azonenberg/latentpacket/README.md

# latentpacket
The LATENTPACKET network infrastructure platform
