azonenberg/latentpacket/latentpink/pcb/qdr-matching.ods

Sheet: Traces
Signal | Loc | Grp | Pkg Avg | Len Inner | Len Outer | V1-3 | V1-6 | V1-8 | Trace | Via | Total | Target | Skew | Tolerance | OK? | Target Inner | Target Outer
A0 | M20 | CA | 74.81 |  | 47.18 |  |  | 2 | 290.16 | 23.40 | 388.36 | 388.38 | -0.02 | 50.00 | Y | 47.18 | 47.18 | Max CA/D | 402.91
A1 | N20 | CA | 76.03 |  | 46.98 |  |  | 2 | 288.93 | 23.40 | 388.36 | 388.38 | -0.02 | 50.00 | Y | 46.98 | 46.98 | Max Q | 435.49
A10 | G20 | CA | 92.63 |  | 44.28 |  |  | 2 | 272.32 | 23.40 | 388.35 | 388.38 | -0.03 | 50.00 | Y | 44.28 | 44.28
A11 | H22 | CA | 96.02 |  | 47.54 |  |  |  | 292.37 | 0.00 | 388.39 | 388.38 | 0.01 | 50.00 | Y | 47.54 | 47.54 | Min CA/D | 379.97
A12 | G21 | CA | 98.68 |  | 43.37 |  |  | 2 | 266.73 | 23.40 | 388.81 | 388.38 | 0.43 | 50.00 | Y | 43.31 | 43.30 | Min Q | 411.64
A13 | E21 | CA | 103.40 |  | 42.55 |  |  | 2 | 261.68 | 23.40 | 388.48 | 388.38 | 0.10 | 50.00 | Y | 42.53 | 42.53
A14 | F20 | CA | 104.35 |  | 41.66 |  |  | 2 | 256.21 | 23.40 | 383.95 | 388.38 | -4.43 | 50.00 | Y | 42.33 | 42.38 | Mid CA/D | 391.44
A15 | E22 | CA | 109.89 |  | 41.36 |  |  | 2 | 254.36 | 23.40 | 387.66 | 388.38 | -0.72 | 50.00 | Y | 41.47 | 41.48 | Mid Q | 409.03
A16 | F21 | CA | 98.40 |  | 43.38 |  |  | 2 | 266.79 | 23.40 | 388.59 | 388.38 | 0.21 | 50.00 | Y | 43.35 | 43.35
A17 | G22 | CA | 102.04 |  | 46.56 |  |  |  | 286.34 | 0.00 | 388.39 | 388.38 | 0.01 | 50.00 | Y | 46.56 | 46.56 | Target CA | 388.38
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
Q7 | Y21 | Q | 108.06 |  | 50.82 |  |  |  | 312.54 | 0.00 | 420.60 | 420.61 | -0.01 | 15.00 | Y | 50.82 | 50.82
Q8 | AA20 | Q | 115.01 |  | 49.69 |  |  |  | 305.59 | 0.00 | 420.60 | 420.61 | -0.01 | 15.00 | Y | 49.69 | 49.69
Q9 | A19 | Q | 116.06 | 43.87 |  | 2 |  |  | 289.54 | 15.00 | 420.60 | 420.61 | -0.01 | 15.00 | Y | 43.87 | 43.87
QVLD | H20 | Q | 83.67 |  | 50.97 |  |  | 2 | 313.47 | 23.40 | 420.53 | 420.61 | -0.08 | 15.00 | Y | 50.98 | 50.98

Sheet: Constants
Outer ps/mm | 6.15
Inner ps/mm | 6.60
V1-3 ps | 7.50
V1-6 ps | 11.10
V1-8 ps | 11.70
V3-6 ps
V3-8 ps | 11.10
V6-8 ps | 7.50
CA tolerance | 50.00
DQ tolerance | 15.00
