azonenberg/latentpacket/latentred/doc/area-budgeting.ods

Block | Count | LUT | FF | BRAM | Total LUT | Total FF | Total BRAM | Notes | Resource | Used | Avail | Utilization
MACAddressTable | 1 | 1751 | 1186 | 32 | 1751 | 1186 | 32 |  | LUT | 87132 | 101400 | 85.93%
Ethernet2TypeDecoder | 28 | 94 | 461 | 0 | 2632 | 12908 | 0 |  | FF | 61559 | 202800 | 30.35%
SGMIIToGMIIBridge | 24 | 373 | 381 | 0 | 8952 | 9144 | 0 | No CDR logic included, assumes RX clock | BRAM | 256 | 325 | 78.77%
TriSpeedEthernetMAC | 24 | 761 | 505 | 0 | 18264 | 12120 | 0 | Lots of LUTs used in tx_fifo, can this be fixed?
XGEthernetMAC | 4 | 713 | 334 | 0 | 2852 | 1336 | 0 | Might need updating
XGEthernetPCS | 4 | 446 | 503 | 0 | 1784 | 2012 | 0 | Might need updating
RxFifo (1G BRAM based) | 24 | 232 | 637 | 6 | 5568 | 15288 | 144 | Will be converted to use QDR-II+ in the future
RxFIFO (1G QDR based) | 1 |  |  |  | 0 | 0 | 0
RxFifo (10G) | 4 | 241 | 665 | 20 | 964 | 2660 | 80
SwitchFabric | 1 | 44352 | 4675 | 0 | 44352 | 4675 | 0
QDR2PController | 1 | 13 | 230 | 0 | 13 | 230 | 0
