azonenberg/latentpacket/(threads)

Thread 2 (2019-08-18):

Add LEDs to the line card

mjgerm, 2019-08-18:
LEDs could be used for activity/link lights, vlan indicators, service/patch panel indicators, and more.  Adding a row of 8x RGB LEDs to the bottom of the line card

The SX1509 chip has LED drivers, as discussed, and supports blinking/breathing effects.

The Wurth Electronics 155124M173200 is a good side-mounted LED, which could be placed right on the edge of the board, mitigating the need for light-pipes.

mjgerm, 2019-08-18:
For 8x RGB LEDs, we need 24 pins, which means at least 2 16x GPIO expanders.
Therefore, there's 8 spares - might want to attach these to the PHYs RESET pins.

Note that not all IO pins on the SX1509 are created equal, only half support the "breathing" effect.
