azonenberg/latentpacket/latentpink/pcb/latentpink.kicad_pcb

## KiCad design latentpink/pcb/latentpink.kicad_pcb (2023-06-05)

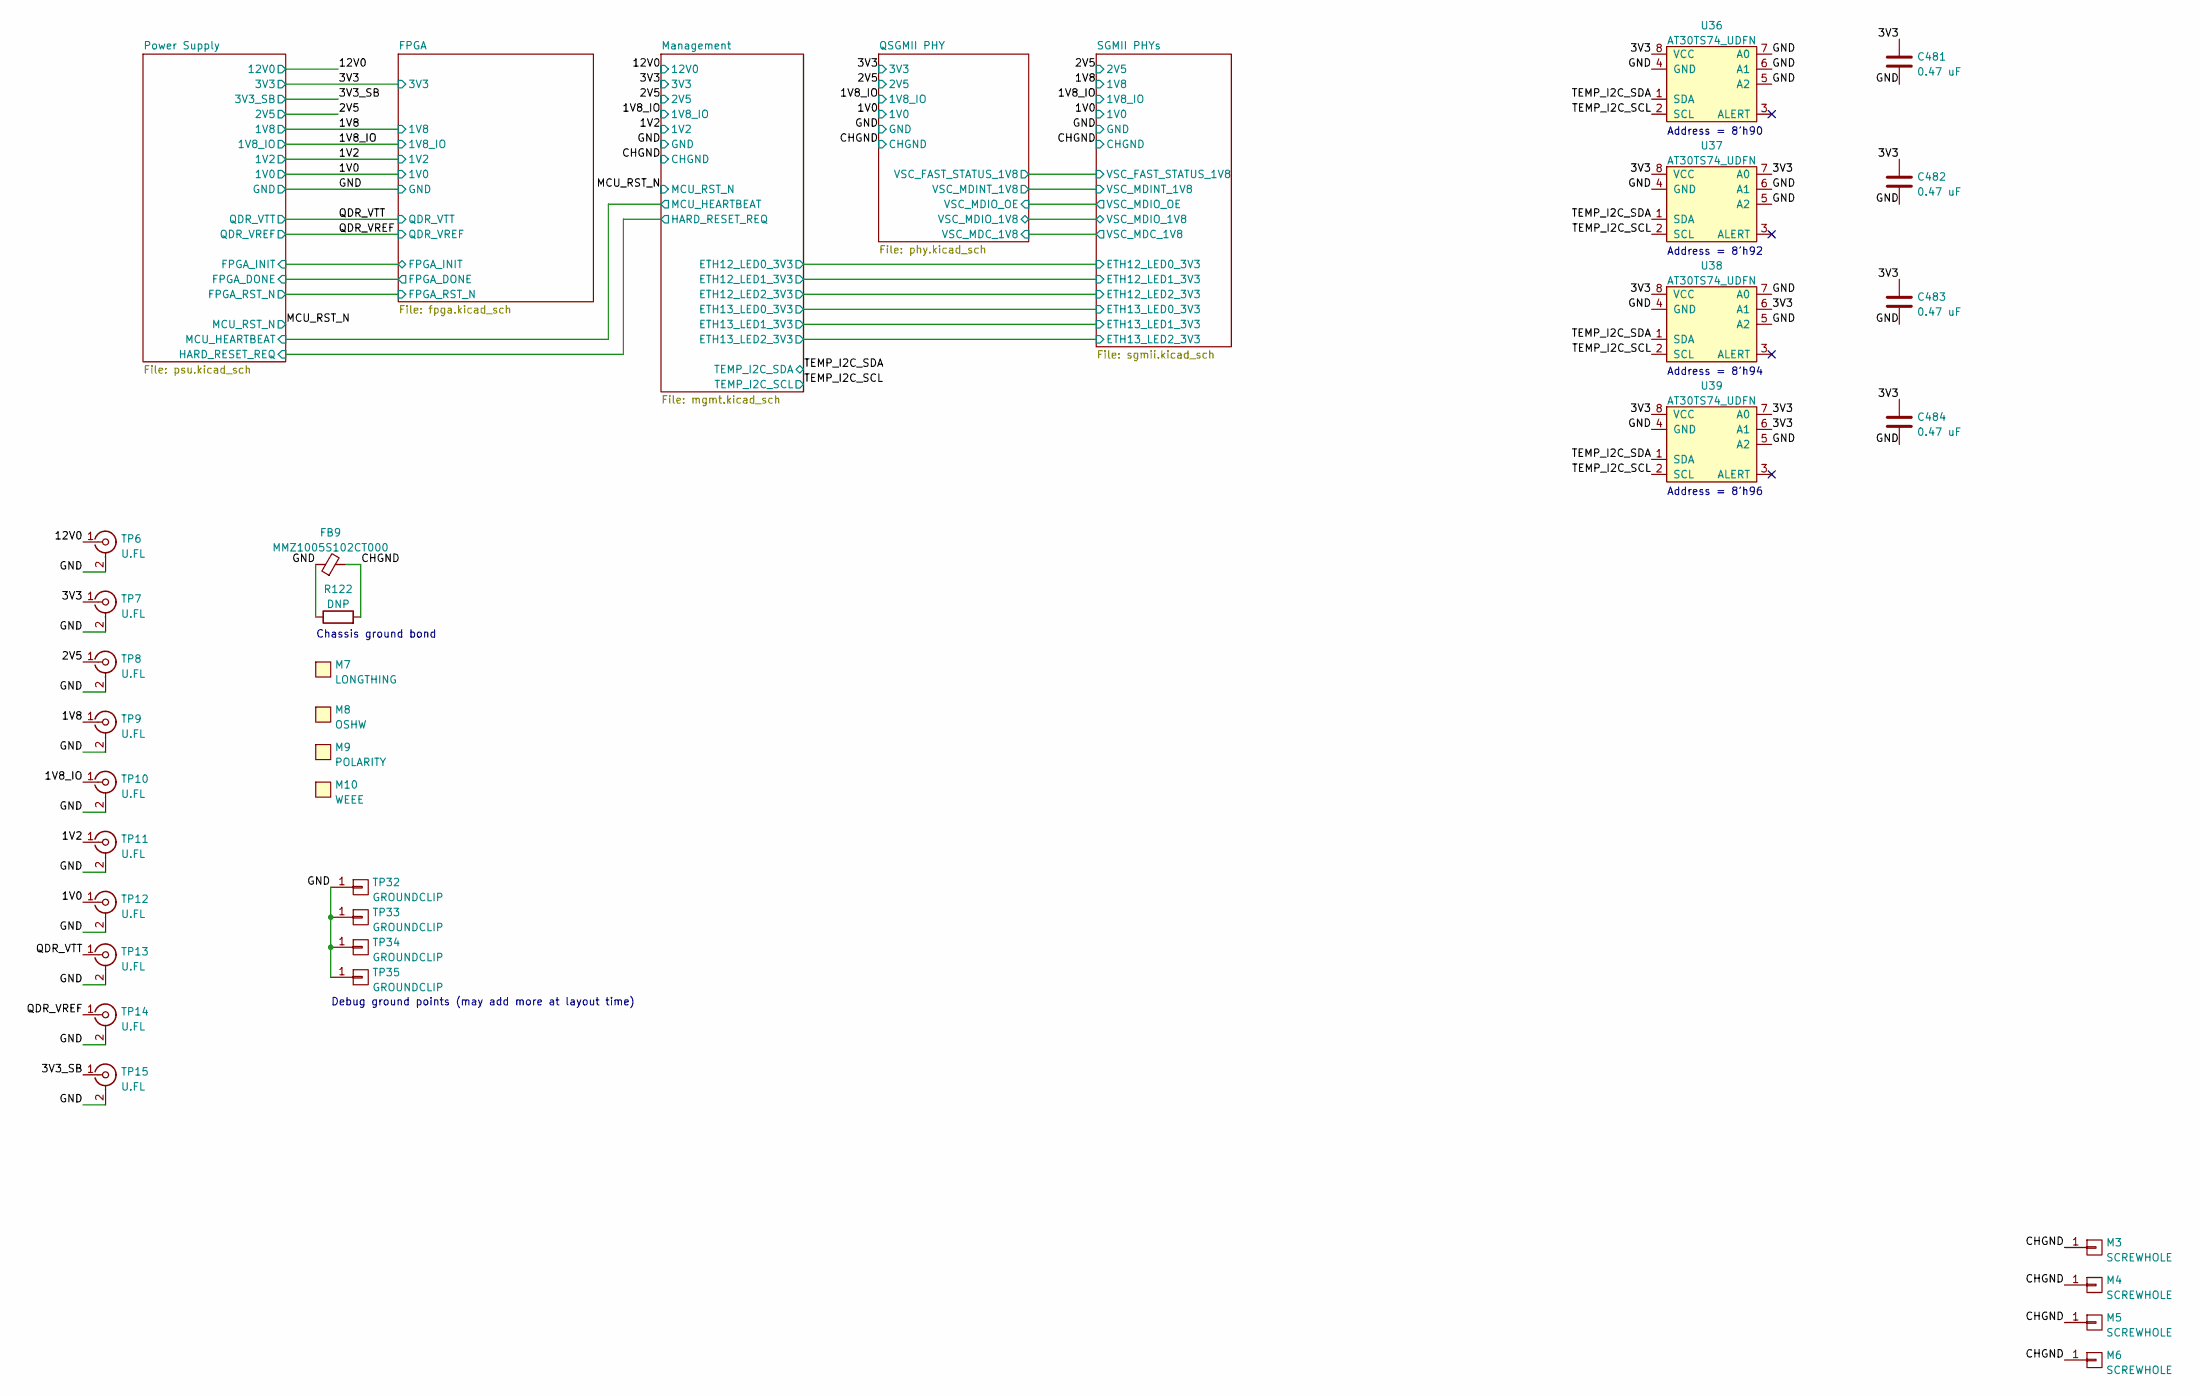
[picture p1: schematic latentpink.kicad_sch, LATENTPINK - Top Level]

Parts:
C481, C482, C483, C484: 0.47 uF; EIA_0402_CAP_NOSILK
FB9: MMZ1005S102CT000; EIA_0402_CAP_NOSILK
M3, M4, M5, M6: SCREWHOLE; MECHANICAL_CLEARANCEHOLE_4_40
M7: LONGTHING; LONGTHING-1200DPI
M8: OSHW; Logo_silk_OSHW_6x6mm
M9: POLARITY; Logo_silk_polarity_center_5x1.4mm
M10: WEEE; Logo_silk_WEEE_3.4x5mm
R122: DNP; EIA_1206_CAP_NOSILK
TP6, TP7, TP8, TP9, TP10, TP11, TP12, TP13, TP14, TP15: U.FL; CONN_U.FL_TE_1909763-1
TP32, TP33, TP34, TP35: GROUNDCLIP; TESTPOINT_SMT_KEYSTONE_5016
U36, U37, U38, U39: AT30TS74_UDFN; DFN_8_0.5MM_2x3MM_TALL

Connections:
/1V0: TP12.1 (In); also elsewhere on the board
/1V2: TP11.1 (In); also elsewhere on the board
/1V8: TP9.1 (In); also elsewhere on the board
/1V8_IO: TP10.1 (In); also elsewhere on the board
/2V5: TP8.1 (In); also elsewhere on the board
/3V3: C481.1, C482.1, C483.1, C484.1, TP7.1 (In), U36.8 (VCC), U37.7 (A0), U37.8 (VCC), U38.6 (A1), U38.8 (VCC), U39.6 (A1), U39.7 (A0), U39.8 (VCC); also elsewhere on the board
/3V3_SB: TP15.1 (In); also elsewhere on the board
/12V0: TP6.1 (In); also elsewhere on the board
/CHGND: FB9.2, M3.1, M4.1, M5.1, M6.1, R122.2; also elsewhere on the board
/GND: C481.2, C482.2, C483.2, C484.2, FB9.1, R122.1, TP6.2 (Ext), TP7.2 (Ext), TP8.2 (Ext), TP9.2 (Ext), TP10.2 (Ext), TP11.2 (Ext), TP12.2 (Ext), TP13.2 (Ext), TP14.2 (Ext), TP15.2 (Ext), TP32.1, TP33.1, TP34.1, TP35.1, U36.4 (GND), U36.5 (A2), U36.6 (A1), U36.7 (A0), U37.4 (GND), U37.5 (A2), U37.6 (A1), U38.4 (GND), U38.5 (A2), U38.7 (A0), U39.4 (GND), U39.5 (A2); also elsewhere on the board
/QDR_VREF: TP14.1 (In); also elsewhere on the board
/QDR_VTT: TP13.1 (In); also elsewhere on the board
/TEMP_I2C_SCL: U36.2 (SCL), U37.2 (SCL), U38.2 (SCL), U39.2 (SCL); also elsewhere on the board
/TEMP_I2C_SDA: U36.1 (SDA), U37.1 (SDA), U38.1 (SDA), U39.1 (SDA); also elsewhere on the board

Notes on the sheet:
Address = 8'h90
Chassis ground bond
Address = 8'h94
Address = 8'h92
Address = 8'h96
Debug ground points (may add more at layout time)

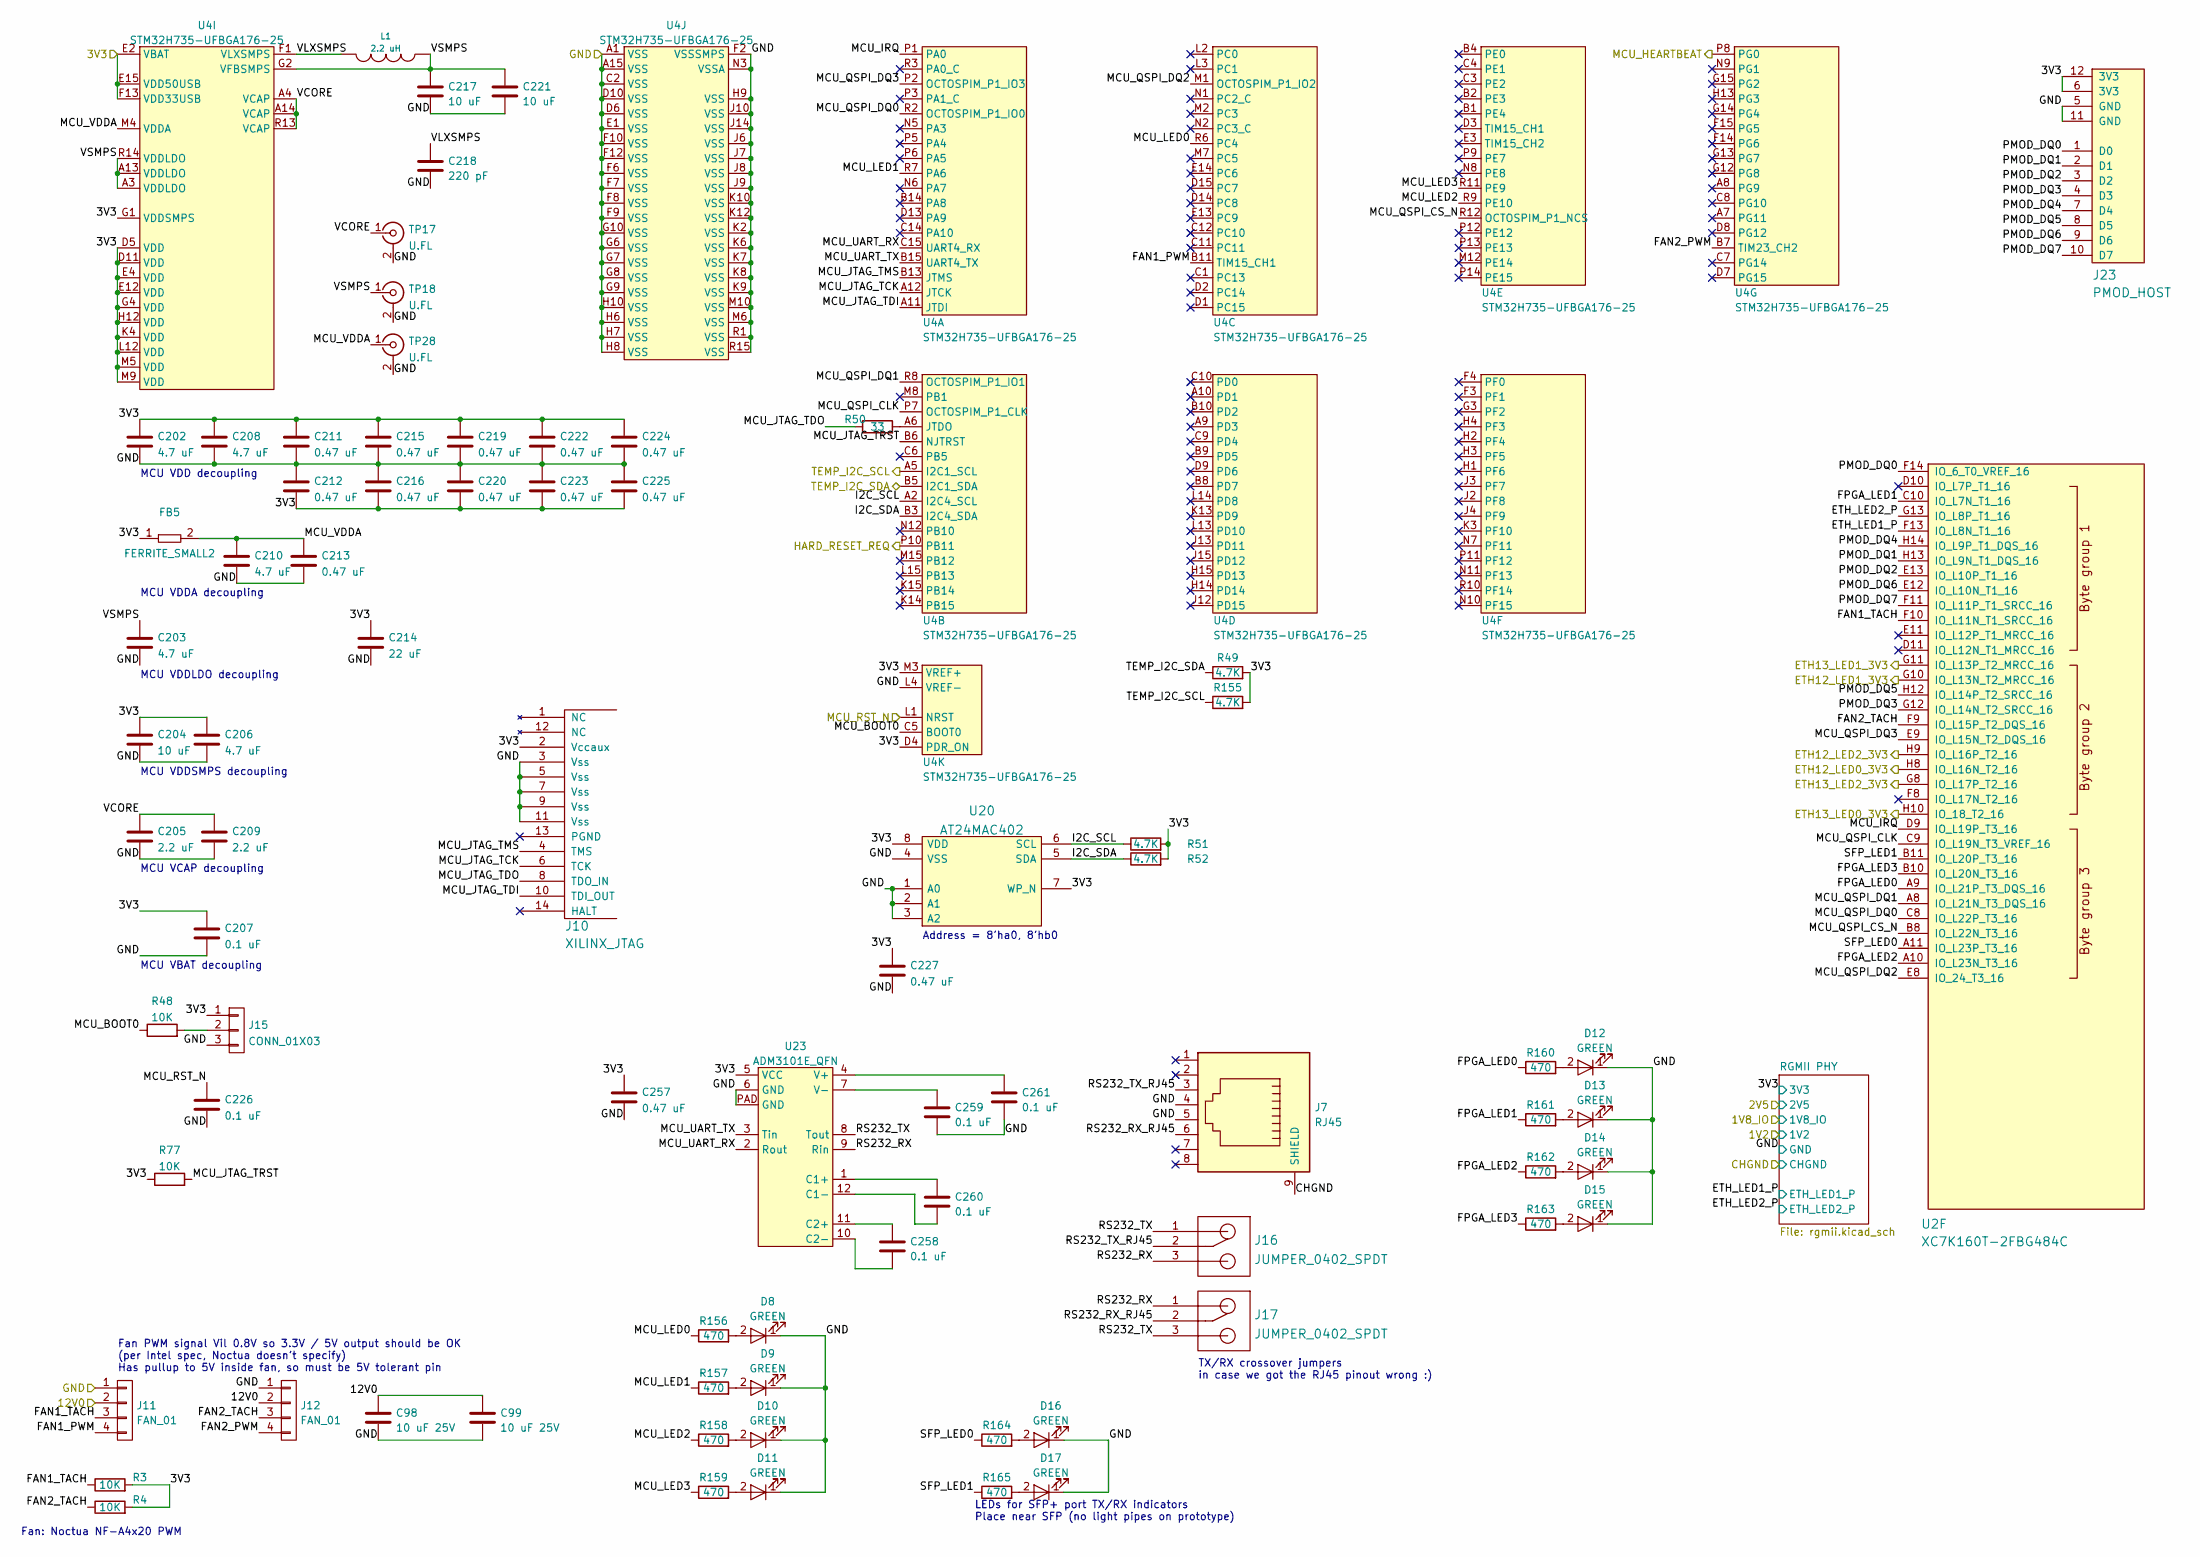
[picture p2: schematic mgmt.kicad_sch]

Parts:
C98, C99: 10 uF 25V; EIA_1210_CAP_NOSILK
C202, C203, C206, C208, C210: 4.7 uF; EIA_0603_CAP_NOSILK
C204, C217, C221: 10 uF; EIA_0805_CAP_NOSILK
C205, C209: 2.2 uF; EIA_0603_CAP_NOSILK
C207, C226, C258, C259, C260, C261: 0.1 uF; EIA_0402_CAP_NOSILK
C211, C212, C213, C215, C216, C219, C220, C222, C223, C224, C225, C227, C257: 0.47 uF; EIA_0402_CAP_NOSILK
C214: 22 uF; EIA_1206_CAP_NOSILK
C218: 220 pF; EIA_0402_CAP_NOSILK
D8, D9, D10, D11, D12, D13, D14, D15, D16, D17: GREEN; EIA_0603_LED
FB5: FERRITE_SMALL2; EIA_0603_INDUCTOR_NOSILK
J7: RJ45; CONN_RJ45_BELSTEWART_SS-7188S-A-PG4-1-BA-xx
J10: XILINX_JTAG; XILINX_JTAG_PTH_MOLEX_0878311420
J11, J12: FAN_01; CONN_MOLEX_KK_0470531000
J15: CONN_01X03; CONN_HEADER_2.54MM_1x3
J16, J17: JUMPER_0402_SPDT; EIA_0402_JUMPER
J23: PMOD_HOST; CONN_HEADER_2.54MM_2x6_RA_PMOD_HOST
L1: 2.2 uH; EIA_1210_CAP_NOSILK
R3, R4, R48, R77: 10K; EIA_0402_RES_NOSILK
R49, R51, R52, R155: 4.7K; EIA_0402_RES_NOSILK
R50: 33; EIA_0402_RES_NOSILK
R156, R157, R158, R159, R160, R161, R162, R163, R164, R165: 470; EIA_0402_RES_NOSILK
TP17, TP18, TP28: U.FL; CONN_U.FL_TE_1909763-1
U2: XC7K160T-2FBG484C; BGA_484_22x22_FULLARRAY_1MM
U4: STM32H735-UFBGA176-25; BGA_201_10x10_DEPOP_0.65MM_OSHPARK
U20: AT24MAC402; DFN_8_0.5MM_2x3MM_TALL
U23: ADM3101E_QFN; QFN_12_0.5MM_3x3MM

Connections:
/3V3: C202.1, C204.1, C206.1, C207.1, C208.1, C211.1, C212.2, C214.1, C215.1, C216.2, C219.1, C220.2, C222.1, C223.2, C224.1, C225.2, C227.1, C257.1, FB5.1, J10.2 (Vccaux), J15.1, J23.6 (3V3), J23.12 (3V3), R3.2, R4.2, R49.2, R51.2, R52.2, R77.1, R155.2, U4.D4 (PDR_ON), U4.D5 (VDD), U4.D11 (VDD), U4.E2 (VBAT), U4.E4 (VDD), U4.E12 (VDD), U4.E15 (VDD50USB), U4.F13 (VDD33USB), U4.G1 (VDDSMPS), U4.G4 (VDD), U4.H12 (VDD), U4.K4 (VDD), U4.L12 (VDD), U4.M3 (VREF+), U4.M5 (VDD), U4.M9 (VDD), U20.7 (WP_N), U20.8 (VDD), U23.5 (VCC); also elsewhere on the board
/12V0: C98.1, C99.1, J11.2, J12.2; also elsewhere on the board
/CHGND: J7.9 (SHIELD); also elsewhere on the board
/GND: C98.2, C99.2, C202.2, C203.2, C204.2, C205.2, C206.2, C207.2, C208.2, C209.2, C210.2, C211.2, C212.1, C213.2, C214.2, C215.2, C216.1, C217.2, C218.2, C219.2, C220.1, C221.2, C222.2, C223.1, C224.2, C225.1, C226.2, C227.2, C257.2, C259.2, C261.2, D8.1 (K), D9.1 (K), D10.1 (K), D11.1 (K), D12.1 (K), D13.1 (K), D14.1 (K), D15.1 (K), D16.1 (K), D17.1 (K), J7.4, J7.5, J10.3 (Vss), J10.5 (Vss), J10.7 (Vss), J10.9 (Vss), J10.11 (Vss), J11.1, J12.1, J15.3, J23.5 (GND), J23.11 (GND), TP17.2 (Ext), TP18.2 (Ext), TP28.2 (Ext), U4.A1 (VSS), U4.A15 (VSS), U4.C2 (VSS), U4.D6 (VSS), U4.D10 (VSS), U4.E1 (VSS), U4.F2 (VSSSMPS), U4.F6 (VSS), U4.F7 (VSS), U4.F8 (VSS), U4.F9 (VSS), U4.F10 (VSS), U4.F12 (VSS), U4.G6 (VSS), U4.G7 (VSS), U4.G8 (VSS), U4.G9 (VSS), U4.G10 (VSS), U4.H6 (VSS), U4.H7 (VSS), U4.H8 (VSS), U4.H9 (VSS), U4.H10 (VSS), U4.J6 (VSS), U4.J7 (VSS), U4.J8 (VSS), U4.J9 (VSS), U4.J10 (VSS), U4.J14 (VSS), U4.K2 (VSS), U4.K6 (VSS), U4.K7 (VSS), U4.K8 (VSS), U4.K9 (VSS), U4.K10 (VSS), U4.K12 (VSS), U4.L4 (VREF-), U4.M6 (VSS), U4.M10 (VSS), U4.N3 (VSSA), U4.R1 (VSS), U4.R15 (VSS), U20.1 (A0), U20.2 (A1), U20.3 (A2), U20.4 (VSS), U23.6 (GND), U23.PAD (GND); also elsewhere on the board
/MCU_RST_N: C226.1, U4.L1 (NRST); also elsewhere on the board
/Management/ETH12_LED0_3V3: U2.H8 (IO_L16N_T2_16); also elsewhere on the board
/Management/ETH12_LED1_3V3: U2.G10 (IO_L13N_T2_MRCC_16); also elsewhere on the board
/Management/ETH12_LED2_3V3: U2.H9 (IO_L16P_T2_16); also elsewhere on the board
/Management/ETH13_LED0_3V3: U2.H10 (IO_18_T2_16); also elsewhere on the board
/Management/ETH13_LED1_3V3: U2.G11 (IO_L13P_T2_MRCC_16); also elsewhere on the board
/Management/ETH13_LED2_3V3: U2.G8 (IO_L17P_T2_16); also elsewhere on the board
/Management/ETH_LED1_P: U2.F13 (IO_L8N_T1_16); also elsewhere on the board
/Management/ETH_LED2_P: U2.G13 (IO_L8P_T1_16); also elsewhere on the board
/Management/FAN1_PWM: J11.4, U4.B11 (TIM15_CH1)
/Management/FAN1_TACH: J11.3, R3.1, U2.F10 (IO_L11N_T1_SRCC_16)
/Management/FAN2_PWM: J12.4, U4.B7 (TIM23_CH2)
/Management/FAN2_TACH: J12.3, R4.1, U2.F9 (IO_L15P_T2_DQS_16)
/Management/FPGA_LED0: R160.1, U2.A9 (IO_L21P_T3_DQS_16)
/Management/FPGA_LED1: R161.1, U2.C10 (IO_L7N_T1_16)
/Management/FPGA_LED2: R162.1, U2.A10 (IO_L23N_T3_16)
/Management/FPGA_LED3: R163.1, U2.B10 (IO_L20N_T3_16)
/Management/HARD_RESET_REQ: U4.P10 (PB11); also elsewhere on the board
/Management/I2C_SCL: R51.1, U4.A2 (I2C4_SCL), U20.6 (SCL)
/Management/I2C_SDA: R52.1, U4.B3 (I2C4_SDA), U20.5 (SDA)
/Management/MCU_BOOT0: R48.1, U4.C5 (BOOT0)
/Management/MCU_HEARTBEAT: U4.P8 (PG0); also elsewhere on the board
/Management/MCU_IRQ: U2.D9 (IO_L19P_T3_16), U4.P1 (PA0)
/Management/MCU_JTAG_TCK: J10.6 (TCK), U4.A12 (JTCK)
/Management/MCU_JTAG_TDI: J10.10 (TDI_OUT), U4.A11 (JTDI)
/Management/MCU_JTAG_TDO: J10.8 (TDO_IN), R50.1
/Management/MCU_JTAG_TMS: J10.4 (TMS), U4.B13 (JTMS)
/Management/MCU_JTAG_TRST: R77.2, U4.B6 (NJTRST)
/Management/MCU_LED0: R156.1, U4.R6 (PC4)
/Management/MCU_LED1: R157.1, U4.R7 (PA6)
/Management/MCU_LED2: R158.1, U4.R9 (PE10)
/Management/MCU_LED3: R159.1, U4.R11 (PE9)
/Management/MCU_QSPI_CLK: U2.C9 (IO_L19N_T3_VREF_16), U4.P7 (OCTOSPIM_P1_CLK)
/Management/MCU_QSPI_CS_N: U2.B8 (IO_L22N_T3_16), U4.R12 (OCTOSPIM_P1_NCS)
/Management/MCU_QSPI_DQ0: U2.C8 (IO_L22P_T3_16), U4.R2 (OCTOSPIM_P1_IO0)
/Management/MCU_QSPI_DQ1: U2.A8 (IO_L21N_T3_DQS_16), U4.R8 (OCTOSPIM_P1_IO1)
/Management/MCU_QSPI_DQ2: U2.E8 (IO_24_T3_16), U4.M1 (OCTOSPIM_P1_IO2)
/Management/MCU_QSPI_DQ3: U2.E9 (IO_L15N_T2_DQS_16), U4.P2 (OCTOSPIM_P1_IO3)
/Management/MCU_UART_RX: U4.C15 (UART4_RX), U23.2 (Rout)
/Management/MCU_UART_TX: U4.B15 (UART4_TX), U23.3 (Tin)
/Management/MCU_VDDA: C210.1, C213.1, FB5.2, TP28.1 (In), U4.M4 (VDDA)
/Management/PMOD_DQ0: J23.1 (D0), U2.F14 (IO_6_T0_VREF_16)
/Management/PMOD_DQ1: J23.2 (D1), U2.H13 (IO_L9N_T1_DQS_16)
/Management/PMOD_DQ2: J23.3 (D2), U2.E13 (IO_L10P_T1_16)
/Management/PMOD_DQ3: J23.4 (D3), U2.G12 (IO_L14N_T2_SRCC_16)
/Management/PMOD_DQ4: J23.7 (D4), U2.H14 (IO_L9P_T1_DQS_16)
/Management/PMOD_DQ5: J23.8 (D5), U2.H12 (IO_L14P_T2_SRCC_16)
/Management/PMOD_DQ6: J23.9 (D6), U2.E12 (IO_L10N_T1_16)
/Management/PMOD_DQ7: J23.10 (D7), U2.F11 (IO_L11P_T1_SRCC_16)
/Management/RS232_RX: J16.3, J17.1, U23.9 (Rin)
/Management/RS232_RX_RJ45: J7.6, J17.2
/Management/RS232_TX: J16.1, J17.3, U23.8 (Tout)
/Management/RS232_TX_RJ45: J7.3, J16.2
/Management/SFP_LED0: R164.1, U2.A11 (IO_L23P_T3_16)
/Management/SFP_LED1: R165.1, U2.B11 (IO_L20P_T3_16)
/Management/VCORE: C205.1, C209.1, TP17.1 (In), U4.A4 (VCAP), U4.A14 (VCAP), U4.R13 (VCAP)
/Management/VLXSMPS: C218.1, L1.2, U4.F1 (VLXSMPS)
/Management/VSMPS: C203.1, C217.1, C221.1, L1.1, TP18.1 (In), U4.A3 (VDDLDO), U4.A13 (VDDLDO), U4.G2 (VFBSMPS), U4.R14 (VDDLDO)
/TEMP_I2C_SCL: R155.1, U4.A5 (I2C1_SCL); also elsewhere on the board
/TEMP_I2C_SDA: R49.1, U4.B5 (I2C1_SDA); also elsewhere on the board
unnamed: C258.1, U23.11 (C2+)
unnamed: C258.2, U23.10 (C2-)
unnamed: C259.1, U23.7 (V-)
unnamed: C260.1, U23.1 (C1+)
unnamed: C260.2, U23.12 (C1-)
unnamed: C261.1, U23.4 (V+)
unnamed: D8.2 (A), R156.2
unnamed: D9.2 (A), R157.2
unnamed: D10.2 (A), R158.2
unnamed: D11.2 (A), R159.2
unnamed: D12.2 (A), R160.2
unnamed: D13.2 (A), R161.2
unnamed: D14.2 (A), R162.2
unnamed: D15.2 (A), R163.2
unnamed: D16.2 (A), R164.2
unnamed: D17.2 (A), R165.2
unnamed: J15.2, R48.2
unnamed: R50.2, U4.A6 (JTDO)

Notes on the sheet:
Address = 8'ha0, 8'hb0
MCU VDD decoupling
MCU VDDA decoupling
Fan: Noctua NF-A4x20 PWM
MCU VDDLDO decoupling
TX/RX crossover jumpers in case we got the RJ45 pinout wrong :)
Fan PWM signal Vil 0.8V so 3.3V / 5V output should be OK (per Intel spec, Noctua doesn't specify) Has pullup to 5V inside fan, so must be 5V tolerant pin
LEDs for SFP+ port TX/RX indicators Place near SFP (no light pipes on prototype)
MCU VCAP decoupling
MCU VBAT decoupling
MCU VDDSMPS decoupling

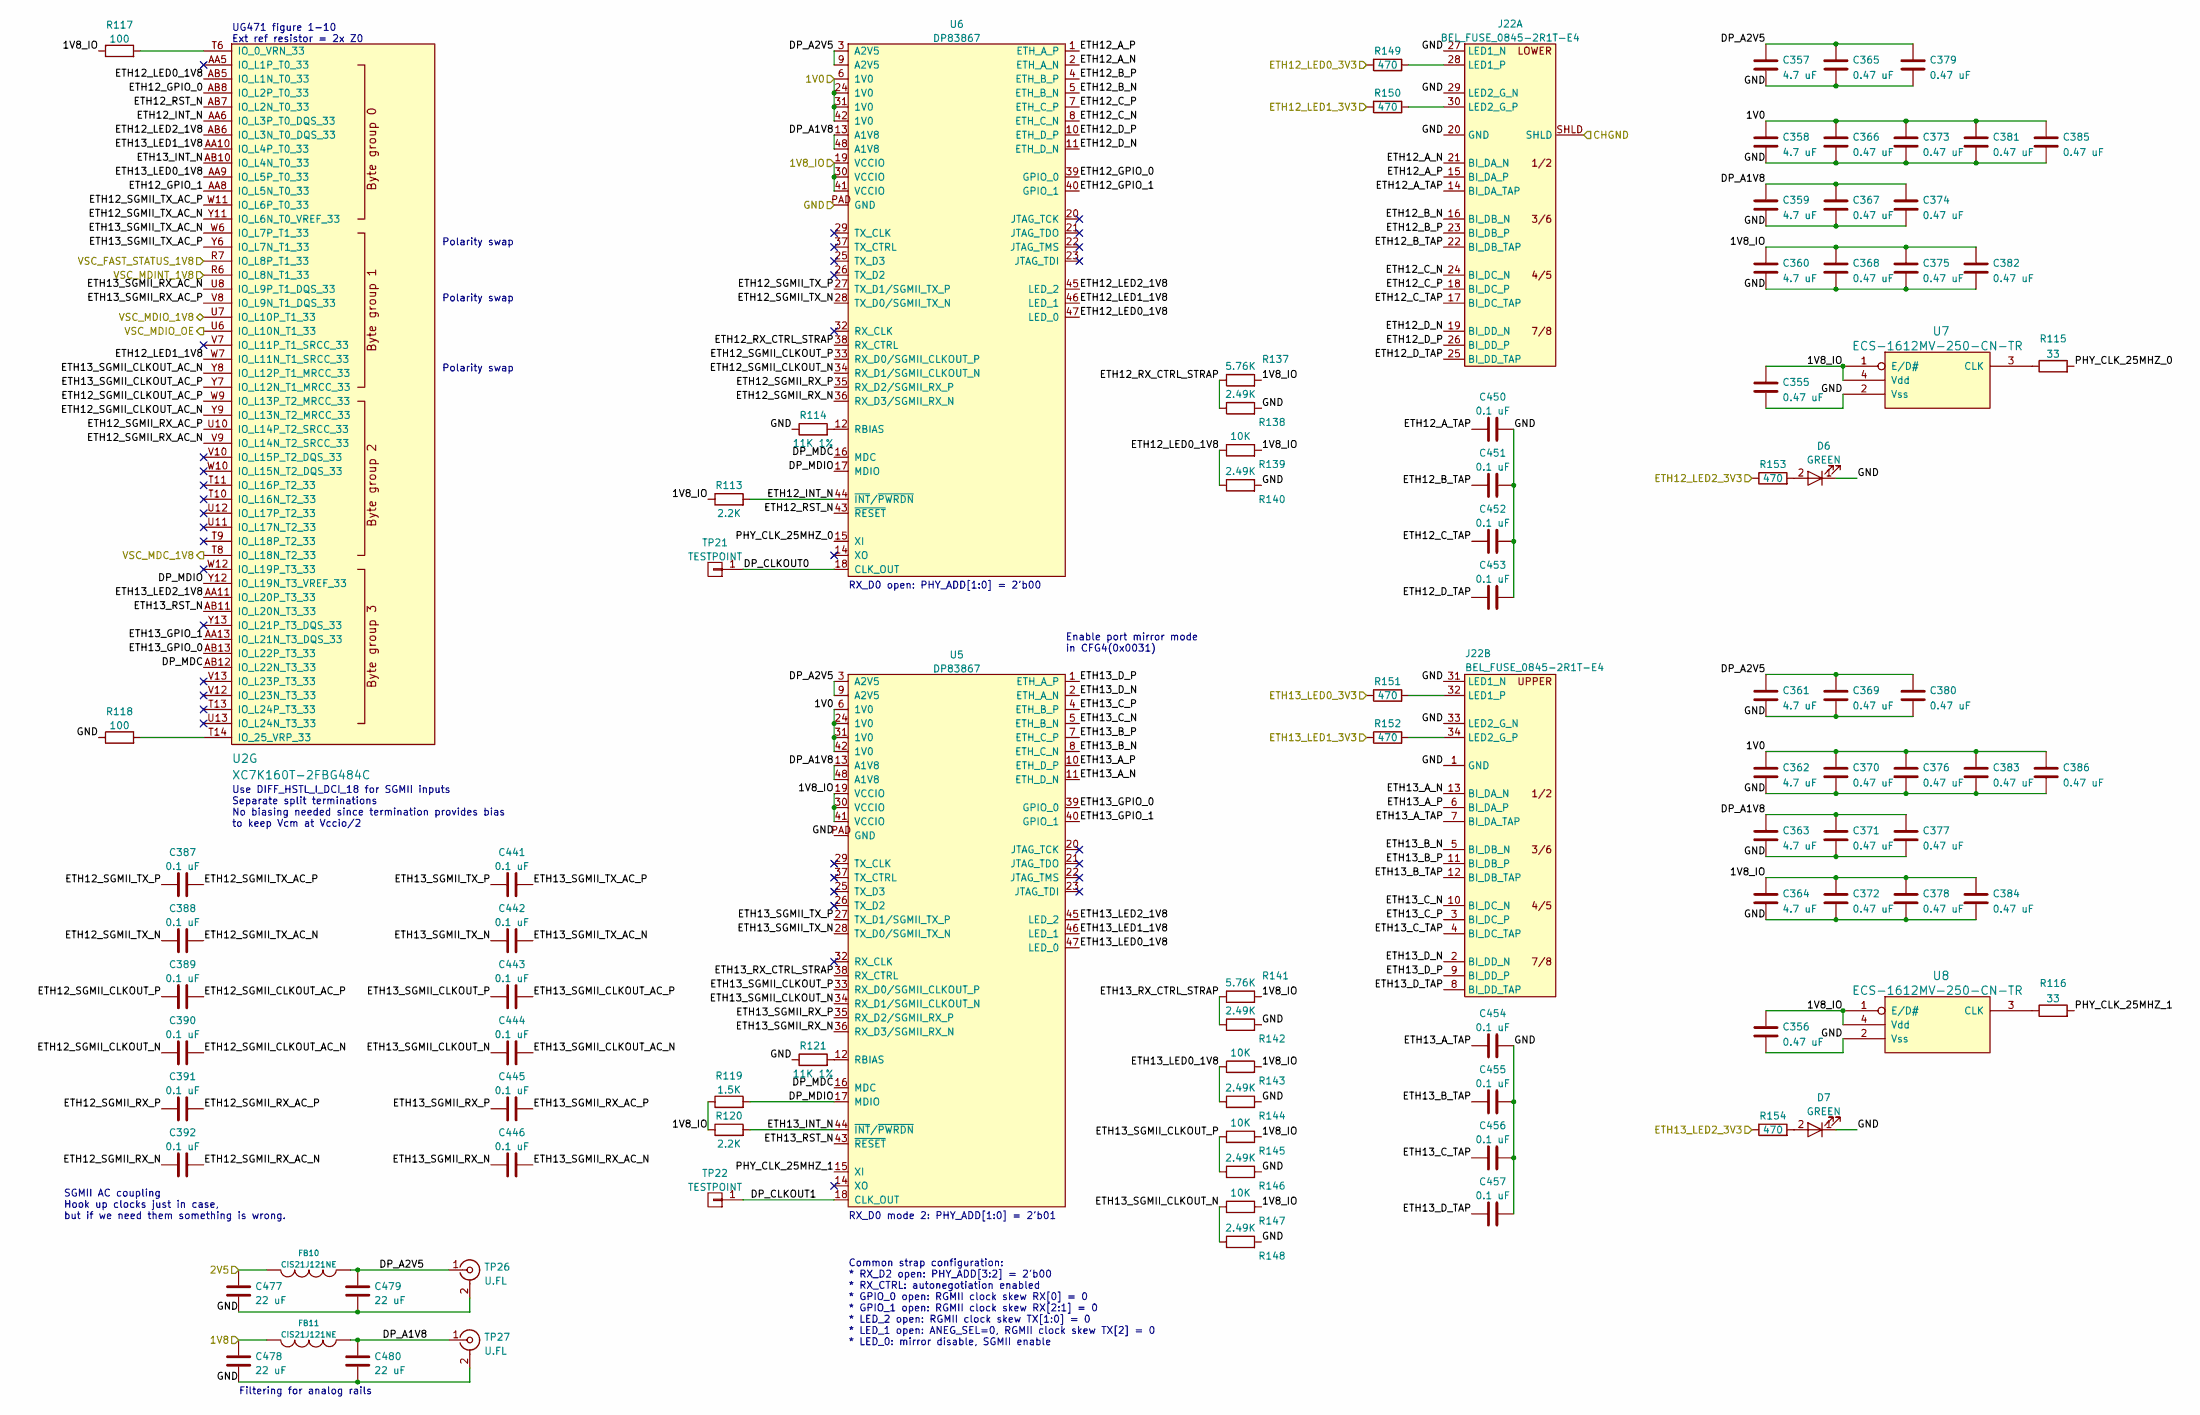
[picture p3: schematic sgmii.kicad_sch]

Parts:
C355, C356, C365, C366, C367, C368, C369, C370, C371, C372, C373, C374, C375, C376, C377, C378, C379, C380, C381, C382, C383, C384, C385, C386: 0.47 uF; EIA_0402_CAP_NOSILK
C357, C358, C359, C360, C361, C362, C363, C364: 4.7 uF; EIA_0603_CAP_NOSILK
C387, C388, C389, C390, C391, C392, C441, C442, C443, C444, C445, C446, C450, C451, C452, C453, C454, C455, C456, C457: 0.1 uF; EIA_0402_CAP_NOSILK
C477, C478, C479, C480: 22 uF; EIA_1206_CAP_NOSILK
D6, D7: GREEN; EIA_0603_LED
FB10, FB11: CIS21J121NE; EIA_0805_INDUCTOR_NOSILK
J22: BEL_FUSE_0845-2R1T-E4; CONN_RJ45_BELFUSE_0845-2R1T-E4
R113, R120: 2.2K; EIA_0402_RES_NOSILK
R114, R121: 11K 1%; EIA_0402_RES_NOSILK
R115, R116: 33; EIA_0402_RES_NOSILK
R117, R118: 100; EIA_0402_RES_NOSILK
R119: 1.5K; EIA_0402_RES_NOSILK
R137, R141: 5.76K; EIA_0402_RES_NOSILK
R138, R140, R142, R144, R146, R148: 2.49K; EIA_0402_RES_NOSILK
R139, R143, R145, R147: 10K; EIA_0402_RES_NOSILK
R149, R150, R151, R152, R153, R154: 470; EIA_0402_RES_NOSILK
TP21, TP22: TESTPOINT; TESTPOINT_SMT_0.5MM
TP26, TP27: U.FL; CONN_U.FL_TE_1909763-1
U2: XC7K160T-2FBG484C; BGA_484_22x22_FULLARRAY_1MM
U5, U6: DP83867; QFN_48_0.5MM_7x7MM
U7, U8: ECS-1612MV-250-CN-TR; OSCILLATOR_1.6x1.2

Connections:
/1V0: C358.1, C362.1, C366.1, C370.1, C373.1, C376.1, C381.1, C383.1, C385.1, C386.1, U5.6 (1V0), U5.24 (1V0), U5.31 (1V0), U5.42 (1V0), U6.6 (1V0), U6.24 (1V0), U6.31 (1V0), U6.42 (1V0); also elsewhere on the board
/1V8: C478.1, FB11.2; also elsewhere on the board
/1V8_IO: C355.1, C356.1, C360.1, C364.1, C368.1, C372.1, C375.1, C378.1, C382.1, C384.1, R113.1, R117.1, R119.1, R120.1, R137.2, R139.2, R141.2, R143.2, R145.2, R147.2, U5.19 (VCCIO), U5.30 (VCCIO), U5.41 (VCCIO), U6.19 (VCCIO), U6.30 (VCCIO), U6.41 (VCCIO), U7.1 (E/D#), U7.4 (Vdd), U8.1 (E/D#), U8.4 (Vdd); also elsewhere on the board
/2V5: C477.1, FB10.2; also elsewhere on the board
/CHGND: J22.SHLD; also elsewhere on the board
/GND: C355.2, C356.2, C357.2, C358.2, C359.2, C360.2, C361.2, C362.2, C363.2, C364.2, C365.2, C366.2, C367.2, C368.2, C369.2, C370.2, C371.2, C372.2, C373.2, C374.2, C375.2, C376.2, C377.2, C378.2, C379.2, C380.2, C381.2, C382.2, C383.2, C384.2, C385.2, C386.2, C450.2, C451.2, C452.2, C453.2, C454.2, C455.2, C456.2, C457.2, C477.2, C478.2, C479.2, C480.2, D6.1 (K), D7.1 (K), J22.1 (GND), J22.20 (GND), J22.27 (LED1_N), J22.29 (LED2_G_N), J22.31 (LED1_N), J22.33 (LED2_G_N), R114.1, R118.1, R121.1, R138.2, R140.2, R142.2, R144.2, R146.2, R148.2, TP26.2 (Ext), TP27.2 (Ext), U5.PAD (GND), U6.PAD (GND), U7.2 (Vss), U8.2 (Vss); also elsewhere on the board
/Management/ETH12_LED0_3V3: R149.1; also elsewhere on the board
/Management/ETH12_LED1_3V3: R150.1; also elsewhere on the board
/Management/ETH12_LED2_3V3: R153.1; also elsewhere on the board
/Management/ETH13_LED0_3V3: R151.1; also elsewhere on the board
/Management/ETH13_LED1_3V3: R152.1; also elsewhere on the board
/Management/ETH13_LED2_3V3: R154.1; also elsewhere on the board
/QSGMII PHY/VSC_FAST_STATUS_1V8: U2.R7 (IO_L8P_T1_33); also elsewhere on the board
/QSGMII PHY/VSC_MDC_1V8: U2.T8 (IO_L18N_T2_33); also elsewhere on the board
/QSGMII PHY/VSC_MDINT_1V8: U2.R6 (IO_L8N_T1_33); also elsewhere on the board
/QSGMII PHY/VSC_MDIO_1V8: U2.U7 (IO_L10P_T1_33); also elsewhere on the board
/QSGMII PHY/VSC_MDIO_OE: U2.U6 (IO_L10N_T1_33); also elsewhere on the board
/SGMII PHYs/DP_A1V8: C359.1, C363.1, C367.1, C371.1, C374.1, C377.1, C480.1, FB11.1, TP27.1 (In), U5.13 (A1V8), U5.48 (A1V8), U6.13 (A1V8), U6.48 (A1V8)
/SGMII PHYs/DP_A2V5: C357.1, C361.1, C365.1, C369.1, C379.1, C380.1, C479.1, FB10.1, TP26.1 (In), U5.3 (A2V5), U5.9 (A2V5), U6.3 (A2V5), U6.9 (A2V5)
/SGMII PHYs/DP_CLKOUT0: TP21.1, U6.18 (CLK_OUT)
/SGMII PHYs/DP_CLKOUT1: TP22.1, U5.18 (CLK_OUT)
/SGMII PHYs/DP_MDC: U2.AB12 (IO_L22N_T3_33), U5.16 (MDC), U6.16 (MDC)
/SGMII PHYs/DP_MDIO: R119.2, U2.Y12 (IO_L19N_T3_VREF_33), U5.17 (MDIO), U6.17 (MDIO)
/SGMII PHYs/ETH12_A_N: J22.21 (BI_DA_N), U6.2 (ETH_A_N)
/SGMII PHYs/ETH12_A_P: J22.15 (BI_DA_P), U6.1 (ETH_A_P)
/SGMII PHYs/ETH12_A_TAP: C450.1, J22.14 (BI_DA_TAP)
/SGMII PHYs/ETH12_B_N: J22.16 (BI_DB_N), U6.5 (ETH_B_N)
/SGMII PHYs/ETH12_B_P: J22.23 (BI_DB_P), U6.4 (ETH_B_P)
/SGMII PHYs/ETH12_B_TAP: C451.1, J22.22 (BI_DB_TAP)
/SGMII PHYs/ETH12_C_N: J22.24 (BI_DC_N), U6.8 (ETH_C_N)
/SGMII PHYs/ETH12_C_P: J22.18 (BI_DC_P), U6.7 (ETH_C_P)
/SGMII PHYs/ETH12_C_TAP: C452.1, J22.17 (BI_DC_TAP)
/SGMII PHYs/ETH12_D_N: J22.19 (BI_DD_N), U6.11 (ETH_D_N)
/SGMII PHYs/ETH12_D_P: J22.26 (BI_DD_P), U6.10 (ETH_D_P)
/SGMII PHYs/ETH12_D_TAP: C453.1, J22.25 (BI_DD_TAP)
/SGMII PHYs/ETH12_GPIO_0: U2.AB8 (IO_L2P_T0_33), U6.39 (GPIO_0)
/SGMII PHYs/ETH12_GPIO_1: U2.AA8 (IO_L5N_T0_33), U6.40 (GPIO_1)
/SGMII PHYs/ETH12_INT_N: R113.2, U2.AA6 (IO_L3P_T0_DQS_33), U6.44 (~INT/~PWRDN)
/SGMII PHYs/ETH12_LED0_1V8: R139.1, R140.1, U2.AB5 (IO_L1N_T0_33), U6.47 (LED_0)
/SGMII PHYs/ETH12_LED1_1V8: U2.W7 (IO_L11N_T1_SRCC_33), U6.46 (LED_1)
/SGMII PHYs/ETH12_LED2_1V8: U2.AB6 (IO_L3N_T0_DQS_33), U6.45 (LED_2)
/SGMII PHYs/ETH12_RST_N: U2.AB7 (IO_L2N_T0_33), U6.43 (~RESET)
/SGMII PHYs/ETH12_RX_CTRL_STRAP: R137.1, R138.1, U6.38 (RX_CTRL)
/SGMII PHYs/ETH12_SGMII_CLKOUT_AC_N: C390.2, U2.Y9 (IO_L13N_T2_MRCC_33)
/SGMII PHYs/ETH12_SGMII_CLKOUT_AC_P: C389.2, U2.W9 (IO_L13P_T2_MRCC_33)
/SGMII PHYs/ETH12_SGMII_CLKOUT_N: C390.1, U6.34 (RX_D1/SGMII_CLKOUT_N)
/SGMII PHYs/ETH12_SGMII_CLKOUT_P: C389.1, U6.33 (RX_D0/SGMII_CLKOUT_P)
/SGMII PHYs/ETH12_SGMII_RX_AC_N: C392.2, U2.V9 (IO_L14N_T2_SRCC_33)
/SGMII PHYs/ETH12_SGMII_RX_AC_P: C391.2, U2.U10 (IO_L14P_T2_SRCC_33)
/SGMII PHYs/ETH12_SGMII_RX_N: C392.1, U6.36 (RX_D3/SGMII_RX_N)
/SGMII PHYs/ETH12_SGMII_RX_P: C391.1, U6.35 (RX_D2/SGMII_RX_P)
/SGMII PHYs/ETH12_SGMII_TX_AC_N: C388.2, U2.Y11 (IO_L6N_T0_VREF_33)
/SGMII PHYs/ETH12_SGMII_TX_AC_P: C387.2, U2.W11 (IO_L6P_T0_33)
/SGMII PHYs/ETH12_SGMII_TX_N: C388.1, U6.28 (TX_D0/SGMII_TX_N)
/SGMII PHYs/ETH12_SGMII_TX_P: C387.1, U6.27 (TX_D1/SGMII_TX_P)
/SGMII PHYs/ETH13_A_N: J22.13 (BI_DA_N), U5.11 (ETH_D_N)
/SGMII PHYs/ETH13_A_P: J22.6 (BI_DA_P), U5.10 (ETH_D_P)
/SGMII PHYs/ETH13_A_TAP: C454.1, J22.7 (BI_DA_TAP)
/SGMII PHYs/ETH13_B_N: J22.5 (BI_DB_N), U5.8 (ETH_C_N)
/SGMII PHYs/ETH13_B_P: J22.11 (BI_DB_P), U5.7 (ETH_C_P)
/SGMII PHYs/ETH13_B_TAP: C455.1, J22.12 (BI_DB_TAP)
/SGMII PHYs/ETH13_C_N: J22.10 (BI_DC_N), U5.5 (ETH_B_N)
/SGMII PHYs/ETH13_C_P: J22.3 (BI_DC_P), U5.4 (ETH_B_P)
/SGMII PHYs/ETH13_C_TAP: C456.1, J22.4 (BI_DC_TAP)
/SGMII PHYs/ETH13_D_N: J22.2 (BI_DD_N), U5.2 (ETH_A_N)
/SGMII PHYs/ETH13_D_P: J22.9 (BI_DD_P), U5.1 (ETH_A_P)
/SGMII PHYs/ETH13_D_TAP: C457.1, J22.8 (BI_DD_TAP)
/SGMII PHYs/ETH13_GPIO_0: U2.AB13 (IO_L22P_T3_33), U5.39 (GPIO_0)
/SGMII PHYs/ETH13_GPIO_1: U2.AA13 (IO_L21N_T3_DQS_33), U5.40 (GPIO_1)
/SGMII PHYs/ETH13_INT_N: R120.2, U2.AB10 (IO_L4N_T0_33), U5.44 (~INT/~PWRDN)
/SGMII PHYs/ETH13_LED0_1V8: R143.1, R144.1, U2.AA9 (IO_L5P_T0_33), U5.47 (LED_0)
/SGMII PHYs/ETH13_LED1_1V8: U2.AA10 (IO_L4P_T0_33), U5.46 (LED_1)
/SGMII PHYs/ETH13_LED2_1V8: U2.AA11 (IO_L20P_T3_33), U5.45 (LED_2)
/SGMII PHYs/ETH13_RST_N: U2.AB11 (IO_L20N_T3_33), U5.43 (~RESET)
/SGMII PHYs/ETH13_RX_CTRL_STRAP: R141.1, R142.1, U5.38 (RX_CTRL)
/SGMII PHYs/ETH13_SGMII_CLKOUT_AC_N: C444.2, U2.Y8 (IO_L12P_T1_MRCC_33)
/SGMII PHYs/ETH13_SGMII_CLKOUT_AC_P: C443.2, U2.Y7 (IO_L12N_T1_MRCC_33)
/SGMII PHYs/ETH13_SGMII_CLKOUT_N: C444.1, R147.1, R148.1, U5.34 (RX_D1/SGMII_CLKOUT_N)
/SGMII PHYs/ETH13_SGMII_CLKOUT_P: C443.1, R145.1, R146.1, U5.33 (RX_D0/SGMII_CLKOUT_P)
/SGMII PHYs/ETH13_SGMII_RX_AC_N: C446.2, U2.U8 (IO_L9P_T1_DQS_33)
/SGMII PHYs/ETH13_SGMII_RX_AC_P: C445.2, U2.V8 (IO_L9N_T1_DQS_33)
/SGMII PHYs/ETH13_SGMII_RX_N: C446.1, U5.36 (RX_D3/SGMII_RX_N)
/SGMII PHYs/ETH13_SGMII_RX_P: C445.1, U5.35 (RX_D2/SGMII_RX_P)
/SGMII PHYs/ETH13_SGMII_TX_AC_N: C442.2, U2.W6 (IO_L7P_T1_33)
/SGMII PHYs/ETH13_SGMII_TX_AC_P: C441.2, U2.Y6 (IO_L7N_T1_33)
/SGMII PHYs/ETH13_SGMII_TX_N: C442.1, U5.28 (TX_D0/SGMII_TX_N)
/SGMII PHYs/ETH13_SGMII_TX_P: C441.1, U5.27 (TX_D1/SGMII_TX_P)
/SGMII PHYs/PHY_CLK_25MHZ_0: R115.2, U6.15 (XI)
/SGMII PHYs/PHY_CLK_25MHZ_1: R116.2, U5.15 (XI)
unnamed: D6.2 (A), R153.2
unnamed: D7.2 (A), R154.2
unnamed: J22.28 (LED1_P), R149.2
unnamed: J22.30 (LED2_G_P), R150.2
unnamed: J22.32 (LED1_P), R151.2
unnamed: J22.34 (LED2_G_P), R152.2
unnamed: R115.1, U7.3 (CLK)
unnamed: R116.1, U8.3 (CLK)
unnamed: R117.2, U2.T6 (IO_0_VRN_33)
unnamed: R118.2, U2.T14 (IO_25_VRP_33)
unnamed: R121.2, U5.12 (RBIAS)
unnamed: R114.2, U6.12 (RBIAS)

Notes on the sheet:
Polarity swap
RX_D0 open: PHY_ADD[1:0] = 2'b00
Common strap configuration: * RX_D2 open: PHY_ADD[3:2] = 2'b00 * RX_CTRL: autonegotiation enabled * GPIO_0 open: RGMII clock skew RX[0] = 0 * GPIO_1 open: RGMII clock skew RX[2:1] = 0 * LED_2 open: RGMII clock skew TX[1:0] = 0 * LED_1 open: ANEG_SEL=0, RGMII clock skew TX[2] = 0 * LED_0: mirror dis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
Filtering for analog rails
SGMII AC coupling Hook up clocks just in case, but if we need them something is wrong.
Use DIFF_HSTL_I_DCI_18 for SGMII inputs Separate split terminations No biasing needed since termination provides bias to keep Vcm at Vccio/2
UG471 figure 1-10 Ext ref resistor = 2x Z0
Enable port mirror mode in CFG4(0x0031)
RX_D0 mode 2: PHY_ADD[1:0] = 2'b01
