azonenberg/latentpacket/latentpink/pcb/latentpink.kicad_pcb

## KiCad design latentpink/pcb/latentpink.kicad_pcb (continued)

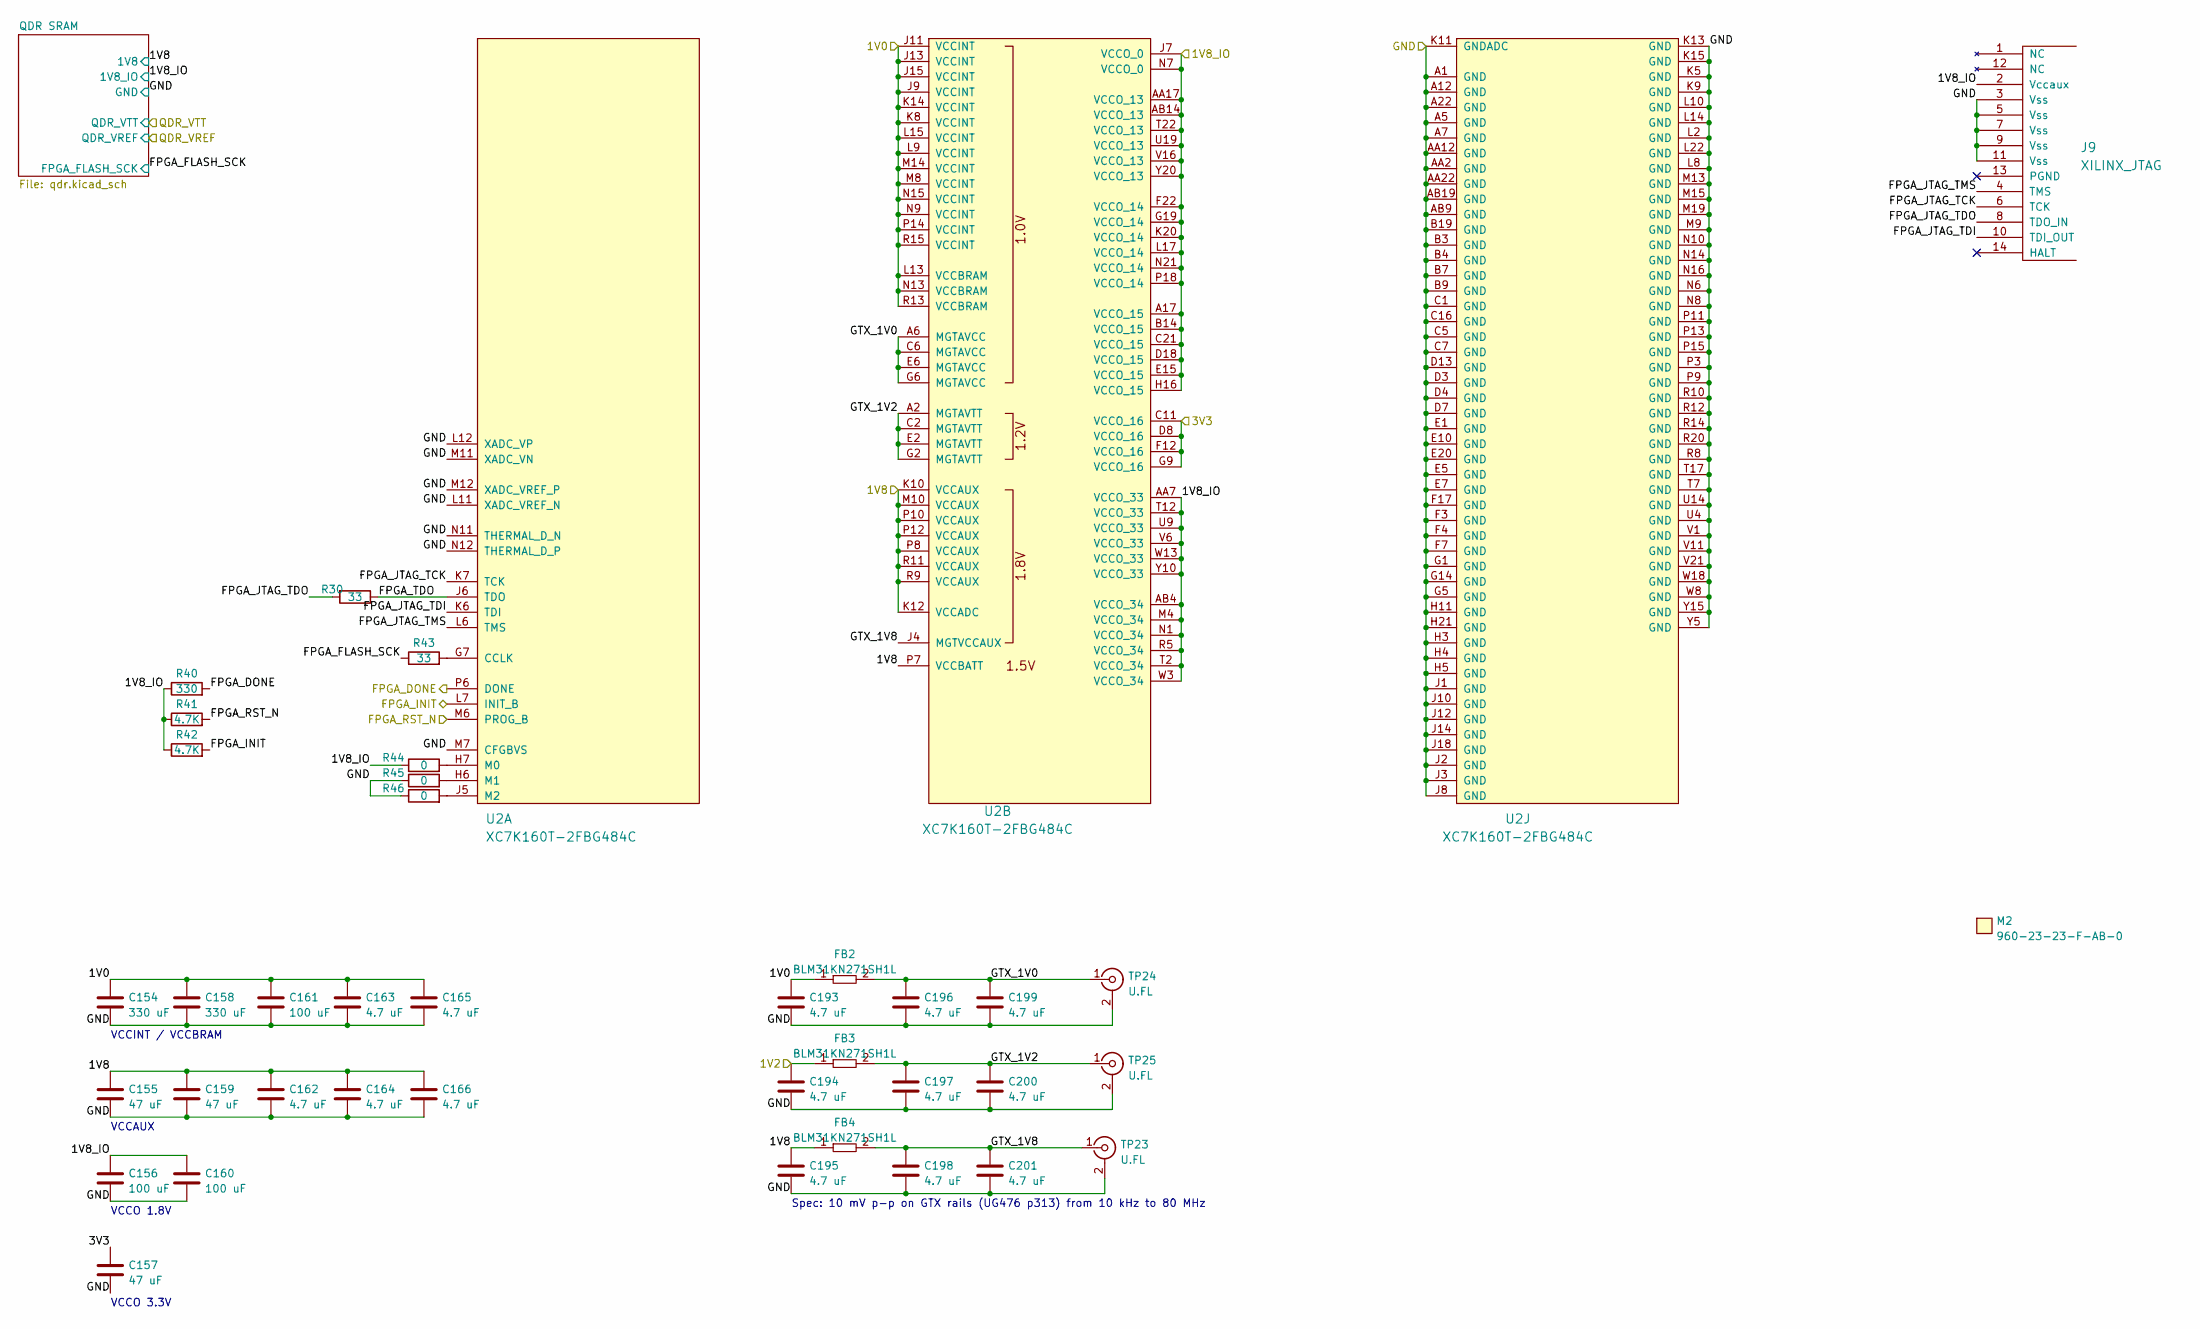
[picture p4: schematic fpga.kicad_sch]

Parts:
C154, C158: 330 uF; EIA_1210_CAP_NOSILK
C155, C157, C159: 47 uF; EIA_1210_CAP_NOSILK
C156, C160, C161: 100 uF; EIA_1206_CAP_NOSILK
C162, C163, C164, C165, C166, C193, C194, C195, C196, C197, C198, C199, C200, C201: 4.7 uF; EIA_0603_CAP_NOSILK
FB2, FB3, FB4: BLM31KN271SH1L; EIA_1206_CAP_NOSILK
J9: XILINX_JTAG; XILINX_JTAG_PTH_MOLEX_0878311420
M2: 960-23-23-F-AB-0; HEATSINK_WAKEFIELDVETTE_960-23-23-F-AB-0
R30, R43: 33; EIA_0402_RES_NOSILK
R40: 330; EIA_0402_RES_NOSILK
R41, R42: 4.7K; EIA_0402_RES_NOSILK
R44, R45, R46: 0; EIA_0402_RES_NOSILK
TP23, TP24, TP25: U.FL; CONN_U.FL_TE_1909763-1
U2: XC7K160T-2FBG484C; BGA_484_22x22_FULLARRAY_1MM

Connections:
/1V0: C154.1, C158.1, C161.1, C163.1, C165.1, C193.1, FB2.1, U2.J9 (VCCINT), U2.J11 (VCCINT), U2.J13 (VCCINT), U2.J15 (VCCINT), U2.K8 (VCCINT), U2.K14 (VCCINT), U2.L9 (VCCINT), U2.L13 (VCCBRAM), U2.L15 (VCCINT), U2.M8 (VCCINT), U2.M14 (VCCINT), U2.N9 (VCCINT), U2.N13 (VCCBRAM), U2.N15 (VCCINT), U2.P14 (VCCINT), U2.R13 (VCCBRAM), U2.R15 (VCCINT); also elsewhere on the board
/1V2: C194.1, FB3.1; also elsewhere on the board
/1V8: C155.1, C159.1, C162.1, C164.1, C166.1, C195.1, FB4.1, U2.K10 (VCCAUX), U2.K12 (VCCADC), U2.M10 (VCCAUX), U2.P7 (VCCBATT), U2.P8 (VCCAUX), U2.P10 (VCCAUX), U2.P12 (VCCAUX), U2.R9 (VCCAUX), U2.R11 (VCCAUX); also elsewhere on the board
/1V8_IO: C156.1, C160.1, J9.2 (Vccaux), R40.1, R41.1, R42.1, R44.1, U2.A17 (VCCO_15), U2.AA7 (VCCO_33), U2.AA17 (VCCO_13), U2.AB4 (VCCO_34), U2.AB14 (VCCO_13), U2.B14 (VCCO_15), U2.C21 (VCCO_15), U2.D18 (VCCO_15), U2.E15 (VCCO_15), U2.F22 (VCCO_14), U2.G19 (VCCO_14), U2.H16 (VCCO_15), U2.J7 (VCCO_0), U2.K20 (VCCO_14), U2.L17 (VCCO_14), U2.M4 (VCCO_34), U2.N1 (VCCO_34), U2.N7 (VCCO_0), U2.N21 (VCCO_14), U2.P18 (VCCO_14), U2.R5 (VCCO_34), U2.T2 (VCCO_34), U2.T12 (VCCO_33), U2.T22 (VCCO_13), U2.U9 (VCCO_33), U2.U19 (VCCO_13), U2.V6 (VCCO_33), U2.V16 (VCCO_13), U2.W3 (VCCO_34), U2.W13 (VCCO_33), U2.Y10 (VCCO_33), U2.Y20 (VCCO_13); also elsewhere on the board
/3V3: C157.1, U2.C11 (VCCO_16), U2.D8 (VCCO_16), U2.F12 (VCCO_16), U2.G9 (VCCO_16); also elsewhere on the board
/FPGA/FPGA_DONE: R40.2, U2.P6 (DONE); also elsewhere on the board
/FPGA/FPGA_FLASH_SCK: R43.1; also elsewhere on the board
/FPGA/FPGA_INIT: R42.2, U2.L7 (INIT_B); also elsewhere on the board
/FPGA/FPGA_JTAG_TCK: J9.6 (TCK), U2.K7 (TCK)
/FPGA/FPGA_JTAG_TDI: J9.10 (TDI_OUT), U2.K6 (TDI)
/FPGA/FPGA_JTAG_TDO: J9.8 (TDO_IN), R30.2
/FPGA/FPGA_JTAG_TMS: J9.4 (TMS), U2.L6 (TMS)
/FPGA/FPGA_RST_N: R41.2, U2.M6 (PROG_B); also elsewhere on the board
/FPGA/FPGA_TDO: R30.1, U2.J6 (TDO)
/FPGA/GTX_1V0: C196.1, C199.1, FB2.2, TP24.1 (In), U2.A6 (MGTAVCC), U2.C6 (MGTAVCC), U2.E6 (MGTAVCC), U2.G6 (MGTAVCC)
/FPGA/GTX_1V2: C197.1, C200.1, FB3.2, TP25.1 (In), U2.A2 (MGTAVTT), U2.C2 (MGTAVTT), U2.E2 (MGTAVTT), U2.G2 (MGTAVTT)
/FPGA/GTX_1V8: C198.1, C201.1, FB4.2, TP23.1 (In), U2.J4 (MGTVCCAUX)
/GND: C154.2, C155.2, C156.2, C157.2, C158.2, C159.2, C160.2, C161.2, C162.2, C163.2, C164.2, C165.2, C166.2, C193.2, C194.2, C195.2, C196.2, C197.2, C198.2, C199.2, C200.2, C201.2, J9.3 (Vss), J9.5 (Vss), J9.7 (Vss), J9.9 (Vss), J9.11 (Vss), R45.1, R46.1, TP23.2 (Ext), TP24.2 (Ext), TP25.2 (Ext), U2.A1 (GND), U2.A5 (GND), U2.A7 (GND), U2.A12 (GND), U2.A22 (GND), U2.AA2 (GND), U2.AA12 (GND), U2.AA22 (GND), U2.AB9 (GND), U2.AB19 (GND), U2.B3 (GND), U2.B4 (GND), U2.B7 (GND), U2.B9 (GND), U2.B19 (GND), U2.C1 (GND), U2.C5 (GND), U2.C7 (GND), U2.C16 (GND), U2.D3 (GND), U2.D4 (GND), U2.D7 (GND), U2.D13 (GND), U2.E1 (GND), U2.E5 (GND), U2.E7 (GND), U2.E10 (GND), U2.E20 (GND), U2.F3 (GND), U2.F4 (GND), U2.F7 (GND), U2.F17 (GND), U2.G1 (GND), U2.G5 (GND), U2.G14 (GND), U2.H3 (GND), U2.H4 (GND), U2.H5 (GND), U2.H11 (GND), U2.H21 (GND), U2.J1 (GND), U2.J2 (GND), U2.J3 (GND), U2.J8 (GND), U2.J10 (GND), U2.J12 (GND), U2.J14 (GND), U2.J18 (GND), U2.K5 (GND), U2.K9 (GND), U2.K11 (GNDADC), U2.K13 (GND), U2.K15 (GND), U2.L2 (GND), U2.L8 (GND), U2.L10 (GND), U2.L11 (XADC_VREF_N), U2.L12 (XADC_VP), U2.L14 (GND), U2.L22 (GND), U2.M7 (CFGBVS), U2.M9 (GND), U2.M11 (XADC_VN), U2.M12 (XADC_VREF_P), U2.M13 (GND), U2.M15 (GND), U2.M19 (GND), U2.N6 (GND), U2.N8 (GND), U2.N10 (GND), U2.N11 (THERMAL_D_N), U2.N12 (THERMAL_D_P), U2.N14 (GND), U2.N16 (GND), U2.P3 (GND), U2.P9 (GND), U2.P11 (GND), U2.P13 (GND), U2.P15 (GND), U2.R8 (GND), U2.R10 (GND), U2.R12 (GND), U2.R14 (GND), U2.R20 (GND), U2.T7 (GND), U2.T17 (GND), U2.U4 (GND), U2.U14 (GND), U2.V1 (GND), U2.V11 (GND), U2.V21 (GND), U2.W8 (GND), U2.W18 (GND), U2.Y5 (GND), U2.Y15 (GND); also elsewhere on the board
unnamed: R43.2, U2.G7 (CCLK)
unnamed: R44.2, U2.H7 (M0)
unnamed: R45.2, U2.H6 (M1)
unnamed: R46.2, U2.J5 (M2)

Notes on the sheet:
VCCO 1.8V
VCCO 3.3V
Spec: 10 mV p-p on GTX rails (UG476 p313) from 10 kHz to 80 MHz
VCCAUX
VCCINT / VCCBRAM

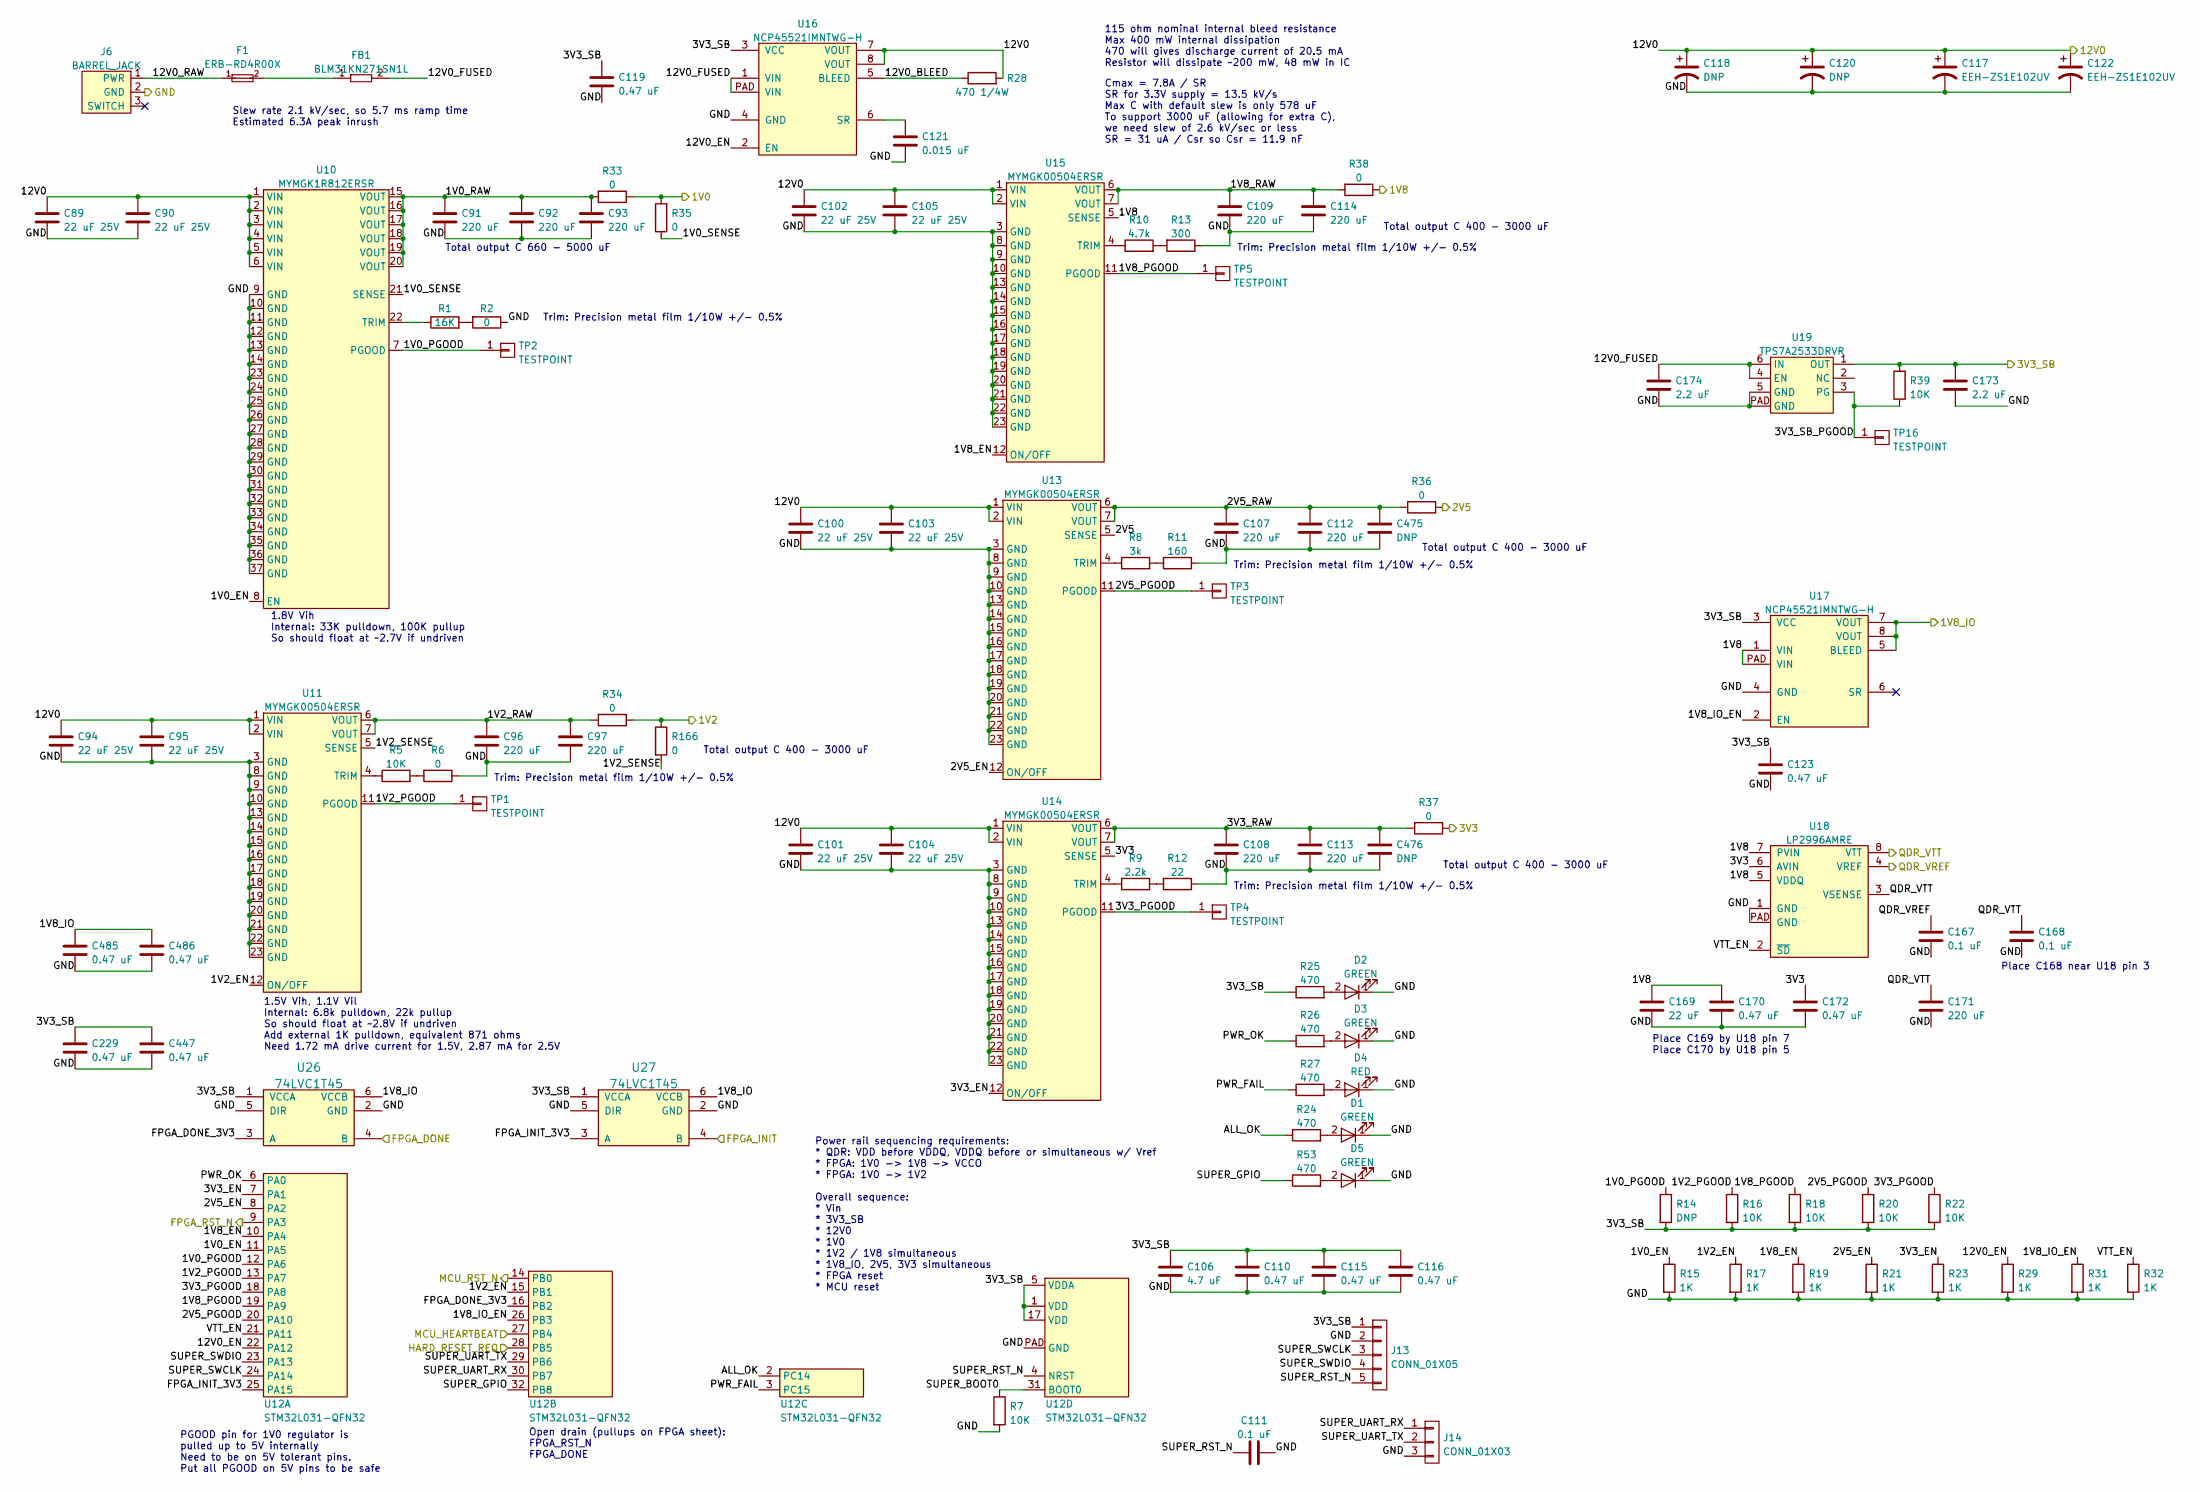
[picture p5: schematic psu.kicad_sch]

Parts:
C89, C90, C94, C95, C100, C101, C102, C103, C104, C105: 22 uF 25V; EIA_1812_CAP_NOSILK
C91, C92, C93, C96, C97, C107, C108, C109, C112, C113, C114, C171: 220 uF; EIA_1210_CAP_NOSILK
C106: 4.7 uF; EIA_0603_CAP_NOSILK
C110, C115, C116, C119, C123, C170, C172, C229, C447, C485, C486: 0.47 uF; EIA_0402_CAP_NOSILK
C111, C167, C168: 0.1 uF; EIA_0402_CAP_NOSILK
C117, C122: EEH-ZS1E102UV; CAP_AL_10MM_SMT
C118, C120: DNP; CAP_AL_10MM_SMT
C121: 0.015 uF; EIA_0603_CAP_NOSILK
C169: 22 uF; EIA_1206_CAP_NOSILK
C173, C174: 2.2 uF; EIA_0805_CAP_NOSILK
C475, C476: DNP; EIA_1210_CAP_NOSILK
D1, D2, D3, D5: GREEN; EIA_0603_LED
D4: RED; EIA_0603_LED
F1: ERB-RD4R00X; EIA_0402_CAP_NOSILK
FB1: BLM31KN271SN1L; EIA_1206_CAP_NOSILK
J6: BARREL_JACK; CONN_CUI_PJ-058BH_HIPWR_BARREL_NOSLOT
J13: CONN_01X05; CONN_HEADER_2.54MM_1x5
J14: CONN_01X03; CONN_HEADER_2.54MM_1x3
R1: 16K; EIA_0402_RES_NOSILK
R2, R6, R33, R34, R35, R36, R37, R38, R166: 0; EIA_0402_RES_NOSILK
R5, R7, R16, R18, R20, R22, R39: 10K; EIA_0402_RES_NOSILK
R8: 3k; EIA_0402_RES_NOSILK
R9: 2.2k; EIA_0402_RES_NOSILK
R10: 4.7k; EIA_0402_RES_NOSILK
R11: 160; EIA_0402_RES_NOSILK
R12: 22; EIA_0402_RES_NOSILK
R13: 300; EIA_0402_RES_NOSILK
R14: DNP; EIA_0402_RES_NOSILK
R15, R17, R19, R21, R23, R29, R31, R32: 1K; EIA_0402_RES_NOSILK
R24, R25, R26, R27, R53: 470; EIA_0402_RES_NOSILK
R28: 470 1/4W; EIA_0603_RES_NOSILK
TP1, TP2, TP3, TP4, TP5, TP16: TESTPOINT; TESTPOINT_SMT_0.5MM
U10: MYMGK1R812ERSR; MODULE_MURATA_MYMGK1R812
U11, U13, U14, U15: MYMGK00504ERSR; MODULE_MURATA_MYMGK00504ERSR
U12: STM32L031-QFN32; QFN_32_0.5MM_5x5MM
U16, U17: NCP45521IMNTWG-H; DFN_8_0.5MM_2x2MM
U18: LP2996AMRE; SOIC_8_3.9MM_EPAD
U19: TPS7A2533DRVR; DFN_6_0.65MM_2x2MM
U26, U27: 74LVC1T45; DFN_6_0.5MM_1.45x1.00MM

Connections:
/1V0: R33.1, R35.2; also elsewhere on the board
/1V2: R34.1, R166.1; also elsewhere on the board
/1V8: C169.1, C170.1, R38.1, U15.5 (SENSE), U17.1 (VIN), U17.PAD (VIN), U18.5 (VDDQ), U18.7 (PVIN); also elsewhere on the board
/1V8_IO: C485.1, C486.1, U17.5 (BLEED), U17.7 (VOUT), U17.8 (VOUT), U26.6 (VCCB), U27.6 (VCCB); also elsewhere on the board
/2V5: R36.1, U13.5 (SENSE); also elsewhere on the board
/3V3: C172.1, R37.1, U14.5 (SENSE), U18.6 (AVIN); also elsewhere on the board
/3V3_SB: C106.1, C110.1, C115.1, C116.1, C119.1, C123.1, C173.1, C229.1, C447.1, J13.1, R14.2, R16.2, R18.2, R20.2, R22.2, R25.1, R39.2, U12.1 (VDD), U12.5 (VDDA), U12.17 (VDD), U16.3 (VCC), U17.3 (VCC), U19.1 (OUT), U26.1 (VCCA), U27.1 (VCCA); also elsewhere on the board
/12V0: C89.1, C90.1, C94.1, C95.1, C100.1, C101.1, C102.1, C103.1, C104.1, C105.1, C117.1, C118.1, C120.1, C122.1, R28.2, U10.1 (VIN), U10.2 (VIN), U10.3 (VIN), U10.4 (VIN), U10.5 (VIN), U10.6 (VIN), U11.1 (VIN), U11.2 (VIN), U13.1 (VIN), U13.2 (VIN), U14.1 (VIN), U14.2 (VIN), U15.1 (VIN), U15.2 (VIN), U16.7 (VOUT), U16.8 (VOUT); also elsewhere on the board
/FPGA/FPGA_DONE: U26.4 (B); also elsewhere on the board
/FPGA/FPGA_INIT: U27.4 (B); also elsewhere on the board
/FPGA/FPGA_RST_N: U12.9 (PA3); also elsewhere on the board
/GND: C89.2, C90.2, C91.2, C92.2, C93.2, C94.2, C95.2, C96.2, C97.2, C100.2, C101.2, C102.2, C103.2, C104.2, C105.2, C106.2, C107.2, C108.2, C109.2, C110.2, C111.2, C112.2, C113.2, C114.2, C115.2, C116.2, C117.2, C118.2, C119.2, C120.2, C121.2, C122.2, C123.2, C167.2, C168.2, C169.2, C170.2, C171.2, C172.2, C173.2, C174.2, C229.2, C447.2, C475.2, C476.2, C485.2, C486.2, D1.1 (K), D2.1 (K), D3.1 (K), D4.1 (K), D5.1 (K), J6.2 (GND), J13.2, J14.3, R2.1, R6.1, R7.2, R11.1, R12.1, R13.1, R15.2, R17.2, R19.2, R21.2, R23.2, R29.2, R31.2, R32.2, U10.9 (GND), U10.10 (GND), U10.11 (GND), U10.12 (GND), U10.13 (GND), U10.14 (GND), U10.23 (GND), U10.24 (GND), U10.25 (GND), U10.26 (GND), U10.27 (GND), U10.28 (GND), U10.29 (GND), U10.30 (GND), U10.31 (GND), U10.32 (GND), U10.33 (GND), U10.34 (GND), U10.35 (GND), U10.36 (GND), U10.37 (GND), U11.3 (GND), U11.8 (GND), U11.9 (GND), U11.10 (GND), U11.13 (GND), U11.14 (GND), U11.15 (GND), U11.16 (GND), U11.17 (GND), U11.18 (GND), U11.19 (GND), U11.20 (GND), U11.21 (GND), U11.22 (GND), U11.23 (GND), U12.PAD (GND), U13.3 (GND), U13.8 (GND), U13.9 (GND), U13.10 (GND), U13.13 (GND), U13.14 (GND), U13.15 (GND), U13.16 (GND), U13.17 (GND), U13.18 (GND), U13.19 (GND), U13.20 (GND), U13.21 (GND), U13.22 (GND), U13.23 (GND), U14.3 (GND), U14.8 (GND), U14.9 (GND), U14.10 (GND), U14.13 (GND), U14.14 (GND), U14.15 (GND), U14.16 (GND), U14.17 (GND), U14.18 (GND), U14.19 (GND), U14.20 (GND), U14.21 (GND), U14.22 (GND), U14.23 (GND), U15.3 (GND), U15.8 (GND), U15.9 (GND), U15.10 (GND), U15.13 (GND), U15.14 (GND), U15.15 (GND), U15.16 (GND), U15.17 (GND), U15.18 (GND), U15.19 (GND), U15.20 (GND), U15.21 (GND), U15.22 (GND), U15.23 (GND), U16.4 (GND), U17.4 (GND), U18.1 (GND), U18.PAD (GND), U19.5 (GND), U19.PAD (GND), U26.2 (GND), U26.5 (DIR), U27.2 (GND), U27.5 (DIR); also elsewhere on the board
/MCU_RST_N: U12.14 (PB0); also elsewhere on the board
/Management/HARD_RESET_REQ: U12.28 (PB5); also elsewhere on the board
/Management/MCU_HEARTBEAT: U12.27 (PB4); also elsewhere on the board
/Power Supply/1V0_EN: R15.1, U10.8 (EN), U12.11 (PA5)
/Power Supply/1V0_PGOOD: R14.1, TP2.1, U10.7 (PGOOD), U12.12 (PA6)
/Power Supply/1V0_RAW: C91.1, C92.1, C93.1, R33.2, U10.15 (VOUT), U10.16 (VOUT), U10.17 (VOUT), U10.18 (VOUT), U10.19 (VOUT), U10.20 (VOUT)
/Power Supply/1V0_SENSE: R35.1, U10.21 (SENSE)
/Power Supply/1V2_EN: R17.1, U11.12 (ON/OFF), U12.15 (PB1)
/Power Supply/1V2_PGOOD: R16.1, TP1.1, U11.11 (PGOOD), U12.13 (PA7)
/Power Supply/1V2_RAW: C96.1, C97.1, R34.2, U11.6 (VOUT), U11.7 (VOUT)
/Power Supply/1V2_SENSE: R166.2, U11.5 (SENSE)
/Power Supply/1V8_EN: R19.1, U12.10 (PA4), U15.12 (ON/OFF)
/Power Supply/1V8_IO_EN: R31.1, U12.26 (PB3), U17.2 (EN)
/Power Supply/1V8_PGOOD: R18.1, TP5.1, U12.19 (PA9), U15.11 (PGOOD)
/Power Supply/1V8_RAW: C109.1, C114.1, R38.2, U15.6 (VOUT), U15.7 (VOUT)
/Power Supply/2V5_EN: R21.1, U12.8 (PA2), U13.12 (ON/OFF)
/Power Supply/2V5_PGOOD: R20.1, TP3.1, U12.20 (PA10), U13.11 (PGOOD)
/Power Supply/2V5_RAW: C107.1, C112.1, C475.1, R36.2, U13.6 (VOUT), U13.7 (VOUT)
/Power Supply/3V3_EN: R23.1, U12.7 (PA1), U14.12 (ON/OFF)
/Power Supply/3V3_PGOOD: R22.1, TP4.1, U12.18 (PA8), U14.11 (PGOOD)
/Power Supply/3V3_RAW: C108.1, C113.1, C476.1, R37.2, U14.6 (VOUT), U14.7 (VOUT)
/Power Supply/3V3_SB_PGOOD: R39.1, TP16.1, U19.3 (PG)
/Power Supply/12V0_BLEED: R28.1, U16.5 (BLEED)
/Power Supply/12V0_EN: R29.1, U12.22 (PA12), U16.2 (EN)
/Power Supply/12V0_FUSED: C174.1, FB1.2, U16.1 (VIN), U16.PAD (VIN), U19.4 (EN), U19.6 (IN)
/Power Supply/12V0_RAW: F1.1, J6.1 (PWR)
/Power Supply/ALL_OK: R24.1, U12.2 (PC14)
/Power Supply/FPGA_DONE_3V3: U12.16 (PB2), U26.3 (A)
/Power Supply/FPGA_INIT_3V3: U12.25 (PA15), U27.3 (A)
/Power Supply/PWR_FAIL: R27.1, U12.3 (PC15)
/Power Supply/PWR_OK: R26.1, U12.6 (PA0)
/Power Supply/SUPER_BOOT0: R7.1, U12.31 (BOOT0)
/Power Supply/SUPER_GPIO: R53.1, U12.32 (PB8)
/Power Supply/SUPER_RST_N: C111.1, J13.5, U12.4 (NRST)
/Power Supply/SUPER_SWCLK: J13.3, U12.24 (PA14)
/Power Supply/SUPER_SWDIO: J13.4, U12.23 (PA13)
/Power Supply/SUPER_UART_RX: J14.1, U12.30 (PB7)
/Power Supply/SUPER_UART_TX: J14.2, U12.29 (PB6)
/Power Supply/VTT_EN: R32.1, U12.21 (PA11), U18.2 (~SD)
/QDR_VREF: C167.1, U18.4 (VREF); also elsewhere on the board
/QDR_VTT: C168.1, C171.1, U18.3 (VSENSE), U18.8 (VTT); also elsewhere on the board
unnamed: C121.1, U16.6 (SR)
unnamed: D1.2 (A), R24.2
unnamed: D2.2 (A), R25.2
unnamed: D3.2 (A), R26.2
unnamed: D4.2 (A), R27.2
unnamed: D5.2 (A), R53.2
unnamed: F1.2, FB1.1
unnamed: R1.1, U10.22 (TRIM)
unnamed: R1.2, R2.2
unnamed: R5.1, U11.4 (TRIM)
unnamed: R5.2, R6.2
unnamed: R8.1, U13.4 (TRIM)
unnamed: R9.1, U14.4 (TRIM)
unnamed: R10.1, U15.4 (TRIM)
unnamed: R10.2, R13.2
unnamed: R8.2, R11.2
unnamed: R9.2, R12.2

Notes on the sheet:
Total output C 400 - 3000 uF
Place C168 near U18 pin 3
Power rail sequencing requirements: * QDR: VDD before VDDQ, VDDQ before or simultaneous w/ Vref * FPGA: 1V0 -> 1V8 -> VCCO * FPGA: 1V0 -> 1V2 Overall sequence: * Vin * 3V3_SB * 12V0 * 1V0 * 1V2 / 1V8 simultaneous * 1V8_IO, 2V5, 3V3 simultaneous * FPGA reset * MCU reset
Cmax = 7.8A / SR SR for 3.3V supply = 13.5 kV/s Max C with default slew is only 578 uF To support 3000 uF (allowing for extra C), we need slew of 2.6 kV/sec or less SR = 31 uA / Csr so Csr = 11.9 nF
Trim: Precision metal film 1/10W +/- 0.5%
Total output C 660 - 5000 uF
115 ohm nominal internal bleed resistance Max 400 mW internal dissipation 470 will gives discharge current of 20.5 mA Resistor will dissipate ~200 mW, 48 mW in IC
1.5V Vih, 1.1V Vil Internal: 6.8k pulldown, 22k pullup So should float at ~2.8V if undriven Add external 1K pulldown, equivalent 871 ohms Need 1.72 mA drive current for 1.5V, 2.87 mA for 2.5V
Open drain (pullups on FPGA sheet): FPGA_RST_N FPGA_DONE
1.8V Vih Internal: 33K pulldown, 100K pullup So should float at ~2.7V if undriven
PGOOD pin for 1V0 regulator is pulled up to 5V internally Need to be on 5V tolerant pins. Put all PGOOD on 5V pins to be safe
Place C169 by U18 pin 7 Place C170 by U18 pin 5
Slew rate 2.1 kV/sec, so 5.7 ms ramp time Estimated 6.3A peak inrush
