azonenberg/latentpacket/latentpink/pcb/latentpink.kicad_pcb

## KiCad design latentpink/pcb/latentpink.kicad_pcb (continued)

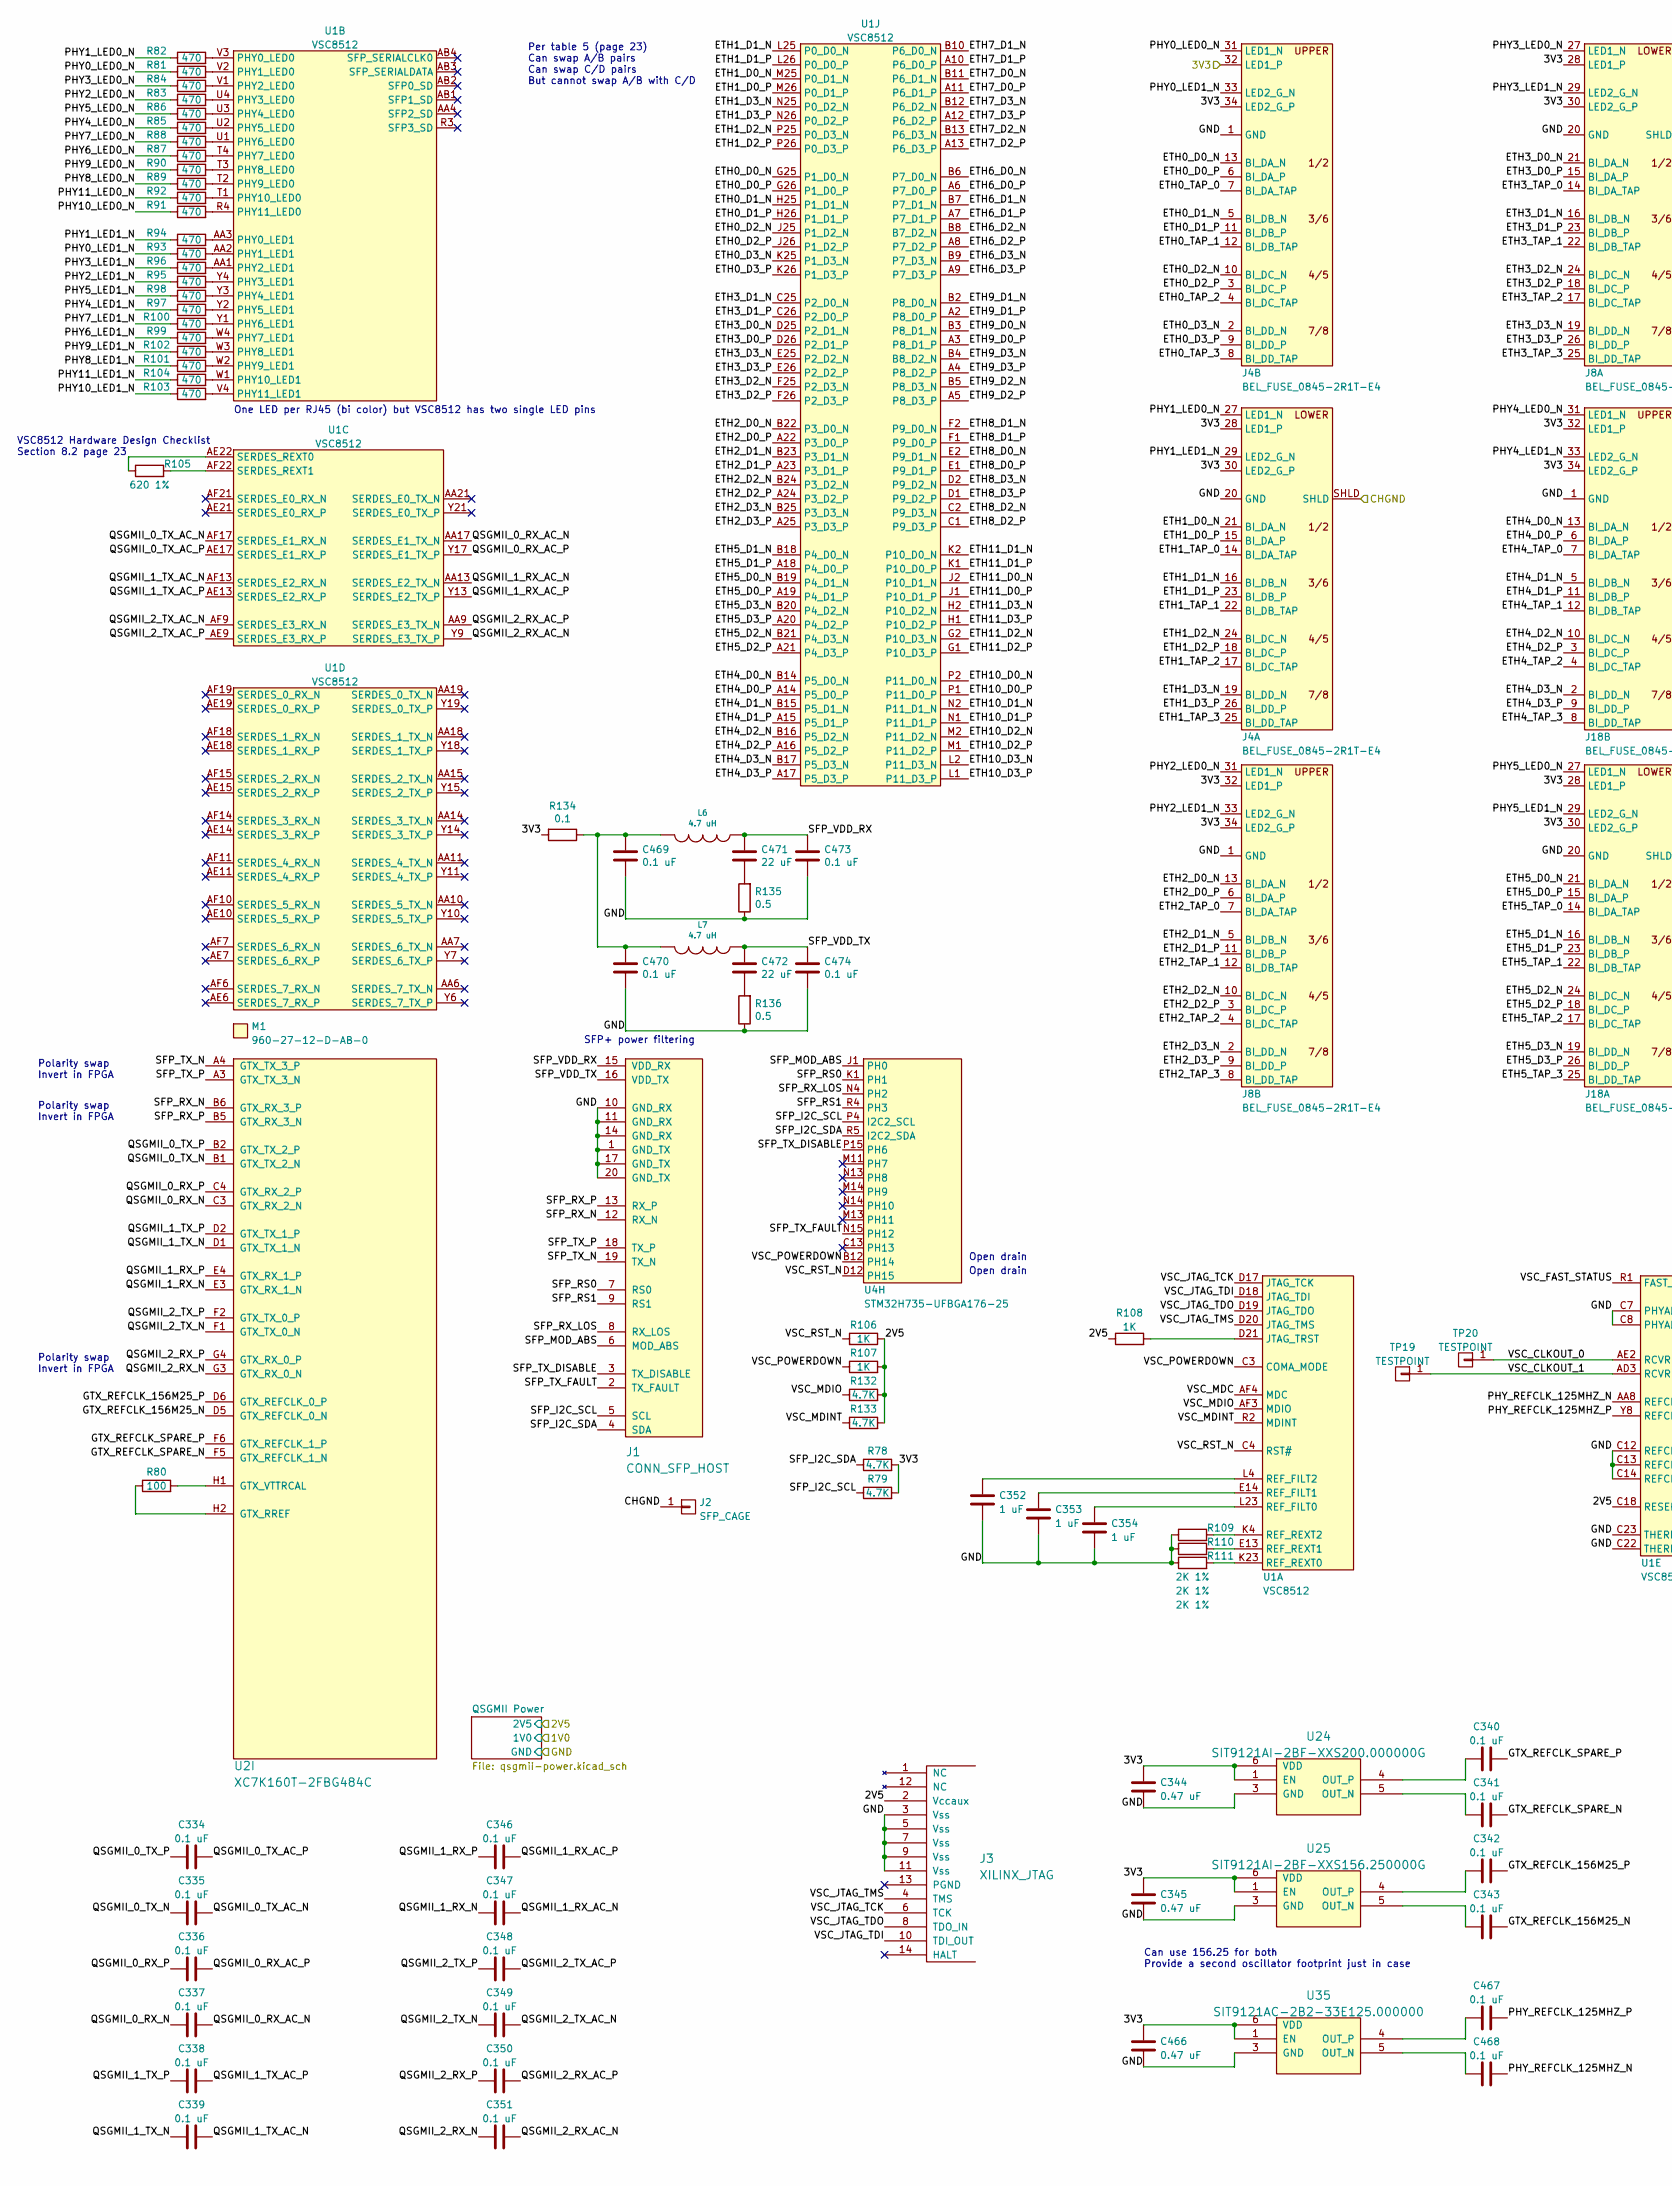
[picture p6: schematic phy.kicad_sch, part in row 1, column 1]

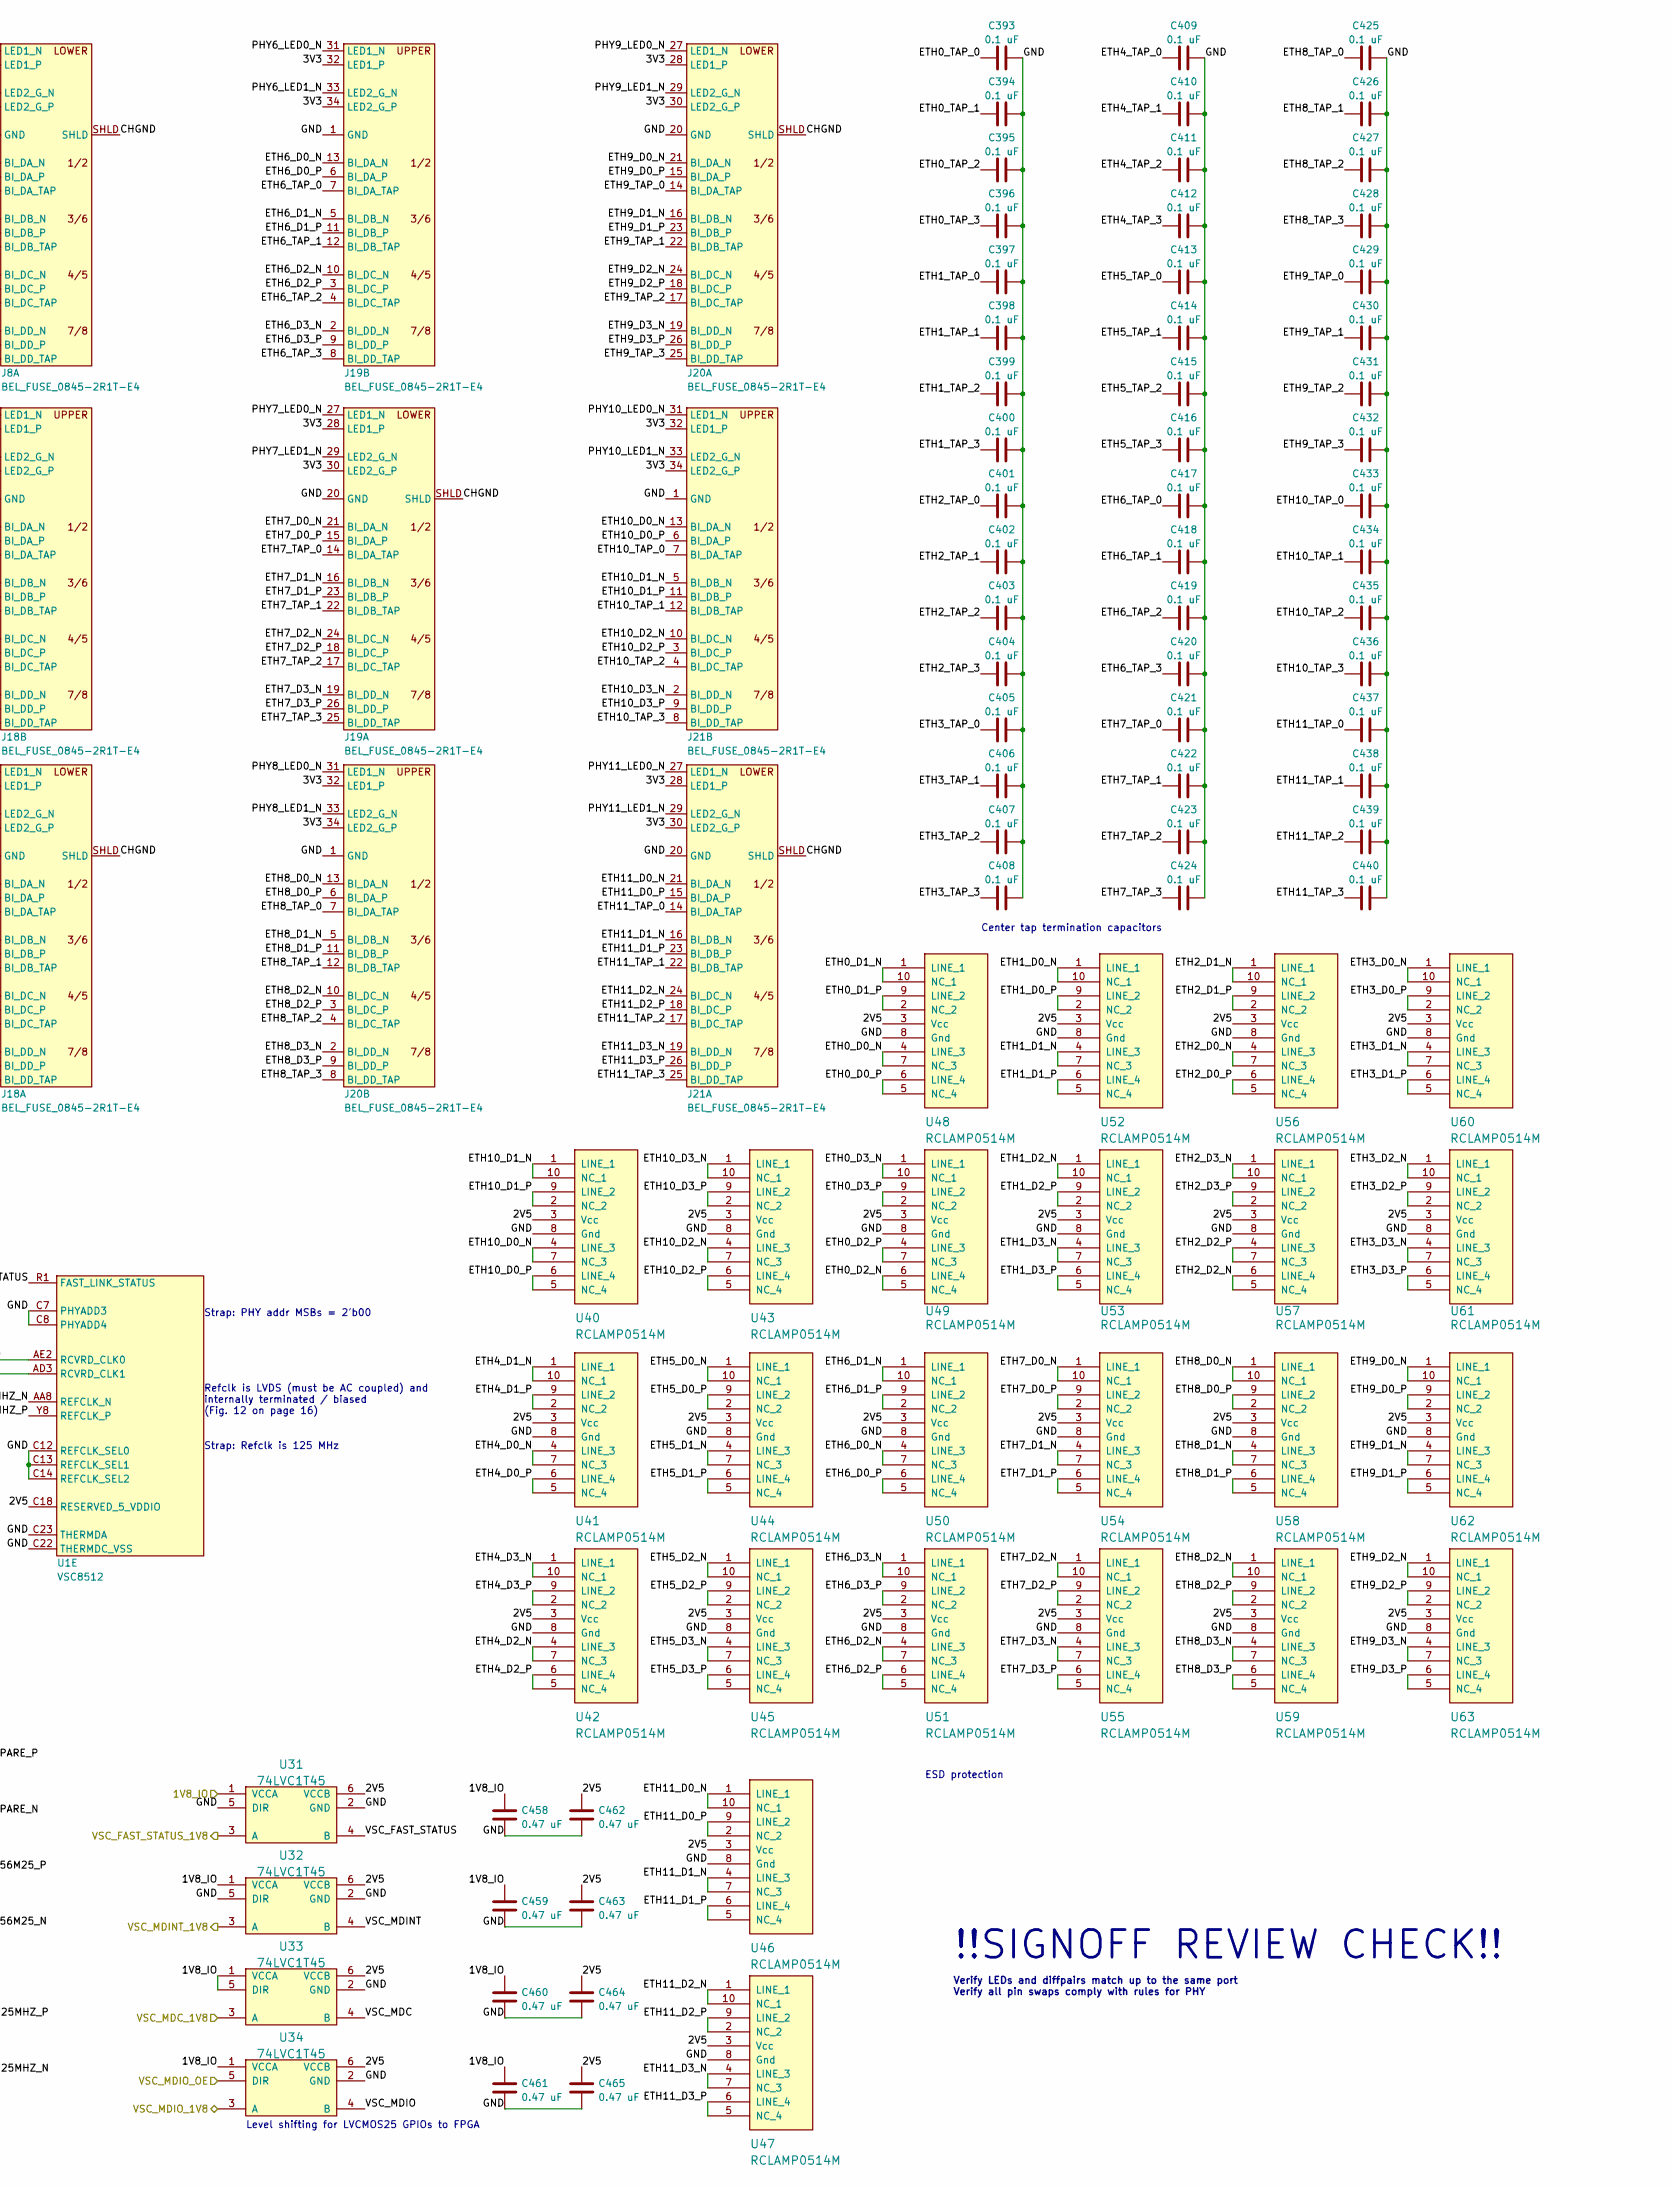
[picture p7: schematic phy.kicad_sch, part in row 1, column 2]

Parts:
C334, C335, C336, C337, C338, C339, C340, C341, C342, C343, C346, C347, C348, C349, C350, C351, C393, C394, C395, C396, C397, C398, C399, C400, C401, C402, C403, C404, C405, C406, C407, C408, C409, C410, C411, C412, C413, C414, C415, C416, C417, C418, C419, C420, C421, C422, C423, C424, C425, C426, C427, C428, C429, C430, C431, C432, C433, C434, C435, C436, C437, C438, C439, C440, C467, C468, C469, C470, C473, C474: 0.1 uF; EIA_0402_CAP_NOSILK
C344, C345, C458, C459, C460, C461, C462, C463, C464, C465, C466: 0.47 uF; EIA_0402_CAP_NOSILK
C352, C353, C354: 1 uF; EIA_0402_CAP_NOSILK
C471, C472: 22 uF; EIA_1206_CAP_NOSILK
J1: CONN_SFP_HOST; CONN_SFP+_AMPHENOL_UE76_A10_2000T
J2: SFP_CAGE; CONN_SFP_CAGE_TE_2007194-1
J3: XILINX_JTAG; XILINX_JTAG_PTH_MOLEX_0878311420
J4, J8, J18, J19, J20, J21: BEL_FUSE_0845-2R1T-E4; CONN_RJ45_BELFUSE_0845-2R1T-E4
L6, L7: 4.7 uH; EIA_0805_INDUCTOR_NOSILK
M1: 960-27-12-D-AB-0; HEATSINK_WAKEFIELDVETTE_960-27-12-D-AB-0
R78, R79, R132, R133: 4.7K; EIA_0402_RES_NOSILK
R80: 100; EIA_0402_RES_NOSILK
R81, R82, R83, R84, R85, R86, R87, R88, R89, R90, R91, R92, R93, R94, R95, R96, R97, R98, R99, R100, R101, R102, R103, R104: 470; EIA_0402_RES_NOSILK
R105: 620 1%; EIA_0402_RES_NOSILK
R106, R107, R108: 1K; EIA_0402_RES_NOSILK
R109, R110, R111: 2K 1%; EIA_0402_RES_NOSILK
R134: 0.1; EIA_0402_RES_NOSILK
R135, R136: 0.5; EIA_0402_RES_NOSILK
TP19, TP20: TESTPOINT; TESTPOINT_SMT_0.5MM
U1: VSC8512; BGA_672_27x27_DEPOPCORNER_1MM
U2: XC7K160T-2FBG484C; BGA_484_22x22_FULLARRAY_1MM
U4: STM32H735-UFBGA176-25; BGA_201_10x10_DEPOP_0.65MM_OSHPARK
U24: SIT9121AI-2BF-XXS200.000000G; OSCILLATOR_LVDS_3.2x2.5
U25: SIT9121AI-2BF-XXS156.250000G; OSCILLATOR_LVDS_3.2x2.5
U31, U32, U33, U34: 74LVC1T45; DFN_6_0.5MM_1.45x1.00MM
U35: SIT9121AC-2B2-33E125.000000; OSCILLATOR_LVDS_3.2x2.5
U40, U41, U42, U43, U44, U45, U46, U47, U48, U49, U50, U51, U52, U53, U54, U55, U56, U57, U58, U59, U60, U61, U62, U63: RCLAMP0514M; SOP_10_0.5MM_3MM

Connections:
/1V8_IO: C458.1, C459.1, C460.1, C461.1, U31.1 (VCCA), U32.1 (VCCA), U33.1 (VCCA), U33.5 (DIR), U34.1 (VCCA); also elsewhere on the board
/2V5: C462.1, C463.1, C464.1, C465.1, J3.2 (Vccaux), R106.1, R107.2, R108.1, R132.2, R133.2, U1.C18 (RESERVED_5_VDDIO), U31.6 (VCCB), U32.6 (VCCB), U33.6 (VCCB), U34.6 (VCCB), U40.3 (Vcc), U41.3 (Vcc), U42.3 (Vcc), U43.3 (Vcc), U44.3 (Vcc), U45.3 (Vcc), U46.3 (Vcc), U47.3 (Vcc), U48.3 (Vcc), U49.3 (Vcc), U50.3 (Vcc), U51.3 (Vcc), U52.3 (Vcc), U53.3 (Vcc), U54.3 (Vcc), U55.3 (Vcc), U56.3 (Vcc), U57.3 (Vcc), U58.3 (Vcc), U59.3 (Vcc), U60.3 (Vcc), U61.3 (Vcc), U62.3 (Vcc), U63.3 (Vcc); also elsewhere on the board
/3V3: C344.1, C345.1, C466.1, J4.28 (LED1_P), J4.30 (LED2_G_P), J4.32 (LED1_P), J4.34 (LED2_G_P), J8.28 (LED1_P), J8.30 (LED2_G_P), J8.32 (LED1_P), J8.34 (LED2_G_P), J18.28 (LED1_P), J18.30 (LED2_G_P), J18.32 (LED1_P), J18.34 (LED2_G_P), J19.28 (LED1_P), J19.30 (LED2_G_P), J19.32 (LED1_P), J19.34 (LED2_G_P), J20.28 (LED1_P), J20.30 (LED2_G_P), J20.32 (LED1_P), J20.34 (LED2_G_P), J21.28 (LED1_P), J21.30 (LED2_G_P), J21.32 (LED1_P), J21.34 (LED2_G_P), R78.2, R79.2, R134.2, U24.1 (EN), U24.6 (VDD), U25.1 (EN), U25.6 (VDD), U35.1 (EN), U35.6 (VDD); also elsewhere on the board
/CHGND: J2.1, J4.SHLD, J8.SHLD, J18.SHLD, J19.SHLD, J20.SHLD, J21.SHLD; also elsewhere on the board
/GND: C344.2, C345.2, C352.2, C353.2, C354.2, C393.1, C394.1, C395.1, C396.1, C397.1, C398.1, C399.1, C400.1, C401.1, C402.1, C403.1, C404.1, C405.1, C406.1, C407.1, C408.1, C409.1, C410.1, C411.1, C412.1, C413.1, C414.1, C415.1, C416.1, C417.1, C418.1, C419.1, C420.1, C421.1, C422.1, C423.1, C424.1, C425.1, C426.1, C427.1, C428.1, C429.1, C430.1, C431.1, C432.1, C433.1, C434.1, C435.1, C436.1, C437.1, C438.1, C439.1, C440.1, C458.2, C459.2, C460.2, C461.2, C462.2, C463.2, C464.2, C465.2, C466.2, C469.2, C470.2, C473.2, C474.2, J1.1 (GND_TX), J1.10 (GND_RX), J1.11 (GND_RX), J1.14 (GND_RX), J1.17 (GND_TX), J1.20 (GND_TX), J3.3 (Vss), J3.5 (Vss), J3.7 (Vss), J3.9 (Vss), J3.11 (Vss), J4.1 (GND), J4.20 (GND), J8.1 (GND), J8.20 (GND), J18.1 (GND), J18.20 (GND), J19.1 (GND), J19.20 (GND), J20.1 (GND), J20.20 (GND), J21.1 (GND), J21.20 (GND), R109.1, R110.1, R111.1, R135.1, R136.1, U1.C7 (PHYADD3), U1.C8 (PHYADD4), U1.C12 (REFCLK_SEL0), U1.C13 (REFCLK_SEL1), U1.C14 (REFCLK_SEL2), U1.C22 (THERMDC_VSS), U1.C23 (THERMDA), U24.3 (GND), U25.3 (GND), U31.2 (GND), U31.5 (DIR), U32.2 (GND), U32.5 (DIR), U33.2 (GND), U34.2 (GND), U35.3 (GND), U40.8 (Gnd), U41.8 (Gnd), U42.8 (Gnd), U43.8 (Gnd), U44.8 (Gnd), U45.8 (Gnd), U46.8 (Gnd), U47.8 (Gnd), U48.8 (Gnd), U49.8 (Gnd), U50.8 (Gnd), U51.8 (Gnd), U52.8 (Gnd), U53.8 (Gnd), U54.8 (Gnd), U55.8 (Gnd), U56.8 (Gnd), U57.8 (Gnd), U58.8 (Gnd), U59.8 (Gnd), U60.8 (Gnd), U61.8 (Gnd), U62.8 (Gnd), U63.8 (Gnd); also elsewhere on the board
/QSGMII PHY/ETH0_D0_N: J4.13 (BI_DA_N), U1.G25 (P1_D0_N), U48.4 (LINE_3), U48.7 (NC_3)
/QSGMII PHY/ETH0_D0_P: J4.6 (BI_DA_P), U1.G26 (P1_D0_P), U48.5 (NC_4), U48.6 (LINE_4)
/QSGMII PHY/ETH0_D1_N: J4.5 (BI_DB_N), U1.H25 (P1_D1_N), U48.1 (LINE_1), U48.10 (NC_1)
/QSGMII PHY/ETH0_D1_P: J4.11 (BI_DB_P), U1.H26 (P1_D1_P), U48.2 (NC_2), U48.9 (LINE_2)
/QSGMII PHY/ETH0_D2_N: J4.10 (BI_DC_N), U1.J25 (P1_D2_N), U49.5 (NC_4), U49.6 (LINE_4)
/QSGMII PHY/ETH0_D2_P: J4.3 (BI_DC_P), U1.J26 (P1_D2_P), U49.4 (LINE_3), U49.7 (NC_3)
/QSGMII PHY/ETH0_D3_N: J4.2 (BI_DD_N), U1.K25 (P1_D3_N), U49.1 (LINE_1), U49.10 (NC_1)
/QSGMII PHY/ETH0_D3_P: J4.9 (BI_DD_P), U1.K26 (P1_D3_P), U49.2 (NC_2), U49.9 (LINE_2)
/QSGMII PHY/ETH0_TAP_0: C393.2, J4.7 (BI_DA_TAP)
/QSGMII PHY/ETH0_TAP_1: C394.2, J4.12 (BI_DB_TAP)
/QSGMII PHY/ETH0_TAP_2: C395.2, J4.4 (BI_DC_TAP)
/QSGMII PHY/ETH0_TAP_3: C396.2, J4.8 (BI_DD_TAP)
/QSGMII PHY/ETH1_D0_N: J4.21 (BI_DA_N), U1.M25 (P0_D1_N), U52.1 (LINE_1), U52.10 (NC_1)
/QSGMII PHY/ETH1_D0_P: J4.15 (BI_DA_P), U1.M26 (P0_D1_P), U52.2 (NC_2), U52.9 (LINE_2)
/QSGMII PHY/ETH1_D1_N: J4.16 (BI_DB_N), U1.L25 (P0_D0_N), U52.4 (LINE_3), U52.7 (NC_3)
/QSGMII PHY/ETH1_D1_P: J4.23 (BI_DB_P), U1.L26 (P0_D0_P), U52.5 (NC_4), U52.6 (LINE_4)
/QSGMII PHY/ETH1_D2_N: J4.24 (BI_DC_N), U1.P25 (P0_D3_N), U53.1 (LINE_1), U53.10 (NC_1)
/QSGMII PHY/ETH1_D2_P: J4.18 (BI_DC_P), U1.P26 (P0_D3_P), U53.2 (NC_2), U53.9 (LINE_2)
/QSGMII PHY/ETH1_D3_N: J4.19 (BI_DD_N), U1.N25 (P0_D2_N), U53.4 (LINE_3), U53.7 (NC_3)
/QSGMII PHY/ETH1_D3_P: J4.26 (BI_DD_P), U1.N26 (P0_D2_P), U53.5 (NC_4), U53.6 (LINE_4)
/QSGMII PHY/ETH1_TAP_0: C397.2, J4.14 (BI_DA_TAP)
/QSGMII PHY/ETH1_TAP_1: C398.2, J4.22 (BI_DB_TAP)
/QSGMII PHY/ETH1_TAP_2: C399.2, J4.17 (BI_DC_TAP)
/QSGMII PHY/ETH1_TAP_3: C400.2, J4.25 (BI_DD_TAP)
/QSGMII PHY/ETH2_D0_N: J8.13 (BI_DA_N), U1.B22 (P3_D0_N), U56.4 (LINE_3), U56.7 (NC_3)
/QSGMII PHY/ETH2_D0_P: J8.6 (BI_DA_P), U1.A22 (P3_D0_P), U56.5 (NC_4), U56.6 (LINE_4)
/QSGMII PHY/ETH2_D1_N: J8.5 (BI_DB_N), U1.B23 (P3_D1_N), U56.1 (LINE_1), U56.10 (NC_1)
/QSGMII PHY/ETH2_D1_P: J8.11 (BI_DB_P), U1.A23 (P3_D1_P), U56.2 (NC_2), U56.9 (LINE_2)
/QSGMII PHY/ETH2_D2_N: J8.10 (BI_DC_N), U1.B24 (P3_D2_N), U57.5 (NC_4), U57.6 (LINE_4)
/QSGMII PHY/ETH2_D2_P: J8.3 (BI_DC_P), U1.A24 (P3_D2_P), U57.4 (LINE_3), U57.7 (NC_3)
/QSGMII PHY/ETH2_D3_N: J8.2 (BI_DD_N), U1.B25 (P3_D3_N), U57.1 (LINE_1), U57.10 (NC_1)
/QSGMII PHY/ETH2_D3_P: J8.9 (BI_DD_P), U1.A25 (P3_D3_P), U57.2 (NC_2), U57.9 (LINE_2)
/QSGMII PHY/ETH2_TAP_0: C401.2, J8.7 (BI_DA_TAP)
/QSGMII PHY/ETH2_TAP_1: C402.2, J8.12 (BI_DB_TAP)
/QSGMII PHY/ETH2_TAP_2: C403.2, J8.4 (BI_DC_TAP)
/QSGMII PHY/ETH2_TAP_3: C404.2, J8.8 (BI_DD_TAP)
/QSGMII PHY/ETH3_D0_N: J8.21 (BI_DA_N), U1.D25 (P2_D1_N), U60.1 (LINE_1), U60.10 (NC_1)
/QSGMII PHY/ETH3_D0_P: J8.15 (BI_DA_P), U1.D26 (P2_D1_P), U60.2 (NC_2), U60.9 (LINE_2)
/QSGMII PHY/ETH3_D1_N: J8.16 (BI_DB_N), U1.C25 (P2_D0_N), U60.4 (LINE_3), U60.7 (NC_3)
/QSGMII PHY/ETH3_D1_P: J8.23 (BI_DB_P), U1.C26 (P2_D0_P), U60.5 (NC_4), U60.6 (LINE_4)
/QSGMII PHY/ETH3_D2_N: J8.24 (BI_DC_N), U1.F25 (P2_D3_N), U61.1 (LINE_1), U61.10 (NC_1)
/QSGMII PHY/ETH3_D2_P: J8.18 (BI_DC_P), U1.F26 (P2_D3_P), U61.2 (NC_2), U61.9 (LINE_2)
/QSGMII PHY/ETH3_D3_N: J8.19 (BI_DD_N), U1.E25 (P2_D2_N), U61.4 (LINE_3), U61.7 (NC_3)
/QSGMII PHY/ETH3_D3_P: J8.26 (BI_DD_P), U1.E26 (P2_D2_P), U61.5 (NC_4), U61.6 (LINE_4)
/QSGMII PHY/ETH3_TAP_0: C405.2, J8.14 (BI_DA_TAP)
/QSGMII PHY/ETH3_TAP_1: C406.2, J8.22 (BI_DB_TAP)
/QSGMII PHY/ETH3_TAP_2: C407.2, J8.17 (BI_DC_TAP)
/QSGMII PHY/ETH3_TAP_3: C408.2, J8.25 (BI_DD_TAP)
/QSGMII PHY/ETH4_D0_N: J18.13 (BI_DA_N), U1.B14 (P5_D0_N), U41.4 (LINE_3), U41.7 (NC_3)
/QSGMII PHY/ETH4_D0_P: J18.6 (BI_DA_P), U1.A14 (P5_D0_P), U41.5 (NC_4), U41.6 (LINE_4)
/QSGMII PHY/ETH4_D1_N: J18.5 (BI_DB_N), U1.B15 (P5_D1_N), U41.1 (LINE_1), U41.10 (NC_1)
/QSGMII PHY/ETH4_D1_P: J18.11 (BI_DB_P), U1.A15 (P5_D1_P), U41.2 (NC_2), U41.9 (LINE_2)
/QSGMII PHY/ETH4_D2_N: J18.10 (BI_DC_N), U1.B16 (P5_D2_N), U42.4 (LINE_3), U42.7 (NC_3)
/QSGMII PHY/ETH4_D2_P: J18.3 (BI_DC_P), U1.A16 (P5_D2_P), U42.5 (NC_4), U42.6 (LINE_4)
/QSGMII PHY/ETH4_D3_N: J18.2 (BI_DD_N), U1.B17 (P5_D3_N), U42.1 (LINE_1), U42.10 (NC_1)
/QSGMII PHY/ETH4_D3_P: J18.9 (BI_DD_P), U1.A17 (P5_D3_P), U42.2 (NC_2), U42.9 (LINE_2)
/QSGMII PHY/ETH4_TAP_0: C409.2, J18.7 (BI_DA_TAP)
/QSGMII PHY/ETH4_TAP_1: C410.2, J18.12 (BI_DB_TAP)
/QSGMII PHY/ETH4_TAP_2: C411.2, J18.4 (BI_DC_TAP)
/QSGMII PHY/ETH4_TAP_3: C412.2, J18.8 (BI_DD_TAP)
/QSGMII PHY/ETH5_D0_N: J18.21 (BI_DA_N), U1.B19 (P4_D1_N), U44.1 (LINE_1), U44.10 (NC_1)
/QSGMII PHY/ETH5_D0_P: J18.15 (BI_DA_P), U1.A19 (P4_D1_P), U44.2 (NC_2), U44.9 (LINE_2)
/QSGMII PHY/ETH5_D1_N: J18.16 (BI_DB_N), U1.B18 (P4_D0_N), U44.4 (LINE_3), U44.7 (NC_3)
/QSGMII PHY/ETH5_D1_P: J18.23 (BI_DB_P), U1.A18 (P4_D0_P), U44.5 (NC_4), U44.6 (LINE_4)
/QSGMII PHY/ETH5_D2_N: J18.24 (BI_DC_N), U1.B21 (P4_D3_N), U45.1 (LINE_1), U45.10 (NC_1)
/QSGMII PHY/ETH5_D2_P: J18.18 (BI_DC_P), U1.A21 (P4_D3_P), U45.2 (NC_2), U45.9 (LINE_2)
/QSGMII PHY/ETH5_D3_N: J18.19 (BI_DD_N), U1.B20 (P4_D2_N), U45.4 (LINE_3), U45.7 (NC_3)
/QSGMII PHY/ETH5_D3_P: J18.26 (BI_DD_P), U1.A20 (P4_D2_P), U45.5 (NC_4), U45.6 (LINE_4)
/QSGMII PHY/ETH5_TAP_0: C413.2, J18.14 (BI_DA_TAP)
/QSGMII PHY/ETH5_TAP_1: C414.2, J18.22 (BI_DB_TAP)
/QSGMII PHY/ETH5_TAP_2: C415.2, J18.17 (BI_DC_TAP)
/QSGMII PHY/ETH5_TAP_3: C416.2, J18.25 (BI_DD_TAP)
/QSGMII PHY/ETH6_D0_N: J19.13 (BI_DA_N), U1.B6 (P7_D0_N), U50.4 (LINE_3), U50.7 (NC_3)
/QSGMII PHY/ETH6_D0_P: J19.6 (BI_DA_P), U1.A6 (P7_D0_P), U50.5 (NC_4), U50.6 (LINE_4)
/QSGMII PHY/ETH6_D1_N: J19.5 (BI_DB_N), U1.B7 (P7_D1_N), U50.1 (LINE_1), U50.10 (NC_1)
/QSGMII PHY/ETH6_D1_P: J19.11 (BI_DB_P), U1.A7 (P7_D1_P), U50.2 (NC_2), U50.9 (LINE_2)
/QSGMII PHY/ETH6_D2_N: J19.10 (BI_DC_N), U1.B8 (B7_D2_N), U51.4 (LINE_3), U51.7 (NC_3)
/QSGMII PHY/ETH6_D2_P: J19.3 (BI_DC_P), U1.A8 (P7_D2_P), U51.5 (NC_4), U51.6 (LINE_4)
/QSGMII PHY/ETH6_D3_N: J19.2 (BI_DD_N), U1.B9 (P7_D3_N), U51.1 (LINE_1), U51.10 (NC_1)
/QSGMII PHY/ETH6_D3_P: J19.9 (BI_DD_P), U1.A9 (P7_D3_P), U51.2 (NC_2), U51.9 (LINE_2)
/QSGMII PHY/ETH6_TAP_0: C417.2, J19.7 (BI_DA_TAP)
/QSGMII PHY/ETH6_TAP_1: C418.2, J19.12 (BI_DB_TAP)
/QSGMII PHY/ETH6_TAP_2: C419.2, J19.4 (BI_DC_TAP)
/QSGMII PHY/ETH6_TAP_3: C420.2, J19.8 (BI_DD_TAP)
/QSGMII PHY/ETH7_D0_N: J19.21 (BI_DA_N), U1.B11 (P6_D1_N), U54.1 (LINE_1), U54.10 (NC_1)
/QSGMII PHY/ETH7_D0_P: J19.15 (BI_DA_P), U1.A11 (P6_D1_P), U54.2 (NC_2), U54.9 (LINE_2)
/QSGMII PHY/ETH7_D1_N: J19.16 (BI_DB_N), U1.B10 (P6_D0_N), U54.4 (LINE_3), U54.7 (NC_3)
/QSGMII PHY/ETH7_D1_P: J19.23 (BI_DB_P), U1.A10 (P6_D0_P), U54.5 (NC_4), U54.6 (LINE_4)
/QSGMII PHY/ETH7_D2_N: J19.24 (BI_DC_N), U1.B13 (P6_D3_N), U55.1 (LINE_1), U55.10 (NC_1)
/QSGMII PHY/ETH7_D2_P: J19.18 (BI_DC_P), U1.A13 (P6_D3_P), U55.2 (NC_2), U55.9 (LINE_2)
/QSGMII PHY/ETH7_D3_N: J19.19 (BI_DD_N), U1.B12 (P6_D2_N), U55.4 (LINE_3), U55.7 (NC_3)
/QSGMII PHY/ETH7_D3_P: J19.26 (BI_DD_P), U1.A12 (P6_D2_P), U55.5 (NC_4), U55.6 (LINE_4)
/QSGMII PHY/ETH7_TAP_0: C421.2, J19.14 (BI_DA_TAP)
/QSGMII PHY/ETH7_TAP_1: C422.2, J19.22 (BI_DB_TAP)
/QSGMII PHY/ETH7_TAP_2: C423.2, J19.17 (BI_DC_TAP)
/QSGMII PHY/ETH7_TAP_3: C424.2, J19.25 (BI_DD_TAP)
/QSGMII PHY/ETH8_D0_N: J20.13 (BI_DA_N), U1.E2 (P9_D1_N), U58.1 (LINE_1), U58.10 (NC_1)
/QSGMII PHY/ETH8_D0_P: J20.6 (BI_DA_P), U1.E1 (P9_D1_P), U58.2 (NC_2), U58.9 (LINE_2)
/QSGMII PHY/ETH8_D1_N: J20.5 (BI_DB_N), U1.F2 (P9_D0_N), U58.4 (LINE_3), U58.7 (NC_3)
/QSGMII PHY/ETH8_D1_P: J20.11 (BI_DB_P), U1.F1 (P9_D0_P), U58.5 (NC_4), U58.6 (LINE_4)
/QSGMII PHY/ETH8_D2_N: J20.10 (BI_DC_N), U1.C2 (P9_D3_N), U59.1 (LINE_1), U59.10 (NC_1)
/QSGMII PHY/ETH8_D2_P: J20.3 (BI_DC_P), U1.C1 (P9_D3_P), U59.2 (NC_2), U59.9 (LINE_2)
/QSGMII PHY/ETH8_D3_N: J20.2 (BI_DD_N), U1.D2 (P9_D2_N), U59.4 (LINE_3), U59.7 (NC_3)
/QSGMII PHY/ETH8_D3_P: J20.9 (BI_DD_P), U1.D1 (P9_D2_P), U59.5 (NC_4), U59.6 (LINE_4)
/QSGMII PHY/ETH8_TAP_0: C425.2, J20.7 (BI_DA_TAP)
/QSGMII PHY/ETH8_TAP_1: C426.2, J20.12 (BI_DB_TAP)
/QSGMII PHY/ETH8_TAP_2: C427.2, J20.4 (BI_DC_TAP)
/QSGMII PHY/ETH8_TAP_3: C428.2, J20.8 (BI_DD_TAP)
/QSGMII PHY/ETH9_D0_N: J20.21 (BI_DA_N), U1.B3 (P8_D1_N), U62.1 (LINE_1), U62.10 (NC_1)
/QSGMII PHY/ETH9_D0_P: J20.15 (BI_DA_P), U1.A3 (P8_D1_P), U62.2 (NC_2), U62.9 (LINE_2)
/QSGMII PHY/ETH9_D1_N: J20.16 (BI_DB_N), U1.B2 (P8_D0_N), U62.4 (LINE_3), U62.7 (NC_3)
/QSGMII PHY/ETH9_D1_P: J20.23 (BI_DB_P), U1.A2 (P8_D0_P), U62.5 (NC_4), U62.6 (LINE_4)
/QSGMII PHY/ETH9_D2_N: J20.24 (BI_DC_N), U1.B5 (P8_D3_N), U63.1 (LINE_1), U63.10 (NC_1)
/QSGMII PHY/ETH9_D2_P: J20.18 (BI_DC_P), U1.A5 (P8_D3_P), U63.2 (NC_2), U63.9 (LINE_2)
/QSGMII PHY/ETH9_D3_N: J20.19 (BI_DD_N), U1.B4 (B8_D2_N), U63.4 (LINE_3), U63.7 (NC_3)
/QSGMII PHY/ETH9_D3_P: J20.26 (BI_DD_P), U1.A4 (P8_D2_P), U63.5 (NC_4), U63.6 (LINE_4)
/QSGMII PHY/ETH9_TAP_0: C429.2, J20.14 (BI_DA_TAP)
/QSGMII PHY/ETH9_TAP_1: C430.2, J20.22 (BI_DB_TAP)
/QSGMII PHY/ETH9_TAP_2: C431.2, J20.17 (BI_DC_TAP)
/QSGMII PHY/ETH9_TAP_3: C432.2, J20.25 (BI_DD_TAP)
/QSGMII PHY/ETH10_D0_N: J21.13 (BI_DA_N), U1.P2 (P11_D0_N), U40.4 (LINE_3), U40.7 (NC_3)
/QSGMII PHY/ETH10_D0_P: J21.6 (BI_DA_P), U1.P1 (P11_D0_P), U40.5 (NC_4), U40.6 (LINE_4)
/QSGMII PHY/ETH10_D1_N: J21.5 (BI_DB_N), U1.N2 (P11_D1_N), U40.1 (LINE_1), U40.10 (NC_1)
/QSGMII PHY/ETH10_D1_P: J21.11 (BI_DB_P), U1.N1 (P11_D1_P), U40.2 (NC_2), U40.9 (LINE_2)
/QSGMII PHY/ETH10_D2_N: J21.10 (BI_DC_N), U1.M2 (P11_D2_N), U43.4 (LINE_3), U43.7 (NC_3)
/QSGMII PHY/ETH10_D2_P: J21.3 (BI_DC_P), U1.M1 (P11_D2_P), U43.5 (NC_4), U43.6 (LINE_4)
/QSGMII PHY/ETH10_D3_N: J21.2 (BI_DD_N), U1.L2 (P11_D3_N), U43.1 (LINE_1), U43.10 (NC_1)
/QSGMII PHY/ETH10_D3_P: J21.9 (BI_DD_P), U1.L1 (P11_D3_P), U43.2 (NC_2), U43.9 (LINE_2)
/QSGMII PHY/ETH10_TAP_0: C433.2, J21.7 (BI_DA_TAP)
/QSGMII PHY/ETH10_TAP_1: C434.2, J21.12 (BI_DB_TAP)
/QSGMII PHY/ETH10_TAP_2: C435.2, J21.4 (BI_DC_TAP)
/QSGMII PHY/ETH10_TAP_3: C436.2, J21.8 (BI_DD_TAP)
/QSGMII PHY/ETH11_D0_N: J21.21 (BI_DA_N), U1.J2 (P10_D1_N), U46.1 (LINE_1), U46.10 (NC_1)
/QSGMII PHY/ETH11_D0_P: J21.15 (BI_DA_P), U1.J1 (P10_D1_P), U46.2 (NC_2), U46.9 (LINE_2)
/QSGMII PHY/ETH11_D1_N: J21.16 (BI_DB_N), U1.K2 (P10_D0_N), U46.4 (LINE_3), U46.7 (NC_3)
/QSGMII PHY/ETH11_D1_P: J21.23 (BI_DB_P), U1.K1 (P10_D0_P), U46.5 (NC_4), U46.6 (LINE_4)
/QSGMII PHY/ETH11_D2_N: J21.24 (BI_DC_N), U1.G2 (P10_D3_N), U47.1 (LINE_1), U47.10 (NC_1)
/QSGMII PHY/ETH11_D2_P: J21.18 (BI_DC_P), U1.G1 (P10_D3_P), U47.2 (NC_2), U47.9 (LINE_2)
/QSGMII PHY/ETH11_D3_N: J21.19 (BI_DD_N), U1.H2 (P10_D2_N), U47.4 (LINE_3), U47.7 (NC_3)
/QSGMII PHY/ETH11_D3_P: J21.26 (BI_DD_P), U1.H1 (P10_D2_P), U47.5 (NC_4), U47.6 (LINE_4)
/QSGMII PHY/ETH11_TAP_0: C437.2, J21.14 (BI_DA_TAP)
/QSGMII PHY/ETH11_TAP_1: C438.2, J21.22 (BI_DB_TAP)
/QSGMII PHY/ETH11_TAP_2: C439.2, J21.17 (BI_DC_TAP)
/QSGMII PHY/ETH11_TAP_3: C440.2, J21.25 (BI_DD_TAP)
/QSGMII PHY/GTX_REFCLK_156M25_N: C343.2, U2.D5 (GTX_REFCLK_0_N)
/QSGMII PHY/GTX_REFCLK_156M25_P: C342.2, U2.D6 (GTX_REFCLK_0_P)
/QSGMII PHY/GTX_REFCLK_SPARE_N: C341.2, U2.F5 (GTX_REFCLK_1_N)
/QSGMII PHY/GTX_REFCLK_SPARE_P: C340.2, U2.F6 (GTX_REFCLK_1_P)
/QSGMII PHY/PHY0_LED0_N: J4.31 (LED1_N), R81.1
/QSGMII PHY/PHY0_LED1_N: J4.33 (LED2_G_N), R93.1
/QSGMII PHY/PHY1_LED0_N: J4.27 (LED1_N), R82.1
/QSGMII PHY/PHY1_LED1_N: J4.29 (LED2_G_N), R94.1
/QSGMII PHY/PHY2_LED0_N: J8.31 (LED1_N), R83.1
/QSGMII PHY/PHY2_LED1_N: J8.33 (LED2_G_N), R95.1
/QSGMII PHY/PHY3_LED0_N: J8.27 (LED1_N), R84.1
/QSGMII PHY/PHY3_LED1_N: J8.29 (LED2_G_N), R96.1
/QSGMII PHY/PHY4_LED0_N: J18.31 (LED1_N), R85.1
/QSGMII PHY/PHY4_LED1_N: J18.33 (LED2_G_N), R97.1
/QSGMII PHY/PHY5_LED0_N: J18.27 (LED1_N), R86.1
/QSGMII PHY/PHY5_LED1_N: J18.29 (LED2_G_N), R98.1
/QSGMII PHY/PHY6_LED0_N: J19.31 (LED1_N), R87.1
/QSGMII PHY/PHY6_LED1_N: J19.33 (LED2_G_N), R99.1
/QSGMII PHY/PHY7_LED0_N: J19.27 (LED1_N), R88.1
/QSGMII PHY/PHY7_LED1_N: J19.29 (LED2_G_N), R100.1
/QSGMII PHY/PHY8_LED0_N: J20.31 (LED1_N), R89.1
/QSGMII PHY/PHY8_LED1_N: J20.33 (LED2_G_N), R101.1
/QSGMII PHY/PHY9_LED0_N: J20.27 (LED1_N), R90.1
/QSGMII PHY/PHY9_LED1_N: J20.29 (LED2_G_N), R102.1
/QSGMII PHY/PHY10_LED0_N: J21.31 (LED1_N), R91.1
/QSGMII PHY/PHY10_LED1_N: J21.33 (LED2_G_N), R103.1
/QSGMII PHY/PHY11_LED0_N: J21.27 (LED1_N), R92.1
/QSGMII PHY/PHY11_LED1_N: J21.29 (LED2_G_N), R104.1
/QSGMII PHY/PHY_REFCLK_125MHZ_N: C468.2, U1.AA8 (REFCLK_N)
/QSGMII PHY/PHY_REFCLK_125MHZ_P: C467.2, U1.Y8 (REFCLK_P)
/QSGMII PHY/QSGMII_0_RX_AC_N: C337.2, U1.AA17 (SERDES_E1_TX_N)
/QSGMII PHY/QSGMII_0_RX_AC_P: C336.2, U1.Y17 (SERDES_E1_TX_P)
/QSGMII PHY/QSGMII_0_RX_N: C337.1, U2.C3 (GTX_RX_2_N)
/QSGMII PHY/QSGMII_0_RX_P: C336.1, U2.C4 (GTX_RX_2_P)
/QSGMII PHY/QSGMII_0_TX_AC_N: C335.2, U1.AF17 (SERDES_E1_RX_N)
/QSGMII PHY/QSGMII_0_TX_AC_P: C334.2, U1.AE17 (SERDES_E1_RX_P)
/QSGMII PHY/QSGMII_0_TX_N: C335.1, U2.B1 (GTX_TX_2_N)
/QSGMII PHY/QSGMII_0_TX_P: C334.1, U2.B2 (GTX_TX_2_P)
/QSGMII PHY/QSGMII_1_RX_AC_N: C347.2, U1.AA13 (SERDES_E2_TX_N)
/QSGMII PHY/QSGMII_1_RX_AC_P: C346.2, U1.Y13 (SERDES_E2_TX_P)
/QSGMII PHY/QSGMII_1_RX_N: C347.1, U2.E3 (GTX_RX_1_N)
/QSGMII PHY/QSGMII_1_RX_P: C346.1, U2.E4 (GTX_RX_1_P)
/QSGMII PHY/QSGMII_1_TX_AC_N: C339.2, U1.AF13 (SERDES_E2_RX_N)
/QSGMII PHY/QSGMII_1_TX_AC_P: C338.2, U1.AE13 (SERDES_E2_RX_P)
/QSGMII PHY/QSGMII_1_TX_N: C339.1, U2.D1 (GTX_TX_1_N)
/QSGMII PHY/QSGMII_1_TX_P: C338.1, U2.D2 (GTX_TX_1_P)
/QSGMII PHY/QSGMII_2_RX_AC_N: C351.2, U1.Y9 (SERDES_E3_TX_P)
/QSGMII PHY/QSGMII_2_RX_AC_P: C350.2, U1.AA9 (SERDES_E3_TX_N)
/QSGMII PHY/QSGMII_2_RX_N: C351.1, U2.G3 (GTX_RX_0_N)
/QSGMII PHY/QSGMII_2_RX_P: C350.1, U2.G4 (GTX_RX_0_P)
/QSGMII PHY/QSGMII_2_TX_AC_N: C349.2, U1.AF9 (SERDES_E3_RX_N)
/QSGMII PHY/QSGMII_2_TX_AC_P: C348.2, U1.AE9 (SERDES_E3_RX_P)
/QSGMII PHY/QSGMII_2_TX_N: C349.1, U2.F1 (GTX_TX_0_N)
/QSGMII PHY/QSGMII_2_TX_P: C348.1, U2.F2 (GTX_TX_0_P)
/QSGMII PHY/SFP_I2C_SCL: J1.5 (SCL), R79.1, U4.P4 (I2C2_SCL)
/QSGMII PHY/SFP_I2C_SDA: J1.4 (SDA), R78.1, U4.R5 (I2C2_SDA)
/QSGMII PHY/SFP_MOD_ABS: J1.6 (MOD_ABS), U4.J1 (PH0)
/QSGMII PHY/SFP_RS0: J1.7 (RS0), U4.K1 (PH1)
/QSGMII PHY/SFP_RS1: J1.9 (RS1), U4.R4 (PH3)
/QSGMII PHY/SFP_RX_LOS: J1.8 (RX_LOS), U4.N4 (PH2)
/QSGMII PHY/SFP_RX_N: J1.12 (RX_N), U2.B6 (GTX_RX_3_P)
/QSGMII PHY/SFP_RX_P: J1.13 (RX_P), U2.B5 (GTX_RX_3_N)
/QSGMII PHY/SFP_TX_DISABLE: J1.3 (TX_DISABLE), U4.P15 (PH6)
/QSGMII PHY/SFP_TX_FAULT: J1.2 (TX_FAULT), U4.N15 (PH12)
/QSGMII PHY/SFP_TX_N: J1.19 (TX_N), U2.A4 (GTX_TX_3_P)
/QSGMII PHY/SFP_TX_P: J1.18 (TX_P), U2.A3 (GTX_TX_3_N)
/QSGMII PHY/SFP_VDD_RX: C471.1, C473.1, J1.15 (VDD_RX), L6.1
/QSGMII PHY/SFP_VDD_TX: C472.1, C474.1, J1.16 (VDD_TX), L7.1
/QSGMII PHY/VSC_CLKOUT_0: TP20.1, U1.AE2 (RCVRD_CLK0)
/QSGMII PHY/VSC_CLKOUT_1: TP19.1, U1.AD3 (RCVRD_CLK1)
/QSGMII PHY/VSC_FAST_STATUS: U1.R1 (FAST_LINK_STATUS), U31.4 (B)
/QSGMII PHY/VSC_FAST_STATUS_1V8: U31.3 (A); also elsewhere on the board
/QSGMII PHY/VSC_JTAG_TCK: J3.6 (TCK), U1.D17 (JTAG_TCK)
/QSGMII PHY/VSC_JTAG_TDI: J3.10 (TDI_OUT), U1.D18 (JTAG_TDI)
/QSGMII PHY/VSC_JTAG_TDO: J3.8 (TDO_IN), U1.D19 (JTAG_TDO)
/QSGMII PHY/VSC_JTAG_TMS: J3.4 (TMS), U1.D20 (JTAG_TMS)
/QSGMII PHY/VSC_MDC: U1.AF4 (MDC), U33.4 (B)
/QSGMII PHY/VSC_MDC_1V8: U33.3 (A); also elsewhere on the board
/QSGMII PHY/VSC_MDINT: R133.1, U1.R2 (MDINT), U32.4 (B)
/QSGMII PHY/VSC_MDINT_1V8: U32.3 (A); also elsewhere on the board
/QSGMII PHY/VSC_MDIO: R132.1, U1.AF3 (MDIO), U34.4 (B)
/QSGMII PHY/VSC_MDIO_1V8: U34.3 (A); also elsewhere on the board
/QSGMII PHY/VSC_MDIO_OE: U34.5 (DIR); also elsewhere on the board
/QSGMII PHY/VSC_POWERDOWN: R107.1, U1.C3 (COMA_MODE), U4.B12 (PH14)
/QSGMII PHY/VSC_RST_N: R106.2, U1.C4 (RST#), U4.D12 (PH15)
unnamed: C340.1, U24.4 (OUT_P)
unnamed: C341.1, U24.5 (OUT_N)
unnamed: C342.1, U25.4 (OUT_P)
unnamed: C343.1, U25.5 (OUT_N)
unnamed: C467.1, U35.4 (OUT_P)
unnamed: C468.1, U35.5 (OUT_N)
unnamed: C469.1, C470.1, L6.2, L7.2, R134.1
unnamed: C471.2, R135.2
unnamed: C472.2, R136.2
unnamed: R80.1, U2.H2 (GTX_RREF)
unnamed: R80.2, U2.H1 (GTX_VTTRCAL)
unnamed: R83.2, U1.U4 (PHY3_LED0)
unnamed: R84.2, U1.V1 (PHY2_LED0)
unnamed: R85.2, U1.U2 (PHY5_LED0)
unnamed: R86.2, U1.U3 (PHY4_LED0)
unnamed: R87.2, U1.T4 (PHY7_LED0)
unnamed: R88.2, U1.U1 (PHY6_LED0)
unnamed: R89.2, U1.T2 (PHY9_LED0)
unnamed: R90.2, U1.T3 (PHY8_LED0)
unnamed: R91.2, U1.R4 (PHY11_LED0)
unnamed: R92.2, U1.T1 (PHY10_LED0)
unnamed: R93.2, U1.AA2 (PHY1_LED1)
unnamed: R94.2, U1.AA3 (PHY0_LED1)
unnamed: R95.2, U1.Y4 (PHY3_LED1)
unnamed: R96.2, U1.AA1 (PHY2_LED1)
unnamed: R97.2, U1.Y2 (PHY5_LED1)
unnamed: R98.2, U1.Y3 (PHY4_LED1)
unnamed: R99.2, U1.W4 (PHY7_LED1)
unnamed: R100.2, U1.Y1 (PHY6_LED1)
unnamed: R101.2, U1.W2 (PHY9_LED1)
unnamed: R102.2, U1.W3 (PHY8_LED1)
unnamed: R103.2, U1.V4 (PHY11_LED1)
unnamed: R104.2, U1.W1 (PHY10_LED1)
unnamed: R105.1, U1.AE22 (SERDES_REXT0)
unnamed: R105.2, U1.AF22 (SERDES_REXT1)
unnamed: R108.2, U1.D21 (JTAG_TRST)
unnamed: R110.2, U1.E13 (REF_REXT1)
unnamed: C353.1, U1.E14 (REF_FILT1)
unnamed: R109.2, U1.K4 (REF_REXT2)
unnamed: R111.2, U1.K23 (REF_REXT0)
unnamed: C352.1, U1.L4 (REF_FILT2)
unnamed: C354.1, U1.L23 (REF_FILT0)
unnamed: R81.2, U1.V2 (PHY1_LED0)
unnamed: R82.2, U1.V3 (PHY0_LED0)

Notes on the sheet:
Polarity swap Invert in FPGA
Refclk is LVDS (must be AC coupled) and internally terminated / biased (Fig. 12 on page 16)
Verify LEDs and diffpairs match up to the same port Verify all pin swaps comply with rules for PHY
ESD protection
Center tap termination capacitors
Can use 156.25 for both Provide a second oscillator footprint just in case
Strap: Refclk is 125 MHz
VSC8512 Hardware Design Checklist Section 8.2 page 23
Open drain
Level shifting for LVCMOS25 GPIOs to FPGA
Per table 5 (page 23) Can swap A/B pairs Can swap C/D pairs But cannot swap A/B with C/D
!!SIGNOFF REVIEW CHECK!!
One LED per RJ45 (bi color) but VSC8512 has two single LED pins
SFP+ power filtering
Strap: PHY addr MSBs = 2'b00
