azonenberg/latentpacket/latentpink/pcb/latentpink.kicad_pcb

## KiCad design latentpink/pcb/latentpink.kicad_pcb (continued)

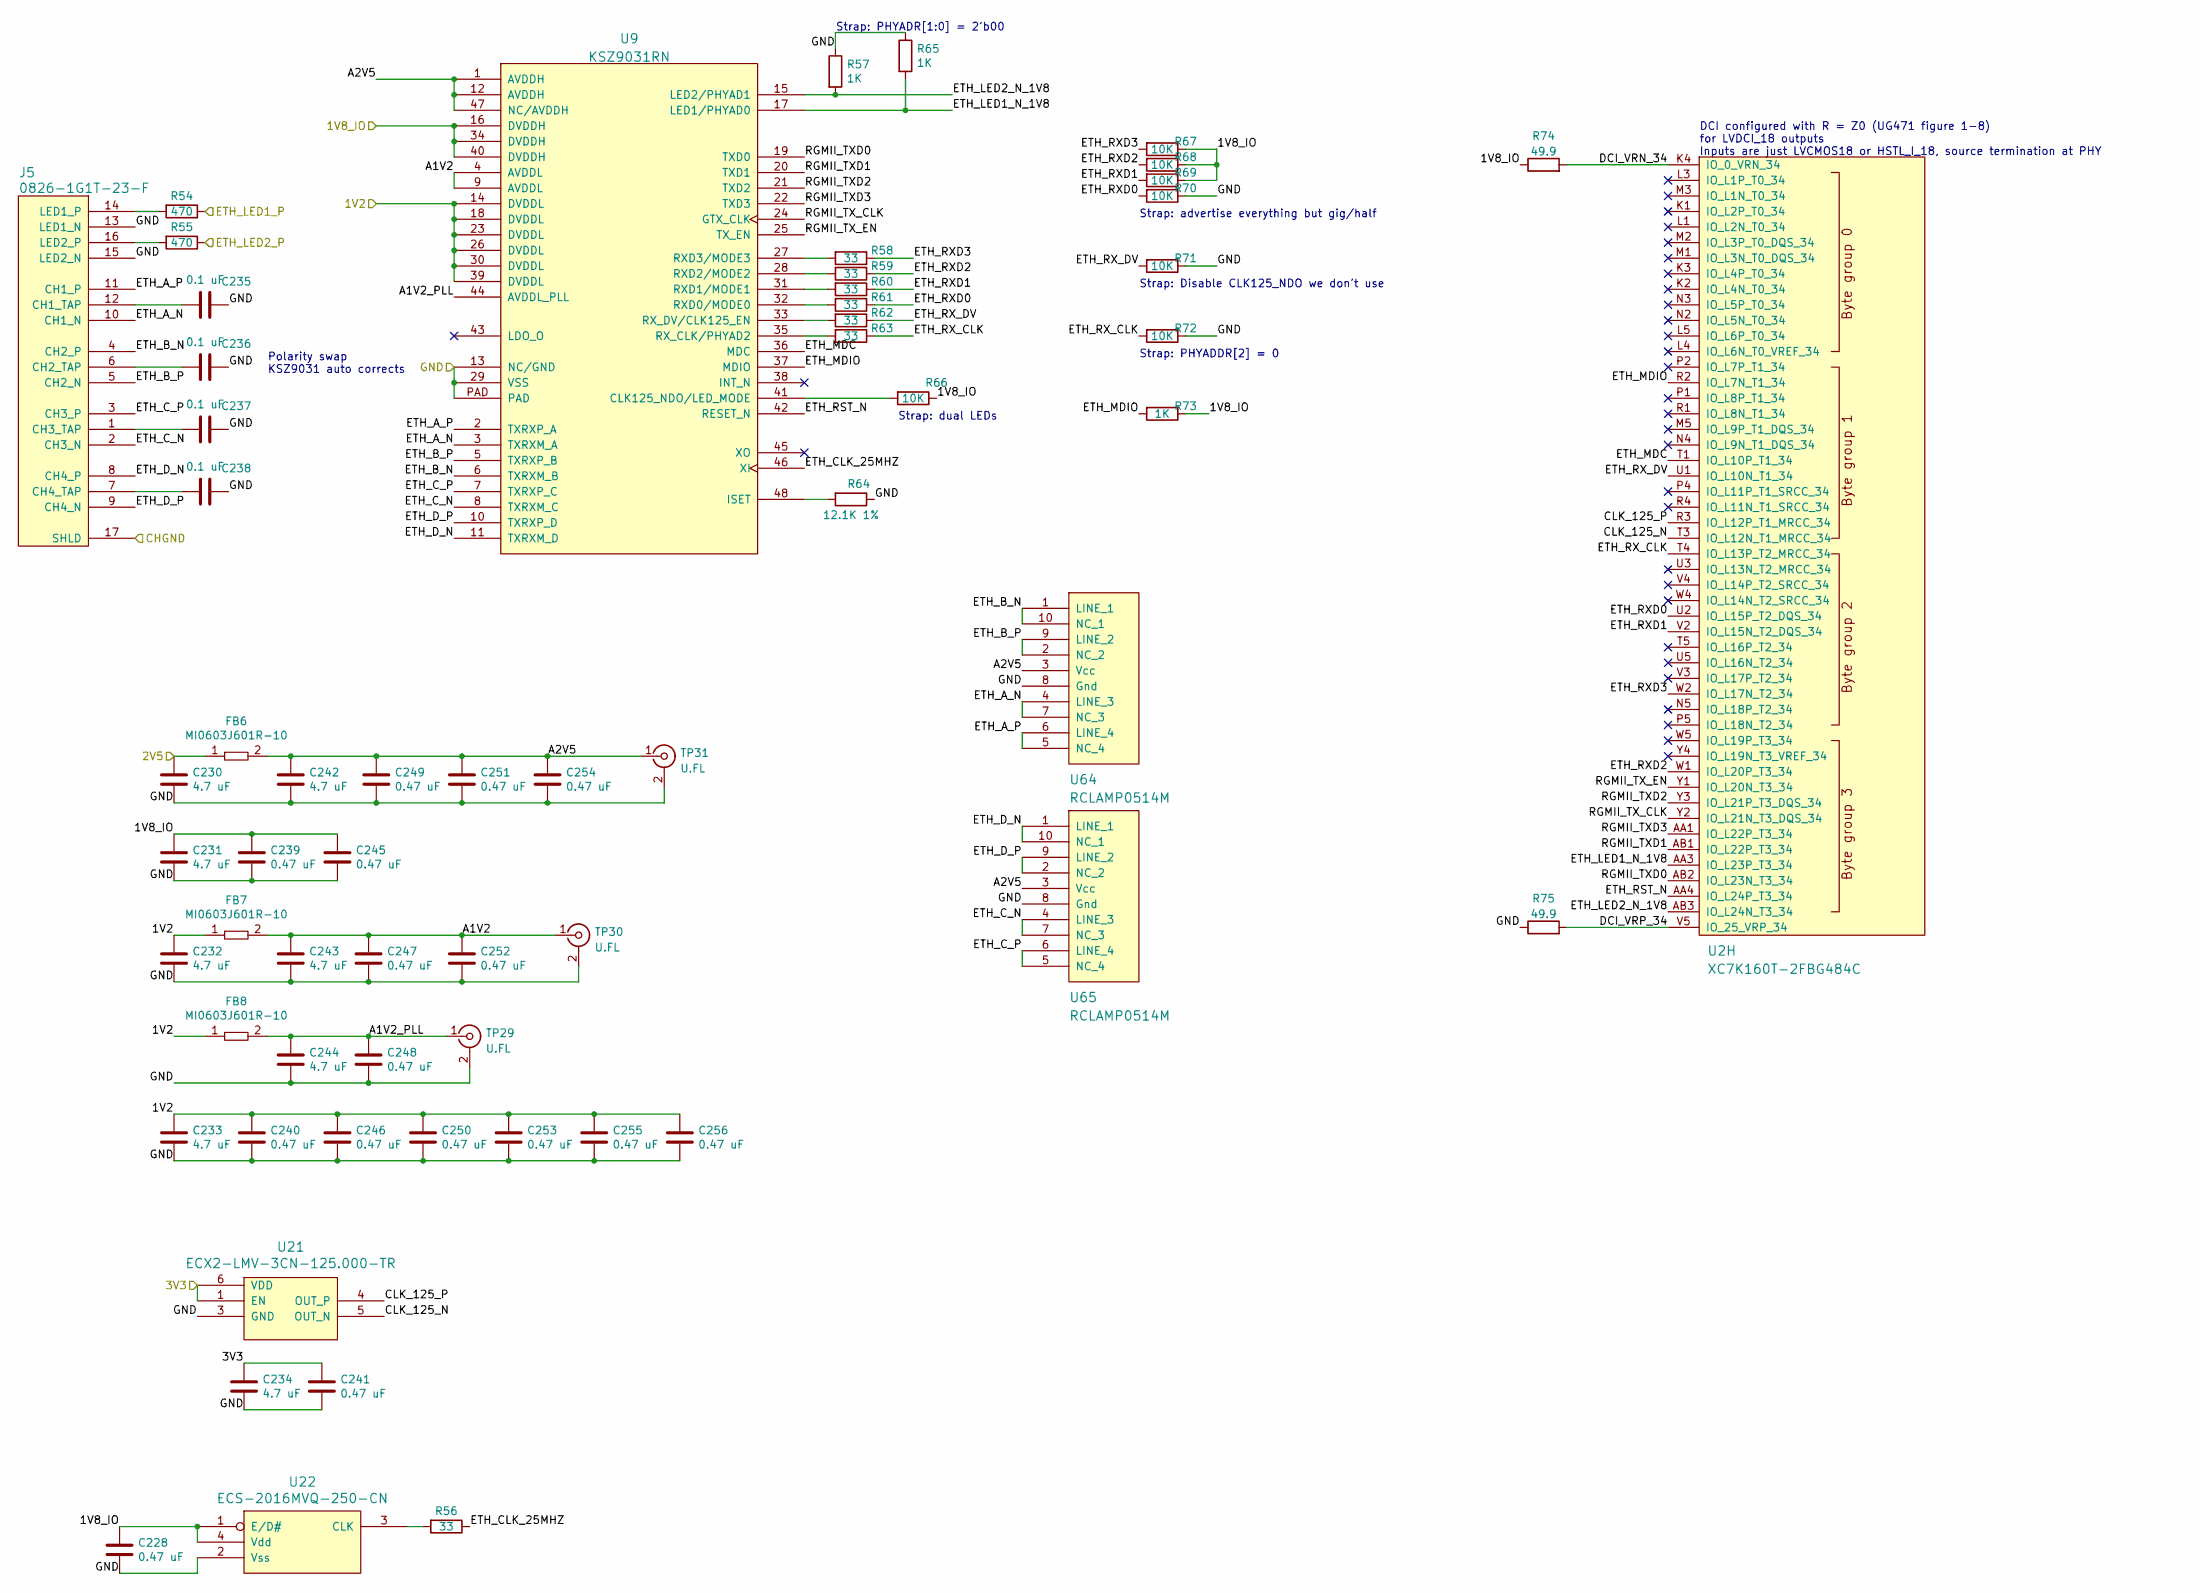
[picture p8: schematic rgmii.kicad_sch]

Parts:
C228, C239, C240, C241, C245, C246, C247, C248, C249, C250, C251, C252, C253, C254, C255, C256: 0.47 uF; EIA_0402_CAP_NOSILK
C230, C231, C232, C233, C234, C242, C243, C244: 4.7 uF; EIA_0603_CAP_NOSILK
C235, C236, C237, C238: 0.1 uF; EIA_0402_CAP_NOSILK
FB6, FB7, FB8: MI0603J601R-10; EIA_0603_INDUCTOR_NOSILK
J5: 0826-1G1T-23-F; CONN_BELFUSE_0826_1G1T_23_F
R54, R55: 470; EIA_0402_RES_NOSILK
R56, R58, R59, R60, R61, R62, R63: 33; EIA_0402_RES_NOSILK
R57, R65, R73: 1K; EIA_0402_RES_NOSILK
R64: 12.1K 1%; EIA_0402_RES_NOSILK
R66, R67, R68, R69, R70, R71, R72: 10K; EIA_0402_RES_NOSILK
R74, R75: 49.9; EIA_0402_RES_NOSILK
TP29, TP30, TP31: U.FL; CONN_U.FL_TE_1909763-1
U2: XC7K160T-2FBG484C; BGA_484_22x22_FULLARRAY_1MM
U9: KSZ9031RN; QFN_48_0.5MM_7x7MM
U21: ECX2-LMV-3CN-125.000-TR; OSCILLATOR_LVDS_3.2x2.5
U22: ECS-2016MVQ-250-CN; OSCILLATOR_2.0x1.6
U64, U65: RCLAMP0514M; SOP_10_0.5MM_3MM

Connections:
/1V2: C232.1, C233.1, C240.1, C246.1, C250.1, C253.1, C255.1, C256.1, FB7.1, FB8.1, U9.14 (DVDDL), U9.18 (DVDDL), U9.23 (DVDDL), U9.26 (DVDDL), U9.30 (DVDDL), U9.39 (DVDDL); also elsewhere on the board
/1V8_IO: C228.1, C231.1, C239.1, C245.1, R66.1, R67.1, R68.1, R69.1, R73.1, R74.1, U9.16 (DVDDH), U9.34 (DVDDH), U9.40 (DVDDH), U22.1 (E/D#), U22.4 (Vdd); also elsewhere on the board
/2V5: C230.1, FB6.1; also elsewhere on the board
/3V3: C234.1, C241.1, U21.1 (EN), U21.6 (VDD); also elsewhere on the board
/CHGND: J5.17 (SHLD); also elsewhere on the board
/GND: C228.2, C230.2, C231.2, C232.2, C233.2, C234.2, C235.1, C236.1, C237.1, C238.1, C239.2, C240.2, C241.2, C242.2, C243.2, C244.2, C245.2, C246.2, C247.2, C248.2, C249.2, C250.2, C251.2, C252.2, C253.2, C254.2, C255.2, C256.2, J5.13 (LED1_N), J5.15 (LED2_N), R57.1, R64.1, R65.1, R70.1, R71.1, R72.1, R75.1, TP29.2 (Ext), TP30.2 (Ext), TP31.2 (Ext), U9.13 (NC/GND), U9.29 (VSS), U9.PAD, U21.3 (GND), U22.2 (Vss), U64.8 (Gnd), U65.8 (Gnd); also elsewhere on the board
/Management/ETH_LED1_P: R54.1; also elsewhere on the board
/Management/ETH_LED2_P: R55.1; also elsewhere on the board
/Management/RGMII PHY/A1V2: C243.1, C247.1, C252.1, FB7.2, TP30.1 (In), U9.4 (AVDDL), U9.9 (AVDDL)
/Management/RGMII PHY/A1V2_PLL: C244.1, C248.1, FB8.2, TP29.1 (In), U9.44 (AVDDL_PLL)
/Management/RGMII PHY/A2V5: C242.1, C249.1, C251.1, C254.1, FB6.2, TP31.1 (In), U9.1 (AVDDH), U9.12 (AVDDH), U9.47 (NC/AVDDH), U64.3 (Vcc), U65.3 (Vcc)
/Management/RGMII PHY/CLK_125_N: U2.T3 (IO_L12N_T1_MRCC_34), U21.5 (OUT_N)
/Management/RGMII PHY/CLK_125_P: U2.R3 (IO_L12P_T1_MRCC_34), U21.4 (OUT_P)
/Management/RGMII PHY/DCI_VRN_34: R74.2, U2.K4 (IO_0_VRN_34)
/Management/RGMII PHY/DCI_VRP_34: R75.2, U2.V5 (IO_25_VRP_34)
/Management/RGMII PHY/ETH_A_N: J5.10 (CH1_N), U9.3 (TXRXM_A), U64.4 (LINE_3), U64.7 (NC_3)
/Management/RGMII PHY/ETH_A_P: J5.11 (CH1_P), U9.2 (TXRXP_A), U64.5 (NC_4), U64.6 (LINE_4)
/Management/RGMII PHY/ETH_B_N: J5.4 (CH2_P), U9.6 (TXRXM_B), U64.1 (LINE_1), U64.10 (NC_1)
/Management/RGMII PHY/ETH_B_P: J5.5 (CH2_N), U9.5 (TXRXP_B), U64.2 (NC_2), U64.9 (LINE_2)
/Management/RGMII PHY/ETH_CLK_25MHZ: R56.1, U9.46 (XI)
/Management/RGMII PHY/ETH_C_N: J5.2 (CH3_N), U9.8 (TXRXM_C), U65.4 (LINE_3), U65.7 (NC_3)
/Management/RGMII PHY/ETH_C_P: J5.3 (CH3_P), U9.7 (TXRXP_C), U65.5 (NC_4), U65.6 (LINE_4)
/Management/RGMII PHY/ETH_D_N: J5.8 (CH4_P), U9.11 (TXRXM_D), U65.1 (LINE_1), U65.10 (NC_1)
/Management/RGMII PHY/ETH_D_P: J5.9 (CH4_N), U9.10 (TXRXP_D), U65.2 (NC_2), U65.9 (LINE_2)
/Management/RGMII PHY/ETH_LED1_N_1V8: R65.2, U2.AA3 (IO_L23P_T3_34), U9.17 (LED1/PHYAD0)
/Management/RGMII PHY/ETH_LED2_N_1V8: R57.2, U2.AB3 (IO_L24N_T3_34), U9.15 (LED2/PHYAD1)
/Management/RGMII PHY/ETH_MDC: U2.T1 (IO_L10P_T1_34), U9.36 (MDC)
/Management/RGMII PHY/ETH_MDIO: R73.2, U2.R2 (IO_L7N_T1_34), U9.37 (MDIO)
/Management/RGMII PHY/ETH_RST_N: U2.AA4 (IO_L24P_T3_34), U9.42 (RESET_N)
/Management/RGMII PHY/ETH_RXD0: R61.1, R70.2, U2.U2 (IO_L15P_T2_DQS_34)
/Management/RGMII PHY/ETH_RXD1: R60.1, R69.2, U2.V2 (IO_L15N_T2_DQS_34)
/Management/RGMII PHY/ETH_RXD2: R59.1, R68.2, U2.W1 (IO_L20P_T3_34)
/Management/RGMII PHY/ETH_RXD3: R58.1, R67.2, U2.W2 (IO_L17N_T2_34)
/Management/RGMII PHY/ETH_RX_CLK: R63.1, R72.2, U2.T4 (IO_L13P_T2_MRCC_34)
/Management/RGMII PHY/ETH_RX_DV: R62.1, R71.2, U2.U1 (IO_L10N_T1_34)
/Management/RGMII PHY/RGMII_TXD0: U2.AB2 (IO_L23N_T3_34), U9.19 (TXD0)
/Management/RGMII PHY/RGMII_TXD1: U2.AB1 (IO_L22P_T3_34), U9.20 (TXD1)
/Management/RGMII PHY/RGMII_TXD2: U2.Y3 (IO_L21P_T3_DQS_34), U9.21 (TXD2)
/Management/RGMII PHY/RGMII_TXD3: U2.AA1 (IO_L22P_T3_34), U9.22 (TXD3)
/Management/RGMII PHY/RGMII_TX_CLK: U2.Y2 (IO_L21N_T3_DQS_34), U9.24 (GTX_CLK)
/Management/RGMII PHY/RGMII_TX_EN: U2.Y1 (IO_L20N_T3_34), U9.25 (TX_EN)
unnamed: C235.2, J5.12 (CH1_TAP)
unnamed: C236.2, J5.6 (CH2_TAP)
unnamed: C237.2, J5.1 (CH3_TAP)
unnamed: C238.2, J5.7 (CH4_TAP)
unnamed: J5.14 (LED1_P), R54.2
unnamed: J5.16 (LED2_P), R55.2
unnamed: R56.2, U22.3 (CLK)
unnamed: R58.2, U9.27 (RXD3/MODE3)
unnamed: R59.2, U9.28 (RXD2/MODE2)
unnamed: R60.2, U9.31 (RXD1/MODE1)
unnamed: R61.2, U9.32 (RXD0/MODE0)
unnamed: R62.2, U9.33 (RX_DV/CLK125_EN)
unnamed: R63.2, U9.35 (RX_CLK/PHYAD2)
unnamed: R66.2, U9.41 (CLK125_NDO/LED_MODE)
unnamed: R64.2, U9.48 (ISET)

Notes on the sheet:
Strap: Disable CLK125_NDO we don't use
Polarity swap KSZ9031 auto corrects
Strap: PHYADR[1:0] = 2'b00
Strap: advertise everything but gig/half
Strap: PHYADDR[2] = 0
Strap: dual LEDs
DCI configured with R = Z0 (UG471 figure 1-8) for LVDCI_18 outputs Inputs are just LVCMOS18 or HSTL_I_18, source termination at PHY

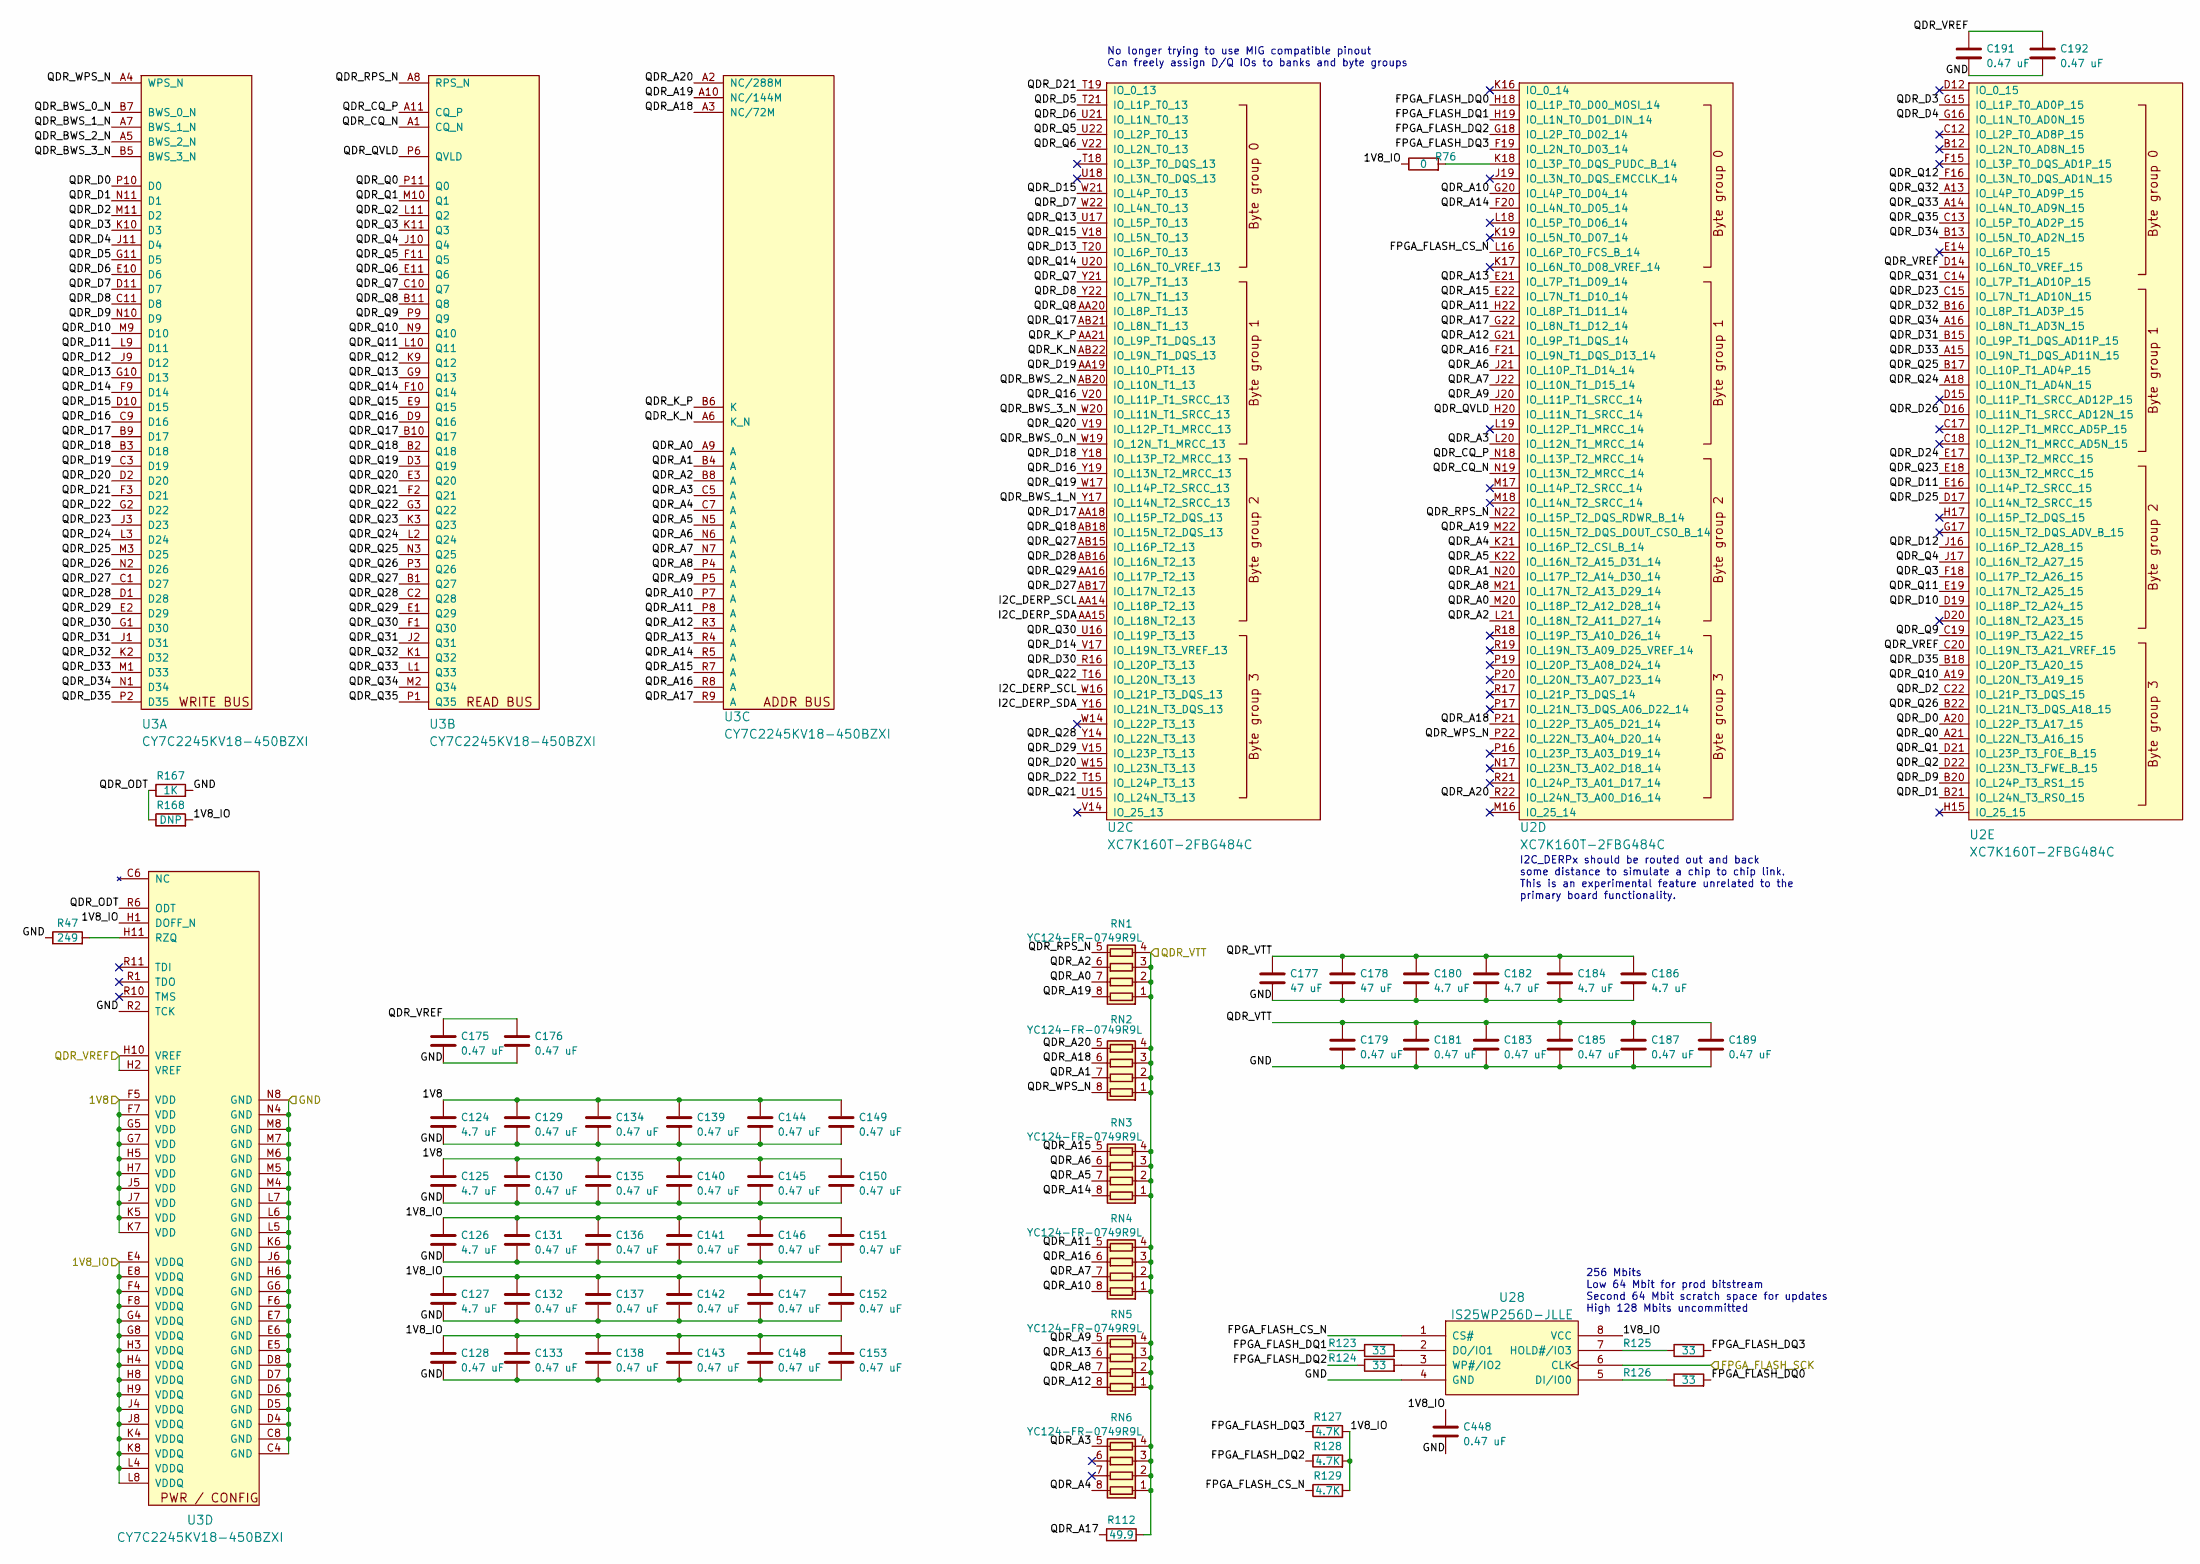
[picture p9: schematic qdr.kicad_sch]

Parts:
C124, C125, C126, C127, C180, C182, C184, C186: 4.7 uF; EIA_0603_CAP_NOSILK
C128, C129, C130, C131, C132, C133, C134, C135, C136, C137, C138, C139, C140, C141, C142, C143, C144, C145, C146, C147, C148, C149, C150, C151, C152, C153, C175, C176, C179, C181, C183, C185, C187, C189, C191, C192, C448: 0.47 uF; EIA_0402_CAP_NOSILK
C177, C178: 47 uF; EIA_1206_CAP_NOSILK
R47: 249; EIA_0402_RES_NOSILK
R76: 0; EIA_0402_RES_NOSILK
R112: 49.9; EIA_0402_RES_NOSILK
R123, R124, R125, R126: 33; EIA_0402_RES_NOSILK
R127, R128, R129: 4.7K; EIA_0402_RES_NOSILK
R167: 1K; EIA_0402_RES_NOSILK
R168: DNP; EIA_0402_RES_NOSILK
RN1, RN2, RN3, RN4, RN5, RN6: YC124-FR-0749R9L; YAGEO_YC124-FR
U2: XC7K160T-2FBG484C; BGA_484_22x22_FULLARRAY_1MM
U3: CY7C2245KV18-450BZXI; BGA_165_11x15_FULLARRAY_1MM
U28: IS25WP256D-JLLE; DFN_8_1.27MM_8x6MM

Connections:
/1V8: C124.1, C125.1, C129.1, C130.1, C134.1, C135.1, C139.1, C140.1, C144.1, C145.1, C149.1, C150.1, U3.F5 (VDD), U3.F7 (VDD), U3.G5 (VDD), U3.G7 (VDD), U3.H5 (VDD), U3.H7 (VDD), U3.J5 (VDD), U3.J7 (VDD), U3.K5 (VDD), U3.K7 (VDD); also elsewhere on the board
/1V8_IO: C126.1, C127.1, C128.1, C131.1, C132.1, C133.1, C136.1, C137.1, C138.1, C141.1, C142.1, C143.1, C146.1, C147.1, C148.1, C151.1, C152.1, C153.1, C448.1, R76.1, R127.2, R128.2, R129.2, R168.2, U3.E4 (VDDQ), U3.E8 (VDDQ), U3.F4 (VDDQ), U3.F8 (VDDQ), U3.G4 (VDDQ), U3.G8 (VDDQ), U3.H1 (DOFF_N), U3.H3 (VDDQ), U3.H4 (VDDQ), U3.H8 (VDDQ), U3.H9 (VDDQ), U3.J4 (VDDQ), U3.J8 (VDDQ), U3.K4 (VDDQ), U3.K8 (VDDQ), U3.L4 (VDDQ), U3.L8 (VDDQ), U28.8 (VCC); also elsewhere on the board
/FPGA/FPGA_FLASH_SCK: U28.6 (CLK); also elsewhere on the board
/FPGA/QDR SRAM/FPGA_FLASH_CS_N: R129.1, U2.L16 (IO_L6P_T0_FCS_B_14), U28.1 (CS#)
/FPGA/QDR SRAM/FPGA_FLASH_DQ0: R126.2, U2.H18 (IO_L1P_T0_D00_MOSI_14)
/FPGA/QDR SRAM/FPGA_FLASH_DQ1: R123.1, U2.H19 (IO_L1N_T0_D01_DIN_14)
/FPGA/QDR SRAM/FPGA_FLASH_DQ2: R124.1, R128.1, U2.G18 (IO_L2P_T0_D02_14)
/FPGA/QDR SRAM/FPGA_FLASH_DQ3: R125.2, R127.1, U2.F19 (IO_L2N_T0_D03_14)
/FPGA/QDR SRAM/I2C_DERP_SCL: U2.AA14 (IO_L18P_T2_13), U2.W16 (IO_L21P_T3_DQS_13)
/FPGA/QDR SRAM/I2C_DERP_SDA: U2.AA15 (IO_L18N_T2_13), U2.Y16 (IO_L21N_T3_DQS_13)
/FPGA/QDR SRAM/QDR_A0: RN1.7 (R2.2), U2.M20 (IO_L18P_T2_A12_D28_14), U3.A9 (A)
/FPGA/QDR SRAM/QDR_A1: RN2.7 (R2.2), U2.N20 (IO_L17P_T2_A14_D30_14), U3.B4 (A)
/FPGA/QDR SRAM/QDR_A2: RN1.6 (R3.2), U2.L21 (IO_L18N_T2_A11_D27_14), U3.B8 (A)
/FPGA/QDR SRAM/QDR_A3: RN6.5 (R4.2), U2.L20 (IO_L12N_T1_MRCC_14), U3.C5 (A)
/FPGA/QDR SRAM/QDR_A4: RN6.8 (R1.2), U2.K21 (IO_L16P_T2_CSI_B_14), U3.C7 (A)
/FPGA/QDR SRAM/QDR_A5: RN3.7 (R2.2), U2.K22 (IO_L16N_T2_A15_D31_14), U3.N5 (A)
/FPGA/QDR SRAM/QDR_A6: RN3.6 (R3.2), U2.J21 (IO_L10P_T1_D14_14), U3.N6 (A)
/FPGA/QDR SRAM/QDR_A7: RN4.7 (R2.2), U2.J22 (IO_L10N_T1_D15_14), U3.N7 (A)
/FPGA/QDR SRAM/QDR_A8: RN5.7 (R2.2), U2.M21 (IO_L17N_T2_A13_D29_14), U3.P4 (A)
/FPGA/QDR SRAM/QDR_A9: RN5.5 (R4.2), U2.J20 (IO_L11P_T1_SRCC_14), U3.P5 (A)
/FPGA/QDR SRAM/QDR_A10: RN4.8 (R1.2), U2.G20 (IO_L4P_T0_D04_14), U3.P7 (A)
/FPGA/QDR SRAM/QDR_A11: RN4.5 (R4.2), U2.H22 (IO_L8P_T1_D11_14), U3.P8 (A)
/FPGA/QDR SRAM/QDR_A12: RN5.8 (R1.2), U2.G21 (IO_L9P_T1_DQS_14), U3.R3 (A)
/FPGA/QDR SRAM/QDR_A13: RN5.6 (R3.2), U2.E21 (IO_L7P_T1_D09_14), U3.R4 (A)
/FPGA/QDR SRAM/QDR_A14: RN3.8 (R1.2), U2.F20 (IO_L4N_T0_D05_14), U3.R5 (A)
/FPGA/QDR SRAM/QDR_A15: RN3.5 (R4.2), U2.E22 (IO_L7N_T1_D10_14), U3.R7 (A)
/FPGA/QDR SRAM/QDR_A16: RN4.6 (R3.2), U2.F21 (IO_L9N_T1_DQS_D13_14), U3.R8 (A)
/FPGA/QDR SRAM/QDR_A17: R112.1, U2.G22 (IO_L8N_T1_D12_14), U3.R9 (A)
/FPGA/QDR SRAM/QDR_A18: RN2.6 (R3.2), U2.P21 (IO_L22P_T3_A05_D21_14), U3.A3 (NC/72M)
/FPGA/QDR SRAM/QDR_A19: RN1.8 (R1.2), U2.M22 (IO_L15N_T2_DQS_DOUT_CSO_B_14), U3.A10 (NC/144M)
/FPGA/QDR SRAM/QDR_A20: RN2.5 (R4.2), U2.R22 (IO_L24N_T3_A00_D16_14), U3.A2 (NC/288M)
/FPGA/QDR SRAM/QDR_BWS_0_N: U2.W19 (IO_12N_T1_MRCC_13), U3.B7 (BWS_0_N)
/FPGA/QDR SRAM/QDR_BWS_1_N: U2.Y17 (IO_L14N_T2_SRCC_13), U3.A7 (BWS_1_N)
/FPGA/QDR SRAM/QDR_BWS_2_N: U2.AB20 (IO_L10N_T1_13), U3.A5 (BWS_2_N)
/FPGA/QDR SRAM/QDR_BWS_3_N: U2.W20 (IO_L11N_T1_SRCC_13), U3.B5 (BWS_3_N)
/FPGA/QDR SRAM/QDR_CQ_N: U2.N19 (IO_L13N_T2_MRCC_14), U3.A1 (CQ_N)
/FPGA/QDR SRAM/QDR_CQ_P: U2.N18 (IO_L13P_T2_MRCC_14), U3.A11 (CQ_P)
/FPGA/QDR SRAM/QDR_D0: U2.A20 (IO_L22P_T3_A17_15), U3.P10 (D0)
/FPGA/QDR SRAM/QDR_D1: U2.B21 (IO_L24N_T3_RS0_15), U3.N11 (D1)
/FPGA/QDR SRAM/QDR_D2: U2.C22 (IO_L21P_T3_DQS_15), U3.M11 (D2)
/FPGA/QDR SRAM/QDR_D3: U2.G15 (IO_L1P_T0_AD0P_15), U3.K10 (D3)
/FPGA/QDR SRAM/QDR_D4: U2.G16 (IO_L1N_T0_AD0N_15), U3.J11 (D4)
/FPGA/QDR SRAM/QDR_D5: U2.T21 (IO_L1P_T0_13), U3.G11 (D5)
/FPGA/QDR SRAM/QDR_D6: U2.U21 (IO_L1N_T0_13), U3.E10 (D6)
/FPGA/QDR SRAM/QDR_D7: U2.W22 (IO_L4N_T0_13), U3.D11 (D7)
/FPGA/QDR SRAM/QDR_D8: U2.Y22 (IO_L7N_T1_13), U3.C11 (D8)
/FPGA/QDR SRAM/QDR_D9: U2.B20 (IO_L24P_T3_RS1_15), U3.N10 (D9)
/FPGA/QDR SRAM/QDR_D10: U2.D19 (IO_L18P_T2_A24_15), U3.M9 (D10)
/FPGA/QDR SRAM/QDR_D11: U2.E16 (IO_L14P_T2_SRCC_15), U3.L9 (D11)
/FPGA/QDR SRAM/QDR_D12: U2.J16 (IO_L16P_T2_A28_15), U3.J9 (D12)
/FPGA/QDR SRAM/QDR_D13: U2.T20 (IO_L6P_T0_13), U3.G10 (D13)
/FPGA/QDR SRAM/QDR_D14: U2.V17 (IO_L19N_T3_VREF_13), U3.F9 (D14)
/FPGA/QDR SRAM/QDR_D15: U2.W21 (IO_L4P_T0_13), U3.D10 (D15)
/FPGA/QDR SRAM/QDR_D16: U2.Y19 (IO_L13N_T2_MRCC_13), U3.C9 (D16)
/FPGA/QDR SRAM/QDR_D17: U2.AA18 (IO_L15P_T2_DQS_13), U3.B9 (D17)
/FPGA/QDR SRAM/QDR_D18: U2.Y18 (IO_L13P_T2_MRCC_13), U3.B3 (D18)
/FPGA/QDR SRAM/QDR_D19: U2.AA19 (IO_L10_PT1_13), U3.C3 (D19)
/FPGA/QDR SRAM/QDR_D20: U2.W15 (IO_L23N_T3_13), U3.D2 (D20)
/FPGA/QDR SRAM/QDR_D21: U2.T19 (IO_0_13), U3.F3 (D21)
/FPGA/QDR SRAM/QDR_D22: U2.T15 (IO_L24P_T3_13), U3.G2 (D22)
/FPGA/QDR SRAM/QDR_D23: U2.C15 (IO_L7N_T1_AD10N_15), U3.J3 (D23)
/FPGA/QDR SRAM/QDR_D24: U2.E17 (IO_L13P_T2_MRCC_15), U3.L3 (D24)
/FPGA/QDR SRAM/QDR_D25: U2.D17 (IO_L14N_T2_SRCC_15), U3.M3 (D25)
/FPGA/QDR SRAM/QDR_D26: U2.D16 (IO_L11N_T1_SRCC_AD12N_15), U3.N2 (D26)
/FPGA/QDR SRAM/QDR_D27: U2.AB17 (IO_L17N_T2_13), U3.C1 (D27)
/FPGA/QDR SRAM/QDR_D28: U2.AB16 (IO_L16N_T2_13), U3.D1 (D28)
/FPGA/QDR SRAM/QDR_D29: U2.V15 (IO_L23P_T3_13), U3.E2 (D29)
/FPGA/QDR SRAM/QDR_D30: U2.R16 (IO_L20P_T3_13), U3.G1 (D30)
/FPGA/QDR SRAM/QDR_D31: U2.B15 (IO_L9P_T1_DQS_AD11P_15), U3.J1 (D31)
/FPGA/QDR SRAM/QDR_D32: U2.B16 (IO_L8P_T1_AD3P_15), U3.K2 (D32)
/FPGA/QDR SRAM/QDR_D33: U2.A15 (IO_L9N_T1_DQS_AD11N_15), U3.M1 (D33)
/FPGA/QDR SRAM/QDR_D34: U2.B13 (IO_L5N_T0_AD2N_15), U3.N1 (D34)
/FPGA/QDR SRAM/QDR_D35: U2.B18 (IO_L20P_T3_A20_15), U3.P2 (D35)
/FPGA/QDR SRAM/QDR_K_N: U2.AB22 (IO_L9N_T1_DQS_13), U3.A6 (K_N)
/FPGA/QDR SRAM/QDR_K_P: U2.AA21 (IO_L9P_T1_DQS_13), U3.B6 (K)
/FPGA/QDR SRAM/QDR_ODT: R167.1, R168.1, U3.R6 (ODT)
/FPGA/QDR SRAM/QDR_Q0: U2.A21 (IO_L22N_T3_A16_15), U3.P11 (Q0)
/FPGA/QDR SRAM/QDR_Q1: U2.D21 (IO_L23P_T3_FOE_B_15), U3.M10 (Q1)
/FPGA/QDR SRAM/QDR_Q2: U2.D22 (IO_L23N_T3_FWE_B_15), U3.L11 (Q2)
/FPGA/QDR SRAM/QDR_Q3: U2.F18 (IO_L17P_T2_A26_15), U3.K11 (Q3)
/FPGA/QDR SRAM/QDR_Q4: U2.J17 (IO_L16N_T2_A27_15), U3.J10 (Q4)
/FPGA/QDR SRAM/QDR_Q5: U2.U22 (IO_L2P_T0_13), U3.F11 (Q5)
/FPGA/QDR SRAM/QDR_Q6: U2.V22 (IO_L2N_T0_13), U3.E11 (Q6)
/FPGA/QDR SRAM/QDR_Q7: U2.Y21 (IO_L7P_T1_13), U3.C10 (Q7)
/FPGA/QDR SRAM/QDR_Q8: U2.AA20 (IO_L8P_T1_13), U3.B11 (Q8)
/FPGA/QDR SRAM/QDR_Q9: U2.C19 (IO_L19P_T3_A22_15), U3.P9 (Q9)
/FPGA/QDR SRAM/QDR_Q10: U2.A19 (IO_L20N_T3_A19_15), U3.N9 (Q10)
/FPGA/QDR SRAM/QDR_Q11: U2.E19 (IO_L17N_T2_A25_15), U3.L10 (Q11)
/FPGA/QDR SRAM/QDR_Q12: U2.F16 (IO_L3N_T0_DQS_AD1N_15), U3.K9 (Q12)
/FPGA/QDR SRAM/QDR_Q13: U2.U17 (IO_L5P_T0_13), U3.G9 (Q13)
/FPGA/QDR SRAM/QDR_Q14: U2.U20 (IO_L6N_T0_VREF_13), U3.F10 (Q14)
/FPGA/QDR SRAM/QDR_Q15: U2.V18 (IO_L5N_T0_13), U3.E9 (Q15)
/FPGA/QDR SRAM/QDR_Q16: U2.V20 (IO_L11P_T1_SRCC_13), U3.D9 (Q16)
/FPGA/QDR SRAM/QDR_Q17: U2.AB21 (IO_L8N_T1_13), U3.B10 (Q17)
/FPGA/QDR SRAM/QDR_Q18: U2.AB18 (IO_L15N_T2_DQS_13), U3.B2 (Q18)
/FPGA/QDR SRAM/QDR_Q19: U2.W17 (IO_L14P_T2_SRCC_13), U3.D3 (Q19)
/FPGA/QDR SRAM/QDR_Q20: U2.V19 (IO_L12P_T1_MRCC_13), U3.E3 (Q20)
/FPGA/QDR SRAM/QDR_Q21: U2.U15 (IO_L24N_T3_13), U3.F2 (Q21)
/FPGA/QDR SRAM/QDR_Q22: U2.T16 (IO_L20N_T3_13), U3.G3 (Q22)
/FPGA/QDR SRAM/QDR_Q23: U2.E18 (IO_L13N_T2_MRCC_15), U3.K3 (Q23)
/FPGA/QDR SRAM/QDR_Q24: U2.A18 (IO_L10N_T1_AD4N_15), U3.L2 (Q24)
/FPGA/QDR SRAM/QDR_Q25: U2.B17 (IO_L10P_T1_AD4P_15), U3.N3 (Q25)
/FPGA/QDR SRAM/QDR_Q26: U2.B22 (IO_L21N_T3_DQS_A18_15), U3.P3 (Q26)
/FPGA/QDR SRAM/QDR_Q27: U2.AB15 (IO_L16P_T2_13), U3.B1 (Q27)
/FPGA/QDR SRAM/QDR_Q28: U2.Y14 (IO_L22N_T3_13), U3.C2 (Q28)
/FPGA/QDR SRAM/QDR_Q29: U2.AA16 (IO_L17P_T2_13), U3.E1 (Q29)
/FPGA/QDR SRAM/QDR_Q30: U2.U16 (IO_L19P_T3_13), U3.F1 (Q30)
/FPGA/QDR SRAM/QDR_Q31: U2.C14 (IO_L7P_T1_AD10P_15), U3.J2 (Q31)
/FPGA/QDR SRAM/QDR_Q32: U2.A13 (IO_L4P_T0_AD9P_15), U3.K1 (Q32)
/FPGA/QDR SRAM/QDR_Q33: U2.A14 (IO_L4N_T0_AD9N_15), U3.L1 (Q33)
/FPGA/QDR SRAM/QDR_Q34: U2.A16 (IO_L8N_T1_AD3N_15), U3.M2 (Q34)
/FPGA/QDR SRAM/QDR_Q35: U2.C13 (IO_L5P_T0_AD2P_15), U3.P1 (Q35)
/FPGA/QDR SRAM/QDR_QVLD: U2.H20 (IO_L11N_T1_SRCC_14), U3.P6 (QVLD)
/FPGA/QDR SRAM/QDR_RPS_N: RN1.5 (R4.2), U2.N22 (IO_L15P_T2_DQS_RDWR_B_14), U3.A8 (RPS_N)
/FPGA/QDR SRAM/QDR_WPS_N: RN2.8 (R1.2), U2.P22 (IO_L22N_T3_A04_D20_14), U3.A4 (WPS_N)
/GND: C124.2, C125.2, C126.2, C127.2, C128.2, C129.2, C130.2, C131.2, C132.2, C133.2, C134.2, C135.2, C136.2, C137.2, C138.2, C139.2, C140.2, C141.2, C142.2, C143.2, C144.2, C145.2, C146.2, C147.2, C148.2, C149.2, C150.2, C151.2, C152.2, C153.2, C175.2, C176.2, C177.2, C178.2, C179.2, C180.2, C181.2, C182.2, C183.2, C184.2, C185.2, C186.2, C187.2, C189.2, C191.2, C192.2, C448.2, R47.1, R167.2, U3.C4 (GND), U3.C8 (GND), U3.D4 (GND), U3.D5 (GND), U3.D6 (GND), U3.D7 (GND), U3.D8 (GND), U3.E5 (GND), U3.E6 (GND), U3.E7 (GND), U3.F6 (GND), U3.G6 (GND), U3.H6 (GND), U3.J6 (GND), U3.K6 (GND), U3.L5 (GND), U3.L6 (GND), U3.L7 (GND), U3.M4 (GND), U3.M5 (GND), U3.M6 (GND), U3.M7 (GND), U3.M8 (GND), U3.N4 (GND), U3.N8 (GND), U3.R2 (TCK), U28.4 (GND); also elsewhere on the board
/QDR_VREF: C175.1, C176.1, C191.1, C192.1, U2.C20 (IO_L19N_T3_A21_VREF_15), U2.D14 (IO_L6N_T0_VREF_15), U3.H2 (VREF), U3.H10 (VREF); also elsewhere on the board
/QDR_VTT: C177.1, C178.1, C179.1, C180.1, C181.1, C182.1, C183.1, C184.1, C185.1, C186.1, C187.1, C189.1, R112.2, RN1.1 (R1.1), RN1.2 (R2.1), RN1.3 (R3.1), RN1.4 (R4.1), RN2.1 (R1.1), RN2.2 (R2.1), RN2.3 (R3.1), RN2.4 (R4.1), RN3.1 (R1.1), RN3.2 (R2.1), RN3.3 (R3.1), RN3.4 (R4.1), RN4.1 (R1.1), RN4.2 (R2.1), RN4.3 (R3.1), RN4.4 (R4.1), RN5.1 (R1.1), RN5.2 (R2.1), RN5.3 (R3.1), RN5.4 (R4.1), RN6.1 (R1.1), RN6.2 (R2.1), RN6.3 (R3.1), RN6.4 (R4.1); also elsewhere on the board
unnamed: R47.2, U3.H11 (RZQ)
unnamed: R76.2, U2.K18 (IO_L3P_T0_DQS_PUDC_B_14)
unnamed: R123.2, U28.2 (DO/IO1)
unnamed: R124.2, U28.3 (WP#/IO2)
unnamed: R125.1, U28.7 (HOLD#/IO3)
unnamed: R126.1, U28.5 (DI/IO0)

Notes on the sheet:
No longer trying to use MIG compatible pinout Can freely assign D/Q IOs to banks and byte groups
I2C_DERPx should be routed out and back some distance to simulate a chip to chip link. This is an experimental feature unrelated to the primary board functionality.
256 Mbits Low 64 Mbit for prod bitstream Second 64 Mbit scratch space for updates High 128 Mbits uncommitted
