azonenberg/latentpacket/latentpink/pcb/latentpink.kicad_pcb

## KiCad design latentpink/pcb/latentpink.kicad_pcb (continued)

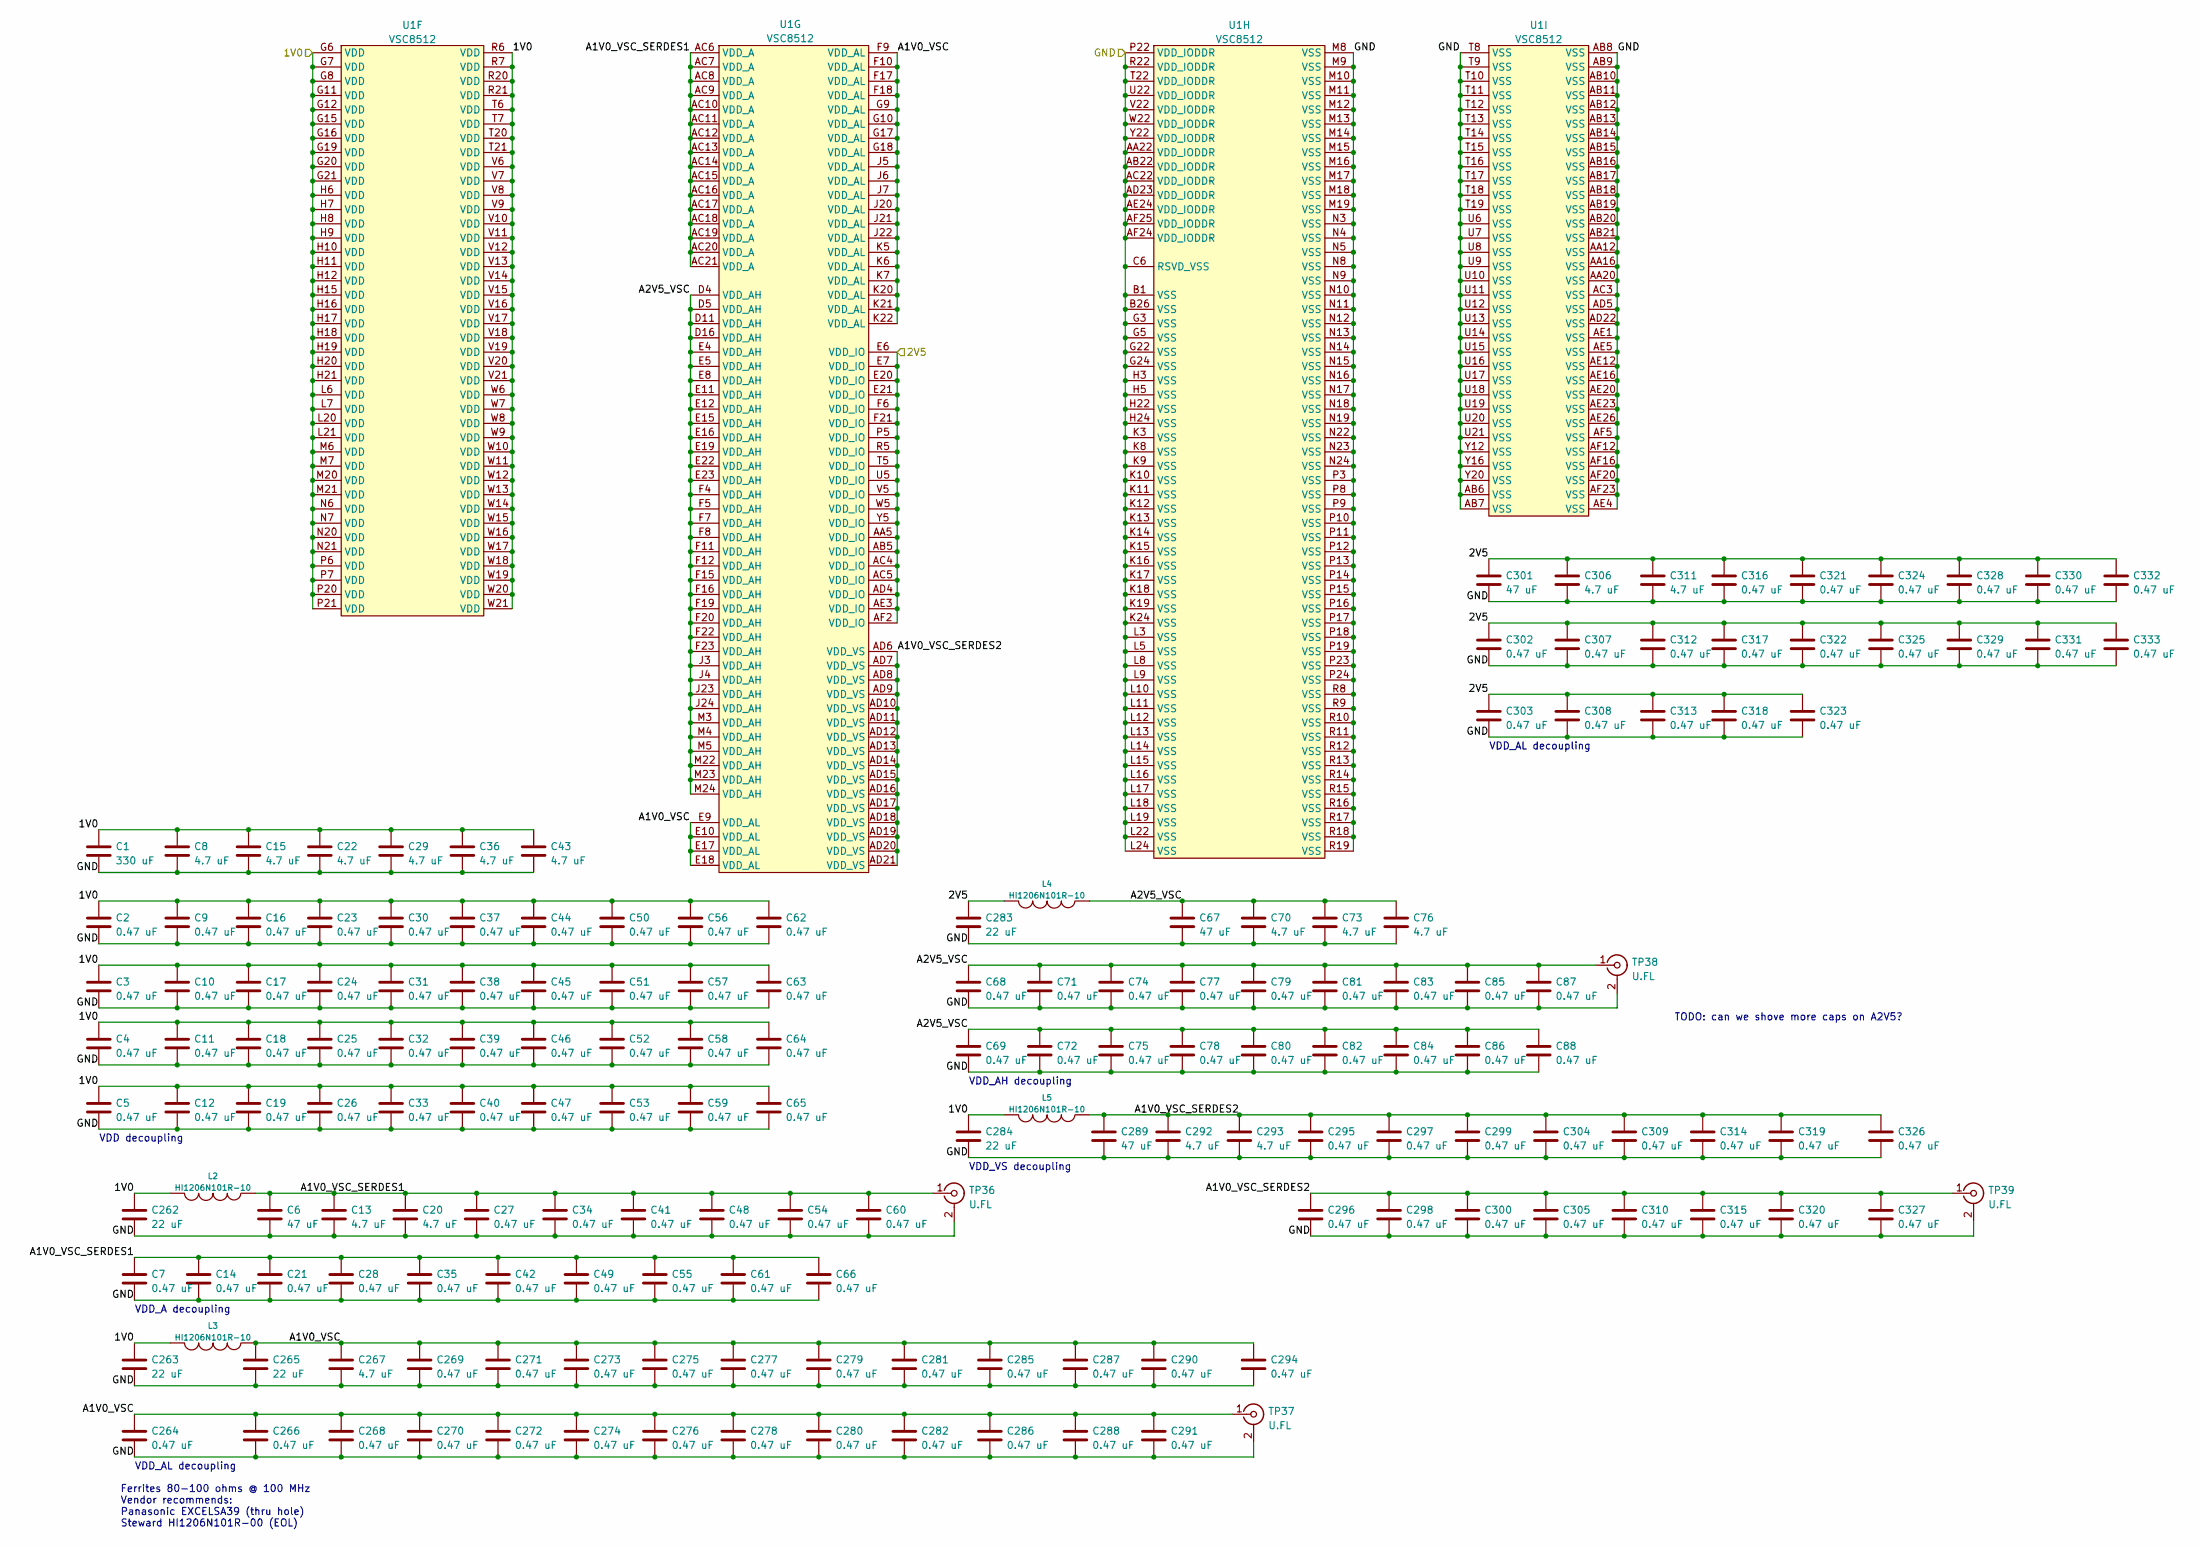
[picture p10: schematic qsgmii-power.kicad_sch]

Parts:
C1: 330 uF; EIA_1210_CAP_NOSILK
C2, C3, C4, C5, C7, C9, C10, C11, C12, C14, C16, C17, C18, C19, C21, C23, C24, C25, C26, C27, C28, C30, C31, C32, C33, C34, C35, C37, C38, C39, C40, C41, C42, C44, C45, C46, C47, C48, C49, C50, C51, C52, C53, C54, C55, C56, C57, C58, C59, C60, C61, C62, C63, C64, C65, C66, C68, C69, C71, C72, C74, C75, C77, C78, C79, C80, C81, C82, C83, C84, C85, C86, C87, C88, C264, C266, C268, C269, C270, C271, C272, C273, C274, C275, C276, C277, C278, C279, C280, C281, C282, C285, C286, C287, C288, C290, C291, C294, C295, C296, C297, C298, C299, C300, C302, C303, C304, C305, C307, C308, C309, C310, C312, C313, C314, C315, C316, C317, C318, C319, C320, C321, C322, C323, C324, C325, C326, C327, C328, C329, C330, C331, C332, C333: 0.47 uF; EIA_0402_CAP_NOSILK
C6: 47 uF; EIA_1206_CAP_NOSILK
C8, C13, C15, C20, C22, C29, C36, C43, C70, C73, C76, C267, C292, C293, C306, C311: 4.7 uF; EIA_0603_CAP_NOSILK
C67, C289, C301: 47 uF; EIA_1210_CAP_NOSILK
C262, C263, C265, C284: 22 uF; EIA_0805_CAP_NOSILK
C283: 22 uF; EIA_1206_CAP_NOSILK
L2, L3, L4, L5: HI1206N101R-10; EIA_1206_CAP_NOSILK
TP36, TP37, TP38, TP39: U.FL; CONN_U.FL_TE_1909763-1
U1: VSC8512; BGA_672_27x27_DEPOPCORNER_1MM

Connections:
/1V0: C1.1, C2.1, C3.1, C4.1, C5.1, C8.1, C9.1, C10.1, C11.1, C12.1, C15.1, C16.1, C17.1, C18.1, C19.1, C22.1, C23.1, C24.1, C25.1, C26.1, C29.1, C30.1, C31.1, C32.1, C33.1, C36.1, C37.1, C38.1, C39.1, C40.1, C43.1, C44.1, C45.1, C46.1, C47.1, C50.1, C51.1, C52.1, C53.1, C56.1, C57.1, C58.1, C59.1, C62.1, C63.1, C64.1, C65.1, C262.1, C263.1, C284.1, L2.2, L3.2, L5.2, U1.G6 (VDD), U1.G7 (VDD), U1.G8 (VDD), U1.G11 (VDD), U1.G12 (VDD), U1.G15 (VDD), U1.G16 (VDD), U1.G19 (VDD), U1.G20 (VDD), U1.G21 (VDD), U1.H6 (VDD), U1.H7 (VDD), U1.H8 (VDD), U1.H9 (VDD), U1.H10 (VDD), U1.H11 (VDD), U1.H12 (VDD), U1.H15 (VDD), U1.H16 (VDD), U1.H17 (VDD), U1.H18 (VDD), U1.H19 (VDD), U1.H20 (VDD), U1.H21 (VDD), U1.L6 (VDD), U1.L7 (VDD), U1.L20 (VDD), U1.L21 (VDD), U1.M6 (VDD), U1.M7 (VDD), U1.M20 (VDD), U1.M21 (VDD), U1.N6 (VDD), U1.N7 (VDD), U1.N20 (VDD), U1.N21 (VDD), U1.P6 (VDD), U1.P7 (VDD), U1.P20 (VDD), U1.P21 (VDD), U1.R6 (VDD), U1.R7 (VDD), U1.R20 (VDD), U1.R21 (VDD), U1.T6 (VDD), U1.T7 (VDD), U1.T20 (VDD), U1.T21 (VDD), U1.V6 (VDD), U1.V7 (VDD), U1.V8 (VDD), U1.V9 (VDD), U1.V10 (VDD), U1.V11 (VDD), U1.V12 (VDD), U1.V13 (VDD), U1.V14 (VDD), U1.V15 (VDD), U1.V16 (VDD), U1.V17 (VDD), U1.V18 (VDD), U1.V19 (VDD), U1.V20 (VDD), U1.V21 (VDD), U1.W6 (VDD), U1.W7 (VDD), U1.W8 (VDD), U1.W9 (VDD), U1.W10 (VDD), U1.W11 (VDD), U1.W12 (VDD), U1.W13 (VDD), U1.W14 (VDD), U1.W15 (VDD), U1.W16 (VDD), U1.W17 (VDD), U1.W18 (VDD), U1.W19 (VDD), U1.W20 (VDD), U1.W21 (VDD); also elsewhere on the board
/2V5: C283.1, C301.1, C302.1, C303.1, C306.1, C307.1, C308.1, C311.1, C312.1, C313.1, C316.1, C317.1, C318.1, C321.1, C322.1, C323.1, C324.1, C325.1, C328.1, C329.1, C330.1, C331.1, C332.1, C333.1, L4.2, U1.AA5 (VDD_IO), U1.AB5 (VDD_IO), U1.AC4 (VDD_IO), U1.AC5 (VDD_IO), U1.AD4 (VDD_IO), U1.AE3 (VDD_IO), U1.AF2 (VDD_IO), U1.E6 (VDD_IO), U1.E7 (VDD_IO), U1.E20 (VDD_IO), U1.E21 (VDD_IO), U1.F6 (VDD_IO), U1.F21 (VDD_IO), U1.P5 (VDD_IO), U1.R5 (VDD_IO), U1.T5 (VDD_IO), U1.U5 (VDD_IO), U1.V5 (VDD_IO), U1.W5 (VDD_IO), U1.Y5 (VDD_IO); also elsewhere on the board
/GND: C1.2, C2.2, C3.2, C4.2, C5.2, C6.2, C7.2, C8.2, C9.2, C10.2, C11.2, C12.2, C13.2, C14.2, C15.2, C16.2, C17.2, C18.2, C19.2, C20.2, C21.2, C22.2, C23.2, C24.2, C25.2, C26.2, C27.2, C28.2, C29.2, C30.2, C31.2, C32.2, C33.2, C34.2, C35.2, C36.2, C37.2, C38.2, C39.2, C40.2, C41.2, C42.2, C43.2, C44.2, C45.2, C46.2, C47.2, C48.2, C49.2, C50.2, C51.2, C52.2, C53.2, C54.2, C55.2, C56.2, C57.2, C58.2, C59.2, C60.2, C61.2, C62.2, C63.2, C64.2, C65.2, C66.2, C67.2, C68.2, C69.2, C70.2, C71.2, C72.2, C73.2, C74.2, C75.2, C76.2, C77.2, C78.2, C79.2, C80.2, C81.2, C82.2, C83.2, C84.2, C85.2, C86.2, C87.2, C88.2, C262.2, C263.2, C264.2, C265.2, C266.2, C267.2, C268.2, C269.2, C270.2, C271.2, C272.2, C273.2, C274.2, C275.2, C276.2, C277.2, C278.2, C279.2, C280.2, C281.2, C282.2, C283.2, C284.2, C285.2, C286.2, C287.2, C288.2, C289.2, C290.2, C291.2, C292.2, C293.2, C294.2, C295.2, C296.2, C297.2, C298.2, C299.2, C300.2, C301.2, C302.2, C303.2, C304.2, C305.2, C306.2, C307.2, C308.2, C309.2, C310.2, C311.2, C312.2, C313.2, C314.2, C315.2, C316.2, C317.2, C318.2, C319.2, C320.2, C321.2, C322.2, C323.2, C324.2, C325.2, C326.2, C327.2, C328.2, C329.2, C330.2, C331.2, C332.2, C333.2, TP36.2 (Ext), TP37.2 (Ext), TP38.2 (Ext), TP39.2 (Ext), U1.AA12 (VSS), U1.AA16 (VSS), U1.AA20 (VSS), U1.AA22 (VDD_IODDR), U1.AB6 (VSS), U1.AB7 (VSS), U1.AB8 (VSS), U1.AB9 (VSS), U1.AB10 (VSS), U1.AB11 (VSS), U1.AB12 (VSS), U1.AB13 (VSS), U1.AB14 (VSS), U1.AB15 (VSS), U1.AB16 (VSS), U1.AB17 (VSS), U1.AB18 (VSS), U1.AB19 (VSS), U1.AB20 (VSS), U1.AB21 (VSS), U1.AB22 (VDD_IODDR), U1.AC3 (VSS), U1.AC22 (VDD_IODDR), U1.AD5 (VSS), U1.AD22 (VSS), U1.AD23 (VDD_IODDR), U1.AE1 (VSS), U1.AE4 (VSS), U1.AE5 (VSS), U1.AE12 (VSS), U1.AE16 (VSS), U1.AE20 (VSS), U1.AE23 (VSS), U1.AE24 (VDD_IODDR), U1.AE26 (VSS), U1.AF5 (VSS), U1.AF12 (VSS), U1.AF16 (VSS), U1.AF20 (VSS), U1.AF23 (VSS), U1.AF24 (VDD_IODDR), U1.AF25 (VDD_IODDR), U1.B1 (VSS), U1.B26 (VSS), U1.C6 (RSVD_VSS), U1.G3 (VSS), U1.G5 (VSS), U1.G22 (VSS), U1.G24 (VSS), U1.H3 (VSS), U1.H5 (VSS), U1.H22 (VSS), U1.H24 (VSS), U1.K3 (VSS), U1.K8 (VSS), U1.K9 (VSS), U1.K10 (VSS), U1.K11 (VSS), U1.K12 (VSS), U1.K13 (VSS), U1.K14 (VSS), U1.K15 (VSS), U1.K16 (VSS), U1.K17 (VSS), U1.K18 (VSS), U1.K19 (VSS), U1.K24 (VSS), U1.L3 (VSS), U1.L5 (VSS), U1.L8 (VSS), U1.L9 (VSS), U1.L10 (VSS), U1.L11 (VSS), U1.L12 (VSS), U1.L13 (VSS), U1.L14 (VSS), U1.L15 (VSS), U1.L16 (VSS), U1.L17 (VSS), U1.L18 (VSS), U1.L19 (VSS), U1.L22 (VSS), U1.L24 (VSS), U1.M8 (VSS), U1.M9 (VSS), U1.M10 (VSS), U1.M11 (VSS), U1.M12 (VSS), U1.M13 (VSS), U1.M14 (VSS), U1.M15 (VSS), U1.M16 (VSS), U1.M17 (VSS), U1.M18 (VSS), U1.M19 (VSS), U1.N3 (VSS), U1.N4 (VSS), U1.N5 (VSS), U1.N8 (VSS), U1.N9 (VSS), U1.N10 (VSS), U1.N11 (VSS), U1.N12 (VSS), U1.N13 (VSS), U1.N14 (VSS), U1.N15 (VSS), U1.N16 (VSS), U1.N17 (VSS), U1.N18 (VSS), U1.N19 (VSS), U1.N22 (VSS), U1.N23 (VSS), U1.N24 (VSS), U1.P3 (VSS), U1.P8 (VSS), U1.P9 (VSS), U1.P10 (VSS), U1.P11 (VSS), U1.P12 (VSS), U1.P13 (VSS), U1.P14 (VSS), U1.P15 (VSS), U1.P16 (VSS), U1.P17 (VSS), U1.P18 (VSS), U1.P19 (VSS), U1.P22 (VDD_IODDR), U1.P23 (VSS), U1.P24 (VSS), U1.R8 (VSS), U1.R9 (VSS), U1.R10 (VSS), U1.R11 (VSS), U1.R12 (VSS), U1.R13 (VSS), U1.R14 (VSS), U1.R15 (VSS), U1.R16 (VSS), U1.R17 (VSS), U1.R18 (VSS), U1.R19 (VSS), U1.R22 (VDD_IODDR), U1.T8 (VSS), U1.T9 (VSS), U1.T10 (VSS), U1.T11 (VSS), U1.T12 (VSS), U1.T13 (VSS), U1.T14 (VSS), U1.T15 (VSS), U1.T16 (VSS), U1.T17 (VSS), U1.T18 (VSS), U1.T19 (VSS), U1.T22 (VDD_IODDR), U1.U6 (VSS), U1.U7 (VSS), U1.U8 (VSS), U1.U9 (VSS), U1.U10 (VSS), U1.U11 (VSS), U1.U12 (VSS), U1.U13 (VSS), U1.U14 (VSS), U1.U15 (VSS), U1.U16 (VSS), U1.U17 (VSS), U1.U18 (VSS), U1.U19 (VSS), U1.U20 (VSS), U1.U21 (VSS), U1.U22 (VDD_IODDR), U1.V22 (VDD_IODDR), U1.W22 (VDD_IODDR), U1.Y12 (VSS), U1.Y16 (VSS), U1.Y20 (VSS), U1.Y22 (VDD_IODDR); also elsewhere on the board
/QSGMII PHY/QSGMII Power/A1V0_VSC: C264.1, C265.1, C266.1, C267.1, C268.1, C269.1, C270.1, C271.1, C272.1, C273.1, C274.1, C275.1, C276.1, C277.1, C278.1, C279.1, C280.1, C281.1, C282.1, C285.1, C286.1, C287.1, C288.1, C290.1, C291.1, C294.1, L3.1, TP37.1 (In), U1.E9 (VDD_AL), U1.E10 (VDD_AL), U1.E17 (VDD_AL), U1.E18 (VDD_AL), U1.F9 (VDD_AL), U1.F10 (VDD_AL), U1.F17 (VDD_AL), U1.F18 (VDD_AL), U1.G9 (VDD_AL), U1.G10 (VDD_AL), U1.G17 (VDD_AL), U1.G18 (VDD_AL), U1.J5 (VDD_AL), U1.J6 (VDD_AL), U1.J7 (VDD_AL), U1.J20 (VDD_AL), U1.J21 (VDD_AL), U1.J22 (VDD_AL), U1.K5 (VDD_AL), U1.K6 (VDD_AL), U1.K7 (VDD_AL), U1.K20 (VDD_AL), U1.K21 (VDD_AL), U1.K22 (VDD_AL)
/QSGMII PHY/QSGMII Power/A1V0_VSC_SERDES1: C6.1, C7.1, C13.1, C14.1, C20.1, C21.1, C27.1, C28.1, C34.1, C35.1, C41.1, C42.1, C48.1, C49.1, C54.1, C55.1, C60.1, C61.1, C66.1, L2.1, TP36.1 (In), U1.AC6 (VDD_A), U1.AC7 (VDD_A), U1.AC8 (VDD_A), U1.AC9 (VDD_A), U1.AC10 (VDD_A), U1.AC11 (VDD_A), U1.AC12 (VDD_A), U1.AC13 (VDD_A), U1.AC14 (VDD_A), U1.AC15 (VDD_A), U1.AC16 (VDD_A), U1.AC17 (VDD_A), U1.AC18 (VDD_A), U1.AC19 (VDD_A), U1.AC20 (VDD_A), U1.AC21 (VDD_A)
/QSGMII PHY/QSGMII Power/A1V0_VSC_SERDES2: C289.1, C292.1, C293.1, C295.1, C296.1, C297.1, C298.1, C299.1, C300.1, C304.1, C305.1, C309.1, C310.1, C314.1, C315.1, C319.1, C320.1, C326.1, C327.1, L5.1, TP39.1 (In), U1.AD6 (VDD_VS), U1.AD7 (VDD_VS), U1.AD8 (VDD_VS), U1.AD9 (VDD_VS), U1.AD10 (VDD_VS), U1.AD11 (VDD_VS), U1.AD12 (VDD_VS), U1.AD13 (VDD_VS), U1.AD14 (VDD_VS), U1.AD15 (VDD_VS), U1.AD16 (VDD_VS), U1.AD17 (VDD_VS), U1.AD18 (VDD_VS), U1.AD19 (VDD_VS), U1.AD20 (VDD_VS), U1.AD21 (VDD_VS)
/QSGMII PHY/QSGMII Power/A2V5_VSC: C67.1, C68.1, C69.1, C70.1, C71.1, C72.1, C73.1, C74.1, C75.1, C76.1, C77.1, C78.1, C79.1, C80.1, C81.1, C82.1, C83.1, C84.1, C85.1, C86.1, C87.1, C88.1, L4.1, TP38.1 (In), U1.D4 (VDD_AH), U1.D5 (VDD_AH), U1.D11 (VDD_AH), U1.D16 (VDD_AH), U1.E4 (VDD_AH), U1.E5 (VDD_AH), U1.E8 (VDD_AH), U1.E11 (VDD_AH), U1.E12 (VDD_AH), U1.E15 (VDD_AH), U1.E16 (VDD_AH), U1.E19 (VDD_AH), U1.E22 (VDD_AH), U1.E23 (VDD_AH), U1.F4 (VDD_AH), U1.F5 (VDD_AH), U1.F7 (VDD_AH), U1.F8 (VDD_AH), U1.F11 (VDD_AH), U1.F12 (VDD_AH), U1.F15 (VDD_AH), U1.F16 (VDD_AH), U1.F19 (VDD_AH), U1.F20 (VDD_AH), U1.F22 (VDD_AH), U1.F23 (VDD_AH), U1.J3 (VDD_AH), U1.J4 (VDD_AH), U1.J23 (VDD_AH), U1.J24 (VDD_AH), U1.M3 (VDD_AH), U1.M4 (VDD_AH), U1.M5 (VDD_AH), U1.M22 (VDD_AH), U1.M23 (VDD_AH), U1.M24 (VDD_AH)

Notes on the sheet:
VDD_AL decoupling
Ferrites 80-100 ohms @ 100 MHz Vendor recommends: Panasonic EXCELSA39 (thru hole) Steward HI1206N101R-00 (EOL)
VDD_A decoupling
VDD_VS decoupling
VDD_AH decoupling
VDD decoupling
TODO: can we shove more caps on A2V5?

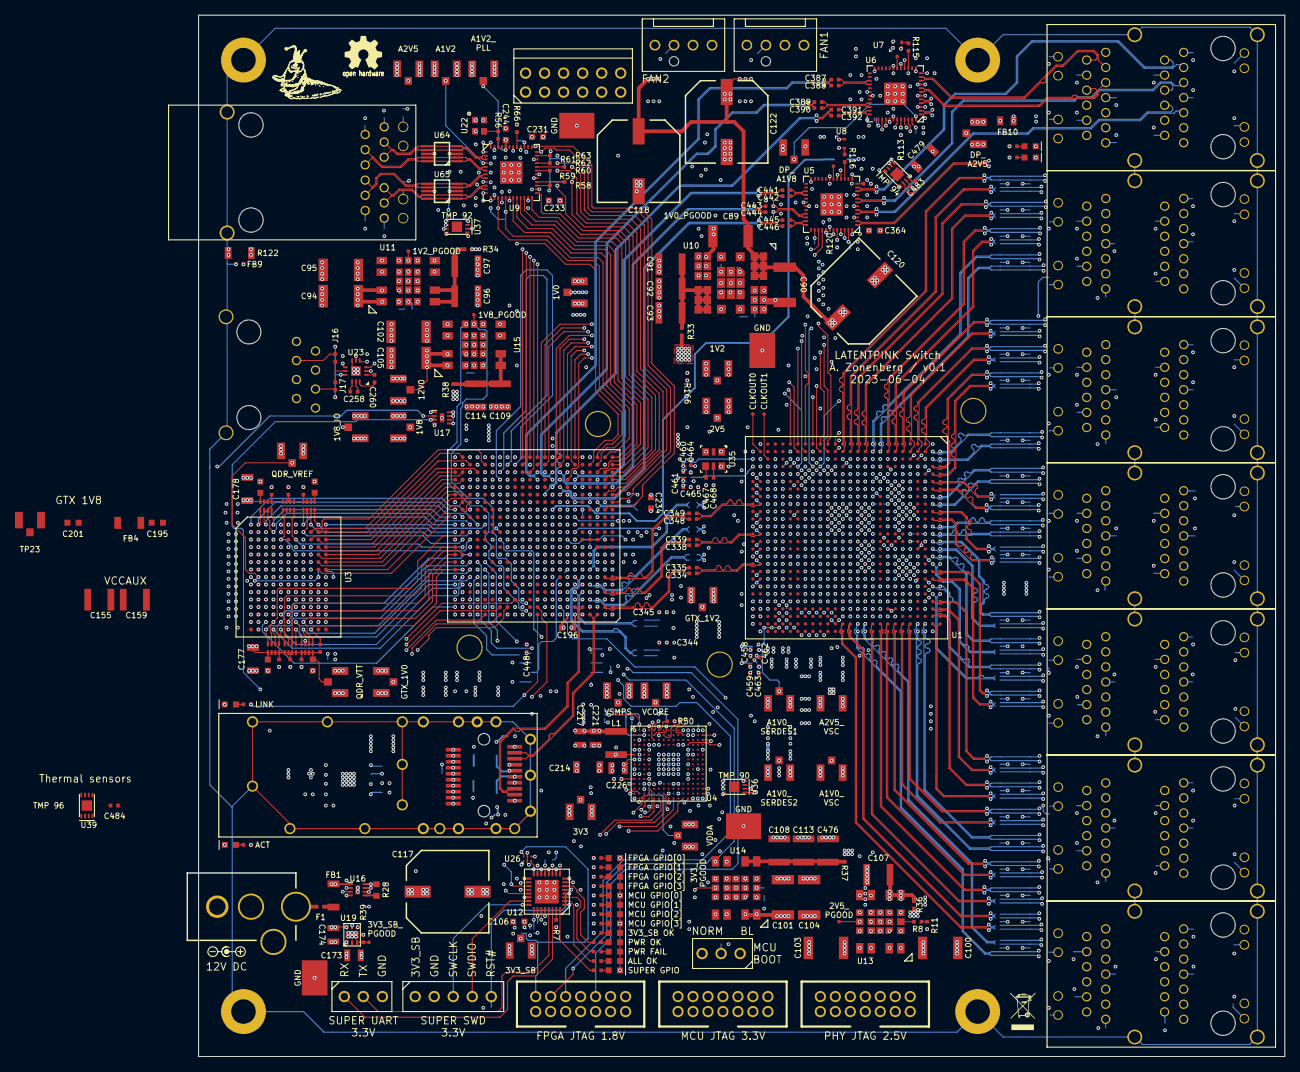
[picture p11: board latentpink.kicad_pcb from above]

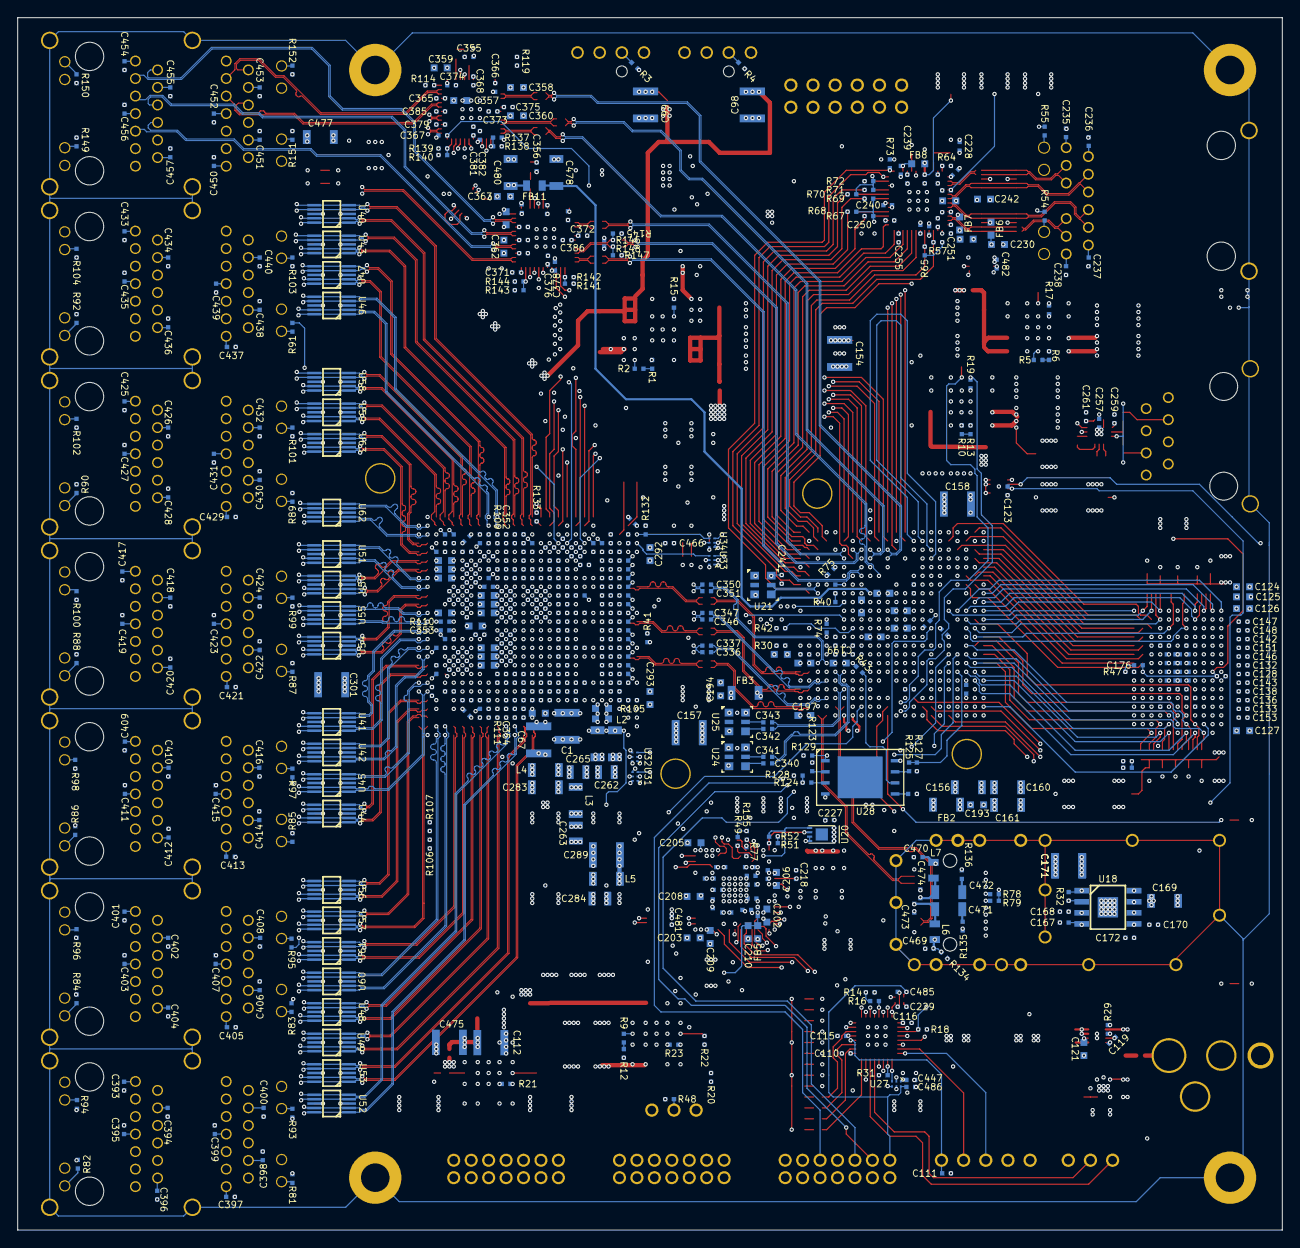
[picture p12: board latentpink.kicad_pcb from below]

Board: 8 copper layers, 145.0 x 139.0 mm, 827 parts (563 on the bottom side), 686 nets.

Other parts of the board:
C171#2: 220 uF; EIA_1210_CAP_NOSILK

Their connections:
/GND: C171#2.2; also elsewhere on the board
/QDR_VTT: C171#2.1; also elsewhere on the board
