azonenberg/latentpacket/latentred/boards/testing/single-phy/single-phy.kicad_pcb

## KiCad design latentred/boards/testing/single-phy/single-phy.kicad_pcb (2023-01-29)

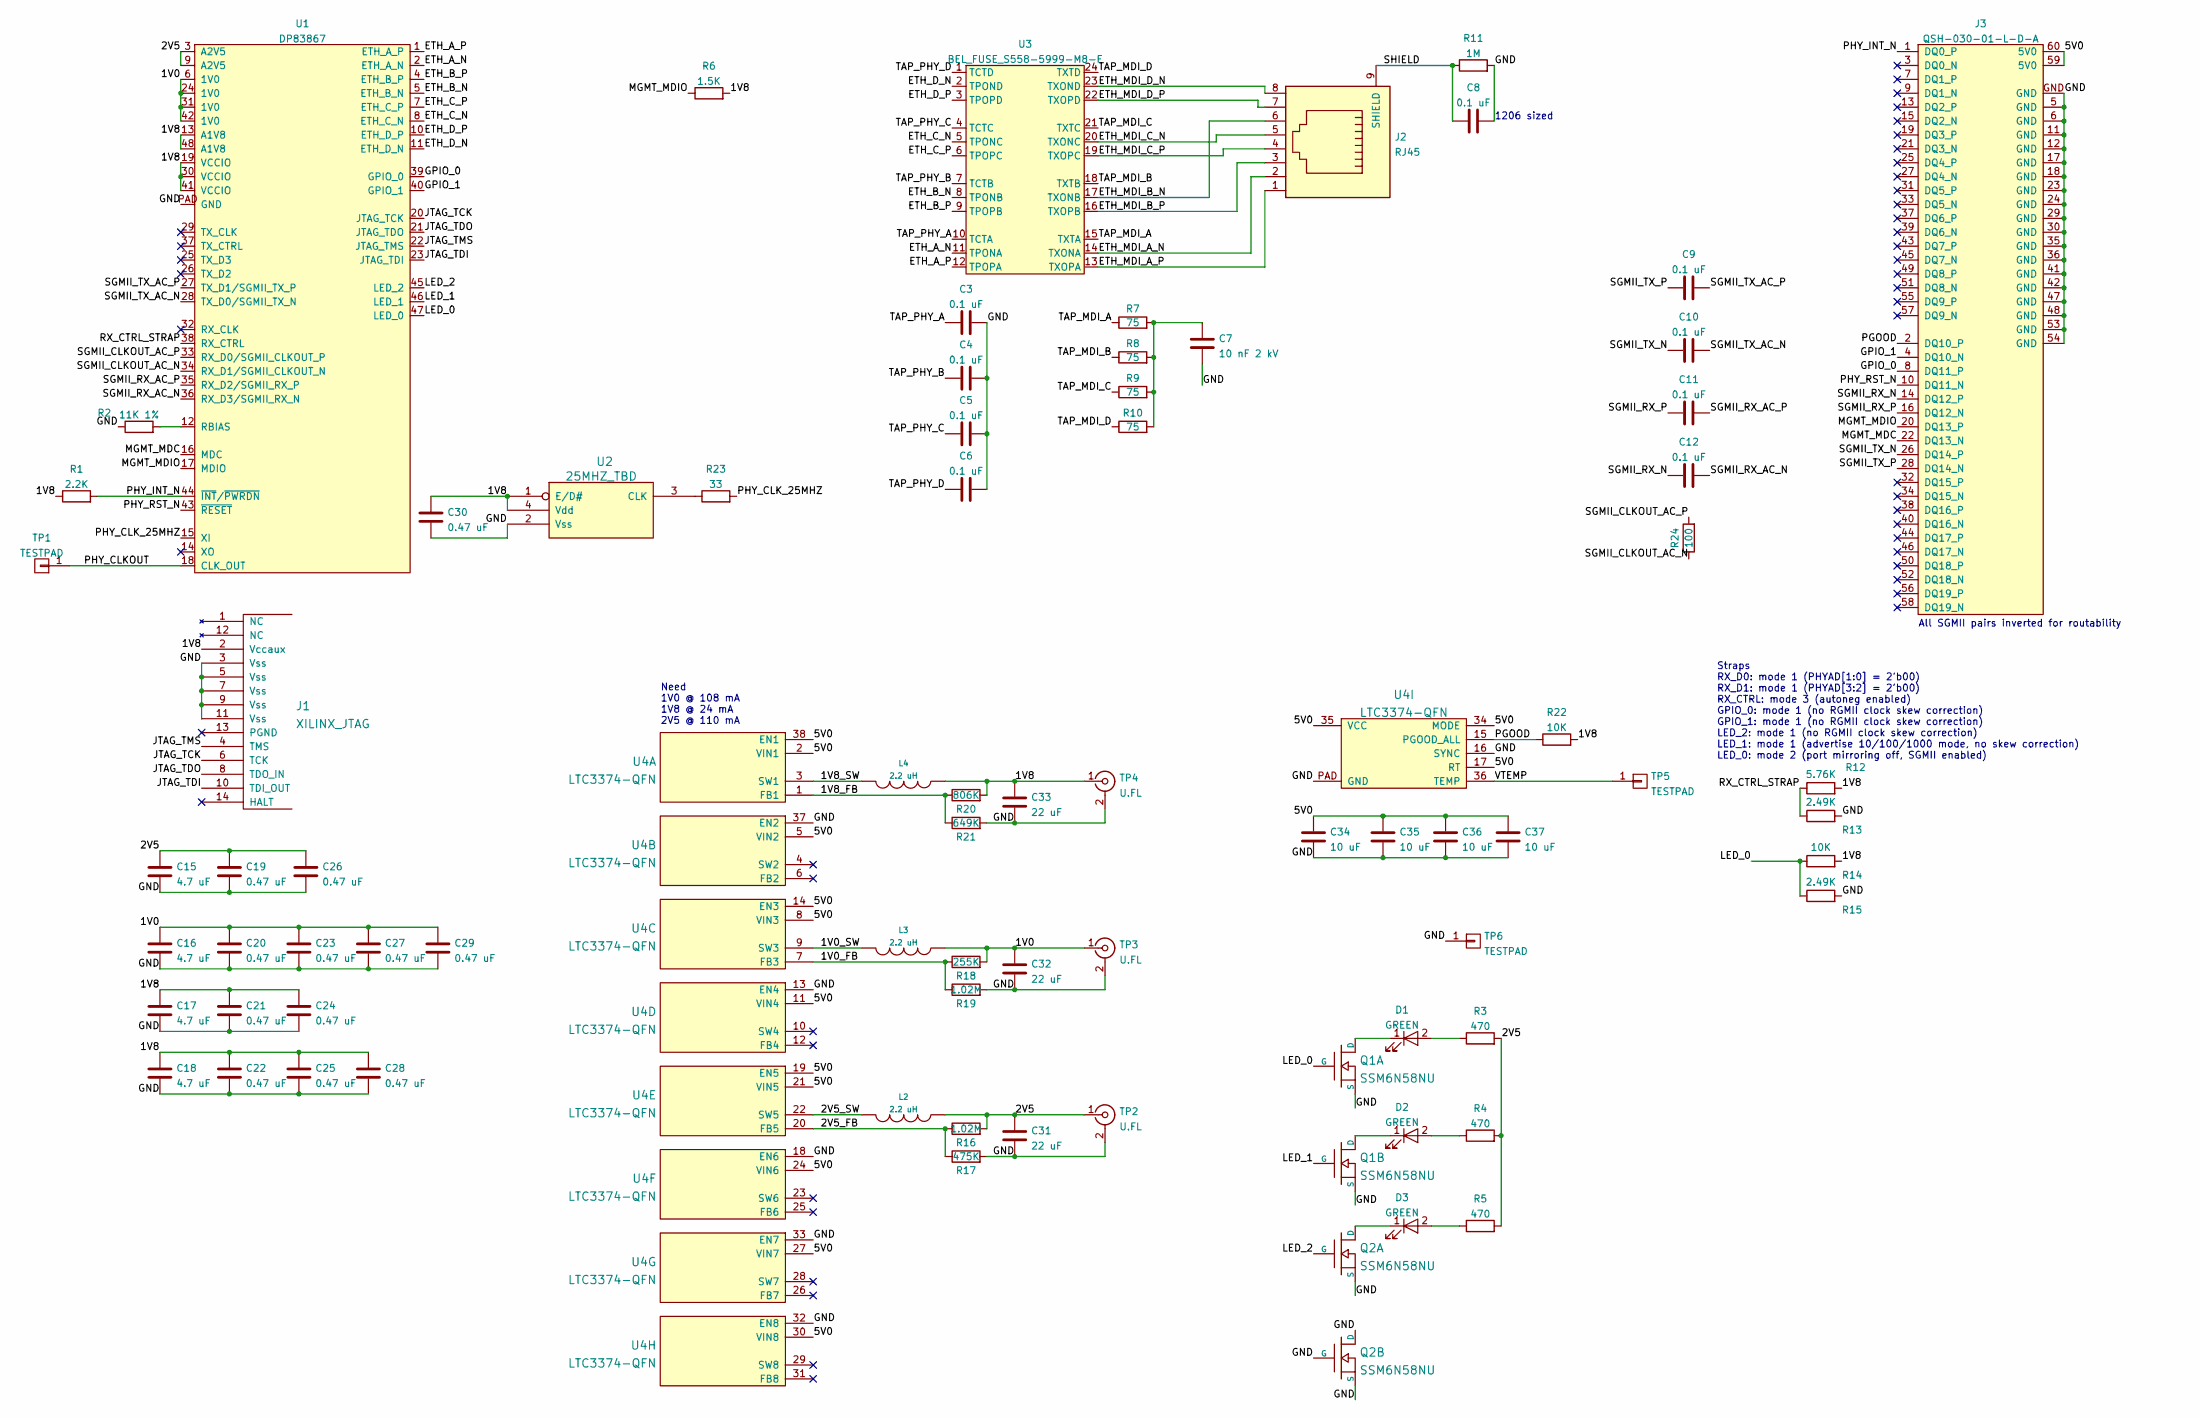
[picture p13: schematic single-phy.kicad_sch, Single DP83867 Test]

Parts:
C3, C4, C5, C6, C9, C10, C11, C12: 0.1 uF; EIA_0402_CAP_NOSILK
C7: 10 nF 2 kV; EIA_1812_CAP_NOSILK
C8: 0.1 uF; EIA_1206_CAP_NOSILK
C15, C16, C17, C18: 4.7 uF; EIA_0603_CAP_NOSILK
C19, C20, C21, C22, C23, C24, C25, C26, C27, C28, C29, C30: 0.47 uF; EIA_0402_CAP_NOSILK
C31, C32, C33: 22 uF; EIA_1206_CAP_NOSILK
C34, C35, C36, C37: 10 uF; EIA_0805_CAP_NOSILK
D1, D2, D3: GREEN; EIA_0603_LED
J1: XILINX_JTAG; XILINX_JTAG_PTH_MOLEX_0878311420
J2: RJ45; CONN_RJ45_BELSTEWART_SS-7188S-A-PG4-1-BA-xx
J3: QSH-030-01-L-D-A; CONN_SAMTEC_QSH-030-01-L-D-A
L2, L3, L4: 2.2 uH; EIA_1210_CAP_NOSILK
Q1, Q2: SSM6N58NU; DFN_6_0.65MM_2x2MM_GDS
R1: 2.2K; EIA_0402_RES_NOSILK
R2: 11K 1%; EIA_0402_RES_NOSILK
R3, R4, R5: 470; EIA_0402_RES_NOSILK
R6: 1.5K; EIA_0402_RES_NOSILK
R7, R8, R9, R10: 75; EIA_0402_RES_NOSILK
R11: 1M; EIA_1206_CAP_NOSILK
R12: 5.76K; EIA_0402_RES_NOSILK
R13, R15: 2.49K; EIA_0402_RES_NOSILK
R14, R22: 10K; EIA_0402_RES_NOSILK
R16, R19: 1.02M; EIA_0402_RES_NOSILK
R17: 475K; EIA_0402_RES_NOSILK
R18: 255K; EIA_0402_RES_NOSILK
R20: 806K; EIA_0402_RES_NOSILK
R21: 649K; EIA_0402_RES_NOSILK
R23: 33; EIA_0402_RES_NOSILK
R24: 100; EIA_0402_RES_NOSILK
TP1, TP5: TESTPAD; TESTPOINT_SMT_0.5MM
TP2, TP3, TP4: U.FL; CONN_U.FL_TE_1909763-1
TP6: TESTPAD; TESTPOINT_SMT_KEYSTONE_5016
U1: DP83867; QFN_48_0.5MM_7x7MM
U2: 25MHZ_TBD; OSCILLATOR_2.0x1.6
U3: BEL_FUSE_S558-5999-M8-F; BELFUSE_S558-5999-M8-F
U4: LTC3374-QFN; QFN_38_0.5MM_5x7MM

Connections:
/1V0: C16.1, C20.1, C23.1, C27.1, C29.1, C32.1, L3.1, R18.2, TP3.1 (In), U1.6 (1V0), U1.24 (1V0), U1.31 (1V0), U1.42 (1V0)
/1V0_FB: R18.1, R19.1, U4.7 (FB3)
/1V0_SW: L3.2, U4.9 (SW3)
/1V8: C17.1, C18.1, C21.1, C22.1, C24.1, C25.1, C28.1, C30.1, C33.1, J1.2 (Vccaux), L4.1, R1.1, R6.2, R12.2, R14.2, R20.2, R22.2, TP4.1 (In), U1.13 (A1V8), U1.19 (VCCIO), U1.30 (VCCIO), U1.41 (VCCIO), U1.48 (A1V8), U2.1 (E/D#), U2.4 (Vdd)
/1V8_FB: R20.1, R21.1, U4.1 (FB1)
/1V8_SW: L4.2, U4.3 (SW1)
/2V5: C15.1, C19.1, C26.1, C31.1, L2.1, R3.2, R4.2, R5.2, R16.2, TP2.1 (In), U1.3 (A2V5), U1.9 (A2V5)
/2V5_FB: R16.1, R17.1, U4.20 (FB5)
/2V5_SW: L2.2, U4.22 (SW5)
/5V0: C34.1, C35.1, C36.1, C37.1, J3.59 (5V0), J3.60 (5V0), U4.2 (VIN1), U4.5 (VIN2), U4.8 (VIN3), U4.11 (VIN4), U4.14 (EN3), U4.17 (RT), U4.19 (EN5), U4.21 (VIN5), U4.24 (VIN6), U4.27 (VIN7), U4.30 (VIN8), U4.34 (MODE), U4.35 (VCC), U4.38 (EN1)
/ETH_A_N: U1.2 (ETH_A_N), U3.11 (TPONA)
/ETH_A_P: U1.1 (ETH_A_P), U3.12 (TPOPA)
/ETH_B_N: U1.5 (ETH_B_N), U3.8 (TPONB)
/ETH_B_P: U1.4 (ETH_B_P), U3.9 (TPOPB)
/ETH_C_N: U1.8 (ETH_C_N), U3.5 (TPONC)
/ETH_C_P: U1.7 (ETH_C_P), U3.6 (TPOPC)
/ETH_D_N: U1.11 (ETH_D_N), U3.2 (TPOND)
/ETH_D_P: U1.10 (ETH_D_P), U3.3 (TPOPD)
/ETH_MDI_A_N: J2.2, U3.14 (TXONA)
/ETH_MDI_A_P: J2.1, U3.13 (TXOPA)
/ETH_MDI_B_N: J2.6, U3.17 (TXONB)
/ETH_MDI_B_P: J2.3, U3.16 (TXOPB)
/ETH_MDI_C_N: J2.5, U3.20 (TXONC)
/ETH_MDI_C_P: J2.4, U3.19 (TXOPC)
/ETH_MDI_D_N: J2.8, U3.23 (TXOND)
/ETH_MDI_D_P: J2.7, U3.22 (TXOPD)
/GND: C3.2, C4.2, C5.2, C6.2, C7.2, C8.2, C15.2, C16.2, C17.2, C18.2, C19.2, C20.2, C21.2, C22.2, C23.2, C24.2, C25.2, C26.2, C27.2, C28.2, C29.2, C30.2, C31.2, C32.2, C33.2, C34.2, C35.2, C36.2, C37.2, J1.3 (Vss), J1.5 (Vss), J1.7 (Vss), J1.9 (Vss), J1.11 (Vss), J3.5 (GND), J3.6 (GND), J3.11 (GND), J3.12 (GND), J3.17 (GND), J3.18 (GND), J3.23 (GND), J3.24 (GND), J3.29 (GND), J3.30 (GND), J3.35 (GND), J3.36 (GND), J3.41 (GND), J3.42 (GND), J3.47 (GND), J3.48 (GND), J3.53 (GND), J3.54 (GND), J3.GND, Q1.S1 (S), Q1.S2 (S), Q2.D2 (D), Q2.G2 (G), Q2.S1 (S), Q2.S2 (S), R2.1, R11.2, R13.2, R15.2, R17.2, R19.2, R21.2, TP2.2 (Ext), TP3.2 (Ext), TP4.2 (Ext), TP6.1, U1.PAD (GND), U2.2 (Vss), U4.13 (EN4), U4.16 (SYNC), U4.18 (EN6), U4.32 (EN8), U4.33 (EN7), U4.37 (EN2), U4.PAD (GND)
/GPIO_0: J3.8 (DQ11_P), U1.39 (GPIO_0)
/GPIO_1: J3.4 (DQ10_N), U1.40 (GPIO_1)
/JTAG_TCK: J1.6 (TCK), U1.20 (JTAG_TCK)
/JTAG_TDI: J1.10 (TDI_OUT), U1.23 (JTAG_TDI)
/JTAG_TDO: J1.8 (TDO_IN), U1.21 (JTAG_TDO)
/JTAG_TMS: J1.4 (TMS), U1.22 (JTAG_TMS)
/LED_0: Q1.G1 (G), R14.1, R15.1, U1.47 (LED_0)
/LED_1: Q1.G2 (G), U1.46 (LED_1)
/LED_2: Q2.G1 (G), U1.45 (LED_2)
/MGMT_MDC: J3.22 (DQ13_N), U1.16 (MDC)
/MGMT_MDIO: J3.20 (DQ13_P), R6.1, U1.17 (MDIO)
/PGOOD: J3.2 (DQ10_P), R22.1, U4.15 (PGOOD_ALL)
/PHY_CLKOUT: TP1.1, U1.18 (CLK_OUT)
/PHY_CLK_25MHZ: R23.2, U1.15 (XI)
/PHY_INT_N: J3.1 (DQ0_P), R1.2, U1.44 (~INT/~PWRDN)
/PHY_RST_N: J3.10 (DQ11_N), U1.43 (~RESET)
/RX_CTRL_STRAP: R12.1, R13.1, U1.38 (RX_CTRL)
/SGMII_CLKOUT_AC_N: R24.1, U1.34 (RX_D1/SGMII_CLKOUT_N)
/SGMII_CLKOUT_AC_P: R24.2, U1.33 (RX_D0/SGMII_CLKOUT_P)
/SGMII_RX_AC_N: C12.2, U1.36 (RX_D3/SGMII_RX_N)
/SGMII_RX_AC_P: C11.2, U1.35 (RX_D2/SGMII_RX_P)
/SGMII_RX_N: C12.1, J3.14 (DQ12_P)
/SGMII_RX_P: C11.1, J3.16 (DQ12_N)
/SGMII_TX_AC_N: C10.2, U1.28 (TX_D0/SGMII_TX_N)
/SGMII_TX_AC_P: C9.2, U1.27 (TX_D1/SGMII_TX_P)
/SGMII_TX_N: C10.1, J3.26 (DQ14_P)
/SGMII_TX_P: C9.1, J3.28 (DQ14_N)
/SHIELD: C8.1, J2.9 (SHIELD), R11.1
/TAP_MDI_A: R7.1, U3.15 (TXTA)
/TAP_MDI_B: R8.1, U3.18 (TXTB)
/TAP_MDI_C: R9.1, U3.21 (TXTC)
/TAP_MDI_D: R10.1, U3.24 (TXTD)
/TAP_PHY_A: C3.1, U3.10 (TCTA)
/TAP_PHY_B: C4.1, U3.7 (TCTB)
/TAP_PHY_C: C5.1, U3.4 (TCTC)
/TAP_PHY_D: C6.1, U3.1 (TCTD)
/VTEMP: TP5.1, U4.36 (TEMP)
unnamed: C7.1, R7.2, R8.2, R9.2, R10.2
unnamed: D1.2 (A), R3.1
unnamed: D3.2 (A), R5.1
unnamed: D1.1 (K), Q1.D1 (D)
unnamed: D2.1 (K), Q1.D2 (D)
unnamed: D3.1 (K), Q2.D1 (D)
unnamed: R2.2, U1.12 (RBIAS)
unnamed: D2.2 (A), R4.1
unnamed: R23.1, U2.3 (CLK)

Notes on the sheet:
All SGMII pairs inverted for routability
Straps RX_D0: mode 1 (PHYAD[1:0] = 2'b00) RX_D1: mode 1 (PHYAD[3:2] = 2'b00) RX_CTRL: mode 3 (autoneg enabled) GPIO_0: mode 1 (no RGMII clock skew correction) GPIO_1: mode 1 (no RGMII clock skew correction) LED_2: mode 1 (no RGMII clock skew correction) LED_1: mode 1 (advertise 10/100/1000 mode, no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
1206 sized
Need 1V0 @ 108 mA 1V8 @ 24 mA 2V5 @ 110 mA

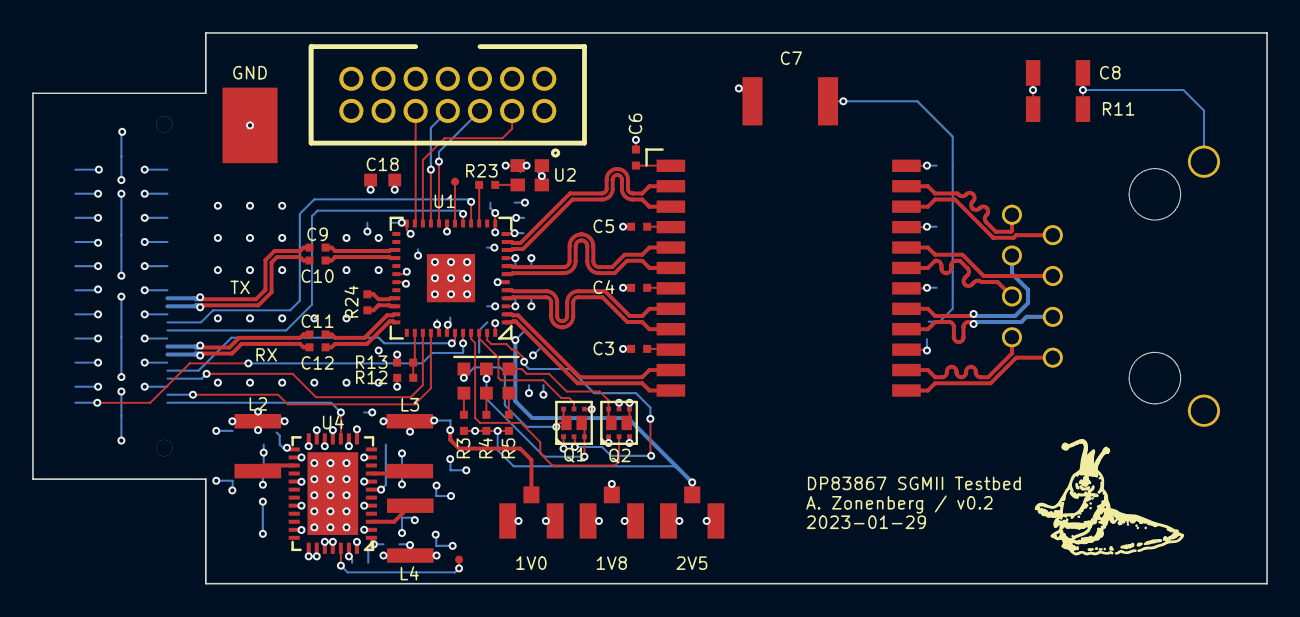
[picture p14: board single-phy.kicad_pcb from above]

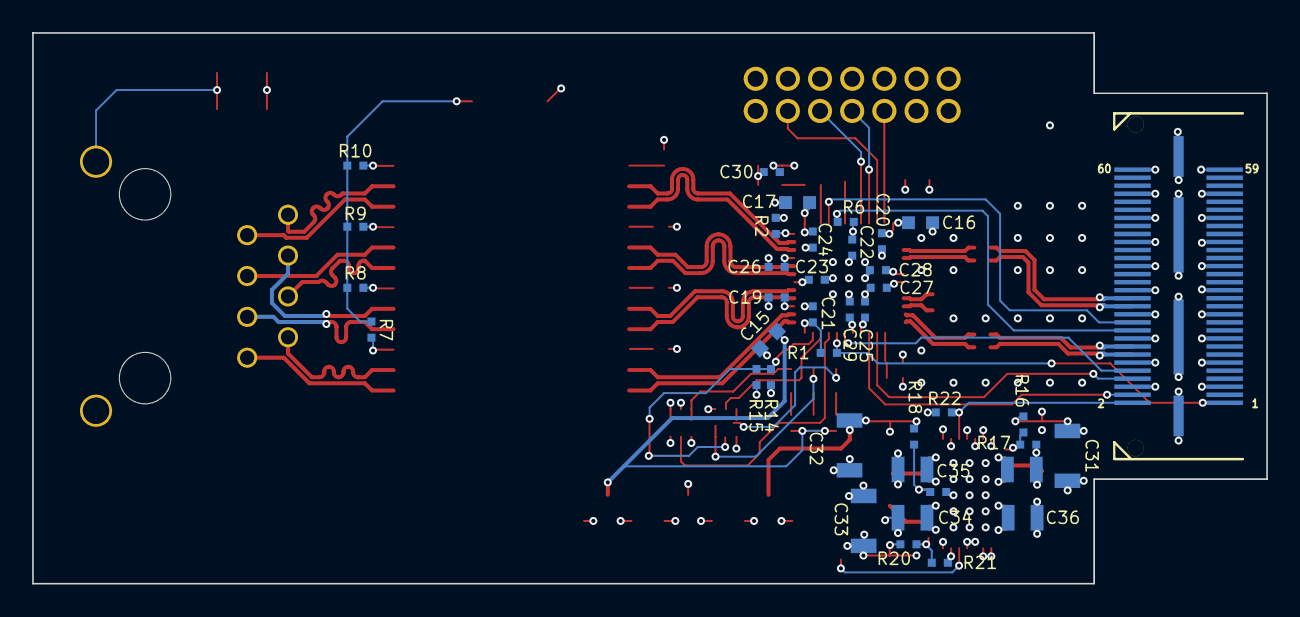
[picture p15: board single-phy.kicad_pcb from below]

Board: 4 copper layers, 76.8 x 34.2 mm, 78 parts (39 on the bottom side), 73 nets.
