azonenberg/latentpacket/latentred/boards/testing/single-phy-sma-device/single-phy-sma-device.kicad_pcb

## KiCad design latentred/boards/testing/single-phy-sma-device/single-phy-sma-device.kicad_pcb (2022-12-19)

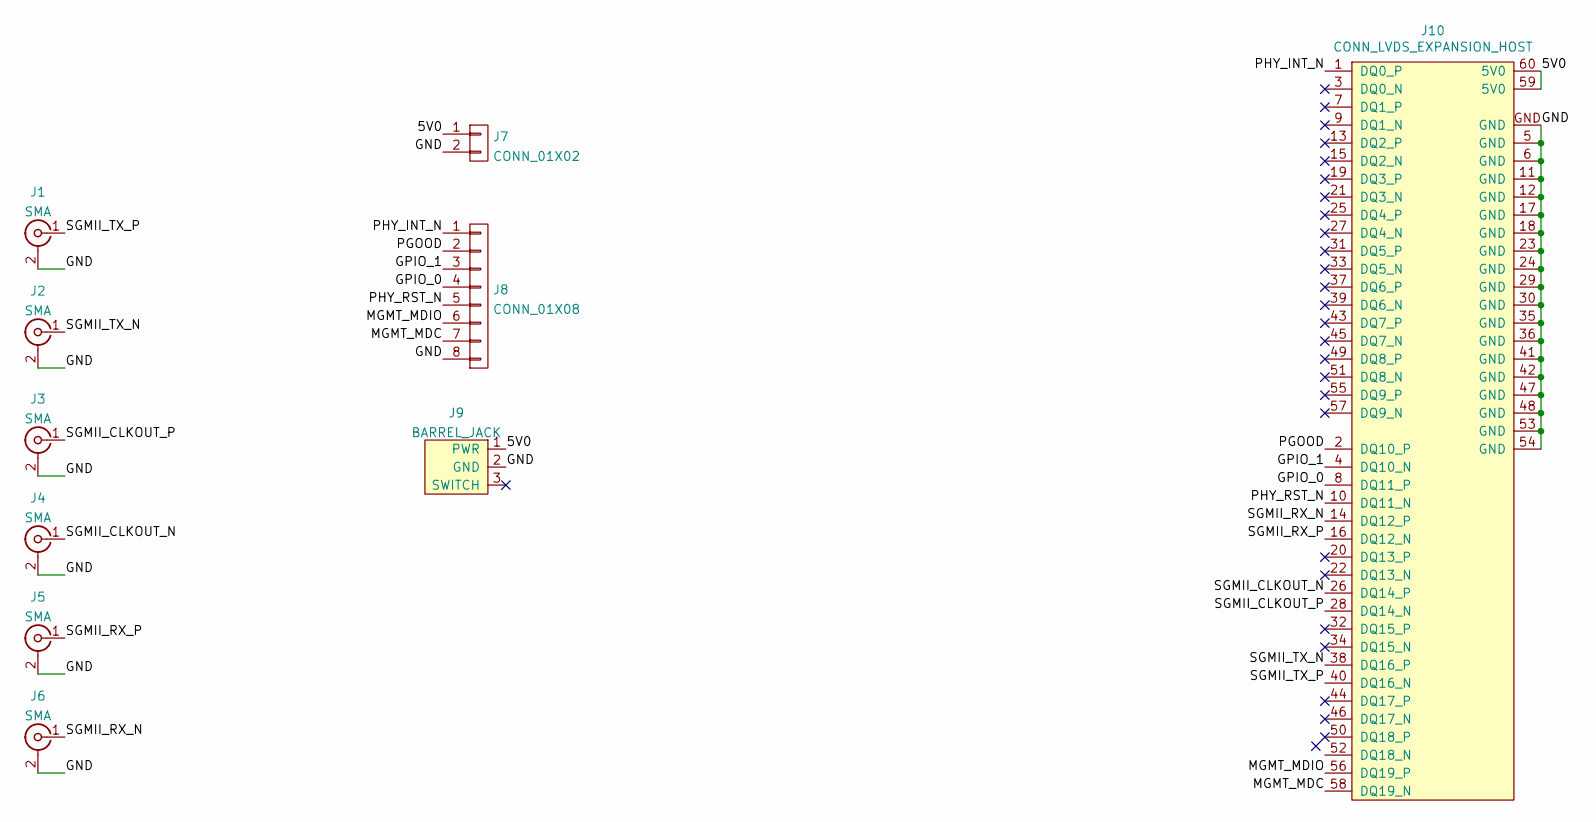
[picture p16: schematic single-phy-sma-device.kicad_sch, Single DP83867 device-side SMA adapter]

Parts:
J1, J2, J3, J4, J5, J6: SMA; CONN_SMA_EDGE_SAMTEC_SMA_J_P_H_ST_EM1
J7: CONN_01X02; CONN_HEADER_2.54MM_1x2
J8: CONN_01X08; CONN_HEADER_2.54MM_1x8
J9: BARREL_JACK; CONN_CUI_PJ-058BH_HIPWR_BARREL_NOSLOT
J10: CONN_LVDS_EXPANSION_HOST; CONN_SAMTEC_QTH-030-01-L-D-A

Connections:
/5V0: J7.1, J9.1 (PWR), J10.59 (5V0), J10.60 (5V0)
/GND: J1.2 (Ext), J2.2 (Ext), J3.2 (Ext), J4.2 (Ext), J5.2 (Ext), J6.2 (Ext), J7.2, J8.8, J9.2 (GND), J10.5 (GND), J10.6 (GND), J10.11 (GND), J10.12 (GND), J10.17 (GND), J10.18 (GND), J10.23 (GND), J10.24 (GND), J10.29 (GND), J10.30 (GND), J10.35 (GND), J10.36 (GND), J10.41 (GND), J10.42 (GND), J10.47 (GND), J10.48 (GND), J10.53 (GND), J10.54 (GND), J10.GND
/GPIO_0: J8.4, J10.8 (DQ11_P)
/GPIO_1: J8.3, J10.4 (DQ10_N)
/MGMT_MDC: J8.7, J10.58 (DQ19_N)
/MGMT_MDIO: J8.6, J10.56 (DQ19_P)
/PGOOD: J8.2, J10.2 (DQ10_P)
/PHY_INT_N: J8.1, J10.1 (DQ0_P)
/PHY_RST_N: J8.5, J10.10 (DQ11_N)
/SGMII_CLKOUT_N: J4.1 (In), J10.26 (DQ14_P)
/SGMII_CLKOUT_P: J3.1 (In), J10.28 (DQ14_N)
/SGMII_RX_N: J6.1 (In), J10.14 (DQ12_P)
/SGMII_RX_P: J5.1 (In), J10.16 (DQ12_N)
/SGMII_TX_N: J2.1 (In), J10.38 (DQ16_P)
/SGMII_TX_P: J1.1 (In), J10.40 (DQ16_N)

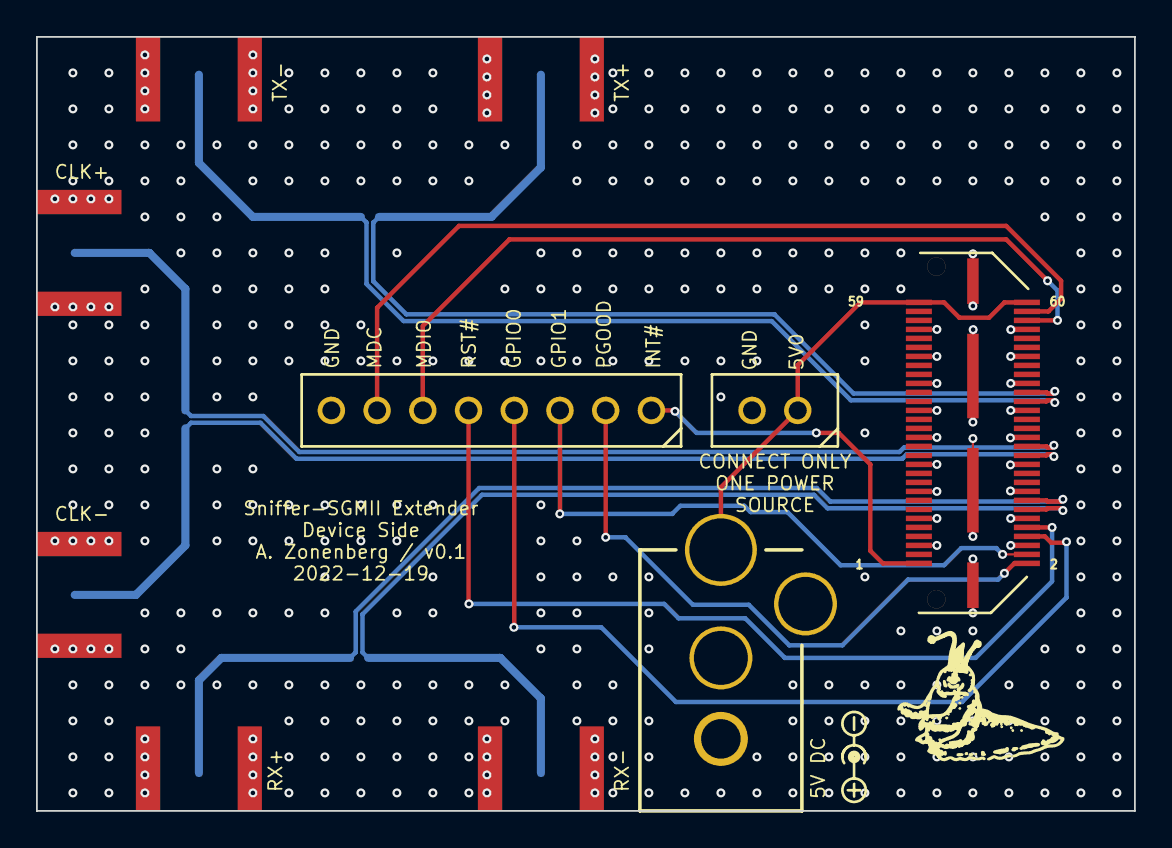
[picture p17: board single-phy-sma-device.kicad_pcb from above]

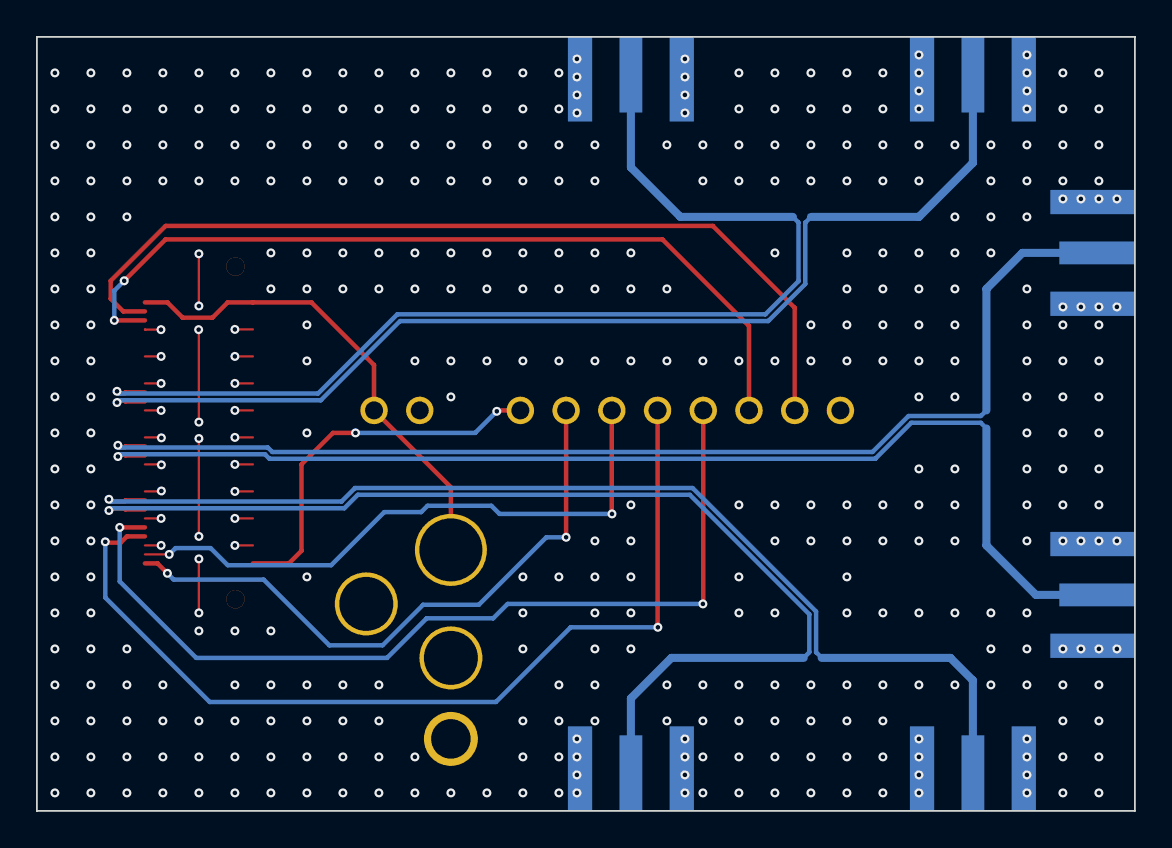
[picture p18: board single-phy-sma-device.kicad_pcb from below]

Board: 4 copper layers, 61.0 x 43.0 mm, 10 parts (6 on the bottom side), 15 nets.
