azonenberg/latentpacket/latentred/boards/testing/single-phy-sma-host/single-phy-sma-host.kicad_pcb

## KiCad design latentred/boards/testing/single-phy-sma-host/single-phy-sma-host.kicad_pcb (2022-12-19)

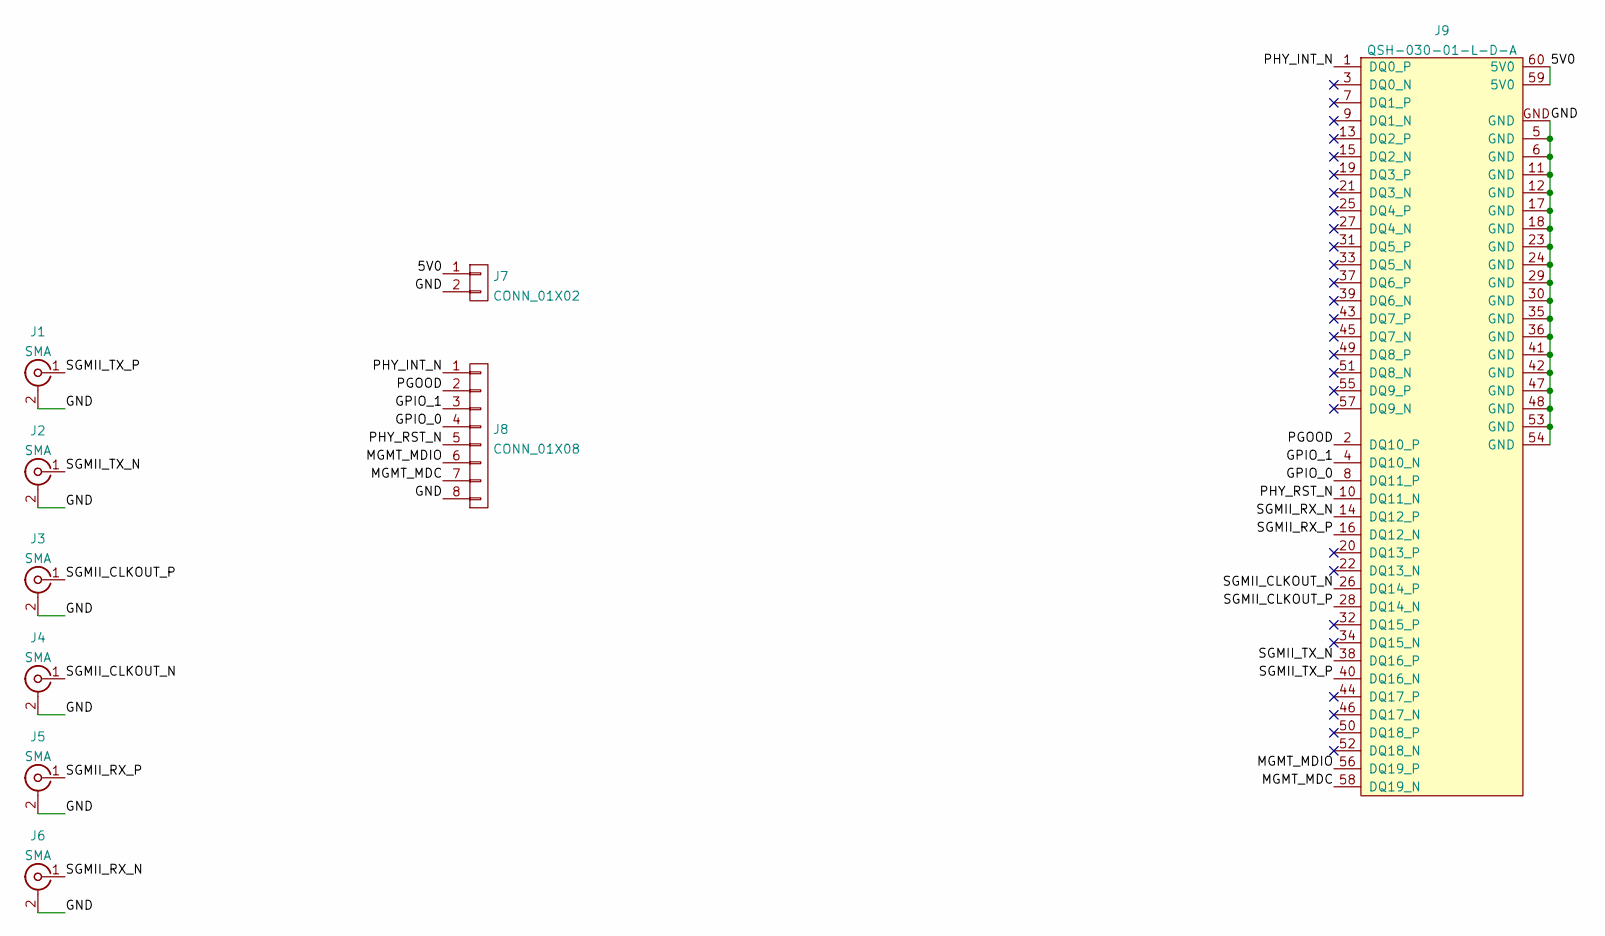
[picture p19: schematic single-phy-sma-host.kicad_sch, Single DP83867 host side SMA adapter]

Parts:
J1, J2, J3, J4, J5, J6: SMA; CONN_SMA_EDGE_SAMTEC_SMA_J_P_H_ST_EM1
J7: CONN_01X02; CONN_HEADER_2.54MM_1x2
J8: CONN_01X08; CONN_HEADER_2.54MM_1x8
J9: QSH-030-01-L-D-A; CONN_SAMTEC_QSH-030-01-L-D-A

Connections:
/5V0: J7.1, J9.59 (5V0), J9.60 (5V0)
/GND: J1.2 (Ext), J2.2 (Ext), J3.2 (Ext), J4.2 (Ext), J5.2 (Ext), J6.2 (Ext), J7.2, J8.8, J9.5 (GND), J9.6 (GND), J9.11 (GND), J9.12 (GND), J9.17 (GND), J9.18 (GND), J9.23 (GND), J9.24 (GND), J9.29 (GND), J9.30 (GND), J9.35 (GND), J9.36 (GND), J9.41 (GND), J9.42 (GND), J9.47 (GND), J9.48 (GND), J9.53 (GND), J9.54 (GND), J9.GND
/GPIO_0: J8.4, J9.8 (DQ11_P)
/GPIO_1: J8.3, J9.4 (DQ10_N)
/MGMT_MDC: J8.7, J9.58 (DQ19_N)
/MGMT_MDIO: J8.6, J9.56 (DQ19_P)
/PGOOD: J8.2, J9.2 (DQ10_P)
/PHY_INT_N: J8.1, J9.1 (DQ0_P)
/PHY_RST_N: J8.5, J9.10 (DQ11_N)
/SGMII_CLKOUT_N: J4.1 (In), J9.26 (DQ14_P)
/SGMII_CLKOUT_P: J3.1 (In), J9.28 (DQ14_N)
/SGMII_RX_N: J6.1 (In), J9.14 (DQ12_P)
/SGMII_RX_P: J5.1 (In), J9.16 (DQ12_N)
/SGMII_TX_N: J2.1 (In), J9.38 (DQ16_P)
/SGMII_TX_P: J1.1 (In), J9.40 (DQ16_N)

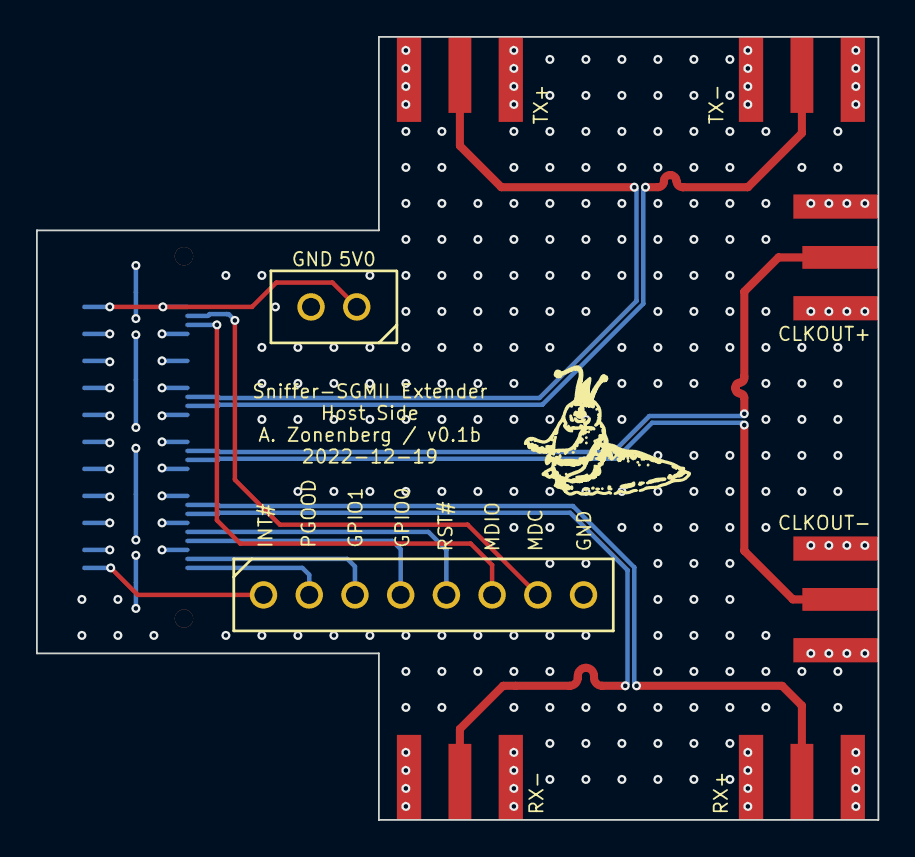
[picture p20: board single-phy-sma-host.kicad_pcb from above]

Board: 4 copper layers, 46.8 x 43.5 mm, 9 parts (1 on the bottom side), 15 nets.
