azonenberg/latentpacket/latentred/boards/linecard/latentred-linecard/latentred-linecard.kicad_pcb

## KiCad design latentred/boards/linecard/latentred-linecard/latentred-linecard.kicad_pcb (2018-06-17)

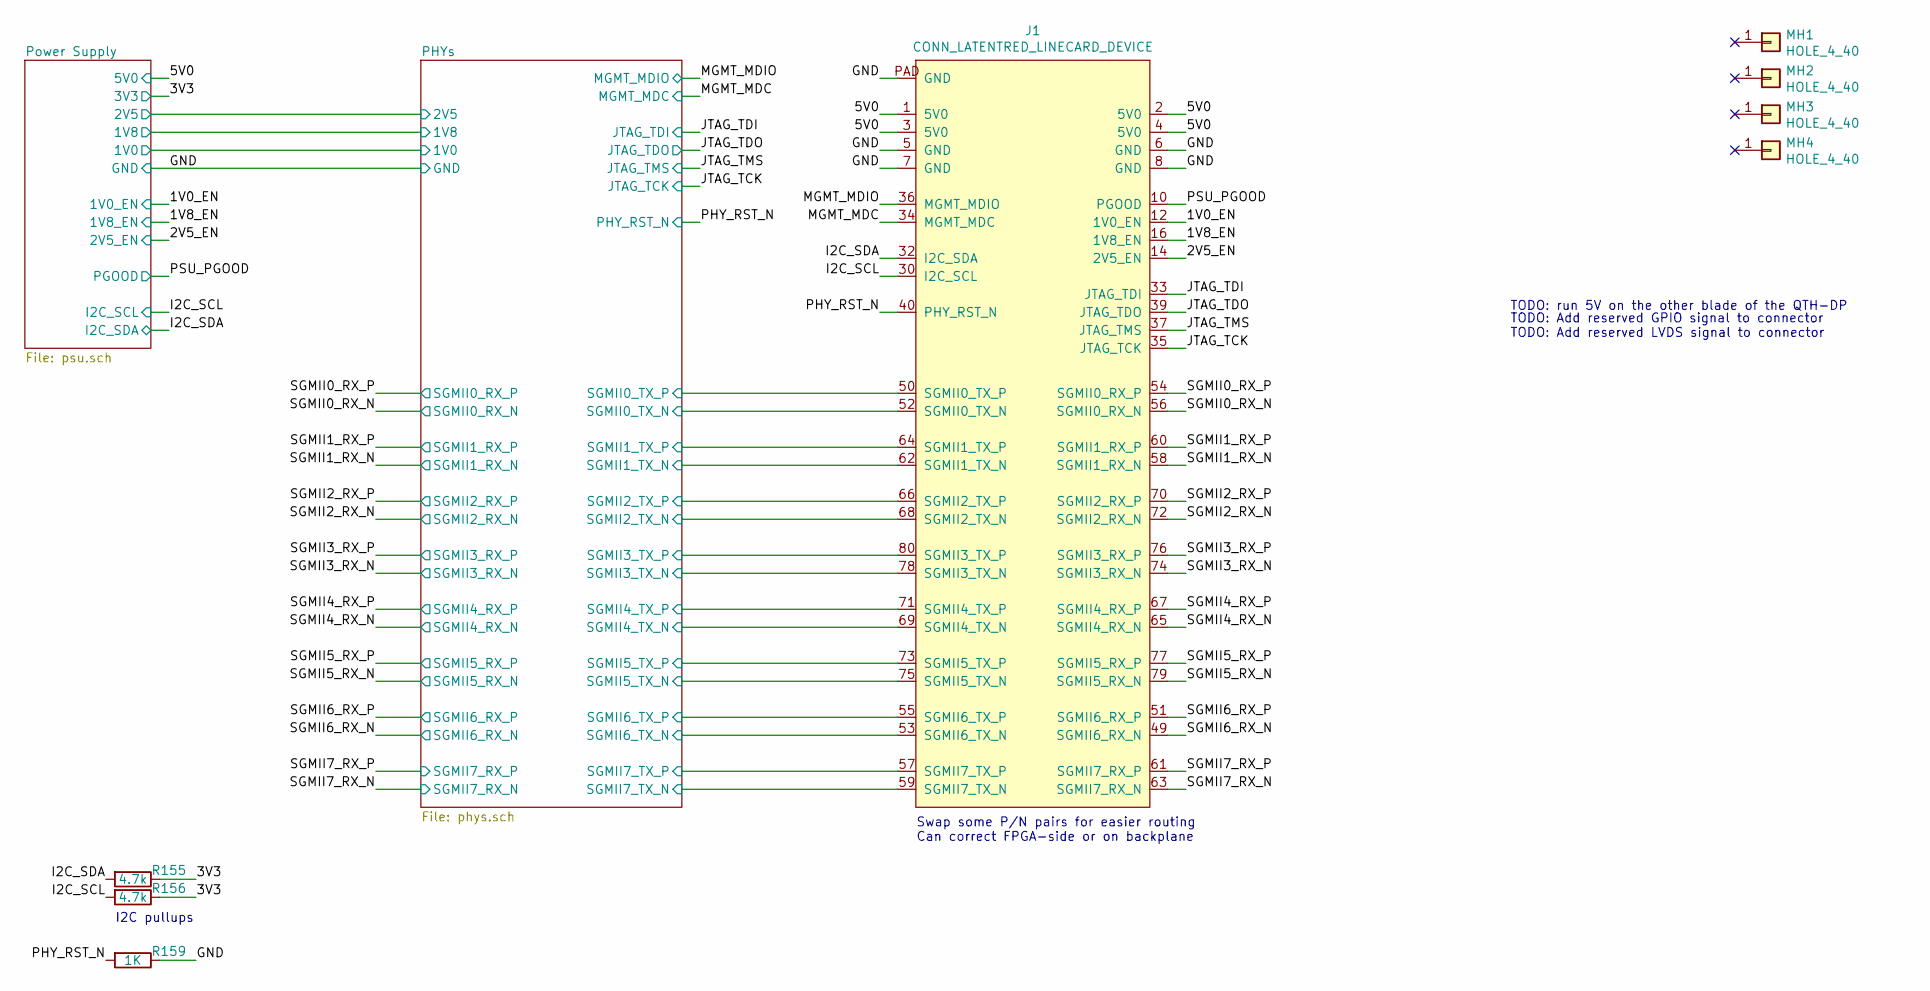
[picture p21: schematic latentred-linecard.sch, LATENTRED 8-port 10/100/1000 Base-T Line Card]

Parts:
J1: CONN_LATENTRED_LINECARD_DEVICE; CONN_SAMTEC_QTH-040-01-L-D-DP-A
MH1, MH2, MH3, MH4: HOLE_4_40; MECHANICAL_CLEARANCEHOLE_4_40
R155, R156: 4.7k; EIA_0402_RES_NOSILK
R159: 1K; EIA_0402_RES_NOSILK

Connections:
/1V0_EN: J1.12 (1V0_EN); also elsewhere on the board
/1V8_EN: J1.16 (1V8_EN); also elsewhere on the board
/2V5_EN: J1.14 (2V5_EN); also elsewhere on the board
/3V3: R155.1, R156.1; also elsewhere on the board
/5V0: J1.1 (5V0), J1.2 (5V0), J1.3 (5V0), J1.4 (5V0); also elsewhere on the board
/GND: J1.5 (GND), J1.6 (GND), J1.7 (GND), J1.8 (GND), J1.PAD (GND), R159.1; also elsewhere on the board
/I2C_SCL: J1.30 (I2C_SCL), R156.2; also elsewhere on the board
/I2C_SDA: J1.32 (I2C_SDA), R155.2; also elsewhere on the board
/JTAG_TCK: J1.35 (JTAG_TCK); also elsewhere on the board
/JTAG_TDI: J1.33 (JTAG_TDI); also elsewhere on the board
/JTAG_TDO: J1.39 (JTAG_TDO); also elsewhere on the board
/JTAG_TMS: J1.37 (JTAG_TMS); also elsewhere on the board
/MGMT_MDC: J1.34 (MGMT_MDC); also elsewhere on the board
/MGMT_MDIO: J1.36 (MGMT_MDIO); also elsewhere on the board
/PHY_RST_N: J1.40 (PHY_RST_N), R159.2; also elsewhere on the board
/PHYs/SGMII0_TX_N: J1.52 (SGMII0_TX_N); also elsewhere on the board
/PHYs/SGMII0_TX_P: J1.50 (SGMII0_TX_P); also elsewhere on the board
/PHYs/SGMII1_TX_N: J1.62 (SGMII1_TX_N); also elsewhere on the board
/PHYs/SGMII1_TX_P: J1.64 (SGMII1_TX_P); also elsewhere on the board
/PHYs/SGMII2_TX_N: J1.68 (SGMII2_TX_N); also elsewhere on the board
/PHYs/SGMII2_TX_P: J1.66 (SGMII2_TX_P); also elsewhere on the board
/PHYs/SGMII3_TX_N: J1.78 (SGMII3_TX_N); also elsewhere on the board
/PHYs/SGMII3_TX_P: J1.80 (SGMII3_TX_P); also elsewhere on the board
/PHYs/SGMII4_TX_N: J1.69 (SGMII4_TX_N); also elsewhere on the board
/PHYs/SGMII4_TX_P: J1.71 (SGMII4_TX_P); also elsewhere on the board
/PHYs/SGMII5_TX_N: J1.75 (SGMII5_TX_N); also elsewhere on the board
/PHYs/SGMII5_TX_P: J1.73 (SGMII5_TX_P); also elsewhere on the board
/PHYs/SGMII6_TX_N: J1.53 (SGMII6_TX_N); also elsewhere on the board
/PHYs/SGMII6_TX_P: J1.55 (SGMII6_TX_P); also elsewhere on the board
/PHYs/SGMII7_TX_N: J1.59 (SGMII7_TX_N); also elsewhere on the board
/PHYs/SGMII7_TX_P: J1.57 (SGMII7_TX_P); also elsewhere on the board
/PSU_PGOOD: J1.10 (PGOOD); also elsewhere on the board
/SGMII0_RX_N: J1.56 (SGMII0_RX_N); also elsewhere on the board
/SGMII0_RX_P: J1.54 (SGMII0_RX_P); also elsewhere on the board
/SGMII1_RX_N: J1.58 (SGMII1_RX_N); also elsewhere on the board
/SGMII1_RX_P: J1.60 (SGMII1_RX_P); also elsewhere on the board
/SGMII2_RX_N: J1.72 (SGMII2_RX_N); also elsewhere on the board
/SGMII2_RX_P: J1.70 (SGMII2_RX_P); also elsewhere on the board
/SGMII3_RX_N: J1.74 (SGMII3_RX_N); also elsewhere on the board
/SGMII3_RX_P: J1.76 (SGMII3_RX_P); also elsewhere on the board
/SGMII4_RX_N: J1.65 (SGMII4_RX_N); also elsewhere on the board
/SGMII4_RX_P: J1.67 (SGMII4_RX_P); also elsewhere on the board
/SGMII5_RX_N: J1.79 (SGMII5_RX_N); also elsewhere on the board
/SGMII5_RX_P: J1.77 (SGMII5_RX_P); also elsewhere on the board
/SGMII6_RX_N: J1.49 (SGMII6_RX_N); also elsewhere on the board
/SGMII6_RX_P: J1.51 (SGMII6_RX_P); also elsewhere on the board
/SGMII7_RX_N: J1.63 (SGMII7_RX_N); also elsewhere on the board
/SGMII7_RX_P: J1.61 (SGMII7_RX_P); also elsewhere on the board

Notes on the sheet:
I2C pullups
TODO: run 5V on the other blade of the QTH-DP
TODO: Add reserved GPIO signal to connector TODO: Add reserved LVDS signal to connector
Swap some P/N pairs for easier routing Can correct FPGA-side or on backplane

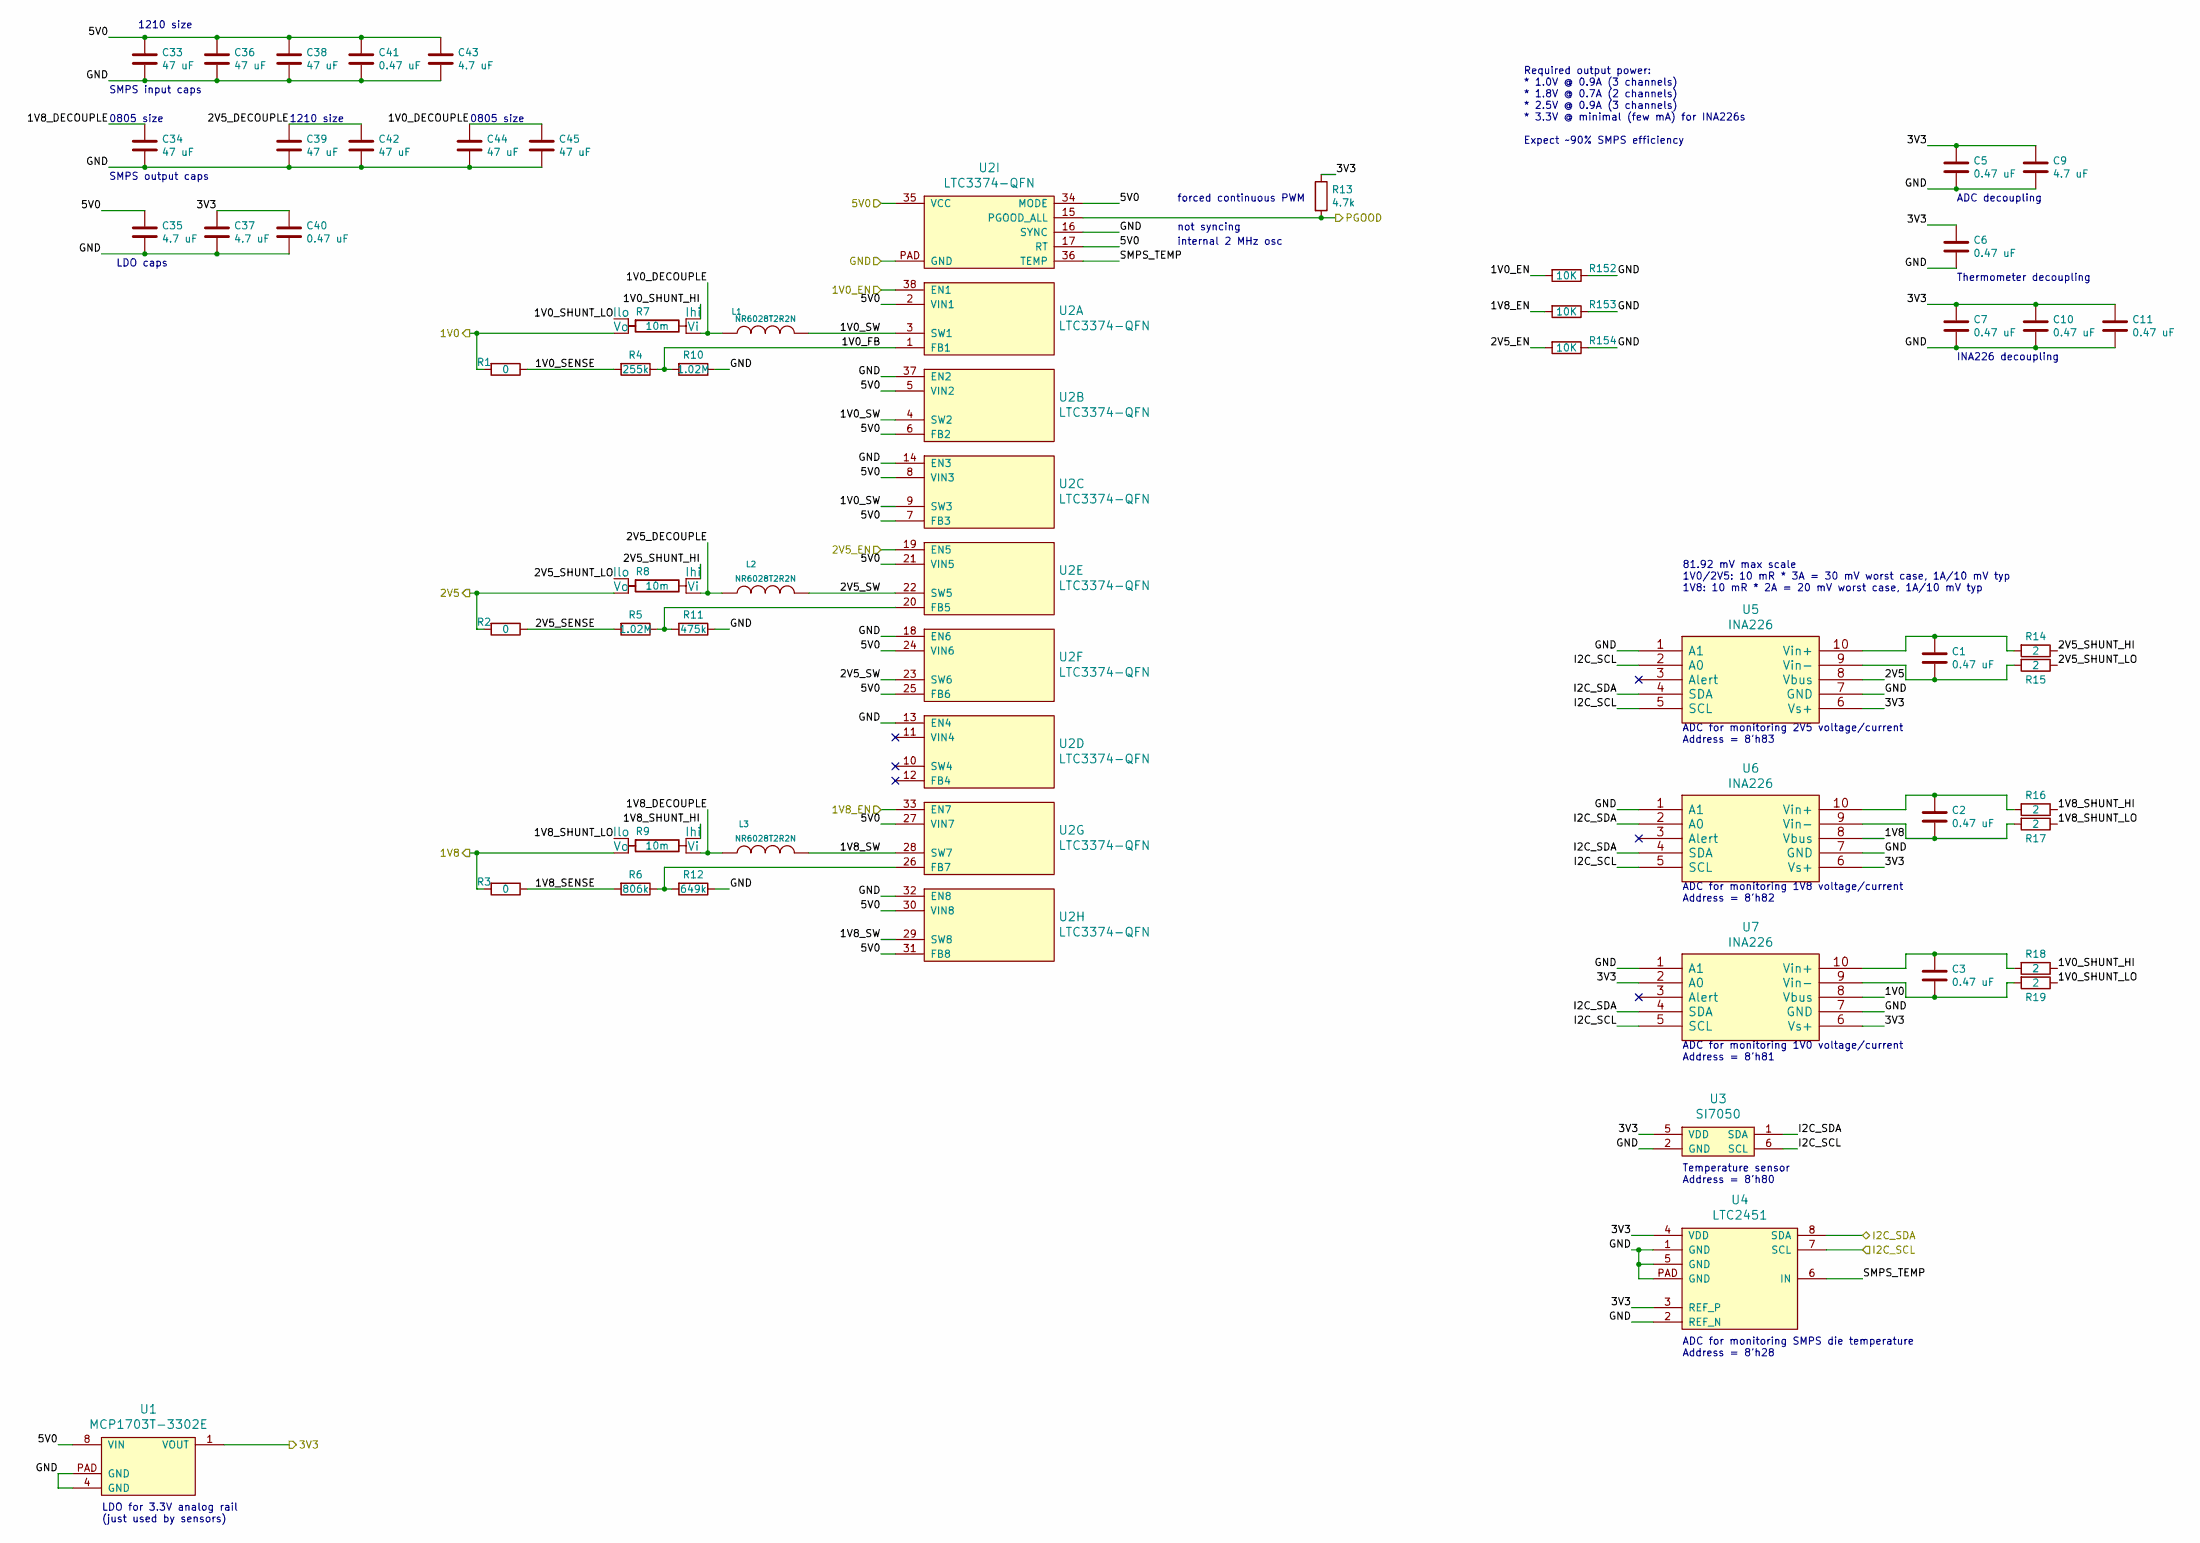
[picture p22: schematic psu.sch, LATENTRED 8-port 10/100/1000 Base-T Line Card]

Parts:
C1, C2, C3, C5, C6, C7, C10, C11, C40, C41: 0.47 uF; EIA_0402_CAP_NOSILK
C9, C35, C37, C43: 4.7 uF; EIA_0603_CAP_NOSILK
C33, C36, C38, C39, C42: 47 uF; EIA_1210_CAP_NOSILK
C34, C44, C45: 47 uF; EIA_0805_CAP_NOSILK
L1, L2, L3: NR6028T2R2N; INDUCTOR_YUDEN_NR6028
R1, R2, R3: 0; EIA_0402_RES_NOSILK
R4: 255k; EIA_0402_RES_NOSILK
R5, R10: 1.02M; EIA_0402_RES_NOSILK
R6: 806k; EIA_0402_RES_NOSILK
R7, R8, R9: 10m; OHMITE_LVK12
R11: 475k; EIA_0402_RES_NOSILK
R12: 649k; EIA_0402_RES_NOSILK
R13: 4.7k; EIA_0402_RES_NOSILK
R14, R15, R16, R17, R18, R19: 2; EIA_0402_RES_NOSILK
R152, R153, R154: 10K; EIA_0402_RES_NOSILK
U1: MCP1703T-3302E; DFN_8_0.5MM_3x3MM
U2: LTC3374-QFN; QFN_38_0.5MM_5x7MM
U3: SI7050; DFN_6_1MM_3x3MM
U4: LTC2451; DFN_8_0.5MM_2x3MM
U5, U6, U7: INA226; SOP_10_0.5MM_3MM

Connections:
/1V0_EN: R152.2, U2.38 (EN1); also elsewhere on the board
/1V8_EN: R153.2, U2.33 (EN7); also elsewhere on the board
/2V5_EN: R154.2, U2.19 (EN5); also elsewhere on the board
/3V3: C5.1, C6.1, C7.1, C9.1, C10.1, C11.1, C37.1, C40.1, R13.1, U1.1 (VOUT), U3.5 (VDD), U4.3 (REF_P), U4.4 (VDD), U5.6 (Vs+), U6.6 (Vs+), U7.2 (A0), U7.6 (Vs+); also elsewhere on the board
/5V0: C33.1, C35.1, C36.1, C38.1, C41.1, C43.1, U1.8 (VIN), U2.2 (VIN1), U2.5 (VIN2), U2.6 (FB2), U2.7 (FB3), U2.8 (VIN3), U2.17 (RT), U2.21 (VIN5), U2.24 (VIN6), U2.25 (FB6), U2.27 (VIN7), U2.30 (VIN8), U2.31 (FB8), U2.34 (MODE), U2.35 (VCC); also elsewhere on the board
/GND: C5.2, C6.2, C7.2, C9.2, C10.2, C11.2, C33.2, C34.2, C35.2, C36.2, C37.2, C38.2, C39.2, C40.2, C41.2, C42.2, C43.2, C44.2, C45.2, R10.1, R11.1, R12.1, R152.1, R153.1, R154.1, U1.4 (GND), U1.PAD (GND), U2.13 (EN4), U2.14 (EN3), U2.16 (SYNC), U2.18 (EN6), U2.32 (EN8), U2.37 (EN2), U2.PAD (GND), U3.2 (GND), U4.1 (GND), U4.2 (REF_N), U4.5 (GND), U4.PAD (GND), U5.1 (A1), U5.7 (GND), U6.1 (A1), U6.7 (GND), U7.1 (A1), U7.7 (GND); also elsewhere on the board
/I2C_SCL: U3.6 (SCL), U4.7 (SCL), U5.2 (A0), U5.5 (SCL), U6.5 (SCL), U7.5 (SCL); also elsewhere on the board
/I2C_SDA: U3.1 (SDA), U4.8 (SDA), U5.4 (SDA), U6.2 (A0), U6.4 (SDA), U7.4 (SDA); also elsewhere on the board
/PHYs/1V0: R1.2, R7.2 (Vo), U7.8 (Vbus); also elsewhere on the board
/PHYs/1V8: R3.2, R9.2 (Vo), U6.8 (Vbus); also elsewhere on the board
/PHYs/2V5: R2.2, R8.2 (Vo), U5.8 (Vbus); also elsewhere on the board
/PSU_PGOOD: R13.2, U2.15 (PGOOD_ALL); also elsewhere on the board
/Power Supply/1V0_DECOUPLE: C44.1, C45.1, L1.1, R7.4 (Vi)
/Power Supply/1V0_FB: R4.1, R10.2, U2.1 (FB1)
/Power Supply/1V0_SENSE: R1.1, R4.2
/Power Supply/1V0_SHUNT_HI: R7.3 (Ihi), R18.1
/Power Supply/1V0_SHUNT_LO: R7.1 (Ilo), R19.1
/Power Supply/1V0_SW: L1.2, U2.3 (SW1), U2.4 (SW2), U2.9 (SW3)
/Power Supply/1V8_DECOUPLE: C34.1, L3.1, R9.4 (Vi)
/Power Supply/1V8_SENSE: R3.1, R6.2
/Power Supply/1V8_SHUNT_HI: R9.3 (Ihi), R16.1
/Power Supply/1V8_SHUNT_LO: R9.1 (Ilo), R17.1
/Power Supply/1V8_SW: L3.2, U2.28 (SW7), U2.29 (SW8)
/Power Supply/2V5_DECOUPLE: C39.1, C42.1, L2.1, R8.4 (Vi)
/Power Supply/2V5_SENSE: R2.1, R5.2
/Power Supply/2V5_SHUNT_HI: R8.3 (Ihi), R14.1
/Power Supply/2V5_SHUNT_LO: R8.1 (Ilo), R15.1
/Power Supply/2V5_SW: L2.2, U2.22 (SW5), U2.23 (SW6)
/Power Supply/SMPS_TEMP: U2.36 (TEMP), U4.6 (IN)
unnamed: C1.1, R14.2, U5.10 (Vin+)
unnamed: C1.2, R15.2, U5.9 (Vin-)
unnamed: C2.1, R16.2, U6.10 (Vin+)
unnamed: C2.2, R17.2, U6.9 (Vin-)
unnamed: C3.1, R18.2, U7.10 (Vin+)
unnamed: C3.2, R19.2, U7.9 (Vin-)
unnamed: R5.1, R11.2, U2.20 (FB5)
unnamed: R6.1, R12.2, U2.26 (FB7)

Notes on the sheet:
Required output power: * 1.0V @ 0.9A (3 channels) * 1.8V @ 0.7A (2 channels) * 2.5V @ 0.9A (3 channels) * 3.3V @ minimal (few mA) for INA226s Expect ~~90% SMPS efficiency
forced continuous PWM
internal 2 MHz osc
not syncing
ADC for monitoring SMPS die temperature Address = 8'h28
LDO for 3.3V analog rail (just used by sensors)
ADC decoupling
Temperature sensor Address = 8'h80
Thermometer decoupling
ADC for monitoring 1V0 voltage/current Address = 8'h81
ADC for monitoring 1V8 voltage/current Address = 8'h82
ADC for monitoring 2V5 voltage/current Address = 8'h83
INA226 decoupling
81.92 mV max scale 1V0/2V5: 10 mR * 3A = 30 mV worst case, 1A/10 mV typ 1V8: 10 mR * 2A = 20 mV worst case, 1A/10 mV typ
SMPS input caps
SMPS output caps
LDO caps
1210 size
0805 size
