azonenberg/latentpacket/latentred/boards/linecard/latentred-linecard/latentred-linecard.kicad_pcb

## KiCad design latentred/boards/linecard/latentred-linecard/latentred-linecard.kicad_pcb (continued)

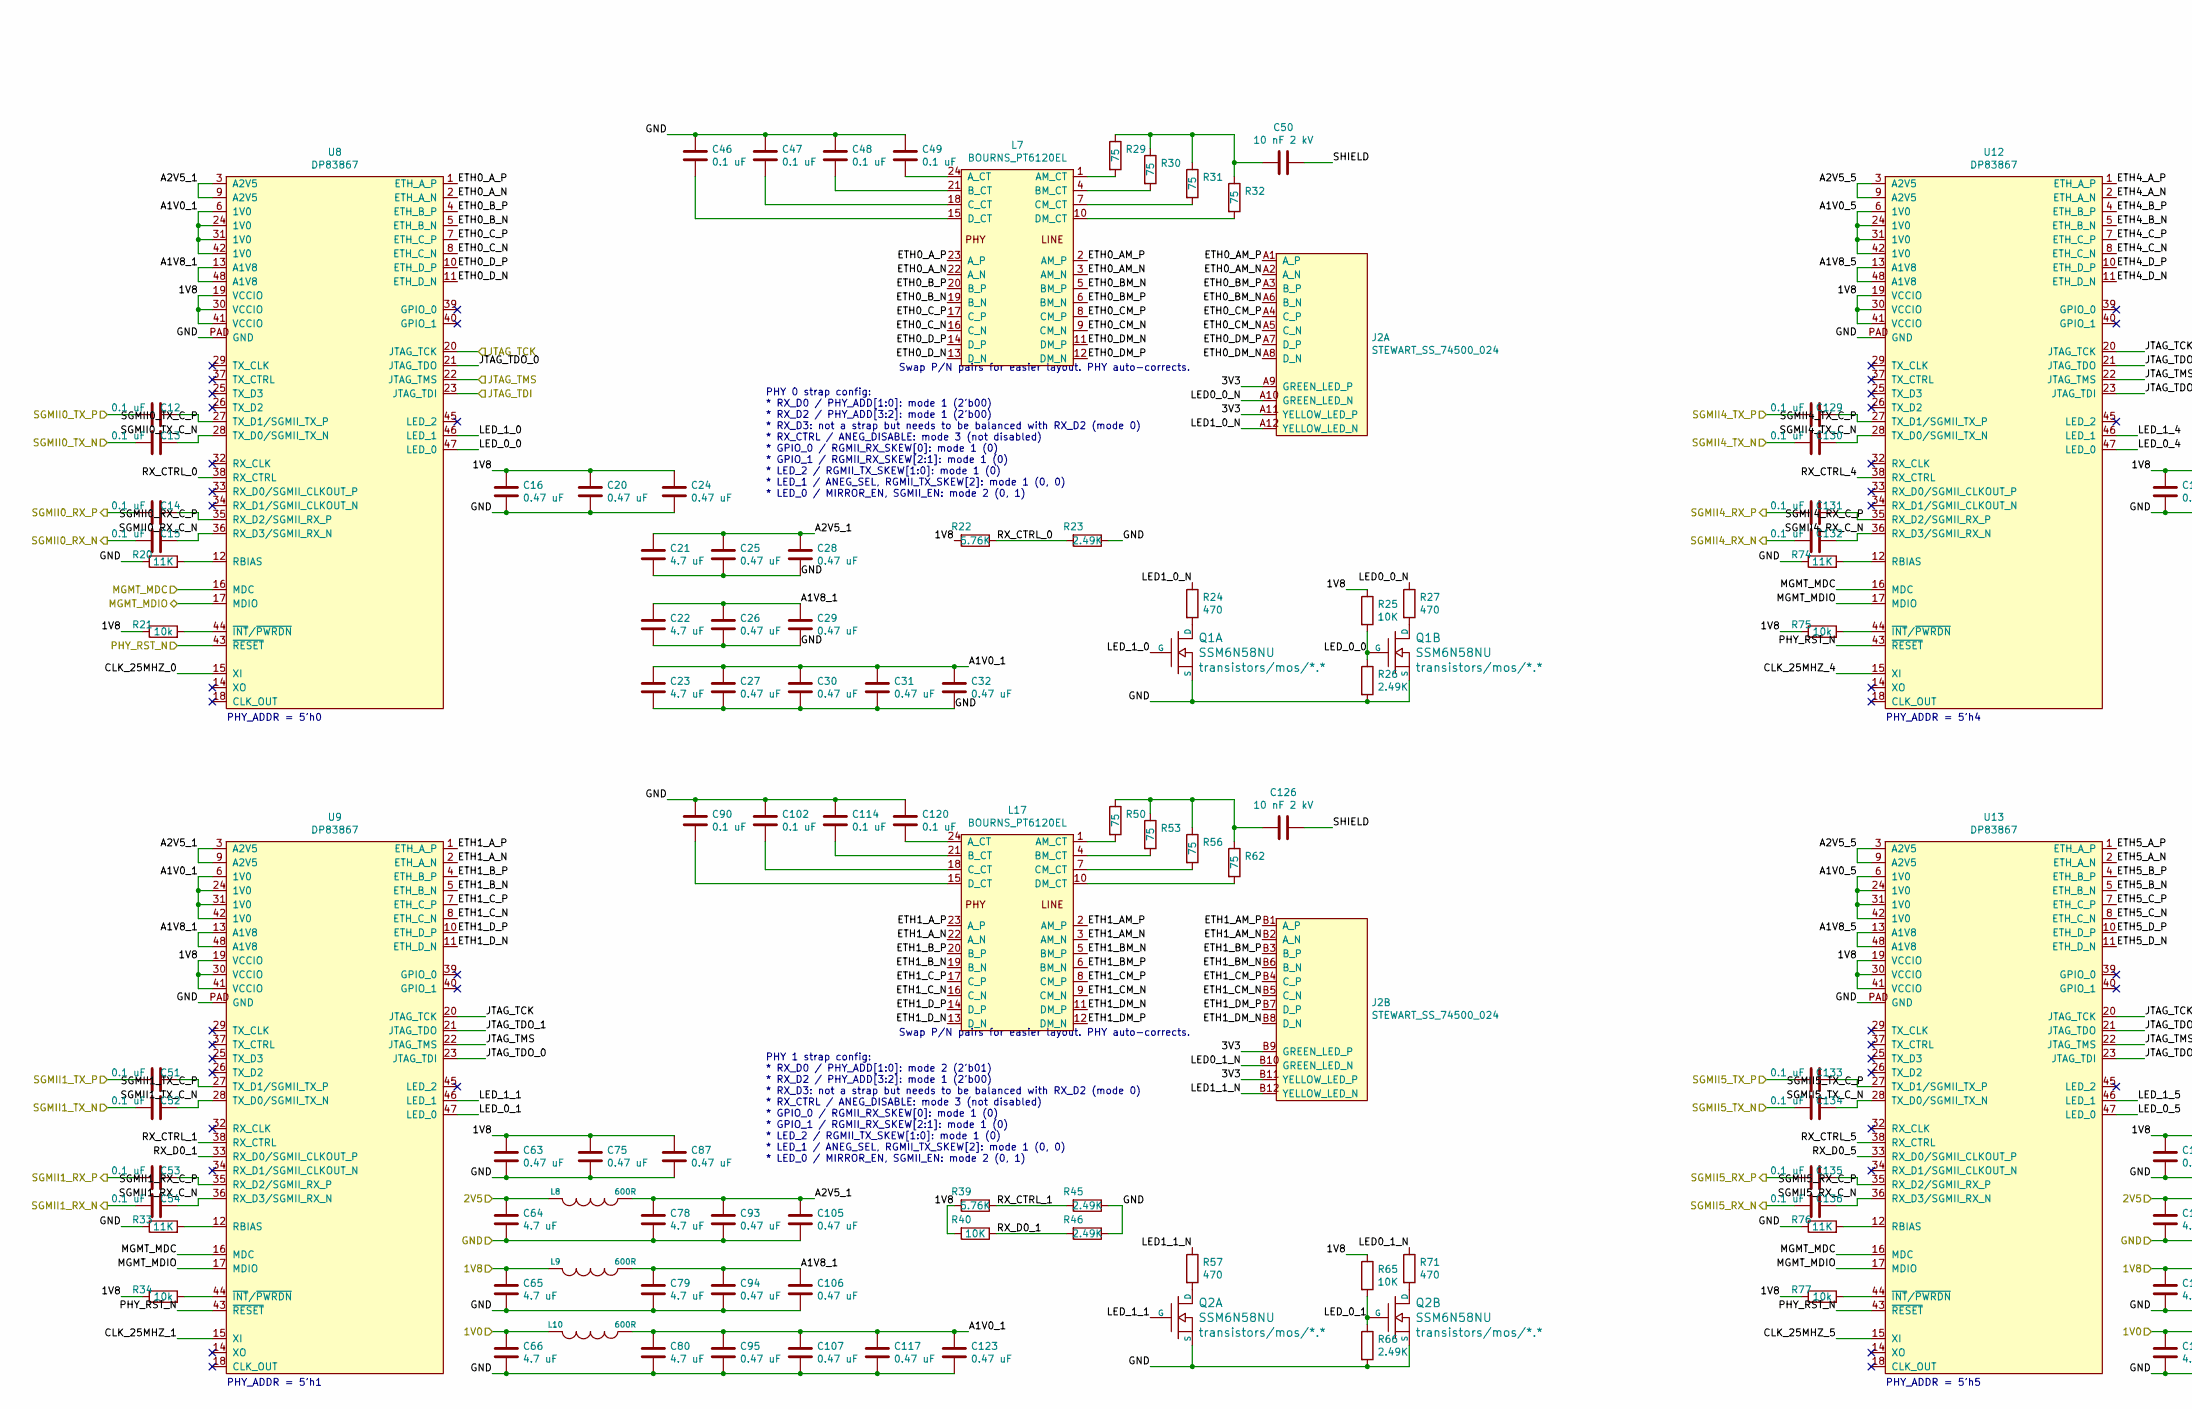
[picture p23: schematic phys.sch, LATENTRED 8-port 10/100/1000 Base-T Line Card, part in row 1, column 1]

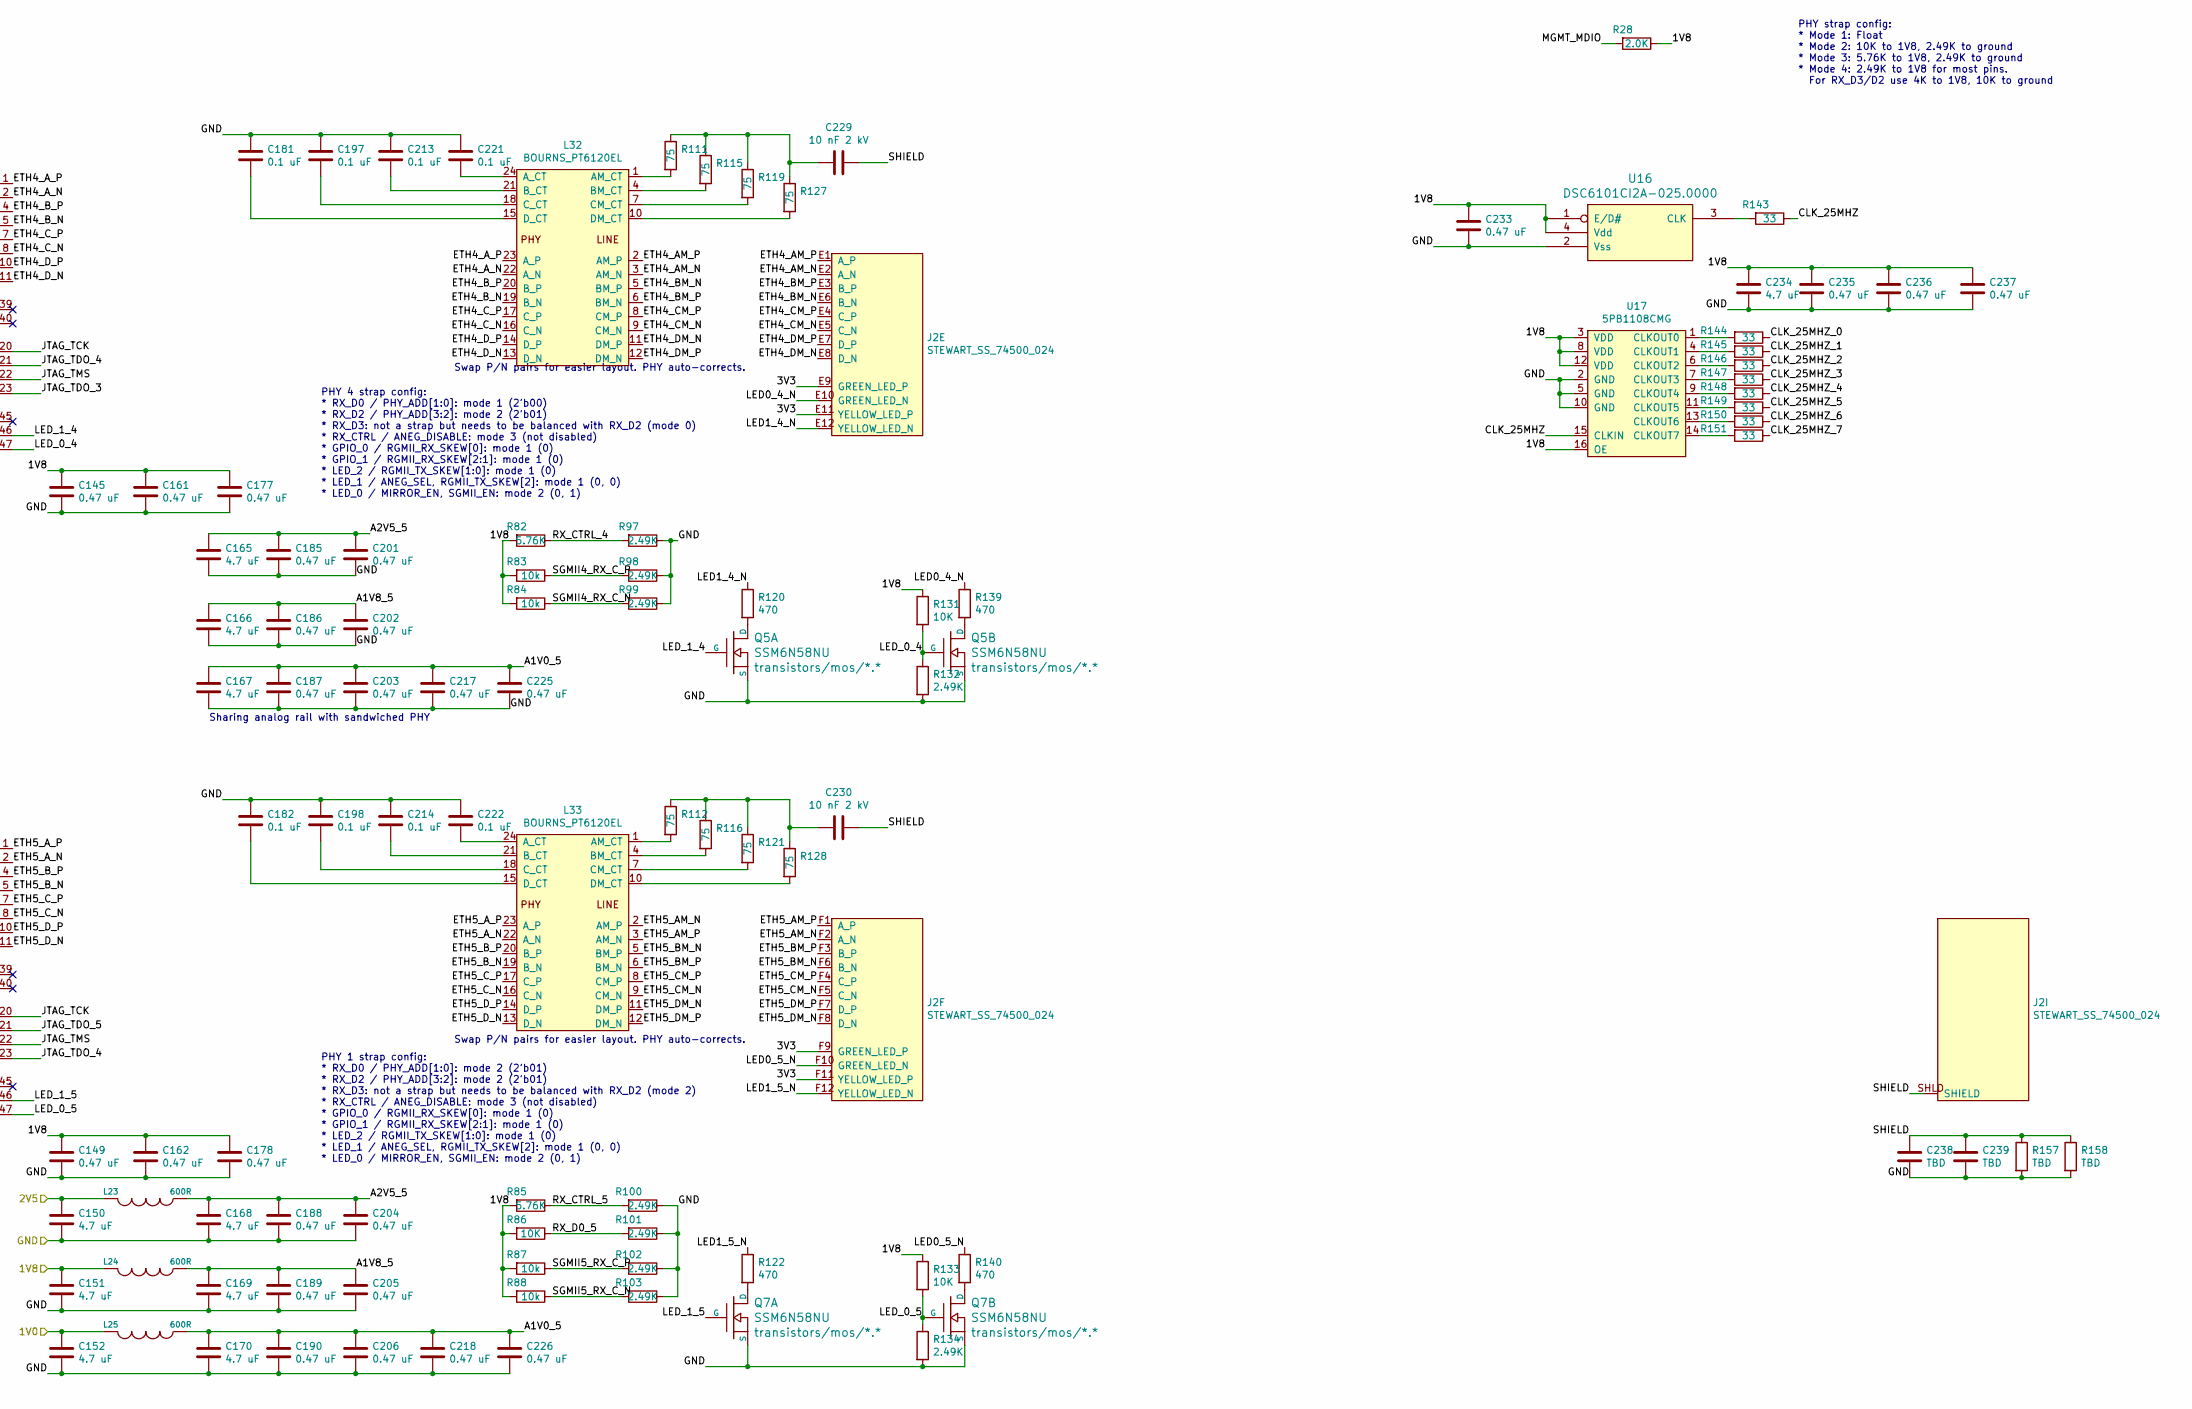
[picture p24: schematic phys.sch, LATENTRED 8-port 10/100/1000 Base-T Line Card, part in row 1, column 2]

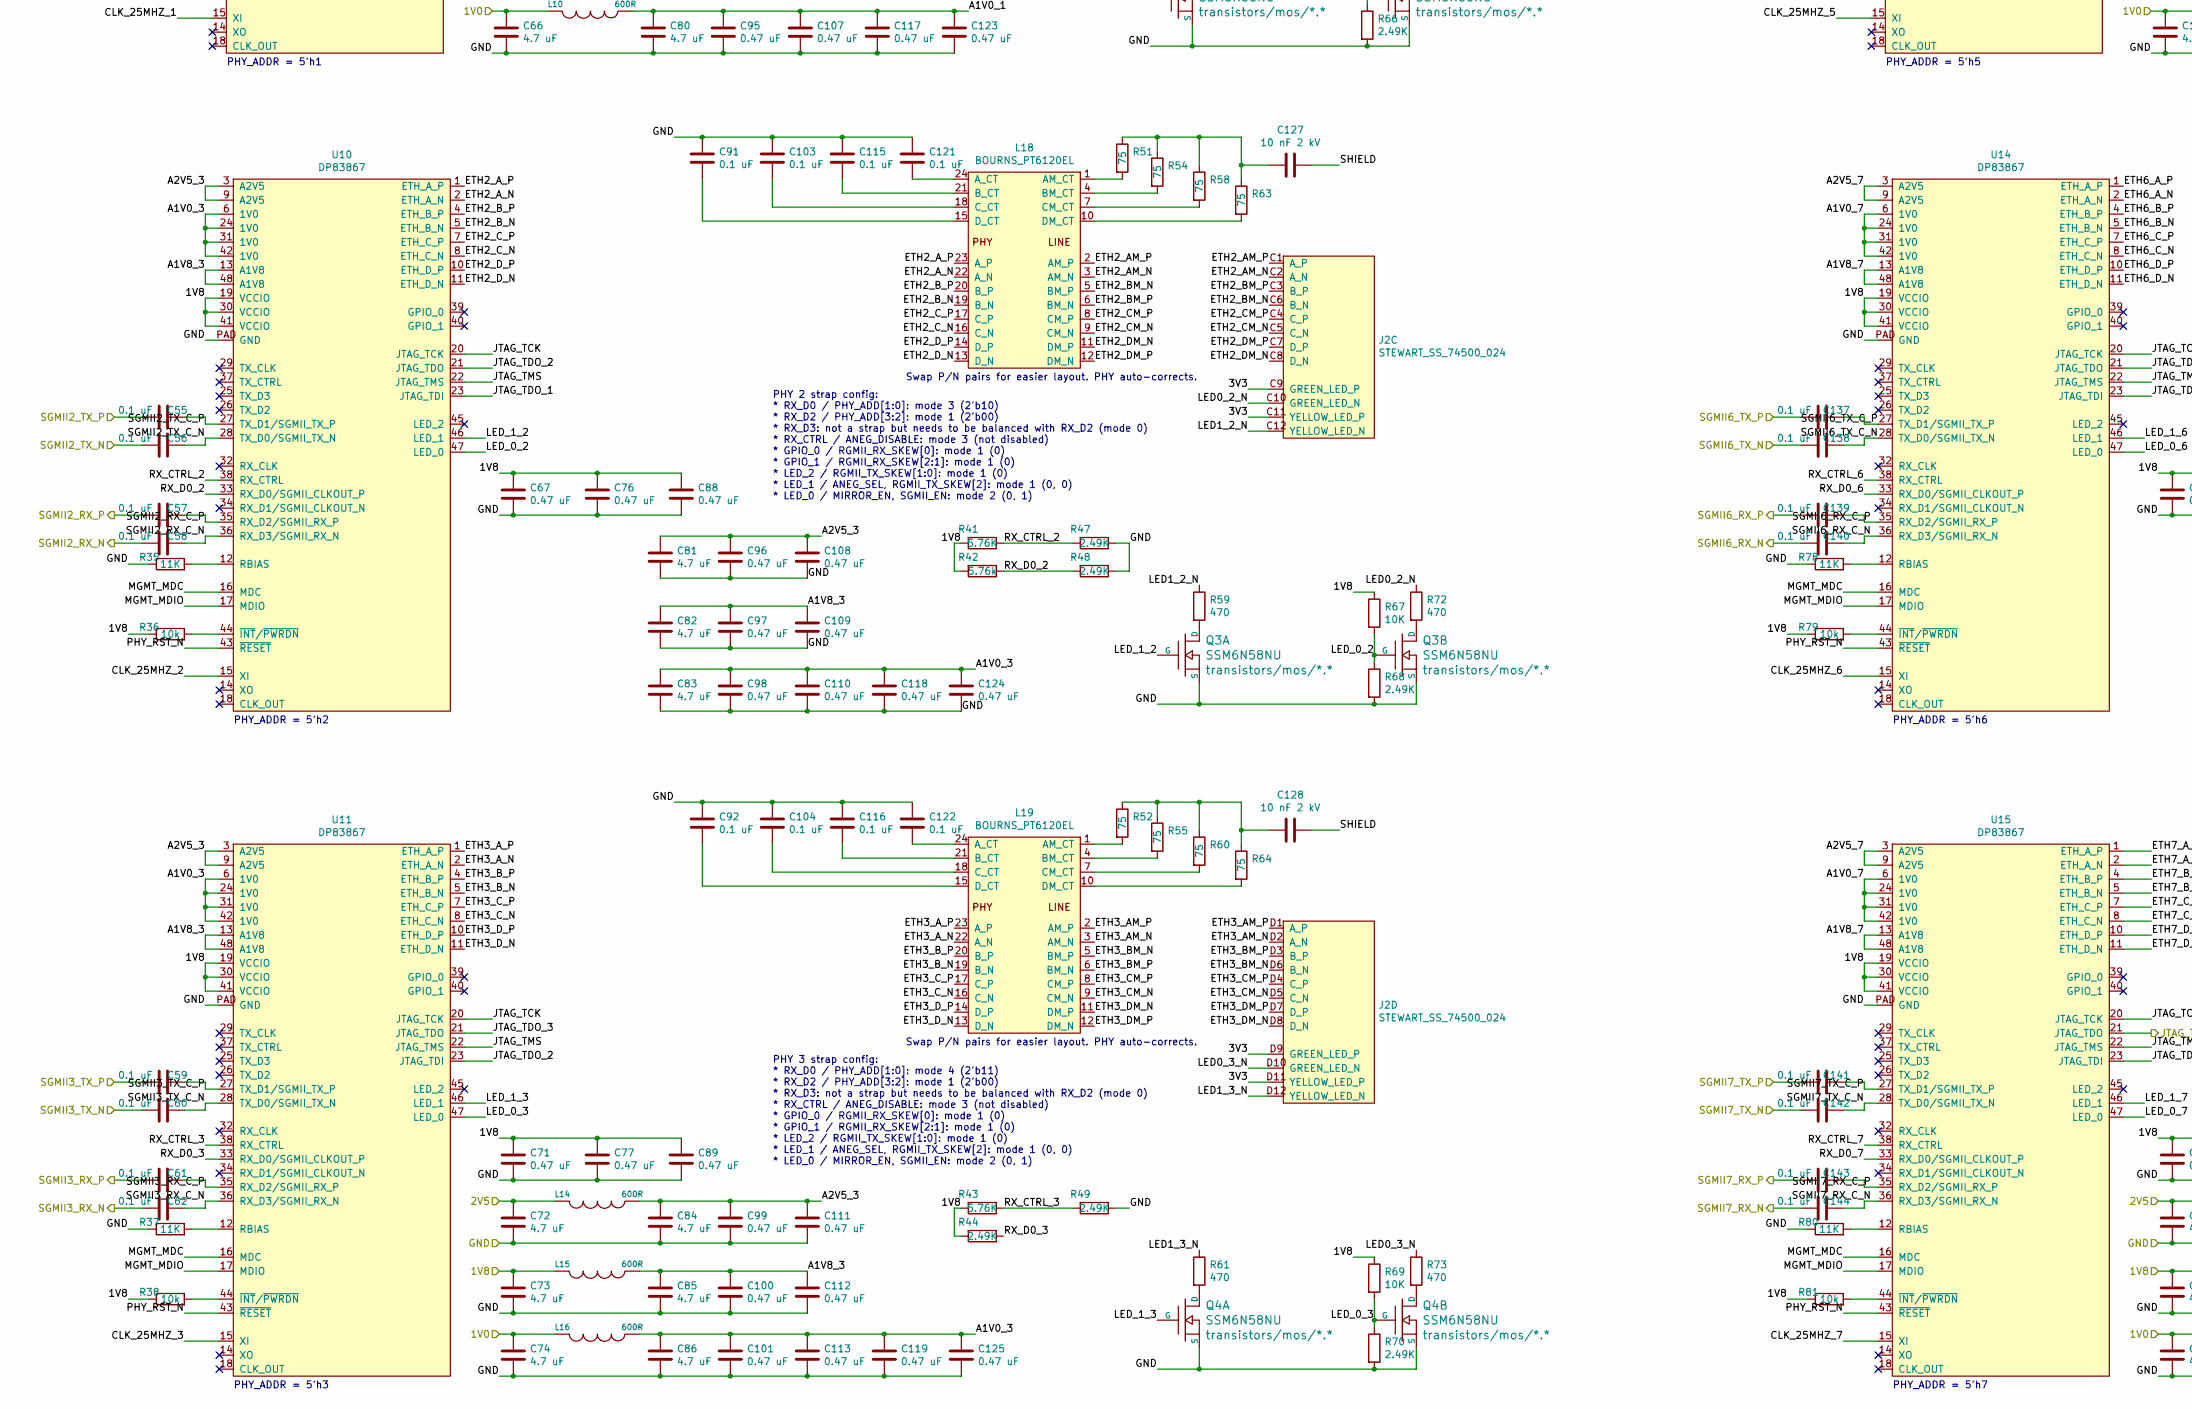
[picture p25: schematic phys.sch, LATENTRED 8-port 10/100/1000 Base-T Line Card, part in row 2, column 1]

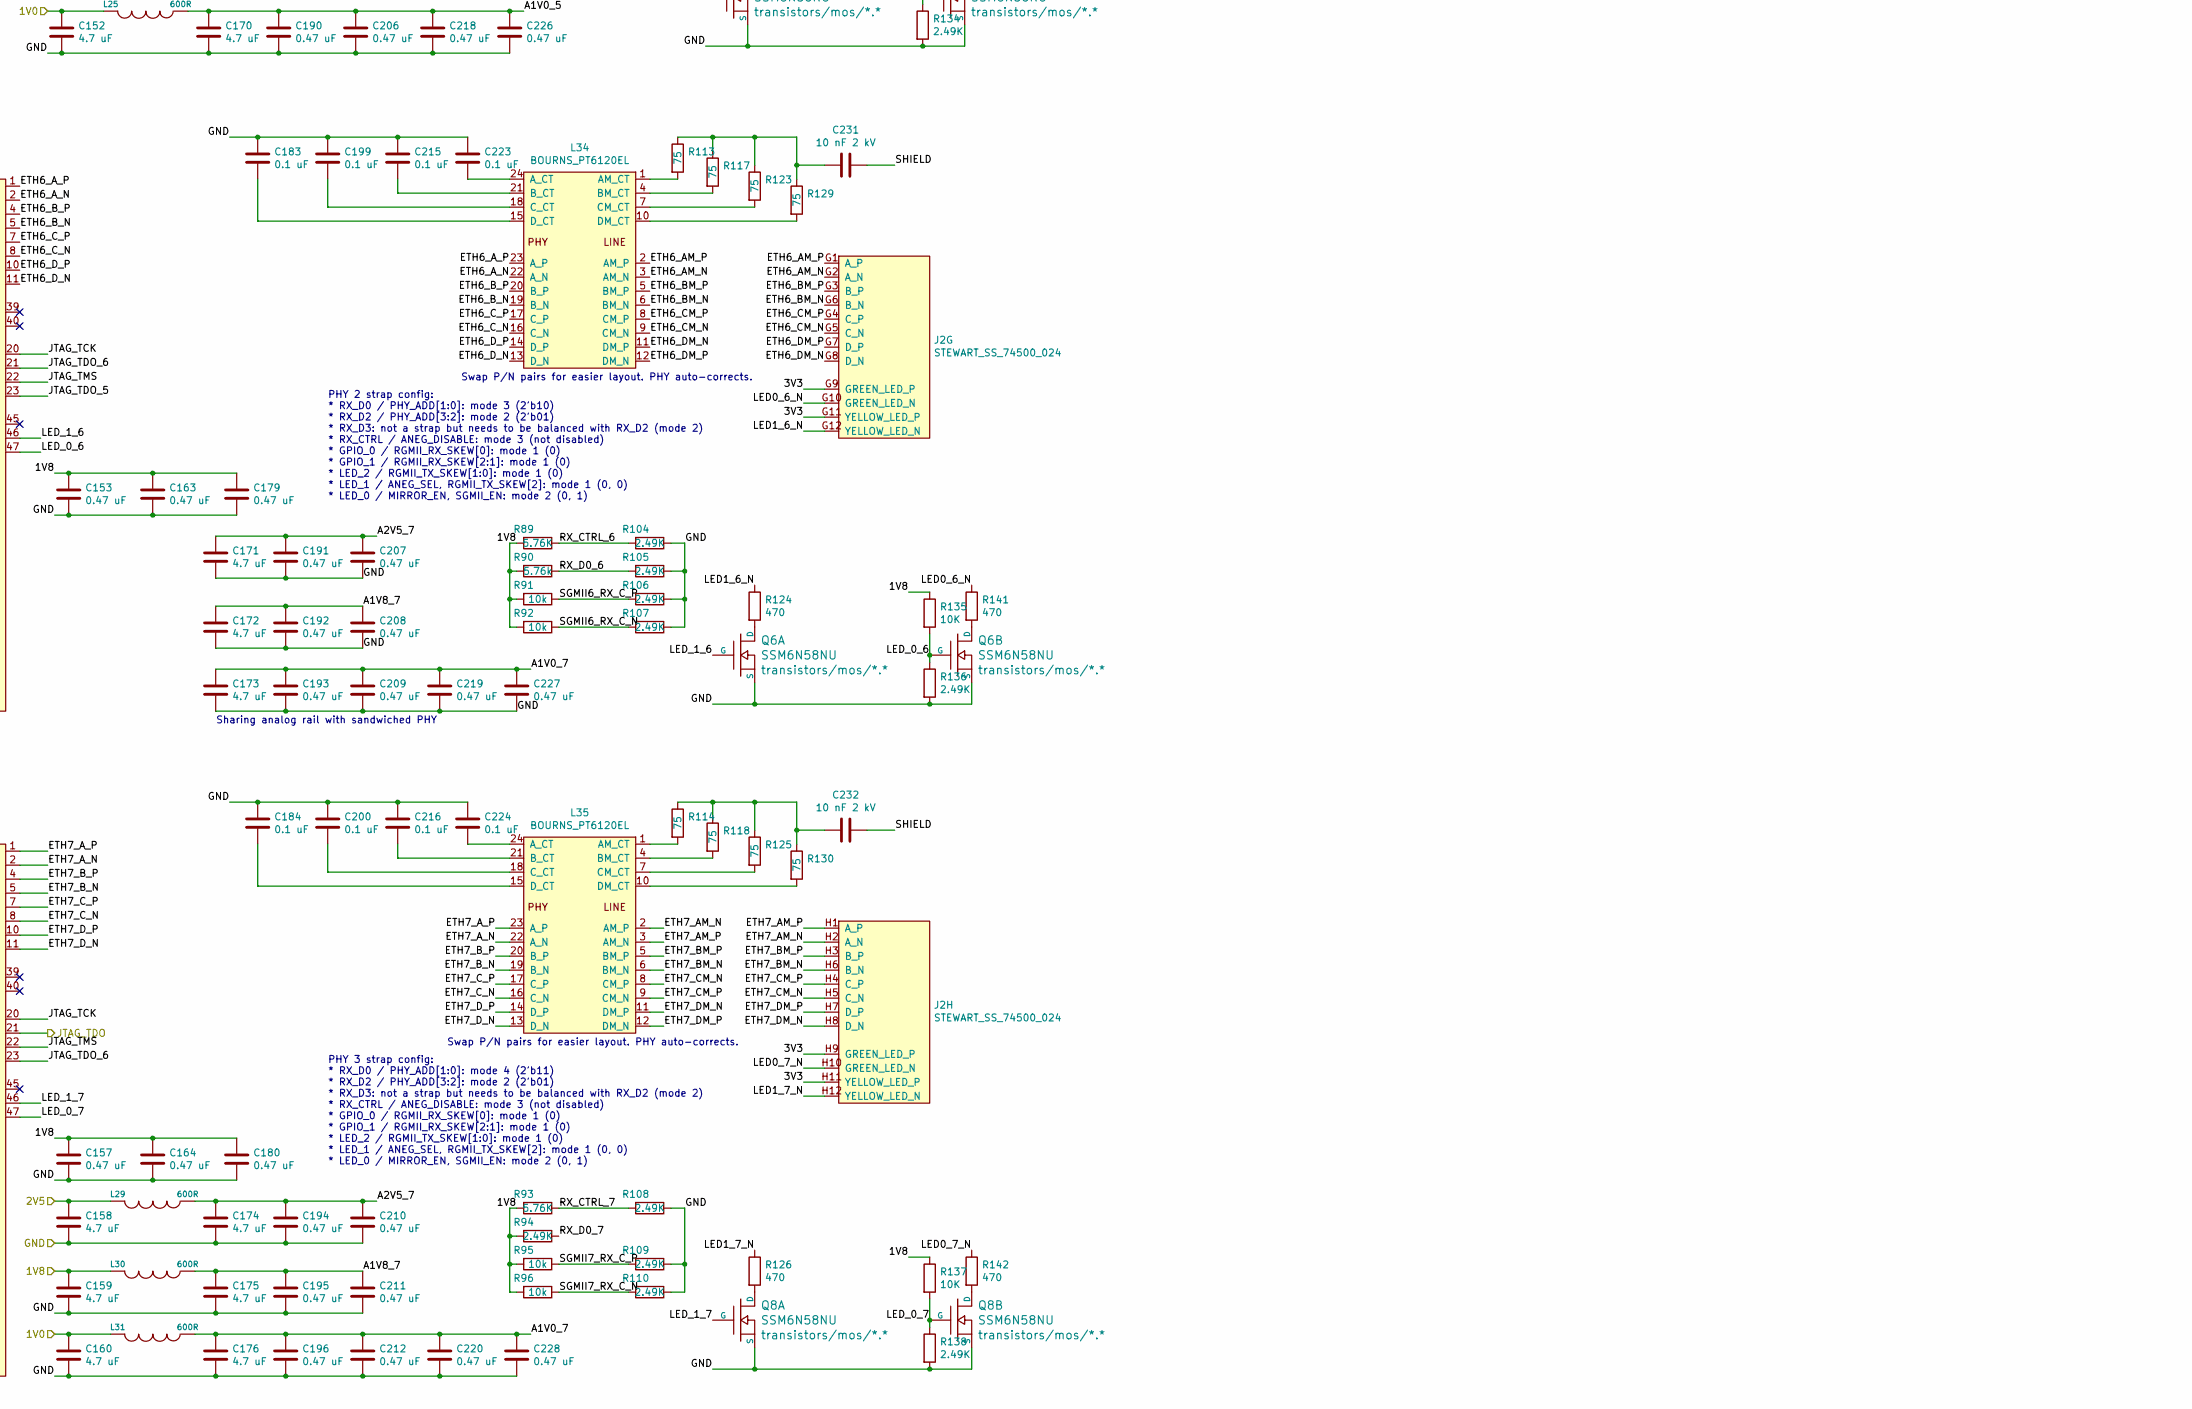
[picture p26: schematic phys.sch, LATENTRED 8-port 10/100/1000 Base-T Line Card, part in row 2, column 2]

Parts:
C12, C13, C14, C15, C46, C47, C48, C49, C51, C52, C53, C54, C55, C56, C57, C58, C59, C60, C61, C62, C90, C91, C92, C102, C103, C104, C114, C115, C116, C120, C121, C122, C129, C130, C131, C132, C133, C134, C135, C136, C137, C138, C139, C140, C141, C142, C143, C144, C181, C182, C183, C184, C197, C198, C199, C200, C213, C214, C215, C216, C221, C222, C223, C224: 0.1 uF; EIA_0402_CAP_NOSILK
C16, C20, C24, C25, C26, C27, C28, C29, C30, C31, C32, C63, C67, C71, C75, C76, C77, C87, C88, C89, C93, C94, C95, C96, C97, C98, C99, C100, C101, C105, C106, C107, C108, C109, C110, C111, C112, C113, C117, C118, C119, C123, C124, C125, C145, C149, C153, C157, C161, C162, C163, C164, C177, C178, C179, C180, C185, C186, C187, C188, C189, C190, C191, C192, C193, C194, C195, C196, C201, C202, C203, C204, C205, C206, C207, C208, C209, C210, C211, C212, C217, C218, C219, C220, C225, C226, C227, C228, C233, C235, C236, C237: 0.47 uF; EIA_0402_CAP_NOSILK
C21, C22, C23, C64, C65, C66, C72, C73, C74, C78, C79, C80, C81, C82, C83, C84, C85, C86, C150, C151, C152, C158, C159, C160, C165, C166, C167, C168, C169, C170, C171, C172, C173, C174, C175, C176, C234: 4.7 uF; EIA_0603_CAP_NOSILK
C50, C126, C127, C128, C229, C230, C231, C232: 10 nF 2 kV; EIA_1812_CAP_NOSILK
C238, C239: TBD; EIA_1206_CAP_NOSILK
J2: STEWART_SS_74500_024; CONN_STEWART_SS_74500_024
L7, L17, L18, L19, L32, L33, L34, L35: BOURNS_PT6120EL; BOURNS_PT61020EL
L8, L9, L10, L14, L15, L16, L23, L24, L25, L29, L30, L31: 600R; EIA_0402_RES_NOSILK
Q1, Q2, Q3, Q4, Q5, Q6, Q7, Q8: SSM6N58NU; DFN_6_0.65MM_2x2MM_GDS
R20, R33, R35, R37, R74, R76, R78, R80: 11K; EIA_0402_RES_NOSILK
R21, R34, R36, R38, R75, R77, R79, R81, R83, R84, R87, R88, R91, R92, R95, R96: 10k; EIA_0402_RES_NOSILK
R22, R39, R41, R43, R82, R85, R89, R93: 5.76K; EIA_0402_RES_NOSILK
R23, R26, R44, R45, R46, R47, R48, R49, R66, R68, R70, R94, R97, R98, R99, R100, R101, R102, R103, R104, R105, R106, R107, R108, R109, R110, R132, R134, R136, R138: 2.49K; EIA_0402_RES_NOSILK
R24, R27, R57, R59, R61, R71, R72, R73, R120, R122, R124, R126, R139, R140, R141, R142: 470; EIA_0402_RES_NOSILK
R25, R40, R65, R67, R69, R86, R131, R133, R135, R137: 10K; EIA_0402_RES_NOSILK
R28: 2.0K; EIA_0402_RES_NOSILK
R29, R30, R31, R32, R50, R51, R52, R53, R54, R55, R56, R58, R60, R62, R63, R64, R111, R112, R113, R114, R115, R116, R117, R118, R119, R121, R123, R125, R127, R128, R129, R130: 75; EIA_0402_RES_NOSILK
R42, R90: 5.76k; EIA_0402_RES_NOSILK
R143, R144, R145, R146, R147, R148, R149, R150, R151: 33; EIA_0402_RES_NOSILK
R157, R158: TBD; EIA_1206_CAP_NOSILK
U8, U9, U10, U11, U12, U13, U14, U15: DP83867; QFN_48_0.5MM_7x7MM
U16: DSC6101CI2A-025.0000; OSCILLATOR_3.2x2.5
U17: 5PB1108CMG; QFN_16_0.4MM_2p5x2.5MM_NOPAD

Connections:
/GND: C16.2, C20.2, C21.2, C22.2, C23.2, C24.2, C25.2, C26.2, C27.2, C28.2, C29.2, C30.2, C31.2, C32.2, C46.1, C47.1, C48.1, C49.1, C63.2, C64.2, C65.2, C66.2, C67.2, C71.2, C72.2, C73.2, C74.2, C75.2, C76.2, C77.2, C78.2, C79.2, C80.2, C81.2, C82.2, C83.2, C84.2, C85.2, C86.2, C87.2, C88.2, C89.2, C90.1, C91.1, C92.1, C93.2, C94.2, C95.2, C96.2, C97.2, C98.2, C99.2, C100.2, C101.2, C102.1, C103.1, C104.1, C105.2, C106.2, C107.2, C108.2, C109.2, C110.2, C111.2, C112.2, C113.2, C114.1, C115.1, C116.1, C117.2, C118.2, C119.2, C120.1, C121.1, C122.1, C123.2, C124.2, C125.2, C145.2, C149.2, C150.2, C151.2, C152.2, C153.2, C157.2, C158.2, C159.2, C160.2, C161.2, C162.2, C163.2, C164.2, C165.2, C166.2, C167.2, C168.2, C169.2, C170.2, C171.2, C172.2, C173.2, C174.2, C175.2, C176.2, C177.2, C178.2, C179.2, C180.2, C181.1, C182.1, C183.1, C184.1, C185.2, C186.2, C187.2, C188.2, C189.2, C190.2, C191.2, C192.2, C193.2, C194.2, C195.2, C196.2, C197.1, C198.1, C199.1, C200.1, C201.2, C202.2, C203.2, C204.2, C205.2, C206.2, C207.2, C208.2, C209.2, C210.2, C211.2, C212.2, C213.1, C214.1, C215.1, C216.1, C217.2, C218.2, C219.2, C220.2, C221.1, C222.1, C223.1, C224.1, C225.2, C226.2, C227.2, C228.2, C233.2, C234.2, C235.2, C236.2, C237.2, C238.2, C239.2, Q1.S1 (S), Q1.S2 (S), Q2.S1 (S), Q2.S2 (S), Q3.S1 (S), Q3.S2 (S), Q4.S1 (S), Q4.S2 (S), Q5.S1 (S), Q5.S2 (S), Q6.S1 (S), Q6.S2 (S), Q7.S1 (S), Q7.S2 (S), Q8.S1 (S), Q8.S2 (S), R20.1, R23.1, R26.2, R33.1, R35.1, R37.1, R45.1, R46.1, R47.1, R48.1, R49.1, R66.2, R68.2, R70.2, R74.1, R76.1, R78.1, R80.1, R97.1, R98.1, R99.1, R100.1, R101.1, R102.1, R103.1, R104.1, R105.1, R106.1, R107.1, R108.1, R109.1, R110.1, R132.2, R134.2, R136.2, R138.2, R157.2, R158.2, U8.PAD (GND), U9.PAD (GND), U10.PAD (GND), U11.PAD (GND), U12.PAD (GND), U13.PAD (GND), U14.PAD (GND), U15.PAD (GND), U16.2 (Vss), U17.2 (GND), U17.5 (GND), U17.10 (GND); also elsewhere on the board
/JTAG_TCK: U8.20 (JTAG_TCK), U9.20 (JTAG_TCK), U10.20 (JTAG_TCK), U11.20 (JTAG_TCK), U12.20 (JTAG_TCK), U13.20 (JTAG_TCK), U14.20 (JTAG_TCK), U15.20 (JTAG_TCK); also elsewhere on the board
/JTAG_TDI: U8.23 (JTAG_TDI); also elsewhere on the board
/JTAG_TDO: U15.21 (JTAG_TDO); also elsewhere on the board
/JTAG_TMS: U8.22 (JTAG_TMS), U9.22 (JTAG_TMS), U10.22 (JTAG_TMS), U11.22 (JTAG_TMS), U12.22 (JTAG_TMS), U13.22 (JTAG_TMS), U14.22 (JTAG_TMS), U15.22 (JTAG_TMS); also elsewhere on the board
/MGMT_MDC: U8.16 (MDC), U9.16 (MDC), U10.16 (MDC), U11.16 (MDC), U12.16 (MDC), U13.16 (MDC), U14.16 (MDC), U15.16 (MDC); also elsewhere on the board
/MGMT_MDIO: R28.2, U8.17 (MDIO), U9.17 (MDIO), U10.17 (MDIO), U11.17 (MDIO), U12.17 (MDIO), U13.17 (MDIO), U14.17 (MDIO), U15.17 (MDIO); also elsewhere on the board
/PHY_RST_N: U8.43 (~RESET), U9.43 (~RESET), U10.43 (~RESET), U11.43 (~RESET), U12.43 (~RESET), U13.43 (~RESET), U14.43 (~RESET), U15.43 (~RESET); also elsewhere on the board
/PHYs/1V0: C66.1, C74.1, C152.1, C160.1, L10.2, L16.2, L25.2, L31.2; also elsewhere on the board
/PHYs/1V8: C16.1, C20.1, C24.1, C63.1, C65.1, C67.1, C71.1, C73.1, C75.1, C76.1, C77.1, C87.1, C88.1, C89.1, C145.1, C149.1, C151.1, C153.1, C157.1, C159.1, C161.1, C162.1, C163.1, C164.1, C177.1, C178.1, C179.1, C180.1, C233.1, C234.1, C235.1, C236.1, C237.1, L9.2, L15.2, L24.2, L30.2, R21.1, R22.2, R25.1, R28.1, R34.1, R36.1, R38.1, R39.2, R40.2, R41.2, R42.2, R43.2, R44.2, R65.1, R67.1, R69.1, R75.1, R77.1, R79.1, R81.1, R82.2, R83.2, R84.2, R85.2, R86.2, R87.2, R88.2, R89.2, R90.2, R91.2, R92.2, R93.2, R94.2, R95.2, R96.2, R131.1, R133.1, R135.1, R137.1, U8.19 (VCCIO), U8.30 (VCCIO), U8.41 (VCCIO), U9.19 (VCCIO), U9.30 (VCCIO), U9.41 (VCCIO), U10.19 (VCCIO), U10.30 (VCCIO), U10.41 (VCCIO), U11.19 (VCCIO), U11.30 (VCCIO), U11.41 (VCCIO), U12.19 (VCCIO), U12.30 (VCCIO), U12.41 (VCCIO), U13.19 (VCCIO), U13.30 (VCCIO), U13.41 (VCCIO), U14.19 (VCCIO), U14.30 (VCCIO), U14.41 (VCCIO), U15.19 (VCCIO), U15.30 (VCCIO), U15.41 (VCCIO), U16.1 (E/D#), U16.4 (Vdd), U17.3 (VDD), U17.8 (VDD), U17.12 (VDD), U17.16 (OE); also elsewhere on the board
/PHYs/2V5: C64.1, C72.1, C150.1, C158.1, L8.2, L14.2, L23.2, L29.2; also elsewhere on the board
/PHYs/3V3: J2.A9 (GREEN_LED_P), J2.A11 (YELLOW_LED_P), J2.B9 (GREEN_LED_P), J2.B11 (YELLOW_LED_P), J2.C9 (GREEN_LED_P), J2.C11 (YELLOW_LED_P), J2.D9 (GREEN_LED_P), J2.D11 (YELLOW_LED_P), J2.E9 (GREEN_LED_P), J2.E11 (YELLOW_LED_P), J2.F9 (GREEN_LED_P), J2.F11 (YELLOW_LED_P), J2.G9 (GREEN_LED_P), J2.G11 (YELLOW_LED_P), J2.H9 (GREEN_LED_P), J2.H11 (YELLOW_LED_P)
/PHYs/A1V0_1: C23.1, C27.1, C30.1, C31.1, C32.1, C80.1, C95.1, C107.1, C117.1, C123.1, L10.1, U8.6 (1V0), U8.24 (1V0), U8.31 (1V0), U8.42 (1V0), U9.6 (1V0), U9.24 (1V0), U9.31 (1V0), U9.42 (1V0)
/PHYs/A1V0_3: C83.1, C86.1, C98.1, C101.1, C110.1, C113.1, C118.1, C119.1, C124.1, C125.1, L16.1, U10.6 (1V0), U10.24 (1V0), U10.31 (1V0), U10.42 (1V0), U11.6 (1V0), U11.24 (1V0), U11.31 (1V0), U11.42 (1V0)
/PHYs/A1V0_5: C167.1, C170.1, C187.1, C190.1, C203.1, C206.1, C217.1, C218.1, C225.1, C226.1, L25.1, U12.6 (1V0), U12.24 (1V0), U12.31 (1V0), U12.42 (1V0), U13.6 (1V0), U13.24 (1V0), U13.31 (1V0), U13.42 (1V0)
/PHYs/A1V0_7: C173.1, C176.1, C193.1, C196.1, C209.1, C212.1, C219.1, C220.1, C227.1, C228.1, L31.1, U14.6 (1V0), U14.24 (1V0), U14.31 (1V0), U14.42 (1V0), U15.6 (1V0), U15.24 (1V0), U15.31 (1V0), U15.42 (1V0)
/PHYs/A1V8_1: C22.1, C26.1, C29.1, C79.1, C94.1, C106.1, L9.1, U8.13 (A1V8), U8.48 (A1V8), U9.13 (A1V8), U9.48 (A1V8)
/PHYs/A1V8_3: C82.1, C85.1, C97.1, C100.1, C109.1, C112.1, L15.1, U10.13 (A1V8), U10.48 (A1V8), U11.13 (A1V8), U11.48 (A1V8)
/PHYs/A1V8_5: C166.1, C169.1, C186.1, C189.1, C202.1, C205.1, L24.1, U12.13 (A1V8), U12.48 (A1V8), U13.13 (A1V8), U13.48 (A1V8)
/PHYs/A1V8_7: C172.1, C175.1, C192.1, C195.1, C208.1, C211.1, L30.1, U14.13 (A1V8), U14.48 (A1V8), U15.13 (A1V8), U15.48 (A1V8)
/PHYs/A2V5_1: C21.1, C25.1, C28.1, C78.1, C93.1, C105.1, L8.1, U8.3 (A2V5), U8.9 (A2V5), U9.3 (A2V5), U9.9 (A2V5)
/PHYs/A2V5_3: C81.1, C84.1, C96.1, C99.1, C108.1, C111.1, L14.1, U10.3 (A2V5), U10.9 (A2V5), U11.3 (A2V5), U11.9 (A2V5)
/PHYs/A2V5_5: C165.1, C168.1, C185.1, C188.1, C201.1, C204.1, L23.1, U12.3 (A2V5), U12.9 (A2V5), U13.3 (A2V5), U13.9 (A2V5)
/PHYs/A2V5_7: C171.1, C174.1, C191.1, C194.1, C207.1, C210.1, L29.1, U14.3 (A2V5), U14.9 (A2V5), U15.3 (A2V5), U15.9 (A2V5)
/PHYs/CLK_25MHZ: R143.1, U17.15 (CLKIN)
/PHYs/CLK_25MHZ_0: R144.1, U8.15 (XI)
/PHYs/CLK_25MHZ_1: R145.1, U9.15 (XI)
/PHYs/CLK_25MHZ_2: R146.1, U10.15 (XI)
/PHYs/CLK_25MHZ_3: R147.1, U11.15 (XI)
/PHYs/CLK_25MHZ_4: R148.1, U12.15 (XI)
/PHYs/CLK_25MHZ_5: R149.1, U13.15 (XI)
/PHYs/CLK_25MHZ_6: R150.1, U14.15 (XI)
/PHYs/CLK_25MHZ_7: R151.1, U15.15 (XI)
/PHYs/ETH0_AM_N: J2.A2 (A_N), L7.3 (AM_N)
/PHYs/ETH0_AM_P: J2.A1 (A_P), L7.2 (AM_P)
/PHYs/ETH0_A_N: L7.22 (A_N), U8.2 (ETH_A_N)
/PHYs/ETH0_A_P: L7.23 (A_P), U8.1 (ETH_A_P)
/PHYs/ETH0_BM_N: J2.A6 (B_N), L7.5 (BM_P)
/PHYs/ETH0_BM_P: J2.A3 (B_P), L7.6 (BM_N)
/PHYs/ETH0_B_N: L7.19 (B_N), U8.5 (ETH_B_N)
/PHYs/ETH0_B_P: L7.20 (B_P), U8.4 (ETH_B_P)
/PHYs/ETH0_CM_N: J2.A5 (C_N), L7.9 (CM_N)
/PHYs/ETH0_CM_P: J2.A4 (C_P), L7.8 (CM_P)
/PHYs/ETH0_C_N: L7.16 (C_N), U8.8 (ETH_C_N)
/PHYs/ETH0_C_P: L7.17 (C_P), U8.7 (ETH_C_P)
/PHYs/ETH0_DM_N: J2.A8 (D_N), L7.11 (DM_P)
/PHYs/ETH0_DM_P: J2.A7 (D_P), L7.12 (DM_N)
/PHYs/ETH0_D_N: L7.13 (D_N), U8.11 (ETH_D_N)
/PHYs/ETH0_D_P: L7.14 (D_P), U8.10 (ETH_D_P)
/PHYs/ETH1_AM_N: J2.B2 (A_N), L17.3 (AM_N)
/PHYs/ETH1_AM_P: J2.B1 (A_P), L17.2 (AM_P)
/PHYs/ETH1_A_N: L17.22 (A_N), U9.2 (ETH_A_N)
/PHYs/ETH1_A_P: L17.23 (A_P), U9.1 (ETH_A_P)
/PHYs/ETH1_BM_N: J2.B6 (B_N), L17.5 (BM_P)
/PHYs/ETH1_BM_P: J2.B3 (B_P), L17.6 (BM_N)
/PHYs/ETH1_B_N: L17.19 (B_N), U9.5 (ETH_B_N)
/PHYs/ETH1_B_P: L17.20 (B_P), U9.4 (ETH_B_P)
/PHYs/ETH1_CM_N: J2.B5 (C_N), L17.9 (CM_N)
/PHYs/ETH1_CM_P: J2.B4 (C_P), L17.8 (CM_P)
/PHYs/ETH1_C_N: L17.16 (C_N), U9.8 (ETH_C_N)
/PHYs/ETH1_C_P: L17.17 (C_P), U9.7 (ETH_C_P)
/PHYs/ETH1_DM_N: J2.B8 (D_N), L17.11 (DM_P)
/PHYs/ETH1_DM_P: J2.B7 (D_P), L17.12 (DM_N)
/PHYs/ETH1_D_N: L17.13 (D_N), U9.11 (ETH_D_N)
/PHYs/ETH1_D_P: L17.14 (D_P), U9.10 (ETH_D_P)
/PHYs/ETH2_AM_N: J2.C2 (A_N), L18.3 (AM_N)
/PHYs/ETH2_AM_P: J2.C1 (A_P), L18.2 (AM_P)
/PHYs/ETH2_A_N: L18.22 (A_N), U10.2 (ETH_A_N)
/PHYs/ETH2_A_P: L18.23 (A_P), U10.1 (ETH_A_P)
/PHYs/ETH2_BM_N: J2.C6 (B_N), L18.5 (BM_P)
/PHYs/ETH2_BM_P: J2.C3 (B_P), L18.6 (BM_N)
/PHYs/ETH2_B_N: L18.19 (B_N), U10.5 (ETH_B_N)
/PHYs/ETH2_B_P: L18.20 (B_P), U10.4 (ETH_B_P)
/PHYs/ETH2_CM_N: J2.C5 (C_N), L18.9 (CM_N)
/PHYs/ETH2_CM_P: J2.C4 (C_P), L18.8 (CM_P)
/PHYs/ETH2_C_N: L18.16 (C_N), U10.8 (ETH_C_N)
/PHYs/ETH2_C_P: L18.17 (C_P), U10.7 (ETH_C_P)
/PHYs/ETH2_DM_N: J2.C8 (D_N), L18.11 (DM_P)
/PHYs/ETH2_DM_P: J2.C7 (D_P), L18.12 (DM_N)
/PHYs/ETH2_D_N: L18.13 (D_N), U10.11 (ETH_D_N)
/PHYs/ETH2_D_P: L18.14 (D_P), U10.10 (ETH_D_P)
/PHYs/ETH3_AM_N: J2.D2 (A_N), L19.3 (AM_N)
/PHYs/ETH3_AM_P: J2.D1 (A_P), L19.2 (AM_P)
/PHYs/ETH3_A_N: L19.22 (A_N), U11.2 (ETH_A_N)
/PHYs/ETH3_A_P: L19.23 (A_P), U11.1 (ETH_A_P)
/PHYs/ETH3_BM_N: J2.D6 (B_N), L19.5 (BM_P)
/PHYs/ETH3_BM_P: J2.D3 (B_P), L19.6 (BM_N)
/PHYs/ETH3_B_N: L19.19 (B_N), U11.5 (ETH_B_N)
/PHYs/ETH3_B_P: L19.20 (B_P), U11.4 (ETH_B_P)
/PHYs/ETH3_CM_N: J2.D5 (C_N), L19.9 (CM_N)
/PHYs/ETH3_CM_P: J2.D4 (C_P), L19.8 (CM_P)
/PHYs/ETH3_C_N: L19.16 (C_N), U11.8 (ETH_C_N)
/PHYs/ETH3_C_P: L19.17 (C_P), U11.7 (ETH_C_P)
/PHYs/ETH3_DM_N: J2.D8 (D_N), L19.11 (DM_P)
/PHYs/ETH3_DM_P: J2.D7 (D_P), L19.12 (DM_N)
/PHYs/ETH3_D_N: L19.13 (D_N), U11.11 (ETH_D_N)
/PHYs/ETH3_D_P: L19.14 (D_P), U11.10 (ETH_D_P)
/PHYs/ETH4_AM_N: J2.E2 (A_N), L32.3 (AM_N)
/PHYs/ETH4_AM_P: J2.E1 (A_P), L32.2 (AM_P)
/PHYs/ETH4_A_N: L32.22 (A_N), U12.2 (ETH_A_N)
/PHYs/ETH4_A_P: L32.23 (A_P), U12.1 (ETH_A_P)
/PHYs/ETH4_BM_N: J2.E6 (B_N), L32.5 (BM_P)
/PHYs/ETH4_BM_P: J2.E3 (B_P), L32.6 (BM_N)
/PHYs/ETH4_B_N: L32.19 (B_N), U12.5 (ETH_B_N)
/PHYs/ETH4_B_P: L32.20 (B_P), U12.4 (ETH_B_P)
/PHYs/ETH4_CM_N: J2.E5 (C_N), L32.9 (CM_N)
/PHYs/ETH4_CM_P: J2.E4 (C_P), L32.8 (CM_P)
/PHYs/ETH4_C_N: L32.16 (C_N), U12.8 (ETH_C_N)
/PHYs/ETH4_C_P: L32.17 (C_P), U12.7 (ETH_C_P)
/PHYs/ETH4_DM_N: J2.E8 (D_N), L32.11 (DM_P)
/PHYs/ETH4_DM_P: J2.E7 (D_P), L32.12 (DM_N)
/PHYs/ETH4_D_N: L32.13 (D_N), U12.11 (ETH_D_N)
/PHYs/ETH4_D_P: L32.14 (D_P), U12.10 (ETH_D_P)
/PHYs/ETH5_AM_N: J2.F2 (A_N), L33.2 (AM_P)
/PHYs/ETH5_AM_P: J2.F1 (A_P), L33.3 (AM_N)
/PHYs/ETH5_A_N: L33.22 (A_N), U13.2 (ETH_A_N)
/PHYs/ETH5_A_P: L33.23 (A_P), U13.1 (ETH_A_P)
/PHYs/ETH5_BM_N: J2.F6 (B_N), L33.5 (BM_P)
/PHYs/ETH5_BM_P: J2.F3 (B_P), L33.6 (BM_N)
/PHYs/ETH5_B_N: L33.19 (B_N), U13.5 (ETH_B_N)
/PHYs/ETH5_B_P: L33.20 (B_P), U13.4 (ETH_B_P)
/PHYs/ETH5_CM_N: J2.F5 (C_N), L33.9 (CM_N)
/PHYs/ETH5_CM_P: J2.F4 (C_P), L33.8 (CM_P)
/PHYs/ETH5_C_N: L33.16 (C_N), U13.8 (ETH_C_N)
/PHYs/ETH5_C_P: L33.17 (C_P), U13.7 (ETH_C_P)
/PHYs/ETH5_DM_N: J2.F8 (D_N), L33.11 (DM_P)
/PHYs/ETH5_DM_P: J2.F7 (D_P), L33.12 (DM_N)
/PHYs/ETH5_D_N: L33.13 (D_N), U13.11 (ETH_D_N)
/PHYs/ETH5_D_P: L33.14 (D_P), U13.10 (ETH_D_P)
/PHYs/ETH6_AM_N: J2.G2 (A_N), L34.3 (AM_N)
/PHYs/ETH6_AM_P: J2.G1 (A_P), L34.2 (AM_P)
/PHYs/ETH6_A_N: L34.22 (A_N), U14.2 (ETH_A_N)
/PHYs/ETH6_A_P: L34.23 (A_P), U14.1 (ETH_A_P)
/PHYs/ETH6_BM_N: J2.G6 (B_N), L34.6 (BM_N)
/PHYs/ETH6_BM_P: J2.G3 (B_P), L34.5 (BM_P)
/PHYs/ETH6_B_N: L34.19 (B_N), U14.5 (ETH_B_N)
/PHYs/ETH6_B_P: L34.20 (B_P), U14.4 (ETH_B_P)
/PHYs/ETH6_CM_N: J2.G5 (C_N), L34.9 (CM_N)
/PHYs/ETH6_CM_P: J2.G4 (C_P), L34.8 (CM_P)
/PHYs/ETH6_C_N: L34.16 (C_N), U14.8 (ETH_C_N)
/PHYs/ETH6_C_P: L34.17 (C_P), U14.7 (ETH_C_P)
/PHYs/ETH6_DM_N: J2.G8 (D_N), L34.11 (DM_P)
/PHYs/ETH6_DM_P: J2.G7 (D_P), L34.12 (DM_N)
/PHYs/ETH6_D_N: L34.13 (D_N), U14.11 (ETH_D_N)
/PHYs/ETH6_D_P: L34.14 (D_P), U14.10 (ETH_D_P)
/PHYs/ETH7_AM_N: J2.H2 (A_N), L35.2 (AM_P)
/PHYs/ETH7_AM_P: J2.H1 (A_P), L35.3 (AM_N)
/PHYs/ETH7_A_N: L35.22 (A_N), U15.2 (ETH_A_N)
/PHYs/ETH7_A_P: L35.23 (A_P), U15.1 (ETH_A_P)
/PHYs/ETH7_BM_N: J2.H6 (B_N), L35.6 (BM_N)
/PHYs/ETH7_BM_P: J2.H3 (B_P), L35.5 (BM_P)
/PHYs/ETH7_B_N: L35.19 (B_N), U15.5 (ETH_B_N)
/PHYs/ETH7_B_P: L35.20 (B_P), U15.4 (ETH_B_P)
/PHYs/ETH7_CM_N: J2.H5 (C_N), L35.8 (CM_P)
/PHYs/ETH7_CM_P: J2.H4 (C_P), L35.9 (CM_N)
/PHYs/ETH7_C_N: L35.16 (C_N), U15.8 (ETH_C_N)
/PHYs/ETH7_C_P: L35.17 (C_P), U15.7 (ETH_C_P)
/PHYs/ETH7_DM_N: J2.H8 (D_N), L35.11 (DM_P)
/PHYs/ETH7_DM_P: J2.H7 (D_P), L35.12 (DM_N)
/PHYs/ETH7_D_N: L35.13 (D_N), U15.11 (ETH_D_N)
/PHYs/ETH7_D_P: L35.14 (D_P), U15.10 (ETH_D_P)
/PHYs/JTAG_TDO_0: U8.21 (JTAG_TDO), U9.23 (JTAG_TDI)
/PHYs/JTAG_TDO_1: U9.21 (JTAG_TDO), U10.23 (JTAG_TDI)
/PHYs/JTAG_TDO_2: U10.21 (JTAG_TDO), U11.23 (JTAG_TDI)
/PHYs/JTAG_TDO_3: U11.21 (JTAG_TDO), U12.23 (JTAG_TDI)
/PHYs/JTAG_TDO_4: U12.21 (JTAG_TDO), U13.23 (JTAG_TDI)
/PHYs/JTAG_TDO_5: U13.21 (JTAG_TDO), U14.23 (JTAG_TDI)
/PHYs/JTAG_TDO_6: U14.21 (JTAG_TDO), U15.23 (JTAG_TDI)
/PHYs/LED0_0_N: J2.A10 (GREEN_LED_N), R27.1
/PHYs/LED0_1_N: J2.B10 (GREEN_LED_N), R71.1
/PHYs/LED0_2_N: J2.C10 (GREEN_LED_N), R72.1
/PHYs/LED0_3_N: J2.D10 (GREEN_LED_N), R73.1
/PHYs/LED0_4_N: J2.E10 (GREEN_LED_N), R139.1
/PHYs/LED0_5_N: J2.F10 (GREEN_LED_N), R140.1
/PHYs/LED0_6_N: J2.G10 (GREEN_LED_N), R141.1
/PHYs/LED0_7_N: J2.H10 (GREEN_LED_N), R142.1
/PHYs/LED1_0_N: J2.A12 (YELLOW_LED_N), R24.1
/PHYs/LED1_1_N: J2.B12 (YELLOW_LED_N), R57.1
/PHYs/LED1_2_N: J2.C12 (YELLOW_LED_N), R59.1
/PHYs/LED1_3_N: J2.D12 (YELLOW_LED_N), R61.1
/PHYs/LED1_4_N: J2.E12 (YELLOW_LED_N), R120.1
/PHYs/LED1_5_N: J2.F12 (YELLOW_LED_N), R122.1
/PHYs/LED1_6_N: J2.G12 (YELLOW_LED_N), R124.1
/PHYs/LED1_7_N: J2.H12 (YELLOW_LED_N), R126.1
/PHYs/LED_0_0: Q1.G2 (G), R25.2, R26.1, U8.47 (LED_0)
/PHYs/LED_0_1: Q2.G2 (G), R65.2, R66.1, U9.47 (LED_0)
/PHYs/LED_0_2: Q3.G2 (G), R67.2, R68.1, U10.47 (LED_0)
/PHYs/LED_0_3: Q4.G2 (G), R69.2, R70.1, U11.47 (LED_0)
/PHYs/LED_0_4: Q5.G2 (G), R131.2, R132.1, U12.47 (LED_0)
/PHYs/LED_0_5: Q7.G2 (G), R133.2, R134.1, U13.47 (LED_0)
/PHYs/LED_0_6: Q6.G2 (G), R135.2, R136.1, U14.47 (LED_0)
/PHYs/LED_0_7: Q8.G2 (G), R137.2, R138.1, U15.47 (LED_0)
/PHYs/LED_1_0: Q1.G1 (G), U8.46 (LED_1)
/PHYs/LED_1_1: Q2.G1 (G), U9.46 (LED_1)
/PHYs/LED_1_2: Q3.G1 (G), U10.46 (LED_1)
/PHYs/LED_1_3: Q4.G1 (G), U11.46 (LED_1)
/PHYs/LED_1_4: Q5.G1 (G), U12.46 (LED_1)
/PHYs/LED_1_5: Q7.G1 (G), U13.46 (LED_1)
/PHYs/LED_1_6: Q6.G1 (G), U14.46 (LED_1)
/PHYs/LED_1_7: Q8.G1 (G), U15.46 (LED_1)
/PHYs/RX_CTRL_0: R22.1, R23.2, U8.38 (RX_CTRL)
/PHYs/RX_CTRL_1: R39.1, R45.2, U9.38 (RX_CTRL)
/PHYs/RX_CTRL_2: R41.1, R47.2, U10.38 (RX_CTRL)
/PHYs/RX_CTRL_3: R43.1, R49.2, U11.38 (RX_CTRL)
/PHYs/RX_CTRL_4: R82.1, R97.2, U12.38 (RX_CTRL)
/PHYs/RX_CTRL_5: R85.1, R100.2, U13.38 (RX_CTRL)
/PHYs/RX_CTRL_6: R89.1, R104.2, U14.38 (RX_CTRL)
/PHYs/RX_CTRL_7: R93.1, R108.2, U15.38 (RX_CTRL)
/PHYs/RX_D0_1: R40.1, R46.2, U9.33 (RX_D0/SGMII_CLKOUT_P)
/PHYs/RX_D0_2: R42.1, R48.2, U10.33 (RX_D0/SGMII_CLKOUT_P)
/PHYs/RX_D0_3: R44.1, U11.33 (RX_D0/SGMII_CLKOUT_P)
/PHYs/RX_D0_5: R86.1, R101.2, U13.33 (RX_D0/SGMII_CLKOUT_P)
/PHYs/RX_D0_6: R90.1, R105.2, U14.33 (RX_D0/SGMII_CLKOUT_P)
/PHYs/RX_D0_7: R94.1, U15.33 (RX_D0/SGMII_CLKOUT_P)
/PHYs/SGMII0_RX_C_N: C15.1, U8.36 (RX_D3/SGMII_RX_N)
/PHYs/SGMII0_RX_C_P: C14.1, U8.35 (RX_D2/SGMII_RX_P)
/PHYs/SGMII0_TX_C_N: C13.1, U8.28 (TX_D0/SGMII_TX_N)
/PHYs/SGMII0_TX_C_P: C12.1, U8.27 (TX_D1/SGMII_TX_P)
/PHYs/SGMII0_TX_N: C13.2; also elsewhere on the board
/PHYs/SGMII0_TX_P: C12.2; also elsewhere on the board
/PHYs/SGMII1_RX_C_N: C54.1, U9.36 (RX_D3/SGMII_RX_N)
/PHYs/SGMII1_RX_C_P: C53.1, U9.35 (RX_D2/SGMII_RX_P)
/PHYs/SGMII1_TX_C_N: C52.1, U9.28 (TX_D0/SGMII_TX_N)
/PHYs/SGMII1_TX_C_P: C51.1, U9.27 (TX_D1/SGMII_TX_P)
/PHYs/SGMII1_TX_N: C52.2; also elsewhere on the board
/PHYs/SGMII1_TX_P: C51.2; also elsewhere on the board
/PHYs/SGMII2_RX_C_N: C58.1, U10.36 (RX_D3/SGMII_RX_N)
/PHYs/SGMII2_RX_C_P: C57.1, U10.35 (RX_D2/SGMII_RX_P)
/PHYs/SGMII2_TX_C_N: C56.1, U10.28 (TX_D0/SGMII_TX_N)
/PHYs/SGMII2_TX_C_P: C55.1, U10.27 (TX_D1/SGMII_TX_P)
/PHYs/SGMII2_TX_N: C56.2; also elsewhere on the board
/PHYs/SGMII2_TX_P: C55.2; also elsewhere on the board
/PHYs/SGMII3_RX_C_N: C62.1, U11.36 (RX_D3/SGMII_RX_N)
/PHYs/SGMII3_RX_C_P: C61.1, U11.35 (RX_D2/SGMII_RX_P)
/PHYs/SGMII3_TX_C_N: C60.1, U11.28 (TX_D0/SGMII_TX_N)
/PHYs/SGMII3_TX_C_P: C59.1, U11.27 (TX_D1/SGMII_TX_P)
/PHYs/SGMII3_TX_N: C60.2; also elsewhere on the board
/PHYs/SGMII3_TX_P: C59.2; also elsewhere on the board
/PHYs/SGMII4_RX_C_N: C132.1, R84.1, R99.2, U12.36 (RX_D3/SGMII_RX_N)
/PHYs/SGMII4_RX_C_P: C131.1, R83.1, R98.2, U12.35 (RX_D2/SGMII_RX_P)
/PHYs/SGMII4_TX_C_N: C130.1, U12.28 (TX_D0/SGMII_TX_N)
/PHYs/SGMII4_TX_C_P: C129.1, U12.27 (TX_D1/SGMII_TX_P)
/PHYs/SGMII4_TX_N: C130.2; also elsewhere on the board
/PHYs/SGMII4_TX_P: C129.2; also elsewhere on the board
/PHYs/SGMII5_RX_C_N: C136.1, R88.1, R103.2, U13.36 (RX_D3/SGMII_RX_N)
/PHYs/SGMII5_RX_C_P: C135.1, R87.1, R102.2, U13.35 (RX_D2/SGMII_RX_P)
/PHYs/SGMII5_TX_C_N: C134.1, U13.28 (TX_D0/SGMII_TX_N)
/PHYs/SGMII5_TX_C_P: C133.1, U13.27 (TX_D1/SGMII_TX_P)
/PHYs/SGMII5_TX_N: C134.2; also elsewhere on the board
/PHYs/SGMII5_TX_P: C133.2; also elsewhere on the board
/PHYs/SGMII6_RX_C_N: C140.1, R92.1, R107.2, U14.36 (RX_D3/SGMII_RX_N)
/PHYs/SGMII6_RX_C_P: C139.1, R91.1, R106.2, U14.35 (RX_D2/SGMII_RX_P)
/PHYs/SGMII6_TX_C_N: C138.1, U14.28 (TX_D0/SGMII_TX_N)
/PHYs/SGMII6_TX_C_P: C137.1, U14.27 (TX_D1/SGMII_TX_P)
/PHYs/SGMII6_TX_N: C138.2; also elsewhere on the board
/PHYs/SGMII6_TX_P: C137.2; also elsewhere on the board
/PHYs/SGMII7_RX_C_N: C144.1, R96.1, R110.2, U15.36 (RX_D3/SGMII_RX_N)
/PHYs/SGMII7_RX_C_P: C143.1, R95.1, R109.2, U15.35 (RX_D2/SGMII_RX_P)
/PHYs/SGMII7_TX_C_N: C142.1, U15.28 (TX_D0/SGMII_TX_N)
/PHYs/SGMII7_TX_C_P: C141.1, U15.27 (TX_D1/SGMII_TX_P)
/PHYs/SGMII7_TX_N: C142.2; also elsewhere on the board
/PHYs/SGMII7_TX_P: C141.2; also elsewhere on the board
/PHYs/SHIELD: C50.1, C126.1, C127.1, C128.1, C229.1, C230.1, C231.1, C232.1, C238.1, C239.1, J2.SHLD (SHIELD), R157.1, R158.1
/SGMII0_RX_N: C15.2; also elsewhere on the board
/SGMII0_RX_P: C14.2; also elsewhere on the board
/SGMII1_RX_N: C54.2; also elsewhere on the board
/SGMII1_RX_P: C53.2; also elsewhere on the board
/SGMII2_RX_N: C58.2; also elsewhere on the board
/SGMII2_RX_P: C57.2; also elsewhere on the board
/SGMII3_RX_N: C62.2; also elsewhere on the board
/SGMII3_RX_P: C61.2; also elsewhere on the board
/SGMII4_RX_N: C132.2; also elsewhere on the board
/SGMII4_RX_P: C131.2; also elsewhere on the board
/SGMII5_RX_N: C136.2; also elsewhere on the board
/SGMII5_RX_P: C135.2; also elsewhere on the board
/SGMII6_RX_N: C140.2; also elsewhere on the board
/SGMII6_RX_P: C139.2; also elsewhere on the board
/SGMII7_RX_N: C144.2; also elsewhere on the board
/SGMII7_RX_P: C143.2; also elsewhere on the board
unnamed: C46.2, L7.15 (D_CT)
unnamed: C47.2, L7.18 (C_CT)
unnamed: C48.2, L7.21 (B_CT)
unnamed: C49.2, L7.24 (A_CT)
unnamed: C50.2, R29.1, R30.1, R31.1, R32.1
unnamed: C90.2, L17.15 (D_CT)
unnamed: C91.2, L18.15 (D_CT)
unnamed: C92.2, L19.15 (D_CT)
unnamed: C102.2, L17.18 (C_CT)
unnamed: C103.2, L18.18 (C_CT)
unnamed: C104.2, L19.18 (C_CT)
unnamed: C114.2, L17.21 (B_CT)
unnamed: C115.2, L18.21 (B_CT)
unnamed: C116.2, L19.21 (B_CT)
unnamed: C120.2, L17.24 (A_CT)
unnamed: C121.2, L18.24 (A_CT)
unnamed: C122.2, L19.24 (A_CT)
unnamed: C126.2, R50.1, R53.1, R56.1, R62.1
unnamed: C127.2, R51.1, R54.1, R58.1, R63.1
unnamed: C128.2, R52.1, R55.1, R60.1, R64.1
unnamed: C181.2, L32.15 (D_CT)
unnamed: C182.2, L33.15 (D_CT)
unnamed: C183.2, L34.15 (D_CT)
unnamed: C184.2, L35.15 (D_CT)
unnamed: C197.2, L32.18 (C_CT)
unnamed: C198.2, L33.18 (C_CT)
unnamed: C199.2, L34.18 (C_CT)
unnamed: C200.2, L35.18 (C_CT)
unnamed: C213.2, L32.21 (B_CT)
unnamed: C214.2, L33.21 (B_CT)
unnamed: C215.2, L34.21 (B_CT)
unnamed: C216.2, L35.21 (B_CT)
unnamed: C221.2, L32.24 (A_CT)
unnamed: C222.2, L33.24 (A_CT)
unnamed: C223.2, L34.24 (A_CT)
unnamed: C224.2, L35.24 (A_CT)
unnamed: C229.2, R111.1, R115.1, R119.1, R127.1
unnamed: C230.2, R112.1, R116.1, R121.1, R128.1
unnamed: C231.2, R113.1, R117.1, R123.1, R129.1
unnamed: C232.2, R114.1, R118.1, R125.1, R130.1
unnamed: L7.1 (AM_CT), R29.2
unnamed: L7.4 (BM_CT), R30.2
unnamed: L7.7 (CM_CT), R31.2
unnamed: L7.10 (DM_CT), R32.2
unnamed: L17.1 (AM_CT), R50.2
unnamed: L17.4 (BM_CT), R53.2
unnamed: L17.7 (CM_CT), R56.2
unnamed: L17.10 (DM_CT), R62.2
unnamed: L18.1 (AM_CT), R51.2
unnamed: L18.4 (BM_CT), R54.2
unnamed: L18.7 (CM_CT), R58.2
unnamed: L18.10 (DM_CT), R63.2
unnamed: L19.1 (AM_CT), R52.2
unnamed: L19.4 (BM_CT), R55.2
unnamed: L19.7 (CM_CT), R60.2
unnamed: L19.10 (DM_CT), R64.2
unnamed: L32.1 (AM_CT), R111.2
unnamed: L32.4 (BM_CT), R115.2
unnamed: L32.7 (CM_CT), R119.2
unnamed: L32.10 (DM_CT), R127.2
unnamed: L33.1 (AM_CT), R112.2
unnamed: L33.4 (BM_CT), R116.2
unnamed: L33.7 (CM_CT), R121.2
unnamed: L33.10 (DM_CT), R128.2
unnamed: L34.1 (AM_CT), R113.2
unnamed: L34.4 (BM_CT), R117.2
unnamed: L34.7 (CM_CT), R123.2
unnamed: L34.10 (DM_CT), R129.2
unnamed: L35.1 (AM_CT), R114.2
unnamed: L35.4 (BM_CT), R118.2
unnamed: L35.7 (CM_CT), R125.2
unnamed: L35.10 (DM_CT), R130.2
unnamed: Q1.D1 (D), R24.2
unnamed: Q1.D2 (D), R27.2
unnamed: Q2.D1 (D), R57.2
unnamed: Q2.D2 (D), R71.2
unnamed: Q3.D1 (D), R59.2
unnamed: Q3.D2 (D), R72.2
unnamed: Q4.D1 (D), R61.2
unnamed: Q4.D2 (D), R73.2
unnamed: Q5.D1 (D), R120.2
unnamed: Q5.D2 (D), R139.2
unnamed: Q6.D1 (D), R124.2
unnamed: Q6.D2 (D), R141.2
unnamed: Q7.D1 (D), R122.2
unnamed: Q7.D2 (D), R140.2
unnamed: Q8.D1 (D), R126.2
unnamed: Q8.D2 (D), R142.2
unnamed: R20.2, U8.12 (RBIAS)
unnamed: R21.2, U8.44 (~INT~/~PWRDN~)
unnamed: R33.2, U9.12 (RBIAS)
unnamed: R34.2, U9.44 (~INT~/~PWRDN~)
unnamed: R35.2, U10.12 (RBIAS)
unnamed: R36.2, U10.44 (~INT~/~PWRDN~)
unnamed: R37.2, U11.12 (RBIAS)
unnamed: R38.2, U11.44 (~INT~/~PWRDN~)
unnamed: R74.2, U12.12 (RBIAS)
unnamed: R75.2, U12.44 (~INT~/~PWRDN~)
unnamed: R76.2, U13.12 (RBIAS)
unnamed: R77.2, U13.44 (~INT~/~PWRDN~)
unnamed: R78.2, U14.12 (RBIAS)
unnamed: R79.2, U14.44 (~INT~/~PWRDN~)
unnamed: R80.2, U15.12 (RBIAS)
unnamed: R81.2, U15.44 (~INT~/~PWRDN~)
unnamed: R143.2, U16.3 (CLK)
unnamed: R144.2, U17.1 (CLKOUT0)
unnamed: R145.2, U17.4 (CLKOUT1)
unnamed: R146.2, U17.6 (CLKOUT2)
unnamed: R147.2, U17.7 (CLKOUT3)
unnamed: R148.2, U17.9 (CLKOUT4)
unnamed: R149.2, U17.11 (CLKOUT5)
unnamed: R150.2, U17.13 (CLKOUT6)
unnamed: R151.2, U17.14 (CLKOUT7)

Notes on the sheet:
PHY 0 strap config: * RX_D0 / PHY_ADD[1:0]: mode 1 (2'b00) * RX_D2 / PHY_ADD[3:2]: mode 1 (2'b00) * RX_D3: not a strap but needs to be balanced with RX_D2 (mode 0) * RX_CTRL / ANEG_DISABLE: mode 3 (not disabled) * GPIO_0 / RGMII_RX_SKEW[0]: mode 1 (0) * GPIO_1 / RGMII_RX_SKEW[2:1]: mode 1 (0) * LED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
PHY strap config: * Mode 1: Float * Mode 2: 10K to 1V8, 2.49K to ground * Mode 3: 5.76K to 1V8, 2.49K to ground * Mode 4: 2.49K to 1V8 for most pins. For RX_D3/D2 use 4K to 1V8, 10K to ground
PHY 1 strap config: * RX_D0 / PHY_ADD[1:0]: mode 2 (2'b01) * RX_D2 / PHY_ADD[3:2]: mode 1 (2'b00) * RX_D3: not a strap but needs to be balanced with RX_D2 (mode 0) * RX_CTRL / ANEG_DISABLE: mode 3 (not disabled) * GPIO_0 / RGMII_RX_SKEW[0]: mode 1 (0) * GPIO_1 / RGMII_RX_SKEW[2:1]: mode 1 (0) * LED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
PHY_ADDR = 5'h0
PHY_ADDR = 5'h1
PHY 2 strap config: * RX_D0 / PHY_ADD[1:0]: mode 3 (2'b10) * RX_D2 / PHY_ADD[3:2]: mode 1 (2'b00) * RX_D3: not a strap but needs to be balanced with RX_D2 (mode 0) * RX_CTRL / ANEG_DISABLE: mode 3 (not disabled) * GPIO_0 / RGMII_RX_SKEW[0]: mode 1 (0) * GPIO_1 / RGMII_RX_SKEW[2:1]: mode 1 (0) * LED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
PHY_ADDR = 5'h2
PHY 3 strap config: * RX_D0 / PHY_ADD[1:0]: mode 4 (2'b11) * RX_D2 / PHY_ADD[3:2]: mode 1 (2'b00) * RX_D3: not a strap but needs to be balanced with RX_D2 (mode 0) * RX_CTRL / ANEG_DISABLE: mode 3 (not disabled) * GPIO_0 / RGMII_RX_SKEW[0]: mode 1 (0) * GPIO_1 / RGMII_RX_SKEW[2:1]: mode 1 (0) * LED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
PHY_ADDR = 5'h3
PHY 4 strap config: * RX_D0 / PHY_ADD[1:0]: mode 1 (2'b00) * RX_D2 / PHY_ADD[3:2]: mode 2 (2'b01) * RX_D3: not a strap but needs to be balanced with RX_D2 (mode 0) * RX_CTRL / ANEG_DISABLE: mode 3 (not disabled) * GPIO_0 / RGMII_RX_SKEW[0]: mode 1 (0) * GPIO_1 / RGMII_RX_SKEW[2:1]: mode 1 (0) * LED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
PHY 1 strap config: * RX_D0 / PHY_ADD[1:0]: mode 2 (2'b01) * RX_D2 / PHY_ADD[3:2]: mode 2 (2'b01) * RX_D3: not a strap but needs to be balanced with RX_D2 (mode 2) * RX_CTRL / ANEG_DISABLE: mode 3 (not disabled) * GPIO_0 / RGMII_RX_SKEW[0]: mode 1 (0) * GPIO_1 / RGMII_RX_SKEW[2:1]: mode 1 (0) * LED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
PHY_ADDR = 5'h4
PHY_ADDR = 5'h5
PHY 2 strap config: * RX_D0 / PHY_ADD[1:0]: mode 3 (2'b10) * RX_D2 / PHY_ADD[3:2]: mode 2 (2'b01) * RX_D3: not a strap but needs to be balanced with RX_D2 (mode 2) * RX_CTRL / ANEG_DISABLE: mode 3 (not disabled) * GPIO_0 / RGMII_RX_SKEW[0]: mode 1 (0) * GPIO_1 / RGMII_RX_SKEW[2:1]: mode 1 (0) * LED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
PHY_ADDR = 5'h6
PHY 3 strap config: * RX_D0 / PHY_ADD[1:0]: mode 4 (2'b11) * RX_D2 / PHY_ADD[3:2]: mode 2 (2'b01) * RX_D3: not a strap but needs to be balanced with RX_D2 (mode 2) * RX_CTRL / ANEG_DISABLE: mode 3 (not disabled) * GPIO_0 / RGMII_RX_SKEW[0]: mode 1 (0) * GPIO_1 / RGMII_RX_SKEW[2:1]: mode 1 (0) * LED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
PHY_ADDR = 5'h7
Swap P/N pairs for easier layout. PHY auto-corrects.
Sharing analog rail with sandwiched PHY
