azonenberg/latentpacket/latentred/boards/linecard/latentred-linecard/latentred-linecard.kicad_pcb

## KiCad design latentred/boards/linecard/latentred-linecard/latentred-linecard.kicad_pcb (continued)

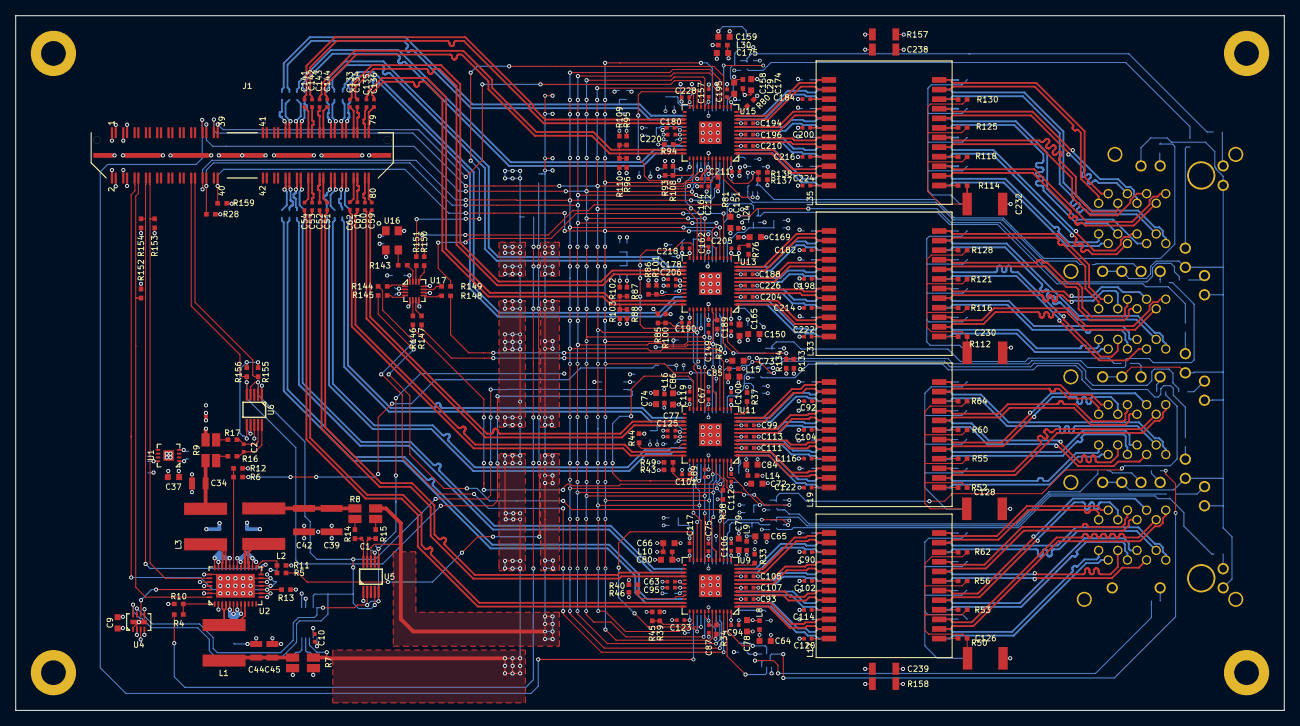
[picture p27: board latentred-linecard.kicad_pcb from above]

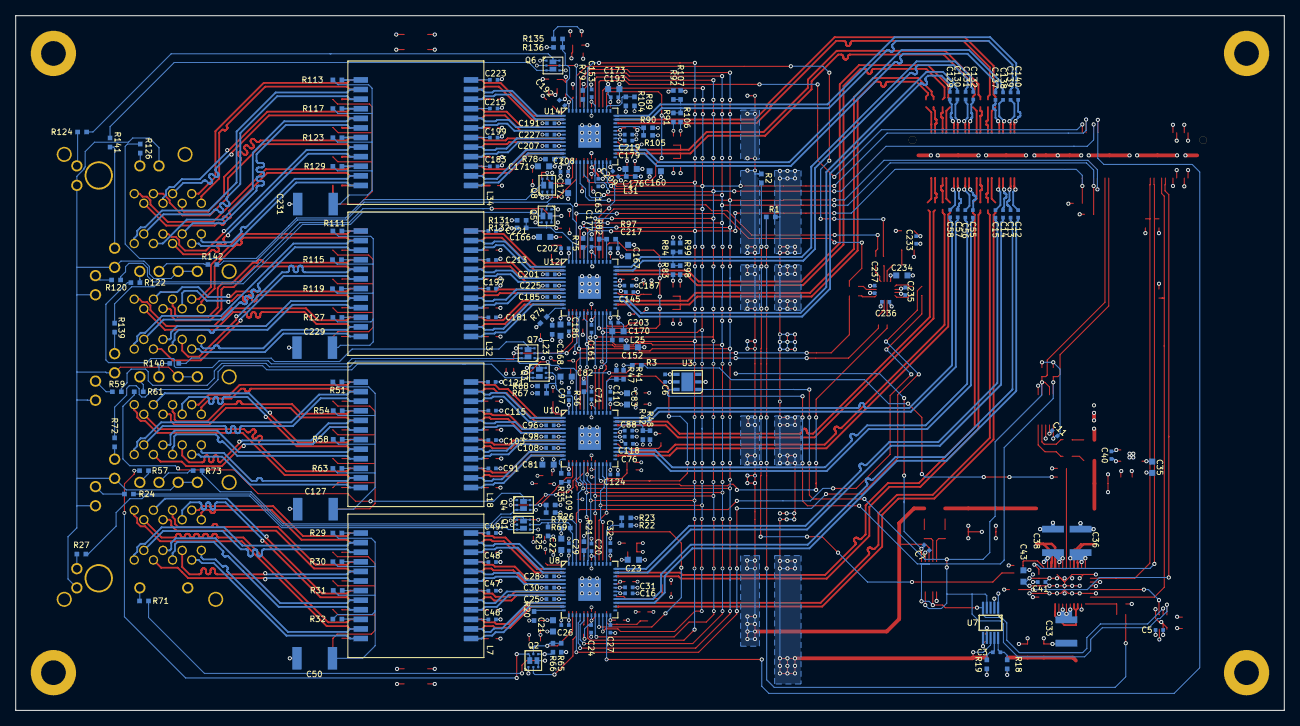
[picture p28: board latentred-linecard.kicad_pcb from below]

Board: 4 copper layers, 168.0 x 92.0 mm, 438 parts (211 on the bottom side), 425 nets.
