azonenberg/latentpacket/latentred/boards/testing/magnetic-crosstalk/magnetic-crosstalk.kicad_pcb

## KiCad design latentred/boards/testing/magnetic-crosstalk/magnetic-crosstalk.kicad_pcb (2018-05-15)

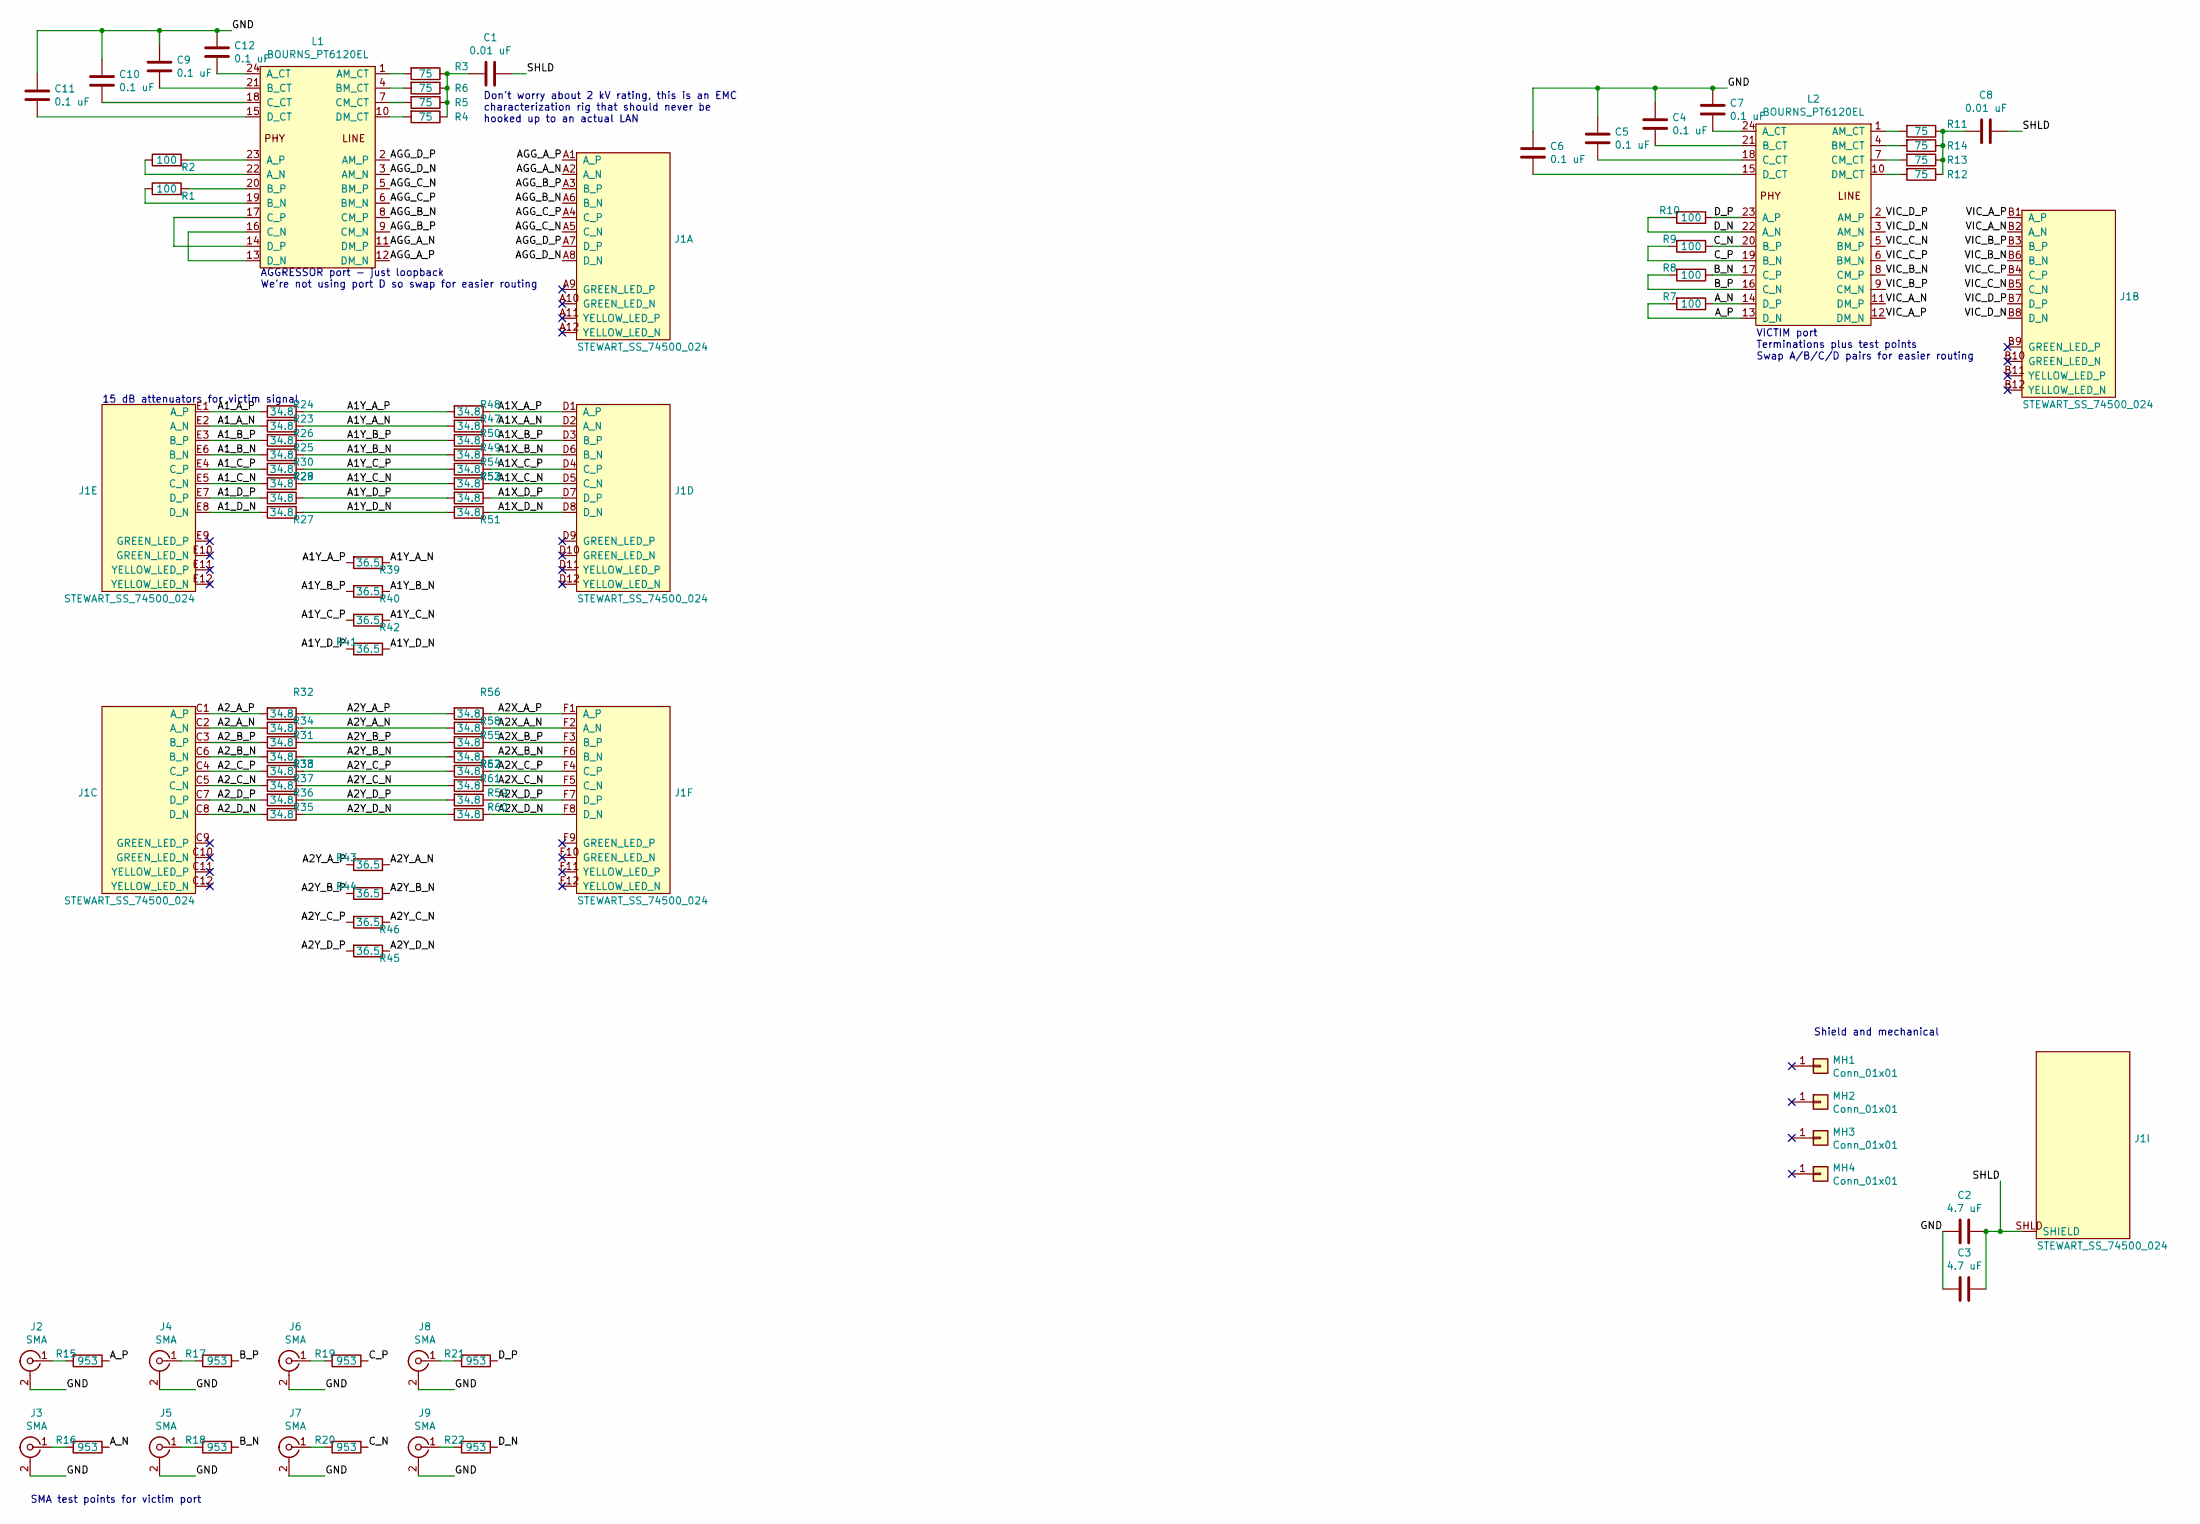
[picture p29: schematic magnetic-crosstalk.sch, Ethernet Magnetic EMC Characterization Board]

Parts:
C1, C8: 0.01 uF; EIA_0402_CAP_NOSILK
C2, C3: 4.7 uF; EIA_0603_CAP_NOSILK
C4, C5, C6, C7, C9, C10, C11, C12: 0.1 uF; EIA_0402_CAP_NOSILK
J1: STEWART_SS_74500_024; CONN_STEWART_SS_74500_024
J2, J3, J4, J5, J6, J7, J8, J9: SMA; CONN_SMA_EDGE_SAMTEC_SMA_J_P_H_ST_EM1
L1, L2: BOURNS_PT6120EL; BOURNS_PT61020EL
MH1, MH2, MH3, MH4: Conn_01x01; MECHANICAL_CLEARANCEHOLE_4_40
R1, R2, R7, R8, R9, R10: 100; EIA_0402_RES_NOSILK
R3, R4, R5, R6, R11, R12, R13, R14: 75; EIA_0402_RES_NOSILK
R15, R16, R17, R18, R19, R20, R21, R22: 953; EIA_0402_RES_NOSILK
R23, R24, R25, R26, R27, R28, R29, R30, R31, R32, R33, R34, R35, R36, R37, R38, R47, R48, R49, R50, R51, R52, R53, R54, R55, R56, R57, R58, R59, R60, R61, R62: 34.8; EIA_0402_RES_NOSILK
R39, R40, R41, R42, R43, R44, R45, R46: 36.5; EIA_0402_RES_NOSILK

Connections:
/A1X_A_N: J1.D2 (A_N), R48.1
/A1X_A_P: J1.D1 (A_P), R47.1
/A1X_B_N: J1.D6 (B_N), R50.1
/A1X_B_P: J1.D3 (B_P), R49.1
/A1X_C_N: J1.D5 (C_N), R54.1
/A1X_C_P: J1.D4 (C_P), R53.1
/A1X_D_N: J1.D8 (D_N), R51.1
/A1X_D_P: J1.D7 (D_P), R52.1
/A1Y_A_N: R24.1, R39.1, R48.2
/A1Y_A_P: R23.1, R39.2, R47.2
/A1Y_B_N: R26.1, R40.1, R50.2
/A1Y_B_P: R25.1, R40.2, R49.2
/A1Y_C_N: R30.1, R42.1, R54.2
/A1Y_C_P: R29.1, R42.2, R53.2
/A1Y_D_N: R27.1, R41.2, R51.2
/A1Y_D_P: R28.1, R41.1, R52.2
/A1_A_N: J1.E2 (A_N), R24.2
/A1_A_P: J1.E1 (A_P), R23.2
/A1_B_N: J1.E6 (B_N), R26.2
/A1_B_P: J1.E3 (B_P), R25.2
/A1_C_N: J1.E5 (C_N), R30.2
/A1_C_P: J1.E4 (C_P), R29.2
/A1_D_N: J1.E8 (D_N), R27.2
/A1_D_P: J1.E7 (D_P), R28.2
/A2X_A_N: J1.F2 (A_N), R55.1
/A2X_A_P: J1.F1 (A_P), R56.1
/A2X_B_N: J1.F6 (B_N), R57.1
/A2X_B_P: J1.F3 (B_P), R58.1
/A2X_C_N: J1.F5 (C_N), R62.1
/A2X_C_P: J1.F4 (C_P), R61.1
/A2X_D_N: J1.F8 (D_N), R60.1
/A2X_D_P: J1.F7 (D_P), R59.1
/A2Y_A_N: R31.1, R43.2, R55.2
/A2Y_A_P: R32.1, R43.1, R56.2
/A2Y_B_N: R33.1, R44.2, R57.2
/A2Y_B_P: R34.1, R44.1, R58.2
/A2Y_C_N: R38.1, R46.1, R62.2
/A2Y_C_P: R37.1, R46.2, R61.2
/A2Y_D_N: R36.1, R45.1, R60.2
/A2Y_D_P: R35.1, R45.2, R59.2
/A2_A_N: J1.C2 (A_N), R31.2
/A2_A_P: J1.C1 (A_P), R32.2
/A2_B_N: J1.C6 (B_N), R33.2
/A2_B_P: J1.C3 (B_P), R34.2
/A2_C_N: J1.C5 (C_N), R38.2
/A2_C_P: J1.C4 (C_P), R37.2
/A2_D_N: J1.C8 (D_N), R36.2
/A2_D_P: J1.C7 (D_P), R35.2
/AGG_A_N: J1.A2 (A_N), L1.11 (DM_P)
/AGG_A_P: J1.A1 (A_P), L1.12 (DM_N)
/AGG_B_N: J1.A6 (B_N), L1.8 (CM_P)
/AGG_B_P: J1.A3 (B_P), L1.9 (CM_N)
/AGG_C_N: J1.A5 (C_N), L1.5 (BM_P)
/AGG_C_P: J1.A4 (C_P), L1.6 (BM_N)
/AGG_D_N: J1.A8 (D_N), L1.3 (AM_N)
/AGG_D_P: J1.A7 (D_P), L1.2 (AM_P)
/A_N: L2.14 (D_P), R7.1, R16.1
/A_P: L2.13 (D_N), R7.2, R15.1
/B_N: L2.17 (C_P), R8.1, R18.1
/B_P: L2.16 (C_N), R8.2, R17.1
/C_N: L2.20 (B_P), R9.1, R20.1
/C_P: L2.19 (B_N), R9.2, R19.1
/D_N: L2.22 (A_N), R10.2, R22.1
/D_P: L2.23 (A_P), R10.1, R21.1
/GND: C2.2, C3.2, C4.1, C5.1, C6.1, C7.1, C9.1, C10.1, C11.1, C12.1, J2.2 (Ext), J3.2 (Ext), J4.2 (Ext), J5.2 (Ext), J6.2 (Ext), J7.2 (Ext), J8.2 (Ext), J9.2 (Ext)
/SHLD: C1.1, C2.1, C3.1, C8.1, J1.SHLD (SHIELD)
/VIC_A_N: J1.B2 (A_N), L2.11 (DM_P)
/VIC_A_P: J1.B1 (A_P), L2.12 (DM_N)
/VIC_B_N: J1.B6 (B_N), L2.8 (CM_P)
/VIC_B_P: J1.B3 (B_P), L2.9 (CM_N)
/VIC_C_N: J1.B5 (C_N), L2.5 (BM_P)
/VIC_C_P: J1.B4 (C_P), L2.6 (BM_N)
/VIC_D_N: J1.B8 (D_N), L2.3 (AM_N)
/VIC_D_P: J1.B7 (D_P), L2.2 (AM_P)
unnamed: C1.2, R3.1, R4.1, R5.1, R6.1
unnamed: C4.2, L2.21 (B_CT)
unnamed: C5.2, L2.18 (C_CT)
unnamed: C6.2, L2.15 (D_CT)
unnamed: C7.2, L2.24 (A_CT)
unnamed: C8.2, R11.1, R12.1, R13.1, R14.1
unnamed: C9.2, L1.21 (B_CT)
unnamed: C10.2, L1.18 (C_CT)
unnamed: C11.2, L1.15 (D_CT)
unnamed: C12.2, L1.24 (A_CT)
unnamed: J2.1 (In), R15.2
unnamed: J3.1 (In), R16.2
unnamed: J4.1 (In), R17.2
unnamed: J5.1 (In), R18.2
unnamed: J6.1 (In), R19.2
unnamed: J7.1 (In), R20.2
unnamed: J8.1 (In), R21.2
unnamed: J9.1 (In), R22.2
unnamed: L1.1 (AM_CT), R3.2
unnamed: L1.4 (BM_CT), R6.2
unnamed: L1.7 (CM_CT), R5.2
unnamed: L1.10 (DM_CT), R4.2
unnamed: L1.13 (D_N), L1.16 (C_N)
unnamed: L1.14 (D_P), L1.17 (C_P)
unnamed: L1.19 (B_N), R1.1
unnamed: L1.20 (B_P), R1.2
unnamed: L1.22 (A_N), R2.1
unnamed: L1.23 (A_P), R2.2
unnamed: L2.1 (AM_CT), R11.2
unnamed: L2.4 (BM_CT), R14.2
unnamed: L2.7 (CM_CT), R13.2
unnamed: L2.10 (DM_CT), R12.2

Notes on the sheet:
AGGRESSOR port - just loopback We're not using port D so swap for easier routing
Don't worry about 2 kV rating, this is an EMC characterization rig that should never be hooked up to an actual LAN
VICTIM port Terminations plus test points Swap A/B/C/D pairs for easier routing
15 dB attenuators for victim signal
Shield and mechanical
SMA test points for victim port

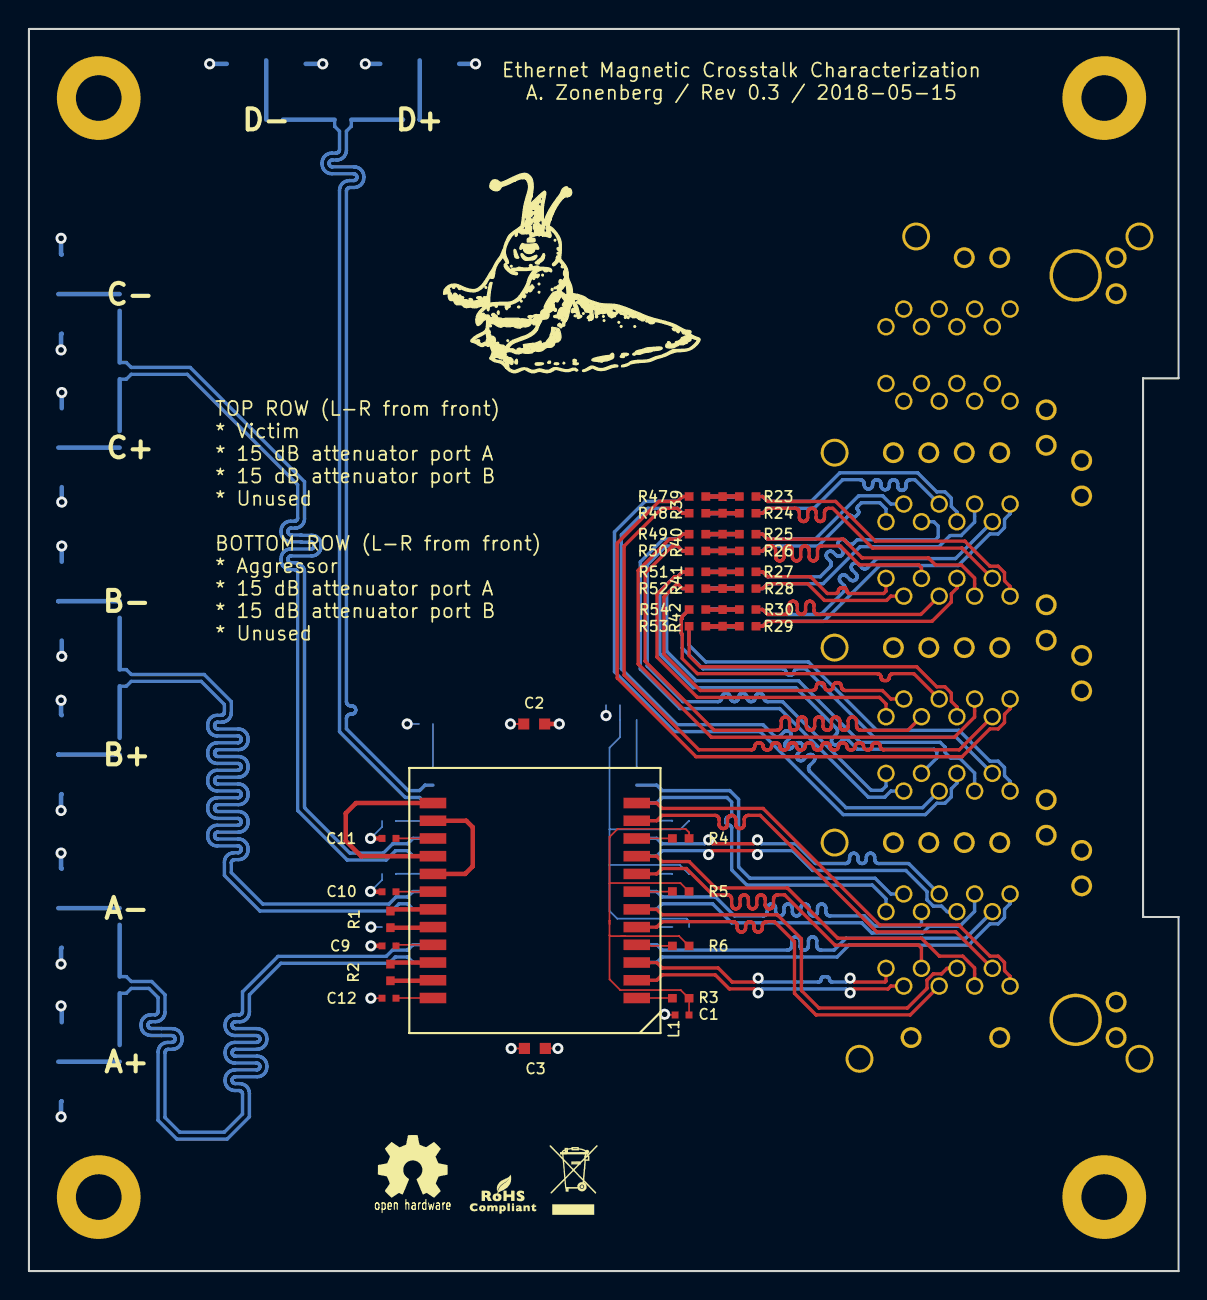
[picture p30: board magnetic-crosstalk.kicad_pcb from above]

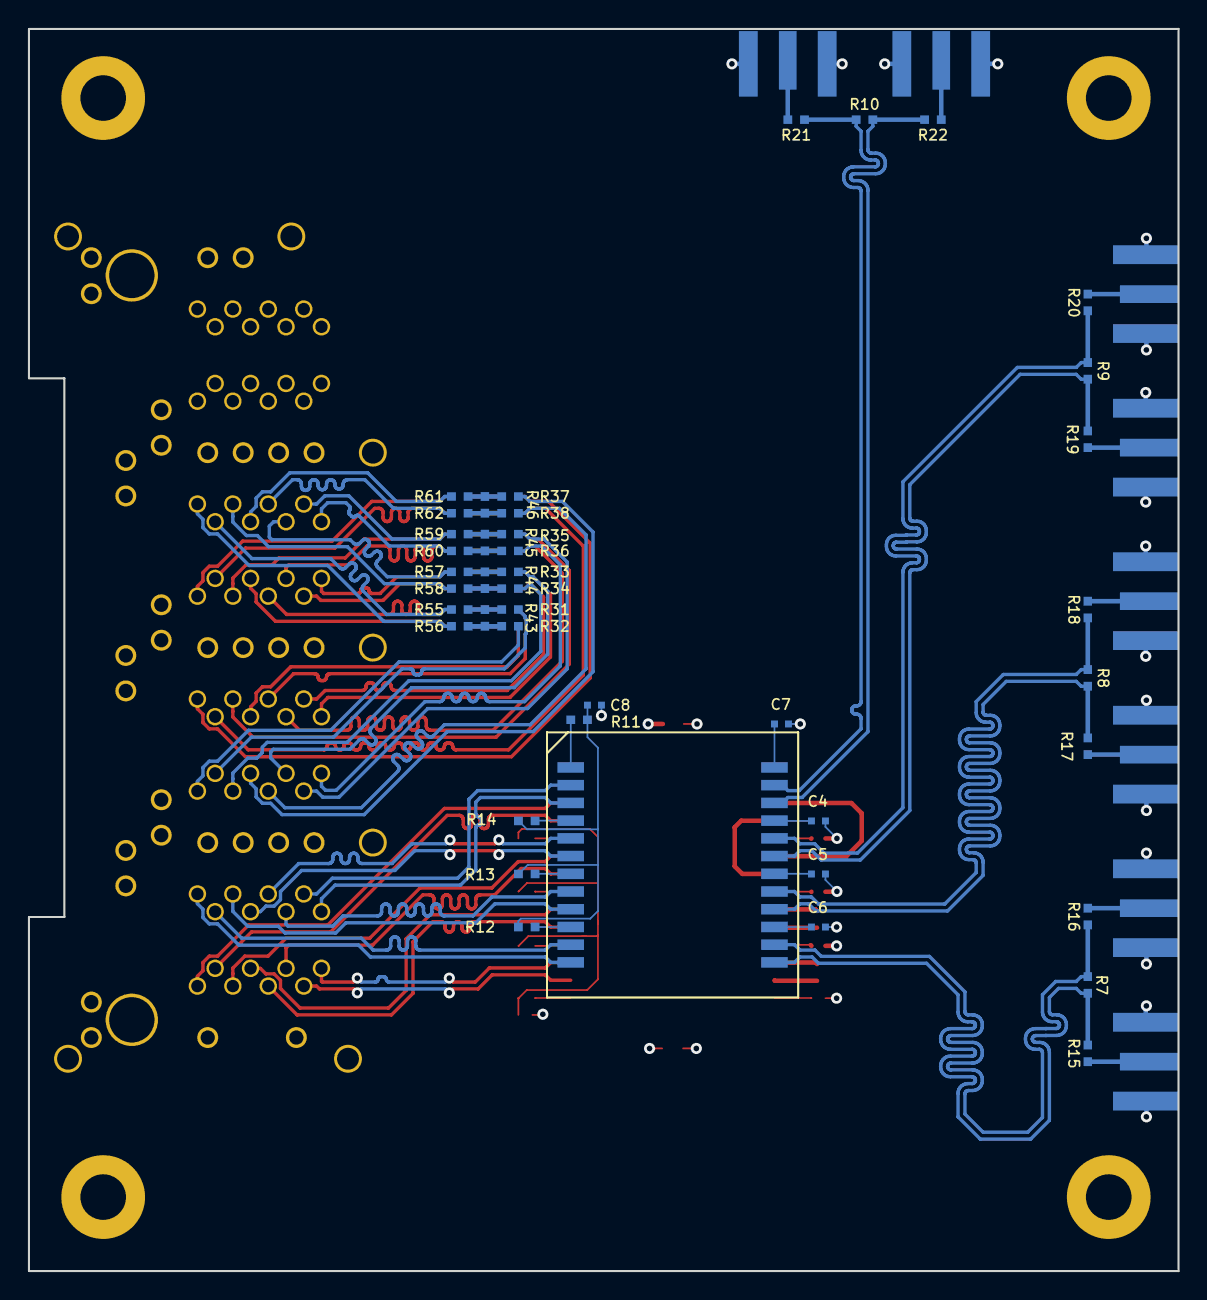
[picture p31: board magnetic-crosstalk.kicad_pcb from below]

Board: 4 copper layers, 82.4 x 89.0 mm, 89 parts (50 on the bottom side), 106 nets.
