azonenberg/latentpacket/latentpink/rtl/constraints/latentpink.xdc

set_max_delay -from [get_clocks clk_125mhz_raw] -through [get_cells [list {buffer/infifo/cdcs[0].cdc/data_fifo/sync_head/sync_ack/sync/dout0_reg} {buffer/infifo/cdcs[0].cdc/data_fifo/sync_head/sync_en/sync/dout0_reg} {buffer/infifo/cdcs[0].cdc/data_fifo/sync_tail/sync_ack/sync/dout0_reg} {buffer/infifo/cdcs[0].cdc/data_fifo/sync_tail/sync_en/sync/dout0_reg} {buffer/infifo/cdcs[0].cdc/header_fifo/sync_rd_ptr/sync_ack/sync/dout0_reg} {buffer/infifo/cdcs[0].cdc/header_fifo/sync_rd_ptr/sync_en/sync/dout0_reg} {buffer/infifo/cdcs[0].cdc/header_fifo/sync_wr_ptr/sync_ack/sync/dout0_reg} {buffer/infifo/cdcs[0].cdc/header_fifo/sync_wr_ptr/sync_en/sync/dout0_reg} {buffer/infifo/cdcs[10].cdc/data_fifo/sync_head/sync_ack/sync/dout0_reg} {buffer/infifo/cdcs[10].cdc/data_fifo/sync_head/sync_en/sync/dout0_reg} {buffer/infifo/cdcs[10].cdc/data_fifo/sync_tail/sync_ack/sync/dout0_reg} {buffer/infifo/cdcs[10].cdc/data_fifo/sync_tail/sync_en/sync/dout0_reg} {buffer/infifo/cdcs[10].cdc/header_fifo/sync_rd_ptr/sync_ack/sync/dout0_reg} {buffer/infifo/cdcs[10].cdc/header_fifo/sync_rd_ptr/sync_en/sync/dout0_reg} {buffer/infifo/cdcs[10].cdc/header_fifo/sync_wr_ptr/sync_ack/sync/dout0_reg} {buffer/infifo/cdcs[10].cdc/header_fifo/sync_wr_ptr/sync_en/sync/dout0_reg} {buffer/infifo/cdcs[11].cdc/data_fifo/sync_head/sync_ack/sync/dout0_reg} {buffer/infifo/cdcs[11].cdc/data_fifo/sync_head/sync_en/sync/dout0_reg} {buffer/infifo/cdcs[11].cdc/data_fifo/sync_tail/sync_ack/sync/dout0_reg} {buffer/infifo/cdcs[11].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
c/dout0_reg mgmt/tx_fifo/tx_framelen_fifo/sync_rd_ptr/sync_en/sync/dout0_reg mgmt/tx_fifo/tx_framelen_fifo/sync_wr_ptr/sync_ack/sync/dout0_reg mgmt/tx_fifo/tx_framelen_fifo/sync_wr_ptr/sync_en/sync/dout0_reg]] -to [get_clocks clk_312p5mhz_raw] 2.500
set_max_delay -from [get_clocks clk_312p5mhz_raw] -through [get_cells [list mgmt/tx_fifo/tx_framelen_fifo/sync_wr_ptr/sync_en/sync/dout0_reg {buffer/infifo/cdcs[0].cdc/data_fifo/sync_head/sync_en/sync/dout0_reg} {buffer/infifo/cdcs[0].cdc/data_fifo/sync_tail/sync_ack/sync/dout0_reg} {buffer/infifo/cdcs[0].cdc/data_fifo/sync_tail/sync_en/sync/dout0_reg} {buffer/infifo/cdcs[0].cdc/header_fifo/sync_rd_ptr/sync_ack/sync/dout0_reg} {buffer/infifo/cdcs[0].cdc/header_fifo/sync_rd_ptr/sync_en/sync/dout0_reg} {buffer/infifo/cdcs[0].cdc/header_fifo/sync_wr_ptr/sync_ack/sync/dout0_reg} {buffer/infifo/cdcs[0].cdc/header_fifo/sync_wr_ptr/sync_en/sync/dout0_reg} {buffer/infifo/cdcs[10].cdc/data_fifo/sync_head/sync_ack/sync/dout0_reg} {buffer/infifo/cdcs[10].cdc/data_fifo/sync_head/sync_en/sync/dout0_reg} {buffer/infifo/cdcs[10].cdc/data_fifo/sync_tail/sync_ack/sync/dout0_reg} {buffer/infifo/cdcs[10].cdc/data_fifo/sync_tail/sync_en/sync/dout0_reg} {buffer/infifo/cdcs[10].cdc/header_fifo/sync_rd_ptr/sync_ack/sync/dout0_reg} {buffer/infifo/cdcs[10].cdc/header_fifo/sync_rd_ptr/sync_en/sync/dout0_reg} {buffer/infifo/cdcs[10].cdc/header_fifo/sync_wr_ptr/sync_ack/sync/dout0_reg} {buffer/infifo/cdcs[10].cdc/header_fifo/sync_wr_ptr/sync_en/sync/dout0_reg} {buffer/infifo/cdcs[11].cdc/data_fifo/sync_head/sync_ack/sync/dout0_reg} {buffer/infifo/cdcs[11].cdc/data_fifo/sync_head/sync_en/sync/dout0_reg} {buffer/infifo/cdcs[11].cdc/data_fifo/sync_tail/sync_ack/sync/dout0_reg} {buffer/infifo/cdcs[11].cdc/d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
t0_reg mgmt/tx_fifo/tx_framelen_fifo/sync_rd_ptr/sync_en/sync/dout0_reg mgmt/tx_fifo/tx_framelen_fifo/sync_wr_ptr/sync_ack/sync/dout0_reg]] -to [get_clocks clk_125mhz_raw] 2.500
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
