azonenberg/latentpacket/latentpink/rtl/ingress/IngressCDC.sv

`timescale 1ns/1ps
`default_nettype none
/***********************************************************************************************************************
*                                                                                                                      *
* LATENTPACKET v0.1                                                                                                    *
*                                                                                                                      *
* Copyright (c) 2023 Andrew D. Zonenberg and contributors                                                              *
* All rights reserved.                                                                                                 *
*                                                                                                                      *
* Redistribution and use in source and binary forms, with or without modification, are permitted provided that the     *
* following conditions are met:                                                                                        *
*                                                                                                                      *
*    * Redistributions of source code must retain the above copyright notice, this list of conditions, and the         *
*      following disclaimer.                                                                                           *
*                                                                                                                      *
*    * Redistributions in binary form must reproduce the above copyright notice, this list of conditions and the       *
*      following disclaimer in the documentation and/or other materials provided with the distribution.                *
*                                                                                                                      *
*    * Neither the name of the author nor the names of any contributors may be used to endorse or promote products     *
*      derived from this software without specific prior written permission.                                           *
*                                                                                                                      *
* THIS SOFTWARE IS PROVIDED BY THE AUTHORS "AS IS" AND ANY EXPRESS OR IMPLIED WARRANTIES, INCLUDING, BUT NOT LIMITED   *
* TO, THE IMPLIED WARRANTIES OF MERCHANTABILITY AND FITNESS FOR A PARTICULAR PURPOSE ARE DISCLAIMED. IN NO EVENT SHALL *
* THE AUTHORS BE HELD LIABLE FOR ANY DIRECT, INDIRECT, INCIDENTAL, SPECIAL, EXEMPLARY, OR CONSEQUENTIAL DAMAGES        *
* (INCLUDING, BUT NOT LIMITED TO, PROCUREMENT OF SUBSTITUTE GOODS OR SERVICES; LOSS OF USE, DATA, OR PROFITS; OR       *
* BUSINESS INTERRUPTION) HOWEVER CAUSED AND ON ANY THEORY OF LIABILITY, WHETHER IN CONTRACT, STRICT LIABILITY, OR TORT *
* (INCLUDING NEGLIGENCE OR OTHERWISE) ARISING IN ANY WAY OUT OF THE USE OF THIS SOFTWARE, EVEN IF ADVISED OF THE       *
* POSSIBILITY OF SUCH DAMAGE.                                                                                          *
*                                                                                                                      *
***********************************************************************************************************************/

`include "EthernetBus.svh"

/**
	@file
	@author Andrew D. Zonenberg
	@brief Expand an EthernetRxBus to 128 bit data width and write to a CDC FIFO
 */
module IngressCDC(

	//Inbound data from the MAC
	input wire					rx_clk,
	input wire					link_up,
	input wire EthernetRxBus	rx_bus,

	//VLAN configuration
	input wire vlan_t			port_vlan,
	input wire					tagged_allowed,
	input wire					untagged_allowed,

	//Output bus to the memory arbiter
	input wire					clk_mem,

	output logic				mem_frame_ready		= 0,
	output logic[10:0]			mem_frame_bytelen	= 0,
	output logic				mem_valid			= 0,
	output wire[127:0]			mem_data,
	output logic				mem_frame_done		= 0,
	output logic[11:0]			mem_frame_vlan		= 0,
	input wire					mem_frame_start
);

	////////////////////////////////////////////////////////////////////////////////////////////////////////////////////
	// Link down flag is in the RX clock domain

	//Clear if link is down, or for 16K clocks after
	//(this allows some time for any junk sent during sync or equalizer lock to be discarded)
	logic		rx_rst			= 0;
	logic[15:0]	rx_rst_count	= 0;

	always_ff @(posedge rx_clk) begin

		if(!link_up) begin
			rx_rst			<= 1;
			rx_rst_count	<= 1;
		end

		else if(rx_rst_count)
			rx_rst_count	<= rx_rst_count + 1;

		else
			rx_rst			<= 0;

	end

	////////////////////////////////////////////////////////////////////////////////////////////////////////////////////
	// Strip VLAN tags off the inbound data stream

	EthernetRxBus	rx_stripped;
	wire[11:0]		rx_vlan;
	wire			rx_vlan_valid;

	VlanUntagger untagger(
		.clk(rx_clk),

		.port_vlan(port_vlan),
		.tagged_allowed(tagged_allowed),
		.untagged_allowed(untagged_allowed),

		.in_bus(rx_bus),

		.out_bus(rx_stripped),
		.out_vlan(rx_vlan),
		.out_vlan_valid(rx_vlan_valid)
	);

	////////////////////////////////////////////////////////////////////////////////////////////////////////////////////
	// Width expansion

	logic			fifo_wr_en			= 0;
	logic[127:0]	fifo_wr_data		= 0;
	wire[9:0]		fifo_wr_size;
	logic			fifo_wr_commit		= 0;
	logic			fifo_wr_commit_next	= 0;
	logic			fifo_wr_rollback	= 0;

	logic[1:0]		wr_phase			= 0;
	logic[10:0]		wr_frame_bytelen	= 0;
	logic			wr_dropping			= 0;

	wire			header_fifo_full;

	localparam		MAX_FRAME_SIZE = 1522;

	always_ff @(posedge rx_clk) begin

		//Clear single cycle flags
		fifo_wr_en				<= 0;
		fifo_wr_commit			<= 0;
		fifo_wr_rollback		<= 0;
		fifo_wr_commit_next		<= 0;

		//Handle delayed commits
		if(fifo_wr_commit_next)
			fifo_wr_commit		<= 1;

		//Start a new frame
		if(rx_stripped.start) begin
			wr_phase			<= 0;
			wr_frame_bytelen	<= 0;
			wr_dropping			<= 0;

			//Make sure we have space to store the length
			if(header_fifo_full) begin
				`ifdef SIMULATION
					$display("Dropping packet because no space in header fifo");
				`endif
				wr_dropping		<= 1;
			end

		end

		//If MAC requests a drop, roll back any partly pushed data
		else if(rx_stripped.drop) begin
			fifo_wr_rollback	<= 1;
			wr_dropping			<= 1;
		end

		//Ignore any data from frames being dropped
		else if(wr_dropping) begin
		end

		//Process incoming data
		else if(rx_stripped.data_valid) begin
			case(wr_phase)
				0:	fifo_wr_data[96 +: 32]	<= rx_stripped.data;
				1:	fifo_wr_data[64 +: 32]	<= rx_stripped.data;
				2:	fifo_wr_data[32 +: 32]	<= rx_stripped.data;
				3:	fifo_wr_data[0 +: 32]	<= rx_stripped.data;
			endcase

			wr_phase				<= wr_phase + 1;
			wr_frame_bytelen		<= wr_frame_bytelen + rx_stripped.bytes_valid;

			if(wr_phase == 3)
				fifo_wr_en			<= 1;

			//Drop if we run out of buffer space or the frame is oversized
			if( (fifo_wr_size < 2) || (wr_frame_bytelen >= MAX_FRAME_SIZE) )begin
				wr_dropping			<= 1;
				fifo_wr_en			<= 0;
				fifo_wr_rollback	<= 1;
			end

		end

		//Finish up a frame
		else if(rx_stripped.commit) begin

			//If we have in-progress data (phase not zero), push it
			//Zero off any garbage at the end of the frame if needed to prevent possible leakage of frame content
			case(wr_phase)
				0: begin
					fifo_wr_commit		<= 1;
				end

				1: begin
					fifo_wr_data[95:0]	<= 0;
					fifo_wr_en			<= 1;
					fifo_wr_commit_next	<= 1;
				end

				2: begin
					fifo_wr_data[63:0]	<= 0;
					fifo_wr_en			<= 1;
					fifo_wr_commit_next	<= 1;
				end

				3: begin
					fifo_wr_data[31:0]	<= 0;
					fifo_wr_en			<= 1;
					fifo_wr_commit_next	<= 1;
				end

			endcase

		end

		//Synchronous reset
		if(rx_rst) begin
			fifo_wr_en			<= 0;
			fifo_wr_data		<= 0;
			fifo_wr_commit_next	<= 0;
			fifo_wr_rollback	<= 0;
			wr_dropping			<= 0;
			wr_phase			<= 0;
			wr_frame_bytelen	<= 0;
		end

	end

	////////////////////////////////////////////////////////////////////////////////////////////////////////////////////
	// Reset synchronization

	wire			fifo_rd_reset_n;

	ResetSynchronizer sync_rst(
		.rst_in_n(!rx_rst),
		.clk(clk_mem),
		.rst_out_n(fifo_rd_reset_n)
	);

	////////////////////////////////////////////////////////////////////////////////////////////////////////////////////
	// Main packet data FIFO

	logic			fifo_rd_en			= 0;
	logic[8:0]		fifo_rd_offset;
	logic			fifo_pop_packet		= 0;
	logic[9:0]		fifo_pop_wordsize	= 0;

	//Needs to be big enough to store a couple of packets at 128 bit width
	//Minimum sane size for 2x BRAM is 128 x 512 = 8 kB = 5.46 max sized frames
	CrossClockPacketFifo #(
		.WIDTH(128),
		.DEPTH(512),
		.USE_BLOCK(1)
	) data_fifo (
		.wr_clk(rx_clk),
		.wr_en(fifo_wr_en),
		.wr_data(fifo_wr_data),
		.wr_size(fifo_wr_size),
		.wr_reset(rx_rst),
		.wr_commit(fifo_wr_commit),
		.wr_rollback(fifo_wr_rollback),

		.rd_clk(clk_mem),
		.rd_en(fifo_rd_en),
		.rd_offset(fifo_rd_offset),
		.rd_pop_single(),
		.rd_pop_packet(fifo_pop_packet),
		.rd_packet_size(fifo_pop_wordsize),
		.rd_data(mem_data),
		.rd_size(),
		.rd_reset(!fifo_rd_reset_n)
	);

	////////////////////////////////////////////////////////////////////////////////////////////////////////////////////
	// Packet length (and vlan) FIFO

	logic		header_rd_en = 0;
	wire[10:0]	header_rd_bytelen;
	wire[11:0]	header_rd_vlan;
	wire		header_rd_empty;

	//RAM64X1D is 2 LUTs so this should be about 22 LUTs
	//If it's synthesized as 4x RAM64Ms instead it would be 16
	CrossClockFifo #(
		.WIDTH(23),
		.DEPTH(64),
		.USE_BLOCK(0),
		.OUT_REG(1)
	) header_fifo (
		.wr_clk(rx_clk),
		.wr_en(rx_stripped.commit && !wr_dropping),
		.wr_data({ wr_frame_bytelen, rx_vlan } ),
		.wr_size(),
		.wr_full(header_fifo_full),
		.wr_overflow(),
		.wr_reset(rx_rst),

		.rd_clk(clk_mem),
		.rd_en(header_rd_en),
		.rd_data({header_rd_bytelen, header_rd_vlan}),
		.rd_size(),
		.rd_empty(header_rd_empty),
		.rd_underflow(),
		.rd_reset(!fifo_rd_reset_n)
	);

	////////////////////////////////////////////////////////////////////////////////////////////////////////////////////
	// Read side logic

	logic		pop_active			= 0;
	logic		header_rd_en_ff		= 0;
	logic[8:0]	fifo_rd_offset_ff	= 0;
	logic		fifo_rd_valid		= 0;
	logic		sending				= 0;
	logic		last_read			= 0;
	logic[6:0]	rd_wordcount		= 0;

	always_comb begin

		mem_valid		= 0;
		last_read		= 0;

		fifo_rd_en		= 0;
		fifo_rd_offset	= fifo_rd_offset_ff;

		//Read first word of frame as soon as the header read is requested, so it's ready in time
		if(header_rd_en) begin
			fifo_rd_en		= 1;
			fifo_rd_offset	= 0;
		end

		//Forward frame data as soon as it's requested
		if( (mem_frame_start || sending) && fifo_rd_valid)
			mem_valid		= 1;

		//If forwarding frame data, read next word
		if(mem_valid) begin
			fifo_rd_offset	= fifo_rd_offset + 1;

			//Last address in the block? Pop the frame and we're done
			if(fifo_rd_offset >= rd_wordcount)
				last_read		= 1;

			//Nope, read it
			else
				fifo_rd_en		= 1;
		end

	end

	always_ff @(posedge clk_mem) begin

		header_rd_en_ff		<= header_rd_en;
		fifo_rd_offset_ff	<= fifo_rd_offset;
		fifo_pop_packet		<= 0;
		mem_frame_done		<= 0;

		//Pop a frame if we're not already popping one and there's something to read
		//(This needs to be pipelined for performance, too slow to do combinatorial)
		header_rd_en 		<= !pop_active && !header_rd_en && !header_rd_en_ff && !header_rd_empty;

		//Read data is not valid after consumption
		if(mem_valid)
			fifo_rd_valid	<= 0;

		//Read data is valid one cycle after we pop it
		if(fifo_rd_en)
			fifo_rd_valid	<= 1;

		//New frame showed up!
		if(header_rd_en) begin
			pop_active	<= 1;
			sending		<= 0;
		end

		//Tell host when we're ready to send it
		if(header_rd_en_ff) begin
			mem_frame_ready		<= 1;
			mem_frame_bytelen	<= header_rd_bytelen;
			mem_frame_vlan		<= header_rd_vlan;

			if(header_rd_bytelen[3:0])
				rd_wordcount	<= header_rd_bytelen[10:4] + 1;
			else
				rd_wordcount	<= header_rd_bytelen[10:4];
		end

		//Starting to send
		if(mem_frame_start) begin
			sending				<= 1;
			mem_frame_ready		<= 0;
		end

		//Wrap up a frame when the last word comes out
		if(last_read) begin
			fifo_pop_packet		<= 1;
			sending				<= 0;
			pop_active			<= 0;
			mem_frame_done		<= 1;
			fifo_pop_wordsize	<= rd_wordcount;
		end

	end

endmodule
