azonenberg/latentpacket/(commit log)

2018-04-16 Initial schematic skeleton for LATENTRED 1G line card
    [latentred-linecard.kicad_pcb, latentred-linecard.sch, phys.sch, psu.sch]
2018-04-17 Continued work on line card design. Now have PSU and all PHYs, still working on clock distribution.
    [latentred-linecard.sch, phys.sch, psu.sch]
2018-04-17 Finished initial version of LATENTRED line card schematic. Not yet reviewed.
    [latentred-linecard.sch, phys.sch, psu.sch]
2018-04-19 Finished initial footprint creation, ready to begin layout
    [latentred-linecard.kicad_pcb, latentred-linecard.sch, phys.sch, psu.sch]
2018-04-22 Continued magnetic-and-RJ45 layout
    [latentred-linecard.kicad_pcb, latentred-linecard.sch, phys.sch, psu.sch]
2018-04-23 Continued initial layout, mostly on PHY indicator LEDs.
    [latentred-linecard.kicad_pcb, latentred-linecard.sch, phys.sch]
2018-04-24 Completely rerouted magnetics for much cleaner, though slightly wider, "clamshell" layout
    [latentred-linecard.kicad_pcb, latentred-linecard.sch, phys.sch, psu.sch]
2018-04-24 Length matched bottom two magnetic-to-PHY buses
    [latentred-linecard.kicad_pcb]
2018-04-25 Continued PHY layout
    [latentred-linecard.kicad_pcb, latentred-linecard.sch, phys.sch, psu.sch]
2018-04-26 Laid out second pair of PHYs
    [latentred-linecard.kicad_pcb, latentred-linecard.sch, phys.sch, psu.sch]
2018-04-27 Initial layout on ports 2/3
    [latentred-linecard.kicad_pcb, latentred-linecard.sch, phys.sch, psu.sch]
2018-04-28 Continued PHY layout. Almost done with first pass but have a bunch of tweaking to do.
    [latentred-linecard.kicad_pcb, latentred-linecard.sch, phys.sch, psu.sch]
2018-04-28 Removed meanders from MDI traces as per Intel layout manual. Now only doing skew matching.
    [latentred-linecard.kicad_pcb]
2018-04-30 Initial version of crosstalk evaluation board
    [magnetic-crosstalk.kicad_pcb, magnetic-crosstalk.sch]
2018-05-01 Finished initial version of crosstalk characterization board
    [magnetic-crosstalk.kicad_pcb, magnetic-crosstalk.sch]
2018-05-15 Began updating magnetic-crosstalk board for v0.2
    [magnetic-crosstalk.kicad_pcb, magnetic-crosstalk.sch]
2018-05-15 Moved magnetic-crosstalk out of subdirectory
    [magnetic-crosstalk.kicad_pcb, magnetic-crosstalk.sch]
2018-05-15 Fixed pinout bugs. v0.2 PCB release.
    [magnetic-crosstalk.kicad_pcb, magnetic-crosstalk.sch]
2018-05-15 Updated magnetic-crosstalk to v0.3 respin
    [magnetic-crosstalk.kicad_pcb, magnetic-crosstalk.sch]
2018-06-05 Continued initial line card layout
    [latentred-linecard.kicad_pcb, latentred-linecard.sch, phys.sch, psu.sch]
2018-06-11 Updating file: latentred-linecard.kicad_pcb with current fully routed design
    [latentred-linecard.kicad_pcb, latentred-linecard.sch]
2018-06-17 Continued routing line card PCB
    [latentred-linecard.kicad_pcb]
2018-06-17 Fixed several bugs in MAC table
    [MACAddressTable.v, MACAddressTable_sim.v]
2019-08-14 initial string printing
2019-08-14 Initial work on UART RX
2019-08-14 Initial work on switch API
2019-08-14 Added lots more commands to switch API
2019-08-14 Continued work on switch API definitions
2019-08-15 Initial work on CLI. Still polling UART, no ISRs yet.
2019-08-17 Lots more work on UART driver, added basic printf
2019-08-17 Continued work on CLI. Can now insert text in the middle of a token, but deletion still needs work.
2019-08-18 Initial implementation of Cisco-style command completion. Cannot yet tab complete, and ? doesn't work, but fully typed commands are correctly decoded.
    [cli_commands.cpp, token.cpp]
2019-08-18 Renamed some files for more consistent naming. Added fno-rtti and new/delete stubs to prevent linker problems when using destructors.
    [CLI.cpp, CLI.h, Command.h, FIFO.h, Switch.cpp, Switch.h, Token.h, UART.cpp]
2019-08-19 Initial work on switch object model. Refactored CLI for fully event driven cooperative multitasking model.
2019-08-19 Continued initial work on switch object model
2019-08-19 Initial implementation of LatentRedManagementPort. Started moving switchapi stuff over to OO model
2019-08-19 Continued building out initial object model for switch engine board
2019-08-20 More debugging of init order issues. Print works here
    [CLI.cpp, CLI.h, LatentRedManagementBoard.cpp, LatentRedSwitchEngineBoard.cpp, UART.cpp, cppstubs.cpp, main.cpp]
2019-08-20 Lots of bug fixes, including proper handling of init_array. Fixed new UART location
    [Board.cpp, Board.h, CLI.cpp, LatentRedManagementBoard.cpp, LatentRedManagementBoard.h, LatentRedSwitch.cpp, LatentRedSwitch.h, LatentRedSwitchEngineBoard.cpp]
2019-08-20 Removed some unnecessary prototypes
2019-08-21 Initial skeleton of management board HDL
2019-08-21 Saving current code while chasing weird RX bug
    [CLI.cpp, LatentRedManagementBoard.cpp, LatentRedManagementBoard.h, UART.cpp, main.cpp, top.sv]
2019-08-21 Initial communications between FPGA and MCU are working bidirectionally. Now to make actual data flow...
2019-08-22 Pushing current debug state
2019-08-22 Initial work on "show hardware" sensors
2019-08-22 CLI: now actually call "show hardware". Disabled parser debug prints
2019-08-22 Added more sensor readout code to "show hardware"
2019-08-22 Fixed missing print
2019-08-23 Initial implementation of LTC3374 temperature sensor readout
2019-08-23 Saving current UART code because we're derps and didn't realize that INTEGRALSTICK bonds out SPI5 from MCU to FPGA...
    [LatentRedManagementBoard.cpp, UART.cpp, UART.h, management.xdc, top.sv]
2019-08-23 Continued initial work on SPI support
2019-08-25 Initial work on SPI support for MCU-FPGA link
2019-08-25 Debugging SPI interface
2019-08-25 Fixed SPI data size
2019-08-25 Fixed bug where ManagementController did not properly reset
    [LatentRedManagementBoard.cpp, ManagementController.sv]
2019-08-25 ManagementController is now using SPI interface for everything
2019-08-26 Now correctly detect size of FPGA's SPI flash for "show hardware"
    [CLI.cpp, LatentRedManagementBoard.cpp, LatentRedManagementBoard.h, ManagementController.sv, management.xdc, top.sv]
2019-09-02 Miscellaneous debugging and new printout logic in "show hardware"
2019-09-02 Initial version of Vivado project for switch fabric
2019-09-03 Refactoring of MACAddressTable, added management ports (not yet used for anything). Fixed some bugs in learning logic causing pend_wr_en to be set for too long.
    [MACAddressTable.sv, MACAddressTable_sim.sv]
2019-09-03 Fixed bug causing pending cache lines to be written to the wrong ways if several occurred back to back
    [MACAddressTable.sv, MACAddressTable_sim.sv]
2019-09-03 Initial skeletons of SwitchFabric and GigabitRxFifo. Still needs lots of work.
2019-09-04 Added area budgeting spreadsheet. Began work on RX fifo pop logic.
    [area-budgeting.ods]
2019-09-05 Continued work on RX FIFO
    [area-budgeting.ods]
2019-09-05 RxFifo: moved output signals into a struct
    [area-budgeting.ods]
2019-09-05 Initial implementation of switch fabric MAC address table arbitration
    [area-budgeting.ods]
2019-09-05 Continued initial implementation of SwitchFabric
2019-09-06 Initial work on top level module for switch
2019-09-07 Continued initial implementation of SwitchFabric. Lots of bug fixes and tweaks all round.
    [ClockGeneration.sv, MACAddressTable.sv, RxFifo.sv, SwitchFabric.sv, top.sv, top_sim.sv]
2019-09-07 Fixed bug where RxFifo sent an extra dummy word after end of frame
    [RxFifo.sv]
2019-09-07 Continued work on SwitchFabric forwarding
2019-09-07 Continued initial work on SwitchFabric. Successfully forwarded one frame during testing.
2019-09-07 Initial work on TX FIFO interface for SwitchFabric
2019-09-07 Fixed unintended latch
    [area-budgeting.ods]
2019-09-07 Updated area budgeting spreadsheet for initial fabric synthesis results
    [area-budgeting.ods]
2019-09-09 Began work on GigabitRxFifo
    [area-budgeting.ods]
2019-09-09 Ethertype is now propagated through switch fabric
2019-09-10 Line card: updates to text descriptions at top level
    [latentred-linecard.sch, phys.sch, psu.sch]
2019-09-10 Initial skeleton of switch engine schematic
    [fpga-support.sch, psu.sch, ram.sch, sfps.sch, sgmii.sch, switchengine.kicad_pcb, switchengine.sch]
2019-09-10 Initial switch engine power budgeting
    [power-budgeting.ods]
2019-09-16 Continued initial work on switch engine schematic and power budgeting
    [fpga-support.sch, power-budgeting.ods, psu.sch, ram.sch, sfps.sch, sgmii.sch, switchengine.sch]
2019-09-18 vcu118-test: continued hooking up layer 2 frame parsing
2019-09-18 Continued work on VCU118 testing. Added pipeline stage to SwitchFabric to improve timing.
2019-09-29 Fixed a bunch of bugs in RxFifo
    [RxFifo.sv]
2019-09-29 SwitchFabric now properly forwards ethertypes
2019-10-11 Continued debugging of switch fabric. Fixed some problems truncating or corrupting tail ends of packets
    [OutputFifo.sv, RxFifo.sv, top.sv, top.xdc]
2019-10-11 OutputFifo: don't send extra word at end of frame
2022-12-18 Initial version of single DP83867 test board
    [single-phy.kicad_pcb, single-phy.kicad_sch]
2022-12-19 Initial skeleton of single-phy-sma-host board. Ready for layout.
    [single-phy-sma-host.kicad_pcb, single-phy-sma-host.kicad_sch]
2022-12-19 Updated single-phy-sma-host with stitching vias and final layout
    [single-phy-sma-host.kicad_pcb]
2022-12-19 Updated single-phy design with mask cutout and silkscreen fixes
    [single-phy-sma-host.kicad_pcb]
2022-12-19 Initial version of single-phy-sma-device
    [single-phy-sma-device.kicad_pcb, single-phy-sma-device.kicad_sch]
2023-01-29 single-phy: updated for v0.2 with fixed RJ45 pinout, removed SGMII clock pair, moved digital IO to 1.8V
    [single-phy.kicad_pcb, single-phy.kicad_sch]
2023-01-29 Fixed incorrect LED level shifter connections
    [single-phy.kicad_pcb, single-phy.kicad_sch]
2023-04-16 Adding old LATENTRED design stuff that never got pushed
    [single-phy.kicad_sch]
2023-04-16 Initial work on LATENTPINK
    [fpga.kicad_sch, latentpink.kicad_pcb, latentpink.kicad_sch, mgmt.kicad_sch, phy.kicad_sch, power.ods, psu.kicad_sch]
2023-04-17 Updated design doc with work from today
    [power.ods]
2023-04-23 Continued initial schematic capture and floorplanning
    [fpga.kicad_sch, fpgapwr.kicad_sch, latentpink.kicad_pcb, latentpink.kicad_sch, mgmt.kicad_sch, phy.kicad_sch, psu.kicad_sch, qdr.kicad_sch]
2023-05-09 Continued initial schematic capture
    [fpga.kicad_sch, latentpink.kicad_pcb, latentpink.kicad_sch, mgmt.kicad_sch, phy.kicad_sch, psu.kicad_sch, qdr.kicad_sch, qsgmii-power.kicad_sch]
2023-05-10 Continued work on schematic, mostly power supply and QDR
    [fpga.kicad_sch, latentpink.kicad_pcb, latentpink.kicad_sch, psu.kicad_sch, qdr.kicad_sch]
2023-05-11 Initial version of RGMII PHY schematic
    [fpga.kicad_sch, latentpink.kicad_pcb, latentpink.kicad_sch, mgmt.kicad_sch, phy.kicad_sch, psu.kicad_sch, qdr.kicad_sch, qsgmii-power.kicad_sch]
2023-05-15 Continued work on QSGMII subsystem
    [fpga.kicad_sch, latentpink.kicad_pcb, latentpink.kicad_sch, mgmt.kicad_sch, phy.kicad_sch, psu.kicad_sch, qdr.kicad_sch, qsgmii-power.kicad_sch]
2023-05-16 Switched to new RJ45 for LATENTPINK, continued general PHY schematic
    [fpga.kicad_sch, latentpink.kicad_pcb, latentpink.kicad_sch, mgmt.kicad_sch, phy.kicad_sch, psu.kicad_sch, qdr.kicad_sch, qsgmii-power.kicad_sch]
2023-05-16 Initial start of DP83867 schematic
    [fpga.kicad_sch, latentpink.kicad_pcb, latentpink.kicad_sch, mgmt.kicad_sch, phy.kicad_sch, psu.kicad_sch, qdr.kicad_sch, qsgmii-power.kicad_sch]
2023-05-17 Rearranged ports, added center tap capacitors
    [latentpink.kicad_pcb, latentpink.kicad_sch, mgmt.kicad_sch, phy.kicad_sch, sgmii.kicad_sch]
2023-05-18 Continued initial component placement
    [latentpink.kicad_pcb, latentpink.kicad_sch, mgmt.kicad_sch, rgmii.kicad_sch, sgmii.kicad_sch]
2023-05-20 Continued footprint assignment and miscellaneous missing tidbits of schematic
    [fpga.kicad_sch, latentpink.kicad_pcb, latentpink.kicad_sch, mgmt.kicad_sch, phy.kicad_sch, psu.kicad_sch, qdr.kicad_sch, qsgmii-power.kicad_sch]
2023-05-21 Finished initial schematic, ready for design review
    [fpga.kicad_sch, latentpink.kicad_pcb, latentpink.kicad_sch, mgmt.kicad_sch, phy.kicad_sch, psu.kicad_sch, qdr.kicad_sch, qsgmii-power.kicad_sch]
2023-05-21 Added some debug LEDs, PMOD, and temp sensors
    [latentpink.kicad_pcb, latentpink.kicad_sch, mgmt.kicad_sch, phy.kicad_sch, psu.kicad_sch, qdr.kicad_sch]
2023-05-21 Continued work on signoff review, added some more test points and SFP+ activity LEDs
    [fpga.kicad_sch, latentpink.kicad_pcb, latentpink.kicad_sch, mgmt.kicad_sch, phy.kicad_sch, psu.kicad_sch, qdr.kicad_sch, qsgmii-power.kicad_sch]
2023-05-22 Finished initial schematic review, added ESD diodes to Ethernet pairs
    [fpga.kicad_sch, latentpink.kicad_pcb, latentpink.kicad_sch, mgmt.kicad_sch, phy.kicad_sch, psu.kicad_sch, rgmii.kicad_sch]
2023-05-23 Preliminary routing of first four baseT interfaces on VSC8512
    [latentpink.kicad_pcb, latentpink.kicad_sch, mgmt.kicad_sch, phy.kicad_sch, qdr.kicad_sch]
2023-05-24 Continued layout of VSC8512
    [fpga.kicad_sch, latentpink.kicad_pcb, latentpink.kicad_sch, mgmt.kicad_sch, phy.kicad_sch, psu.kicad_sch, qdr.kicad_sch, qsgmii-power.kicad_sch]
2023-05-27 Continued initial layout. Working on PHY decoupling caps and fanout
    [latentpink.kicad_pcb, phy.kicad_sch, qsgmii-power.kicad_sch]
2023-05-28 Lots of layout progress on bottom power/management/supervisor area
    [fpga.kicad_sch, latentpink.kicad_pcb, latentpink.kicad_sch, mgmt.kicad_sch, phy.kicad_sch, psu.kicad_sch, qdr.kicad_sch, qsgmii-power.kicad_sch]
2023-05-28 Progress on management / power region at south
    [latentpink.kicad_pcb, mgmt.kicad_sch, phy.kicad_sch]
2023-05-28 Continued work on management MCU area
    [latentpink.kicad_pcb, mgmt.kicad_sch, phy.kicad_sch]
2023-05-28 Rearranged all unplaced components and grouped by functional subsystem
    [fpga.kicad_sch, latentpink.kicad_pcb, latentpink.kicad_sch, qdr.kicad_sch, sgmii.kicad_sch]
2023-05-29 Routed upper SGMII PHY except for bus to FPGA
    [fpga.kicad_sch, latentpink.kicad_pcb, latentpink.kicad_sch, mgmt.kicad_sch, phy.kicad_sch, psu.kicad_sch, qdr.kicad_sch, qsgmii-power.kicad_sch]
2023-05-29 Hooked up some more PHY stuff plus management UART transceiver
    [latentpink.kicad_pcb, mgmt.kicad_sch, sgmii.kicad_sch]
2023-05-29 Began QDR layout
    [latentpink.kicad_pcb, latentpink.kicad_sch, phy.kicad_sch, qdr.kicad_sch]
2023-05-30 Moved QDR to wide orientation, preliminary layout (no length matching) of C/A bus
    [latentpink.kicad_pcb, qdr.kicad_sch]
2023-05-30 Lots of cleanup of C/A bus
    [latentpink.kicad_pcb, qdr.kicad_sch]
2023-05-30 VSC8512 LED layout
    [latentpink.kicad_pcb, mgmt.kicad_sch, phy.kicad_sch]
2023-06-01 Hooked up more low speed stuff, fan PWM, LEDs, power, etc. mostly in northeast corner
    [fpga.kicad_sch, latentpink.kicad_pcb, latentpink.kicad_sch, mgmt.kicad_sch, phy.kicad_sch, psu.kicad_sch, qdr.kicad_sch, qsgmii-power.kicad_sch]
2023-06-02 Lots more layout of low speed stuff and power. Partial layout of 1.2V supply. Initial RGMII escape routing.
    [fpga.kicad_sch, latentpink.kicad_pcb, latentpink.kicad_sch, mgmt.kicad_sch, phy.kicad_sch, psu.kicad_sch, qdr.kicad_sch, qsgmii-power.kicad_sch]
2023-06-03 Routing of northwest corner
    [latentpink.kicad_pcb, mgmt.kicad_sch, rgmii.kicad_sch, sgmii.kicad_sch]
2023-06-03 Partial routing of QDR D/Q bus, but it's a huge nightmare that might not be doable using MIG pinout
    [latentpink.kicad_pcb, latentpink.kicad_sch, qdr.kicad_sch]
2023-06-03 Good progress routing QDR with new pinout
    [latentpink.kicad_pcb, latentpink.kicad_sch, mgmt.kicad_sch, phy.kicad_sch, qdr.kicad_sch]
2023-06-04 Continued routing of power and top parts
    [latentpink.kicad_pcb, mgmt.kicad_sch, sgmii.kicad_sch]
2023-06-04 Continued initial QDR routing
    [fpga.kicad_sch, latentpink.kicad_pcb, latentpink.kicad_sch, mgmt.kicad_sch, phy.kicad_sch, psu.kicad_sch, qdr.kicad_sch, qsgmii-power.kicad_sch]
2023-06-04 Finished initial QDR routing, not length matched. 74 unrouted.
    [latentpink.kicad_pcb, mgmt.kicad_sch, psu.kicad_sch, qdr.kicad_sch]
2023-06-04 Initial routing of Vtt/Vref supply
    [latentpink.kicad_pcb, qdr.kicad_sch]
2023-06-05 Continued routing of last few control/power signals. 23 unrouted, some 1.8V decoupling and one thermal sensor
    [latentpink.kicad_pcb]
2023-06-05 Fully routed but not yet optimized
    [latentpink.kicad_sch, qdr.kicad_sch]
2023-06-06 Initial QDR length matching
    [fpga.kicad_sch, latentpink.kicad_sch, mgmt.kicad_sch, phy.kicad_sch, psu.kicad_sch, qdr-matching.ods, qdr.kicad_sch, qsgmii-power.kicad_sch]
2023-06-06 Initial layout of layer 4 power plane, added chassis ground ring around perimeter
    [qdr-matching.ods]
2023-06-07 Fixed DRC violations in QDR, added stitching vias, various cleanup
    [qdr-matching.ods]
2023-06-14 Continued fine tuning layout
    [fpga.kicad_sch, latentpink.kicad_sch, mgmt.kicad_sch, phy.kicad_sch, psu.kicad_sch, qdr.kicad_sch, qsgmii-power.kicad_sch, rgmii.kicad_sch]
2023-06-15 Continued initial RTL and constraint skeleton for PCB validation
2023-06-19 Updated PCB layout with changes made during initial FPGA RTL dev
    [fpga.kicad_sch, latentpink.kicad_sch, mgmt.kicad_sch, phy.kicad_sch, psu.kicad_sch, qdr-matching.ods, qdr.kicad_sch, qsgmii-power.kicad_sch]
2023-06-25 Updated PCB during layout review with a bunch of fixes to MDI trace widths
    [fpga.kicad_sch, latentpink.kicad_sch, mgmt.kicad_sch, phy.kicad_sch, psu.kicad_sch, qdr.kicad_sch, qsgmii-power.kicad_sch, rgmii.kicad_sch]
2023-06-25 Hopefully final LATENTPINK PCB layout for quote
2023-06-26 Updated ignore properties for PCB
2023-06-29 Lots more simulation updates, continued work on ingress FIFO. Fixed missing dummy VIO on SFP+ interface. Refactored all MAC/PCS blocks to new NetworkInterfaces module
    [IngressCDC.sv, IngressCDCSim.sv, IngressFifo.sv, IngressFifoSim.sv, LatentPinkTopLevel.sv, NetworkInterfaces.sv, VlanUntagger.sv, latentpink.xdc]
2023-06-30 Updated v0.1b design to have NPTH for heatsink attachment
2023-07-10 Initial glue to bolt on TCP stack. Port 22 is open, but no actual SSH server yet.
2023-07-11 Added x25519 accelerator to FPGA design as a placeholder. Not actually wired up to management logic yet.
2023-07-11 Added pipeline stage to MACAddressTable garbage collection
2023-07-12 Added cryptb operation, fixed bug causing extra single byte read after a write
    [SimulationManagementBridge.sv]
2023-07-13 Switched 250 MHz clock to a BUFH, more floorplan tweaks
2023-07-16 Initial skeleton supervisor firmware. Just an LED blinky and initializing timer and UART
2023-07-16 Continued work on supervisor firmware doing board bringup
2023-07-16 Finished initial supervisor firmware for rail bringup
2023-07-16 Updated schematic with notes on power rail sequencing bug found during bringup
    [fpga.kicad_sch, latentpink.kicad_sch, mgmt.kicad_sch, phy.kicad_sch, psu.kicad_sch, qdr.kicad_sch, qsgmii-power.kicad_sch, rgmii.kicad_sch]
2023-07-20 Continued work on sensor bringup
2023-07-21 Successful bringup of RGMII PHY to the point it can respond to MDIO traffic and receive frames on the FPGA. No path to MCU yet.
2023-07-23 Incoming Ethernet frames on management interface are now passed to stack; outbound send path not implemented yet
2023-07-24 Initial tests of FPGA crypto engine vs STM32. Disable "zeroize buffers before use" as a test
2023-07-24 Removed calls to fallback crypto API; DeviceCryptoEngine now uses FPGA accelerator exclusively
2023-08-03 Lots of debugging and work on fabric. Appears to be correctly handling frames up to the output of the ForwardingEngine
    [ForwardingEngine.sv, IngressCDC.sv, IngressFifo.sv, LatentPinkTopLevel.sv, PacketBufferingSim.sv, latentpink.xdc]
2023-08-06 First light on switch passing packets
2023-08-07 Passing traffic and timing after inserting a bunch of LA probes. Now to figure out why it falls over when ping flooded.
2023-08-08 Continued switch debug, fixed off-by-one in >PREFETCH_DEPTH sized packets
    [IngressFifo.sv, latentpink.xdc]
2023-08-10 Fixed bug where VlanUntagger fails to forward "drop" flag
    [VlanUntagger.sv]
2023-08-11 Rewrite of read side of ingress FIFO to improve performance and eliminate some tricky-to-fix bugs
    [IngressFifo.sv, latentpink.xdc]
2023-08-12 Fixed race condition causing packet corruption or port hangs after ~1M packets in a short time frame
    [EgressFifo.sv, IngressFifo.sv]
2023-08-12 Removed LA instances from debugging previous bug
    [EgressFifo.sv, IngressFifo.sv, LatentPinkTopLevel.sv, PacketBuffering.sv]
2023-08-13 Initial work on performance counter resets
    [LatentPinkTopLevel.sv, ManagementRegisterInterface.sv, ManagementSubsystem.sv, NetworkInterfaces.sv, latentpink.xdc]
2023-08-14 Performance counters are cleared during startup to prevent lots of garbage from showing up
    [CommonInit.cpp]
2023-09-26 Fixed bug where QSPI register interface would corrupt bits 3/4 of MDIO register address
    [ManagementRegisterInterface.sv]
2023-09-26 Don't log ID of every VSC8512 channel to reduce boot spam, only log first ID and anything that comes back wrong
    [DeviceInit.cpp]
2023-09-28 Fixes to timing constraints, update to latest ipcores
    [LatentPinkTopLevel.sv, PacketBuffering.sv, QDRMemoryBIST.sv, QDRSim.sv, latentpink.xdc]
2023-10-04 Ingress CDC now holds RX logic in reset if link is down, and for 64K clocks after link comes up, to prevent garbage appearing during link startup
    [IngressCDC.sv]
2023-10-04 Fixed CDC issue in management link up flag
    [ManagementSubsystem.sv]
